mafiucivil/Tornamesa/cad/out/informe_paquete.md

# Informe del paquete de planos TT300-C · Rev. B

Generado el 06-11-2026 desde `TT300-C_design.json` (fuente única) en 106 s.
Interfaz dibujada: **Acero-acero con grasa grafitada (sin interfaz alternativa)**
Cubierta de madera: no. Collar del pivote: sí. Estado: EMITIDO PARA REVISIÓN.

**ESTOS PLANOS NO SON VÁLIDOS PARA FABRICACIÓN HASTA SU REVISIÓN Y APROBACIÓN POR UN INGENIERO CALCULISTA HABILITADO.**

## Láminas (21)

| N° | Plano | Título | Escala |
|---|---|---|---|
| 1 | TT300C-GEN-001-B | NOTAS GENERALES, NORMAS Y ÍNDICE DE LÁMINAS | S/E |
| 2 | TT300C-GEN-002-B | CONJUNTO GENERAL: PLANTA, CORTES Y VISTAS | 1:10 / 1:5 |
| 3 | TT300C-GEN-003-B | ISOMÉTRICA EXPLOSIONADA CON GLOBOS | 1:20 |
| 4 | TT300C-GEN-004-B | SECUENCIA DE ENSAMBLAJE | S/E |
| 5 | TT300C-GEN-005-B | DESPIECE (LISTA DE MATERIALES), MASA Y CENTRO DE GRAVEDAD | S/E |
| 6 | TT300C-GEN-006-B | LISTA DE CORTE | S/E |
| 7 | TT300C-GEN-007-B | PROGRAMA DE SOLDADURAS (ISO 2553 / ISO 5817 / AWS D1.1) | S/E |
| 8 | TT300C-GEN-008-B | TOLERANCIAS, AJUSTES, MATERIALES E INSPECCIÓN | S/E |
| 9 | TT300C-GEN-009-B | SUPUESTOS DEL DIBUJANTE Y BRECHAS CON EL CÁLCULO | S/E |
| 10 | TT300C-BAS-001-B | BASE SOLDADA: PLANCHA, COLLAR, MARCO, MÉNSULAS Y BANCADAS | 1:10 / 1:5 / 1:2 |
| 11 | TT300C-BAS-005-B | MÉNSULA DE CILINDRO (CONJUNTO SOLDADO) | 1:1,25 |
| 12 | TT300C-IZA-001-B | OREJA DE IZAJE (4 UNIDADES) | 1:1 / 1:10 |
| 13 | TT300C-ACC-001-B | BANCADA DE GUÍA CON RANURA T | 1:5 / 1:1 |
| 14 | TT300C-ACC-002-B | PATÍN GUIADO CON LENGÜETA T Y MARCO DE BOCA | 1:4 / 1:2,5 |
| 15 | TT300C-ACC-003-B | UÑA DE EMPUJE (CARA PLANA TEMPLADA, CHAFLÁN DE RETORNO) | 1:2,5 |
| 16 | TT300C-ACC-004-B | PASADORES DE ARTICULACIÓN, CILINDRO HIDRÁULICO Y ESPECIFICACIÓN | 1:2 / 1:5 |
| 17 | TT300C-MES-001-B | MESA GIRATORIA: CONJUNTO SOLDADO (PLANTA Y CORTE RADIAL) | 1:10 / 1:4 / 1:2 |
| 18 | TT300C-MES-002-B | PLANCHAS Y ANILLOS DE LA MESA (SUPERIOR E INFERIOR) | 1:10 / 1:2 |
| 19 | TT300C-MES-003-B | CUBO, ALMAS ANULARES Y NERVIOS RADIALES | 1:2 / 1:5 |
| 20 | TT300C-MES-004-B | PASADOR DE EMPUJE Y PERNO DE RETENCIÓN | 1:1 |
| 21 | TT300C-PIV-001-B | PIVOTE, BUJE, TAPA RETENEDORA Y TAPA DE INSPECCIÓN | 1:1,4 |

## Ítems (31)

| Pos | Código | Ítem | Cant | Masa unit. kg | Masa total kg | En núcleo |
|---|---|---|---|---|---|---|
| 1 | TT300C-BAS-001-B | Plancha base | 1 | 924.43 | 924.4 | sí |
| 2 | TT300C-BAS-002-B | Collar de asiento del pivote | 1 | 17.79 | 17.8 | sí |
| 3 | TT300C-BAS-003-B | Marco perimetral largo | 2 | 9.04 | 18.1 | sí |
| 4 | TT300C-BAS-004-B | Marco perimetral corto | 2 | 8.97 | 17.9 | sí |
| 5 | TT300C-BAS-005-B | Mejilla de ménsula | 8 | 10.01 | 80.1 | sí |
| 6 | TT300C-BAS-006-B | Oreja superior de ménsula | 4 | 4.40 | 17.6 | sí |
| 7 | TT300C-BAS-007-B | Oreja inferior (bloque) de ménsula | 4 | 13.72 | 54.9 | sí |
| 8 | TT300C-IZA-001-B | Oreja de izaje | 4 | 3.99 | 16.0 | sí |
| 9 | TT300C-ACC-001-B | Bancada de guía con ranura T | 2 | 40.48 | 81.0 | sí |
| 10 | TT300C-MES-001-B | Plancha superior de la mesa | 1 | 358.99 | 359.0 | sí |
| 11 | TT300C-MES-002-B | Anillo superior de pasadores | 1 | 139.71 | 139.7 | sí |
| 12 | TT300C-MES-003-B | Plancha inferior de la mesa | 1 | 285.37 | 285.4 | sí |
| 13 | TT300C-MES-004-B | Anillo inferior de pasadores | 1 | 139.71 | 139.7 | sí |
| 14 | TT300C-MES-005-B | Alma anular R300 | 1 | 15.45 | 15.4 | sí |
| 15 | TT300C-MES-006-B | Alma anular R590 | 1 | 30.38 | 30.4 | sí |
| 16 | TT300C-MES-007-B | Alma anular R840 | 1 | 43.25 | 43.3 | sí |
| 17 | TT300C-MES-008-B | Nervio radial, tramo 1 | 14 | 1.16 | 16.3 | sí |
| 18 | TT300C-MES-009-B | Nervio radial, tramo 2 | 14 | 2.33 | 32.6 | sí |
| 19 | TT300C-MES-010-B | Nervio radial, tramo 3 | 14 | 2.00 | 28.0 | sí |
| 20 | TT300C-MES-011-B | Cubo de la mesa | 1 | 66.75 | 66.8 | sí |
| 21 | TT300C-MES-012-B | Pasador de empuje | 28 | 9.35 | 261.9 | sí |
| 22 | TT300C-MES-013-B | Perno ISO 4762 M20×45 con arandela | 28 | 0.93 | 25.9 | no |
| 23 | TT300C-PIV-001-B | Pivote | 1 | 18.73 | 18.7 | sí |
| 24 | TT300C-PIV-002-B | Buje autolubricado | 1 | 3.87 | 3.9 | no |
| 25 | TT300C-PIV-003-B | Tapa retenedora | 1 | 1.60 | 1.6 | no |
| 26 | TT300C-PIV-004-B | Tapa de inspección | 1 | 2.79 | 2.8 | no |
| 27 | TT300C-ACC-002-B | Cilindro hidráulico doble efecto | 2 | 55.00 | 110.0 | sí |
| 28 | TT300C-ACC-003-B | Patín guiado | 2 | 126.85 | 253.7 | sí |
| 29 | TT300C-ACC-004-B | Uña de empuje | 2 | 13.61 | 27.2 | sí |
| 30 | TT300C-ACC-005-B | Pasador del vástago (patín) | 2 | 4.11 | 8.2 | no |
| 31 | TT300C-ACC-006-B | Pasador del ojal trasero (ménsula) | 2 | 5.20 | 10.4 | no |

## Masas: modelo 3D frente al núcleo

| Grupo | 3D kg | Núcleo kg | Δ kg | Δ % |
|---|---|---|---|---|
| Plancha base + collar + orejas de izaje | 958.2 | 958.2 | +0.0 | +0.00 |
| Marco perimetral | 36.0 | 36.0 | +0.0 | +0.00 |
| Ménsulas de cilindro | 152.6 | 152.6 | +0.0 | +0.00 |
| Bancadas de guía | 81.0 | 81.0 | +0.0 | +0.00 |
| Mesa (planchas, almas, nervios, cubo, pasadores) | 1418.4 | 1419.6 | -1.2 | -0.09 |
| Pivote | 18.7 | 18.7 | +0.0 | +0.00 |
| Cilindros (masa de catálogo) | 110.0 | 110.0 | +0.0 | +0.00 |
| Patines | 253.7 | 254.5 | -0.8 | -0.31 |
| Uñas | 27.2 | 27.2 | +0.0 | +0.00 |

**Total comparable:** 3D 3055.8 kg frente a 3057.8 kg del núcleo: Δ -2.0 kg (-0.07 %), tolerancia ±0.5 % → DENTRO.
Piezas no incluidas en el núcleo (pernos, buje, tapas, tornillos, graseras, anillo de la madera, pasadores de articulación; las barras de los topes SÍ están en m.total/m.stopBars): 52.8 kg. **Masa total del ensamble: 3108.6 kg.**
**Centro de gravedad (x, y, z):** (0.0; -0.0; 86.5) mm (origen en el eje de la mesa y la cara inferior de la base).

## Interferencias

0 pares con volumen común > 1 mm³ de 319 pares evaluados con cajas envolventes solapadas (total de pares 465).

## Chequeo automático de cotas (dibujo frente a modelo 3D)

104 cotas registradas; 104 verificadas (extremos sobre la superficie del sólido o ejes de superficies cilíndricas reales, tolerancia 0,05 mm); **0 fallas**. Detalle en `chequeo_cotas.csv`.

## Control de marco

Todas las láminas dentro del formato A1.

## Supuestos del dibujante (PROVISORIO) y decisiones adoptadas por el mandante (ADOPTADO)

| Id | Tema | Valor | Motivo |
|---|---|---|---|
| S13 | Izaje de la mesa | No se dibujan puntos de izaje de la mesa (A DEFINIR) | El cálculo solo define las 4 orejas de la base (P.t_ear…); la mesa debe izarse con medios definidos por el montajista. |
| S14 | Retención axial del pivote | Ajuste H7/p6 sin soldadura ni tope inferior (A DEFINIR) | El cálculo verifica asiento y flexión pero no la extracción axial del pivote. |

## Brechas con el cálculo y decisiones requeridas

| Id | Tema | Descripción | Decisión requerida |
|---|---|---|---|
| B-01 | Izaje de la mesa | El cálculo solo define las 4 orejas de la base; no hay puntos de izaje de la mesa (los cáncamos M30 de la Rev. B anterior sobre plancha de 20 mm no engranan la profundidad exigible). | A DEFINIR: orejas o cáncamos verificados para la mesa. |
| B-02 | Retención axial del pivote | El núcleo verifica asiento y flexión, no la extracción axial del pivote (ajuste p6/H7 sin soldadura, 42CrMo4 no soldable). | A DEFINIR: tope inferior, anillo o interferencia verificada. |
| B-03 | Torque de pernos y tornillos | El núcleo no entrega torques (pernos M20×45 de pasadores, M10 de tapas, tornillos de posición). | A DEFINIR: torques de apriete (ISO 898-1 / VDI 2230). |
| B-04 | Tamaño de soldaduras sin parámetro | Marco, esquinas y orejas de ménsula no tienen tamaño en P; se adopta el mínimo AWS D1.1 T5.8 por la parte más gruesa. Sí son parámetro (y el núcleo verifica mínimo y máximo): w_collar, w_ear, w_tope, w_br, w_web, w_bed_f. | A DEFINIR: confirmar o parametrizar tamaños y END de las soldaduras sin parámetro. |
| B-05 | Verificación del núcleo del filete de las mejillas | La fila «Filete mínimo mejillas–base» acota con mín(w_br, t_base, t_ch) = 18: no detecta que w_br = 20 supera t_base = 18 (el máximo AISC J2.2b sobre el borde de la mejilla de 25 sería 23). | Revisar el criterio de la fila (mínimo y máximo por separado). |
| B-06 | Diferencias de fórmula del patín | La masa del patín del núcleo difiere del modelo (alojamiento abierto por la cara superior y cuello de la lengüeta): −0,3 % en la pieza. | Informativo (dentro de tolerancia). |
| B-07 | Cilindro comercial | Largo ojal–ojal L0 = 520 mm y masa 55 kg son supuestos del núcleo; el modelo 3D usa la geometría de extremos del núcleo. | Confirmar con el proveedor del cilindro. |

## Reproducción

```
python3 cad/generar_paquete.py [design.json] [--out DIR] [--entrega DIR]
```
Dependencias: cadquery, ezdxf, pymupdf, shapely, openpyxl (opcional; sin él se escribe un .xlsx mínimo), Node.js para `tools/export_design.js`.
