mafiucivil/Tornamesa/entregables/RevC/variantes/C2/informe_paquete.md

# Informe del paquete de planos TT300-C · Rev. C

Generado el 07-11-2026 desde `TT300-C_design.json` (fuente única) en 841 s.
Interfaz dibujada: **Opción C-2: dos placas de bronce de aleaciones distintas**
Cubierta de madera: no. Collar del pivote: sí. Estado: EMITIDO PARA REVISIÓN.

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

## Láminas (53)

| N° | Plano | Título | Escala |
|---|---|---|---|
| 1 | TT300C-GEN-001-C | NOTAS GENERALES, NORMAS APLICABLES E ÍNDICE DE PLANOS | S/E |
| 2 | TT300C-CON-001-C | CONJUNTO GENERAL DEL EQUIPO: PLANTA, ELEVACIÓN Y CORTES A-A Y B-B | 1:5 / 1:10 / 1:20 |
| 3 | TT300C-CON-002-C | DESPIECE COMPLETO DEL EQUIPO (HOJA 1) | S/E |
| 4 | TT300C-CON-003-C | CONJUNTO GENERAL: ELEVACIONES LATERAL Y POSTERIOR, VISTA INFERIOR Y DIMENSIONES GENERALES | 1:1 / 1:5 / 1:20 |
| 5 | TT300C-CON-004-C | ISOMÉTRICA EXPLOSIONADA DEL EQUIPO CON GLOBOS DE POSICIÓN | S/E |
| 6 | TT300C-CON-005-C | SECUENCIA DE MONTAJE Y FABRICACIÓN | S/E |
| 7 | TT300C-CON-006-C | BASE SOLDADA: CONJUNTO (PLANTA, ELEVACIONES, CORTES Y DETALLES DE JUNTA) | 1:2 / 1:2,5 / 1:10 / 1:20 |
| 8 | TT300C-CON-007-C | MÉNSULA DE CILINDRO: SUBCONJUNTO SOLDADO (PLANTA, ELEVACIÓN Y CORTES) | 2:1 / 1:5 / 1:10 |
| 9 | TT300C-CON-008-C | MESA SOLDADA: PLANTA A MEDIA ALTURA, PLANTA INFERIOR, ELEVACIÓN Y CORTE POR UN PASADOR | 1:10 |
| 10 | TT300C-CON-009-C | MESA SOLDADA: CORTE POR ALMAS, DETALLES DE JUNTA, REBAJE DEL COLLAR Y TABLA DE PASADORES | 2:1 / 1:1 / 1:10 |
| 11 | TT300C-CON-010-C | ACCIONAMIENTO: CILINDRO, MÉNSULA, PATÍN, BANCADA, UÑA Y PASADORES (VISTA Y CORTES) | 1:2 / 1:5 |
| 12 | TT300C-CON-011-C | PIVOTE: CUBO, COLLAR, BUJE Y TAPAS — HOLGURAS Y AJUSTES (ISO 286) | 1:1 / 1:2 |
| 13 | TT300C-CON-012-C | CONJUNTO DE LA INTERFAZ: OPCIÓN C-2: DOS PLACAS DE BRONCE DE ALEACIONES DISTINTAS | 1:2 / 1:10 |
| 14 | TT300C-CON-013-C | DESPIECE COMPLETO DEL EQUIPO (HOJA 2) | S/E |
| 15 | TT300C-BAS-001-C | PLANCHA BASE: CONTORNO, AGUJERO CENTRAL Y POSICIONES | 2:1 / 1:2 / 1:20 |
| 16 | TT300C-BAS-002-C | COLLAR DE ASIENTO DEL PIVOTE | 2:1 / 1:1 / 1:2,5 |
| 17 | TT300C-BAS-003-C | MARCO PERIMETRAL: PLETINAS LARGA Y CORTA | 2:1 / 1:2,5 / 1:5 |
| 18 | TT300C-BAS-005-C | MÉNSULA DE CILINDRO: MEJILLA Y OREJAS (PIEZAS) | 1:2 / 1:2,5 / 1:5 |
| 19 | TT300C-IZA-001-C | OREJA DE IZAJE (4 UNIDADES) | 2:1 / 1:1 |
| 20 | TT300C-ACC-001-C | BANCADA DE GUÍA CON RANURA T (2 UNIDADES) | 2:1 / 1:2 / 1:10 |
| 21 | TT300C-MES-001-C | MESA: PLANCHA SUPERIOR | 2:1 / 1:1 / 1:5 / 1:10 |
| 22 | TT300C-MES-002-C | MESA: ANILLOS SUPERIOR E INFERIOR DE PASADORES (28 AGUJEROS) | 1:1 / 1:2 / 1:10 |
| 23 | TT300C-MES-003-C | MESA: PLANCHA INFERIOR (CARA DE APOYO DE LA INTERFAZ) | 2:1 / 1:2 / 1:10 |
| 24 | TT300C-MES-005-C | MESA: ALMAS ANULARES (3 ANILLOS) | 2:1 / 1:2 / 1:10 |
| 25 | TT300C-MES-008-C | MESA: NERVIOS RADIALES (TRAMOS ENTRE ALMAS) | 2:1 / 1:1 / 1:2 |
| 26 | TT300C-MES-011-C | MESA: CUBO | 2:1 / 1:2 |
| 27 | TT300C-MES-012-C | MESA: PASADOR DE EMPUJE Ø85 (28 UNIDADES) | 5:1 / 2:1 / 1:1 |
| 28 | TT300C-MES-013-C | MESA: PERNO ISO 4762 M20×45 CON ARANDELA (28 UNIDADES) | 2:1 |
| 29 | TT300C-PIV-001-C | PIVOTE Ø120 p6 | 5:1 / 2:1 / 1:1 |
| 30 | TT300C-PIV-002-C | PIVOTE: BUJE AUTOLUBRICADO | 5:1 / 2:1 / 1:1 |
| 31 | TT300C-PIV-003-C | PIVOTE: TAPAS RETENEDORA (PIV-003) E INSPECCIÓN (PIV-004) | 2:1 / 1:1 / 1:2 |
| 32 | TT300C-ACC-002-C | CILINDRO HIDRÁULICO DE DOBLE EFECTO (ELEMENTO COMERCIAL — DIMENSIONES DE INTERFAZ) | 1:1 / 1:2 / 1:2,5 |
| 33 | TT300C-ACC-003-C | PATÍN GUIADO CON LENGÜETA T Y MARCO DE BOCA (2 UNIDADES) | 1:1 / 1:2 / 1:2,5 |
| 34 | TT300C-ACC-004-C | UÑA DE EMPUJE (CARA PLANA TEMPLADA, CHAFLÁN DE RETORNO) (2 UNIDADES) | 2:1 / 1:1 / 1:2 |
| 35 | TT300C-ACC-005-C | PASADORES DE ARTICULACIÓN Ø70 f8 (VÁSTAGO Y OJAL TRASERO) | 5:1 / 2:1 / 1:1 |
| 36 | TT300C-INT-003-C | INTERFAZ: DISCO DURO / 2.ª PLACA (SECTOR) | 5:1 / 1:1 / 1:2 / 1:5 |
| 37 | TT300C-INT-001-C | INTERFAZ: PLACA DE BRONCE CON TAPONES DE GRAFITO (SECTOR / PASTILLA) | 2:1 / 1:1 / 1:5 |
| 38 | TT300C-INT-004-C | INTERFAZ: BARRA DE TOPE DE LA BASE Y DETALLE DE JUNTA | 2:1 / 1:1 |
| 39 | TT300C-INT-005-C | INTERFAZ: BARRA DE TOPE DE LA MESA Y DETALLE DE JUNTA | 2:1 / 1:1 / 1:2 |
| 40 | TT300C-INT-006-C | INTERFAZ: TORNILLOS DE POSICIÓN ISO 10642 M6 (ROSCA ISO 262, PAR PROPUESTO) | 5:1 |
| 41 | TT300C-INT-008-C | INTERFAZ: GRASERAS DIN 71412 M10×1, TALADRO Ø6 Y TRAZADO DE ENGRASE | 5:1 / 2:1 / 1:10 |
| 42 | TT300C-INT-101-C | INTERFAZ: RANURAS DE ENGRASE EN LA CARA DESLIZANTE (TRAZADO: 12 RADIALES Y CIRCUNFERENCIALES, GRASERAS) | 1:1 / 1:2 / 1:10 |
| 43 | TT300C-INT-102-C | INTERFAZ: PATRÓN DE TAPONES DE GRAFITO (PLANTA DEL BRONCE, TABLA DE COORDENADAS Y ALOJAMIENTO) | 5:1 / 1:5 / 1:50 |
| 44 | TT300C-GEN-003-C | PLAN DE INSPECCIÓN Y ENSAYOS | S/E |
| 45 | TT300C-GEN-004-C | TOLERANCIAS Y AJUSTES (ISO 286) Y TOLERANCIAS GEOMÉTRICAS | S/E |
| 46 | TT300C-GEN-005-C | MATERIALES Y CERTIFICADOS | S/E |
| 47 | TT300C-GEN-006-C | TRATAMIENTOS TÉRMICOS Y SUPERFICIALES, PINTURA | S/E |
| 48 | TT300C-GEN-007-C | PROGRAMA DE SOLDADURAS: TABLA GLOBAL DE JUNTAS | S/E |
| 49 | TT300C-GEN-008-C | TORQUES DE APRIETE (PROPUESTA) Y LISTA DE COMPRAS DE ELEMENTOS COMERCIALES | S/E |
| 50 | TT300C-GEN-009-C | SUPUESTOS DEL DIBUJANTE Y BRECHAS CON EL CÁLCULO (GEN-009) | S/E |
| 51 | TT300C-GEN-010-C | LISTA DE CORTES DE PLANCHA (NESTING SIMPLE) Y APROVECHAMIENTO | S/E |
| 52 | TT300C-GEN-011-C | LISTA DE VERIFICACIÓN DEL REVISOR | S/E |
| 53 | TT300C-GEN-012-C | WPS PRE-CALIFICADOS PROPUESTOS POR TIPO DE JUNTA (AWS D1.1 CL. 3) Y PRECALENTAMIENTO | S/E |

## Ítems (39)

| Pos | Código | Ítem | Cant | Masa unit. kg | Masa total kg | En núcleo |
|---|---|---|---|---|---|---|
| 1 | TT300C-BAS-001-C | Plancha base | 1 | 924.29 | 924.3 | sí |
| 2 | TT300C-BAS-002-C | Collar de asiento del pivote | 1 | 17.79 | 17.8 | sí |
| 3 | TT300C-BAS-003-C | Marco perimetral largo | 2 | 9.04 | 18.1 | sí |
| 4 | TT300C-BAS-004-C | Marco perimetral corto | 2 | 8.97 | 17.9 | sí |
| 5 | TT300C-BAS-005-C | Mejilla de ménsula | 8 | 11.93 | 95.4 | sí |
| 6 | TT300C-BAS-006-C | Oreja superior de ménsula | 4 | 4.40 | 17.6 | sí |
| 7 | TT300C-BAS-007-C | Oreja inferior (bloque) de ménsula | 4 | 18.99 | 76.0 | sí |
| 8 | TT300C-IZA-001-C | Oreja de izaje | 4 | 3.99 | 16.0 | sí |
| 9 | TT300C-ACC-001-C | Bancada de guía con ranura T | 2 | 40.48 | 81.0 | sí |
| 10 | TT300C-MES-001-C | Plancha superior de la mesa | 1 | 358.97 | 359.0 | sí |
| 11 | TT300C-MES-002-C | Anillo superior de pasadores | 1 | 139.71 | 139.7 | sí |
| 12 | TT300C-MES-003-C | Plancha inferior de la mesa | 1 | 285.30 | 285.3 | sí |
| 13 | TT300C-MES-004-C | Anillo inferior de pasadores | 1 | 139.60 | 139.6 | sí |
| 14 | TT300C-MES-005-C | Alma anular R300 | 1 | 15.45 | 15.4 | sí |
| 15 | TT300C-MES-006-C | Alma anular R590 | 1 | 30.38 | 30.4 | sí |
| 16 | TT300C-MES-007-C | Alma anular R840 | 1 | 43.25 | 43.3 | sí |
| 17 | TT300C-MES-008-C | Nervio radial, tramo 1 | 14 | 1.16 | 16.3 | sí |
| 18 | TT300C-MES-009-C | Nervio radial, tramo 2 | 14 | 2.33 | 32.6 | sí |
| 19 | TT300C-MES-010-C | Nervio radial, tramo 3 | 14 | 2.00 | 28.0 | sí |
| 20 | TT300C-MES-011-C | Cubo de la mesa | 1 | 74.71 | 74.7 | sí |
| 21 | TT300C-MES-012-C | Pasador de empuje | 28 | 9.35 | 261.7 | sí |
| 22 | TT300C-MES-013-C | Perno ISO 4762 M20×45 con arandela | 28 | 0.93 | 25.9 | no |
| 23 | TT300C-PIV-001-C | Pivote | 1 | 21.33 | 21.3 | sí |
| 24 | TT300C-PIV-002-C | Buje autolubricado | 1 | 3.87 | 3.9 | no |
| 25 | TT300C-PIV-003-C | Tapa retenedora | 1 | 1.57 | 1.6 | no |
| 26 | TT300C-PIV-004-C | Tapa de inspección | 1 | 2.76 | 2.8 | no |
| 27 | TT300C-ACC-002-C | Cilindro hidráulico doble efecto | 2 | 55.00 | 110.0 | sí |
| 28 | TT300C-ACC-003-C | Patín guiado | 2 | 159.88 | 319.8 | sí |
| 29 | TT300C-ACC-004-C | Uña de empuje | 2 | 13.61 | 27.2 | sí |
| 30 | TT300C-ACC-005-C | Pasador del vástago (patín) | 2 | 4.10 | 8.2 | no |
| 31 | TT300C-ACC-006-C | Pasador del ojal trasero (ménsula) | 2 | 6.10 | 12.2 | no |
| 32 | TT300C-INT-001-C | Sector de placa de bronce con tapones de grafito | 24 | 12.67 | 304.1 | sí |
| 33 | TT300C-INT-002-C | Tapón de grafito | 2640 | 0.00 | 5.6 | sí |
| 34 | TT300C-INT-003-C | 2.ª placa de bronce (sector) | 24 | 13.27 | 318.4 | sí |
| 35 | TT300C-INT-004-C | Barra de tope (placa de bronce) | 24 | 0.42 | 10.0 | sí |
| 36 | TT300C-INT-005-C | Barra de tope (disco duro / 2.ª placa) | 24 | 0.72 | 17.4 | sí |
| 37 | TT300C-INT-006-C | Tornillo avellanado de posición M6×25 | 48 | 0.01 | 0.3 | no |
| 38 | TT300C-INT-007-C | Tornillo avellanado de posición M6×25 | 48 | 0.01 | 0.3 | no |
| 39 | TT300C-INT-008-C | Grasera recta M10×1 | 4 | 0.01 | 0.0 | no |

## Masas: modelo 3D frente al núcleo

| Grupo | 3D kg | Núcleo kg | Δ kg | Δ % |
|---|---|---|---|---|
| Plancha base + collar + orejas de izaje | 958.1 | 958.2 | -0.1 | -0.01 |
| Marco perimetral | 36.0 | 36.0 | +0.0 | +0.00 |
| Ménsulas de cilindro | 189.0 | 189.0 | -0.0 | -0.00 |
| Bancadas de guía | 81.0 | 81.0 | +0.0 | +0.00 |
| Mesa (planchas, almas, nervios, cubo, pasadores) | 1425.9 | 1427.6 | -1.7 | -0.12 |
| Pivote | 21.3 | 21.4 | -0.1 | -0.29 |
| Cilindros (masa de catálogo) | 110.0 | 110.0 | +0.0 | +0.00 |
| Patines | 319.8 | 320.5 | -0.8 | -0.25 |
| Uñas | 27.2 | 27.2 | +0.0 | +0.00 |
| Bronce con grafito (o 2.ª placa) | 628.1 | 630.6 | -2.5 | -0.40 |
| Barras de los topes (m.stopBars) | 27.4 | 27.4 | -0.0 | -0.00 |

**Total comparable:** 3D 3823.8 kg frente a 3828.9 kg del núcleo: Δ -5.2 kg (-0.13 %), tolerancia ±0.5 % → DENTRO.
Piezas no incluidas en el núcleo (pernos, buje, tapas, tornillos, graseras, pasadores de articulación; las barras de los topes SÍ están en m.total/m.stopBars): 55.2 kg. **Masa total del ensamble: 3879.0 kg.**
**Centro de gravedad (x, y, z):** (0.0; -0.0; 92.3) mm (origen en el eje de la mesa y la cara inferior de la base).

### Control de masa de la interfaz por pieza (cortes del núcleo, `interfazGeom.cortes`)

| Pieza | Piezas (n × capas) | t mm | Junta mm | Juntas kg | Muescas kg | Chaflanes kg | Bruta kg | Neta del núcleo kg | 3D kg | Residual kg | Residual % |
|---|---|---|---|---|---|---|---|---|---|---|---|
| Placa de bronce (24 sectores) | 24 | 15 | 1 | 2.2 | 11.5 | 1.7 | 327.3 | 311.9 | 309.7 | -2.25 | -0.72 |
| 2.ª placa de bronce (24 sectores) | 24 | 15 | 1 | 2.3 | 20.9 | 3.1 | 345.0 | 318.7 | 318.4 | -0.26 | -0.08 |

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

### Diferencias explicadas por pieza
- Mesa (planchas, almas, nervios, cubo, pasadores): 3D 1425,9 kg frente a 1427,6 kg del núcleo (-0,12 %; residual -1,66 kg). Residual no descontado en el núcleo: rebaje del cubo, agujeros de pasadores y empalmes (fórmula del núcleo).
- Pivote: 3D 21,3 kg frente a 21,4 kg del núcleo (-0,29 %; residual -0,06 kg). Residual no descontado en el núcleo: fórmula del núcleo frente a geometría.
- Patines: 3D 319,8 kg frente a 320,5 kg del núcleo (-0,25 %; residual -0,79 kg). Residual no descontado en el núcleo: alojamiento abierto por la cara superior y cuello de la lengüeta del patín (fórmula del núcleo frente a la geometría).
- Bronce con grafito (o 2.ª placa): 3D 628,1 kg frente a 630,6 kg del núcleo (-0,4 %; residual -2,51 kg). Residual no descontado en el núcleo: tapones de grafito, ranuras de engrase, tornillos de posición y taladros de las graseras. Núcleo v1.2 (interfazGeom.tapones): N_real = 2.640 tapones (malla 3.864, N_ideal 3.961), f_g real = 0,097 (ideal 0,145, usado 0,097); el 3D coloca 2.640 (+0 respecto del núcleo). Cumple lubricación (f_g ≥ 0,2): NO (decisión del calculista)..

## Interferencias

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

## Chequeo automático de cotas (dibujo frente a modelo 3D)

595 cotas registradas; 595 verificadas (extremos sobre la superficie del sólido o ejes de superficies cilíndricas reales, tolerancia 0,05 mm); **0 fallas**. Detalle en `chequeo_cotas.csv`.

## Control de marco

Todas las láminas dentro del formato A1.

## Supuestos del dibujante (PROVISORIO) y decisiones adoptadas por el mandante (ADOPTADO)

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

## Brechas con el cálculo y decisiones requeridas

| Id | Tema | Descripción | Decisión requerida |
|---|---|---|---|
| B-01 | Posición, torque y largo de tornillos de posición | Adoptado por el mandante: 2 por sector. El núcleo fija solo d_tor = M6 y verifica la cabeza; la posición radial (S01), el largo (S11) y el torque no están definidos. | Confirmar posición y largo; definir torque (ISO 898-1 / VDI 2230). |
| B-02 | Izaje de la mesa | El cálculo solo define las 4 orejas de la base; no hay puntos de izaje de la mesa (los cáncamos M30 de la Rev. B anterior sobre plancha de 20 mm no engranan la profundidad exigible). | A DEFINIR: orejas o cáncamos verificados para la mesa. |
| B-03 | Retención axial del pivote | El núcleo verifica asiento y flexión, no la extracción axial del pivote (ajuste p6/H7 sin soldadura). | A DEFINIR: tope inferior, anillo o interferencia verificada. |
| B-04 | Torque de pernos y tornillos | El núcleo no entrega torques (pernos M20×45 de pasadores, M10 de tapas, tornillos de posición). | Torques PROPUESTOS en GEN-008 (ISO 898-1, VDI 2230 simplificado): A CONFIRMAR POR EL CALCULISTA. |
| B-05 | Tamaño de soldaduras sin parámetro | Marco, esquinas y orejas de ménsula no tienen tamaño en P; se adopta el mínimo AWS D1.1 T5.8 por la parte más gruesa. Sí son parámetro (y el núcleo verifica mínimo y máximo): w_collar, w_ear, w_tope, w_br, w_web, w_bed_f. | CONFIRMAR o parametrizar tamaños y END de las soldaduras sin parámetro. |
| B-06 | Filetes máximos AISC J2.2b de almas y nervios | Almas y nervios de la mesa: w_web = 6 sobre t = 6 superan el máximo de borde t − 2 = 4 mm que aplica el núcleo (AISC J2.2b) salvo que el cateto se justifique como built-up (el cordón no queda en el borde del alma). Nota para el calculista: la cláusula J2.2b literal permite w = t para bordes de t < 6,35 mm (aquí 6 mm); el criterio t − 2 es el conservador del núcleo. El núcleo exige el mínimo (fila «Filete mínimo almas/nervios–planchas», 6 mm) pero no tiene fila de máximo para esta unión. | PENDIENTE DEL CALCULISTA: concluir si el cateto z6 se acepta como built-up o se reduce a z4 (con verificación de la soldadura alma/nervio–plancha del núcleo) / se espesa el alma. |
| B-07 | Advertencia del núcleo (banda «warn») | «Bronce con grafito: cobertura mínima de lubricante sólido (f_g del grafito sobre el área de contacto)»: FU 2,068 (demanda 0,2 / capacidad 0,1 –). | A DECIDIR POR EL MANDANTE: aceptar la advertencia o reforzar la pieza. |
| B-08 | Advertencia del núcleo aceptada: flexión de la uña en la boca del patín | «Flexión en la boca del patín (voladizo) con fricción radial»: FU 0,907 (demanda 242 / capacidad 266,7 MPa) con Fy_dog = 800 MPa (34CrNiMo6+QT, EN 10083-3, 40 < t ≤ 100 mm) y Nd = 3,0 (ASME BTH-1 §3-2.3). | ACEPTADA POR EL MANDANTE el 07-11-2026 como advertencia (FU ≤ 1,0; se relaja solo para esta fila el criterio interno FU ≤ 0,90). Dejar registro en la aprobación. |
| B-09 | Pendiente declarado por el núcleo | Soldar los topes antes del alivio de tensiones y del rectificado; sectores atornillados con tornillos de posición, sacables con la mesa izada | Atender en fabricación/aprobación según el texto del núcleo. |
| B-10 | Pendiente declarado por el núcleo | Arranque con adherencia–deslizamiento (stick-slip) a 2,5 mm/s: diferencia entre μ estático y cinético | Atender en fabricación/aprobación según el texto del núcleo. |
| B-11 | Pendiente declarado por el núcleo | Par galvánico bronce–acero en contacto con grasa: sellado perimetral y protección del respaldo | Atender en fabricación/aprobación según el texto del núcleo. |
| B-12 | Pendiente declarado por el núcleo | Bronce contra bronce (aleaciones distintas): riesgo de gripado; el grafito va solo en una placa | Atender en fabricación/aprobación según el texto del núcleo. |
| B-13 | Tapones de grafito: patrón realizable frente a f_g del núcleo | Núcleo v1.2 (interfazGeom.tapones): N_real = 2.640 tapones (malla 3.864, N_ideal 3.961), f_g real = 0,097 (ideal 0,145, usado 0,097); el 3D coloca 2.640 (+0 respecto del núcleo). Cumple lubricación (f_g ≥ 0,2): NO (decisión del calculista). | A DECIDIR POR EL MANDANTE: densificar el patrón (paso o zonas de exclusión) o que el núcleo use la cantidad real de tapones; el efecto sobre la presión del bronce es conservador, sobre la lubricación no. |
| B-14 | Diferencias de fórmula del patín | La masa del patín del núcleo difiere del modelo (alojamiento abierto por la cara superior y cuello de la lengüeta): −0,3 % en la pieza. | Informativo (dentro de tolerancia). |
| B-15 | Cilindro comercial | Largo ojal–ojal L0 = 520 mm y masa 55 kg son supuestos del núcleo; el modelo 3D usa la geometría de extremos del núcleo. | Confirmar con el proveedor del cilindro. |

## Reproducción

```
python3 cad/generar_paquete.py [design.json] [--out DIR] [--entrega DIR]
```
Dependencias: cadquery, ezdxf, pymupdf, shapely, openpyxl (opcional; sin él se escribe un .xlsx mínimo), Node.js para `tools/export_design.js`.

## Cobertura y métricas del juego de planos

- Láminas: 53; cotas verificadas: 595 (0 fallas).
- Ítems del despiece sin globo en un plano de conjunto/subconjunto: ninguno.
- Juntas sin símbolo ISO 2553 en un plano de pieza/subconjunto: ninguna. Piezas fabricables sin plano: ninguna.
- Errores de generación: ninguno.
- Ocupación de las 40 láminas con vistas: media 17.7 % del área útil del marco; 26.7 % de la zona de vistas (área de dibujo: marco menos cajetín, banda de notas y franja de tablas) contando solo las vistas; 53.2 % contando también cotas, títulos y símbolos (huella); 18.9 % de tinta (celdas de 8 mm con trazo).
- Cotas totales: 595 (0 fallas). A DEFINIR en el cuerpo de las láminas (sin contar las firmas del cajetín): 22.

## Checklist de fabricación por pieza (criterios verificados sobre cada lámina; «NO» = pendiente)

| Lámina | Piezas | Cotas | 1 Contorno | 2 Agujeros | 3 Chaflanes/radios | 4 Rugosidad | 5 GD&T | 6 Material/partida/masa | 7 Soldadura | 8 Notas | 9 Vistas |
|---|---|---|---|---|---|---|---|---|---|---|---|
| BAS-001-C | BAS-001 | 20 | sí | sí | sí (nota general + cotas) | sí | sí | sí | sí | sí | sí |
| BAS-002-C | BAS-002 | 7 | sí | sí | sí (nota general + cotas) | sí | sí | sí | sí | sí | sí |
| BAS-003-C | BAS-003, BAS-004 | 12 | sí | n.a. | sí (nota general + cotas) | sí | sí | sí | sí | sí | sí |
| BAS-005-C | BAS-005, BAS-006, BAS-007 | 32 | sí | sí | sí (nota general + cotas) | sí | sí | sí | sí | sí | sí |
| IZA-001-C | IZA-001 | 9 | sí | sí | sí (nota general + cotas) | sí | sí | sí | sí | sí | sí |
| ACC-001-C | ACC-001 | 23 | sí | n.a. | sí (nota general + cotas) | sí | sí | sí | sí | sí | sí |
| MES-001-C | MES-001 | 11 | sí | sí | sí (nota general + cotas) | sí | sí | sí | sí | sí | sí |
| MES-002-C | MES-002, MES-004 | 13 | sí | sí | sí (nota general + cotas) | sí | sí | sí | sí | sí | sí |
| MES-003-C | MES-003 | 20 | sí | sí | sí (nota general + cotas) | sí | sí | sí | sí | sí | sí |
| MES-005-C | MES-005, MES-006, MES-007 | 9 | sí | n.a. | sí (nota general + cotas) | sí | sí | sí | sí | sí | sí |
| MES-008-C | MES-008, MES-009, MES-010 | 8 | sí | n.a. | sí (nota general + cotas) | sí | sí | sí | sí | sí | sí |
| MES-011-C | MES-011 | 12 | sí | sí | sí (nota general + cotas) | sí | sí | sí | sí | sí | sí |
| MES-012-C | MES-012 | 12 | sí | sí | sí (nota general + cotas) | sí | sí | sí | n.a. | sí | sí |
| MES-013-C | MES-013 | 12 | sí | sí | sí (nota general + cotas) | sí | sí | sí | n.a. | sí | sí |
| PIV-001-C | PIV-001 | 22 | sí | sí | sí (nota general + cotas) | sí | sí | sí | n.a. | sí | sí |
| PIV-002-C | PIV-002 | 9 | sí | sí | sí (nota general + cotas) | sí | sí | sí | n.a. | sí | sí |
| PIV-003-C | PIV-003, PIV-004 | 24 | sí | sí | sí (nota general + cotas) | sí | sí | sí | n.a. | sí | sí |
| ACC-002-C | ACC-002 | 26 | sí | sí | sí (nota general + cotas) | sí | sí | sí | n.a. | sí | sí |
| ACC-003-C | ACC-003 | 38 | sí | sí | sí (nota general + cotas) | sí | sí | sí | n.a. | sí | sí |
| ACC-004-C | ACC-004 | 18 | sí | n.a. | sí (nota general + cotas) | sí | sí | sí | n.a. | sí | sí |
| ACC-005-C | ACC-005, ACC-006 | 13 | sí | sí | sí (nota general + cotas) | sí | sí | sí | n.a. | sí | sí |
| INT-003-C | INT-003 | 20 | sí | sí | sí (nota general + cotas) | sí | sí | sí | n.a. | sí | sí |
| INT-001-C | INT-001, INT-002 | 32 | sí | sí | sí (nota general + cotas) | sí | sí | sí | n.a. | sí | sí |
| INT-004-C | INT-004 | 14 | sí | n.a. | sí (nota general + cotas) | sí | sí | sí | n.a. | sí | sí |
| INT-005-C | INT-005 | 14 | sí | n.a. | sí (nota general + cotas) | sí | sí | sí | n.a. | sí | sí |
| INT-006-C | INT-006, INT-007 | 15 | sí | sí | sí (nota general + cotas) | sí | sí | sí | n.a. | sí | sí |
| INT-008-C | INT-008 | 10 | sí | sí | sí (nota general + cotas) | sí | sí | sí | n.a. | sí | sí |
| INT-101-C | INT-001 | 11 | sí | sí | sí (nota general + cotas) | sí | sí | sí | n.a. | sí | sí |
| INT-102-C | INT-001, INT-002 | 6 | sí | sí | sí (nota general + cotas) | sí | sí | sí | n.a. | sí | sí |

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

| N° | Lámina | Fmt | Escala | Cotas | % vistas/marco | % vistas/zona de vistas | % tinta/zona | % huella/zona | A DEFINIR | Choques | Fuera de marco | Invasiones |
|---|---|---|---|---|---|---|---|---|---|---|---|---|
| 1 | TT300C-GEN-001-C | A1 | S/E | 0 | 0.0 | 0.0 | 55.9 | 0.0 | 1 | 0 | 0 | 0 |
| 2 | TT300C-CON-001-C | A1 | 1:5 / 1:10 / 1:20 | 8 | 20.0 | 29.5 | 29.3 | 59.6 | 0 | 0 | 0 | 0 |
| 3 | TT300C-CON-002-C | A1 | S/E | 0 | 0.0 | 0.0 | 80.8 | 0.0 | 0 | 0 | 0 | 0 |
| 4 | TT300C-CON-003-C | A1 | 1:1 / 1:5 / 1:20 | 17 | 26.4 | 34.2 | 25.7 | 61.1 | 0 | 0 | 0 | 0 |
| 5 | TT300C-CON-004-C | A1 | S/E | 0 | 40.4 | 52.3 | 31.0 | 78.1 | 0 | 0 | 0 | 0 |
| 6 | TT300C-CON-005-C | A1 | S/E | 0 | 34.5 | 52.7 | 18.1 | 66.7 | 0 | 0 | 0 | 0 |
| 7 | TT300C-CON-006-C | A1 | 1:2 / 1:2,5 / 1:10 / 1:20 | 25 | 8.6 | 15.4 | 21.5 | 62.9 | 0 | 0 | 0 | 0 |
| 8 | TT300C-CON-007-C | A1 | 2:1 / 1:5 / 1:10 | 19 | 18.6 | 27.6 | 12.7 | 48.3 | 0 | 0 | 0 | 0 |
| 9 | TT300C-CON-008-C | A1 | 1:10 | 13 | 21.4 | 39.8 | 30.6 | 67.2 | 0 | 0 | 0 | 0 |
| 10 | TT300C-CON-009-C | A1 | 2:1 / 1:1 / 1:10 | 4 | 9.9 | 18.4 | 19.2 | 68.5 | 0 | 0 | 0 | 0 |
| 11 | TT300C-CON-010-C | A1 | 1:2 / 1:5 | 26 | 12.9 | 21.0 | 20.1 | 44.5 | 0 | 0 | 0 | 0 |
| 12 | TT300C-CON-011-C | A1 | 1:1 / 1:2 | 8 | 23.2 | 36.3 | 16.8 | 62.7 | 1 | 0 | 0 | 0 |
| 13 | TT300C-CON-012-C | A1 | 1:2 / 1:10 | 3 | 12.7 | 22.7 | 23.3 | 33.2 | 0 | 0 | 0 | 0 |
| 14 | TT300C-CON-013-C | A1 | S/E | 0 | 0.0 | 0.0 | 20.1 | 0.0 | 0 | 0 | 0 | 0 |
| 15 | TT300C-BAS-001-C | A1 | 2:1 / 1:2 / 1:20 | 20 | 14.7 | 24.4 | 17.1 | 50.6 | 0 | 0 | 0 | 0 |
| 16 | TT300C-BAS-002-C | A1 | 2:1 / 1:1 / 1:2,5 | 7 | 17.6 | 26.0 | 12.9 | 55.5 | 0 | 0 | 0 | 0 |
| 17 | TT300C-BAS-003-C | A1 | 2:1 / 1:2,5 / 1:5 | 12 | 14.9 | 23.2 | 17.9 | 59.6 | 0 | 0 | 0 | 0 |
| 18 | TT300C-BAS-005-C | A1 | 1:2 / 1:2,5 / 1:5 | 32 | 12.5 | 20.6 | 24.2 | 70.5 | 0 | 0 | 0 | 0 |
| 19 | TT300C-IZA-001-C | A1 | 2:1 / 1:1 | 9 | 16.6 | 24.3 | 13.1 | 45.5 | 0 | 0 | 0 | 0 |
| 20 | TT300C-ACC-001-C | A1 | 2:1 / 1:2 / 1:10 | 23 | 18.2 | 26.6 | 19.1 | 62.6 | 0 | 0 | 0 | 0 |
| 21 | TT300C-MES-001-C | A1 | 2:1 / 1:1 / 1:5 / 1:10 | 11 | 13.9 | 21.3 | 15.4 | 61.0 | 0 | 0 | 0 | 0 |
| 22 | TT300C-MES-002-C | A1 | 1:1 / 1:2 / 1:10 | 13 | 10.6 | 18.8 | 15.4 | 43.8 | 0 | 0 | 0 | 0 |
| 23 | TT300C-MES-003-C | A1 | 2:1 / 1:2 / 1:10 | 20 | 12.0 | 18.2 | 16.2 | 41.9 | 0 | 0 | 0 | 0 |
| 24 | TT300C-MES-005-C | A1 | 2:1 / 1:2 / 1:10 | 9 | 11.7 | 20.1 | 17.3 | 58.0 | 0 | 0 | 0 | 0 |
| 25 | TT300C-MES-008-C | A1 | 2:1 / 1:1 / 1:2 | 8 | 15.2 | 25.0 | 15.2 | 56.2 | 0 | 0 | 0 | 0 |
| 26 | TT300C-MES-011-C | A1 | 2:1 / 1:2 | 12 | 16.7 | 24.6 | 16.5 | 50.6 | 0 | 0 | 0 | 0 |
| 27 | TT300C-MES-012-C | A1 | 5:1 / 2:1 / 1:1 | 12 | 23.7 | 32.7 | 15.8 | 59.7 | 0 | 0 | 0 | 0 |
| 28 | TT300C-MES-013-C | A1 | 2:1 | 12 | 21.3 | 29.2 | 12.6 | 40.3 | 0 | 0 | 0 | 0 |
| 29 | TT300C-PIV-001-C | A1 | 5:1 / 2:1 / 1:1 | 22 | 20.0 | 27.6 | 17.2 | 46.6 | 1 | 0 | 0 | 0 |
| 30 | TT300C-PIV-002-C | A1 | 5:1 / 2:1 / 1:1 | 9 | 29.6 | 40.8 | 13.9 | 59.0 | 1 | 0 | 0 | 0 |
| 31 | TT300C-PIV-003-C | A1 | 2:1 / 1:1 / 1:2 | 24 | 14.9 | 22.2 | 17.6 | 45.4 | 0 | 0 | 0 | 0 |
| 32 | TT300C-ACC-002-C | A1 | 1:1 / 1:2 / 1:2,5 | 26 | 18.4 | 26.8 | 19.6 | 47.5 | 1 | 0 | 0 | 0 |
| 33 | TT300C-ACC-003-C | A1 | 1:1 / 1:2 / 1:2,5 | 38 | 24.6 | 33.9 | 23.2 | 55.4 | 0 | 0 | 0 | 0 |
| 34 | TT300C-ACC-004-C | A1 | 2:1 / 1:1 / 1:2 | 18 | 25.0 | 34.7 | 17.9 | 55.4 | 0 | 0 | 0 | 0 |
| 35 | TT300C-ACC-005-C | A1 | 5:1 / 2:1 / 1:1 | 13 | 30.8 | 44.3 | 18.7 | 71.6 | 0 | 0 | 0 | 0 |
| 36 | TT300C-INT-003-C | A1 | 5:1 / 1:1 / 1:2 / 1:5 | 20 | 8.2 | 15.1 | 22.6 | 46.6 | 0 | 0 | 0 | 0 |
| 37 | TT300C-INT-001-C | A1 | 2:1 / 1:1 / 1:5 | 32 | 10.3 | 21.0 | 31.2 | 57.2 | 0 | 0 | 0 | 0 |
| 38 | TT300C-INT-004-C | A1 | 2:1 / 1:1 | 14 | 11.1 | 17.8 | 14.6 | 43.5 | 0 | 0 | 0 | 0 |
| 39 | TT300C-INT-005-C | A1 | 2:1 / 1:1 / 1:2 | 14 | 11.3 | 18.0 | 15.5 | 38.1 | 0 | 0 | 0 | 0 |
| 40 | TT300C-INT-006-C | A1 | 5:1 | 15 | 5.4 | 8.0 | 8.9 | 17.6 | 0 | 0 | 0 | 0 |
| 41 | TT300C-INT-008-C | A1 | 5:1 / 2:1 / 1:10 | 10 | 18.2 | 25.1 | 10.6 | 29.9 | 0 | 0 | 0 | 0 |
| 42 | TT300C-INT-101-C | A1 | 1:1 / 1:2 / 1:10 | 11 | 25.4 | 35.0 | 30.1 | 59.2 | 0 | 0 | 0 | 0 |
| 43 | TT300C-INT-102-C | A1 | 5:1 / 1:5 / 1:50 | 6 | 4.9 | 14.1 | 17.3 | 46.5 | 0 | 0 | 0 | 0 |
| 44 | TT300C-GEN-003-C | A1 | S/E | 0 | 0.0 | 0.0 | 26.6 | 0.0 | 0 | 0 | 0 | 0 |
| 45 | TT300C-GEN-004-C | A2 | S/E | 0 | 0.0 | 0.0 | 49.1 | 0.0 | 0 | 0 | 0 | 0 |
| 46 | TT300C-GEN-005-C | A1 | S/E | 0 | 0.0 | 0.0 | 67.0 | 0.0 | 0 | 0 | 0 | 0 |
| 47 | TT300C-GEN-006-C | A1 | S/E | 0 | 0.0 | 0.0 | 28.3 | 0.0 | 0 | 0 | 0 | 0 |
| 48 | TT300C-GEN-007-C | A1 | S/E | 0 | 0.0 | 0.0 | 45.6 | 0.0 | 0 | 0 | 0 | 0 |
| 49 | TT300C-GEN-008-C | A2 | S/E | 0 | 0.0 | 0.0 | 54.9 | 0.0 | 11 | 0 | 0 | 0 |
| 50 | TT300C-GEN-009-C | A1 | S/E | 0 | 0.0 | 0.0 | 48.1 | 0.0 | 6 | 0 | 0 | 0 |
| 51 | TT300C-GEN-010-C | A1 | S/E | 0 | 0.0 | 0.0 | 32.1 | 0.0 | 0 | 0 | 0 | 0 |
| 52 | TT300C-GEN-011-C | A2 | S/E | 0 | 0.0 | 0.0 | 27.5 | 0.0 | 0 | 0 | 0 | 0 |
| 53 | TT300C-GEN-012-C | A2 | S/E | 0 | 0.0 | 0.0 | 55.8 | 0.0 | 0 | 0 | 0 | 0 |

## Control de cadenas de cotas

- Cadenas automáticas: 81; con suma ≠ total (±0,05) o extremo fuera de una arista real del contorno 2D: 0. Detalle en `control_cadenas.csv`.

## Nombres internos de parámetros en las láminas

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

## Control de calidad gráfico (DXF)

- Choques de texto (intersección > 20 % del menor): 0. Entidades fuera del marco: 0. Invasiones del cajetín o de la banda de notas: 0. Textos reubicados por el ordenador de textos: 43.
