mafiucivil/Tornamesa/entregables/RevC/revision_visual.md

# Revisión visual de las láminas del caso por defecto (Rev. C, segunda pasada)

Método: cada PDF se rasterizó a 120 dpi (A1 = 2.800 × 1.980 px) y se abrió; por restricción de visor las imágenes se vieron reducidas a 1.300–1.500 px de ancho (individuales) o 1.100 px por lámina (montajes 2×2). **Solo un recorte a 120 dpi pleno** (bloque de rugosidad de ACC-004) se vio a resolución completa; los demás recortes de cotas, símbolos de soldadura y tablas **no se abrieron a ≥ 120 dpi plenos**: lo que se afirma abajo es lo legible a esa reducción (formas, solapes, textos cortados, huecos), no la ortografía de cada cota.

Clave de estado: **F** = abierta individualmente en la corrida final; **M** = abierta en montaje 2×2 de la corrida final; **P** = abierta solo en una corrida previa (el código posterior a esa vista cambió únicamente rotulado, GD&T o detalles añadidos); **N** = no abierta.

No se abrieron las láminas de INT/CON-012/MAD de las variantes en la corrida final: se vieron INT-001/003/005/007/101 y CON-012 de A, INT-102 e INT-101 de C1 y MAD-001 de W en corridas intermedias; B, C2, C3 y AF2 **no se abrieron**.

| N° | Lámina | Fmt | Cotas | % vistas/zona | % huella/zona | Estado | Qué se vio / qué se corrigió |
|---|---|---|---|---|---|---|---|
| 1 | GEN-001 | A1 | 0 | 0.0 | 0.0 | F | Índice y notas completos, sin solape. GEN-001 es A1 con mitad inferior izquierda vacía (solo texto). |
| 2 | CON-001 | A1 | 8 | 26.1 | 54.8 | P | Planta, elevación, cortes A-A/B-B con globos. Se corrigió el título (decía «isométrica» sin tenerla). |
| 3 | CON-002 | A1 | 0 | 0.0 | 0.0 | F | Despiece completo en una hoja; ancho completo. |
| 4 | CON-003 | A1 | 27 | 46.4 | 72.6 | F | Elevaciones, vista inferior y detalle A; se quitó la cota de 2 niveles ilegible y el detalle sin cotas; se dejó nota de cotas 228/210. |
| 5 | CON-004 | A1 | 0 | 51.2 | 77.4 | M | Explosionada con 31 globos; globos con guías largas cruzadas (aceptable, débil). |
| 6 | CON-005 | A1 | 0 | 53.0 | 66.8 | M | Cuatro etapas isométricas y tabla de secuencia a ancho completo. |
| 7 | CON-006 | A1 | 28 | 15.6 | 59.3 | M | Planta, cortes, 4 detalles con símbolo. El planificador ahora da planta 1:20; sigue chica (base de 2.560 mm). |
| 8 | CON-007 | A1 | 19 | 38.9 | 65.1 | M | Planta, cortes A-A/B-B, detalle J04 con símbolo. |
| 9 | CON-008 | A1 | 18 | 37.9 | 64.3 | F | Planta a media altura, planta inferior, elevación y corte; globos y tabla de soldaduras. |
| 10 | CON-009 | A1 | 4 | 17.3 | 59.3 | F | Corte por almas, holguras del collar, 3 preparaciones de junta y tabla de 28 pasadores. |
| 11 | CON-010 | A1 | 24 | 30.9 | 55.6 | F | Accionamiento: planta, corte A-A, elevación lateral, despiece. |
| 12 | CON-011 | A1 | 6 | 32.5 | 57.0 | M | Corte A-A con 6 globos, detalle de ajustes, tabla ISO 286. |
| 13 | BAS-001 | A1 | 20 | 38.4 | 74.0 | F | Planta con posiciones desde datums, corte A-A del collar, detalle J09, tabla de posiciones, rugosidad, GD&T. Se eliminó el detalle del marco duplicado para dar escala a la planta. |
| 14 | BAS-002 | A1 | 10 | 26.0 | 55.5 | M | Planta, corte, elevación y detalle J09; símbolo completo. |
| 15 | BAS-003 | A1 | 12 | 23.2 | 55.6 | M | Pletinas con rotura ISO 128-30 y detalles A/B/J01/J02. Corregido: el segundo juego de GD&T faltaba. |
| 16 | BAS-005 | A1 | 36 | 24.2 | 74.5 | M | Mejilla, orejas, detalles J04–J07; 36 cotas. |
| 17 | IZA-001 | A1 | 12 | 21.9 | 51.1 | P | Perfil con Ø45 H12, planta, detalle J10. |
| 18 | ACC-001 | A1 | 20 | 26.6 | 61.2 | F | Planta, corte A-A, detalle de ranura T, vista de extremo, detalle J08. |
| 19 | MES-001 | A1 | 16 | 21.2 | 58.9 | P | Corte con rotura, detalle B, 2 preparaciones (J12 V 60°, J18 ranura); en la corrida final se añadió 6×M10 del rebaje (no reabierta tras ese cambio). |
| 20 | MES-002 | A1 | 26 | 24.5 | 61.3 | M | Planta con PCD/paso/ángulos; cotas apiladas a la derecha de la planta se amontonan (débil); corte radial con rotura. |
| 21 | MES-003 | A1 | 10 | 18.8 | 38.1 | M | Vista inferior, corte con rotura, detalles B y J13. |
| 22 | MES-005 | A1 | 12 | 20.6 | 56.0 | P | Planta de las 3 almas, corte, 2 preparaciones (J16, J14), tabla de desarrollo. |
| 23 | MES-008 | A1 | 8 | 25.0 | 52.9 | M | 3 tramos de nervio, tabla angular de 14 nervios; solo 8 cotas (débil: se acota por tramo). |
| 24 | MES-011 | A1 | 17 | 32.6 | 63.8 | M | Planta, corte A-A, preparación J17 bisel 45°, detalle del rebaje. |
| 25 | MES-012 | A1 | 12 | 32.1 | 53.7 | M | Elevación, corte de rosca M20, chaflán 5:1, vista lateral. |
| 26 | MES-013 | A1 | 14 | 28.9 | 40.6 | M | Perno y arandela: corte, planta, elevación, tabla de especificación. |
| 27 | PIV-001 | A1 | 25 | 21.8 | 43.4 | M | Elevación, vista de extremo con 4×M10, corte B-B, detalle A. DEFECTO ABIERTO: el título de la vista de extremo toca las cotas del corte B-B. |
| 28 | PIV-002 | A1 | 10 | 40.7 | 56.9 | M | Planta, corte, elevación, detalle. La nota «Ø120 F7» cruza el borde izquierdo de la celda (débil). |
| 29 | PIV-003 | A1 | 28 | 21.9 | 56.1 | P | Dos tapas con tabla de coordenadas de los 10 agujeros; nota de agujeros de la tapa retenedora llega al margen izquierdo (débil). |
| 30 | ACC-002 | A1 | 25 | 29.7 | 46.9 | M | Cilindro comercial con rotura, detalles A/B, tabla de compra. |
| 31 | ACC-003 | A1 | 45 | 31.6 | 50.9 | M | Patín: planta, corte F-F, lateral, detalle de lengüeta T; 45 cotas. |
| 32 | ACC-004 | A1 | 22 | 33.9 | 55.1 | M | Uña: planta, elevación, cortes B-B/C-C, detalle del chaflán; dos detalles con poca cota. |
| 33 | ACC-005 | A1 | 13 | 40.8 | 58.8 | M | Pasadores f8 con tabla de variantes de largo, corte y detalle de chaflán. |
| 34 | GEN-003 | A1 | 0 | 0.0 | 0.0 | P | Tabla completa de 17 puntos. |
| 35 | GEN-004 | A2 | 0 | 0.0 | 0.0 | F | Se detectó solape entre la tabla de GD&T y la de ISO 2768 (error desde la pasada anterior); corregido (tablas una bajo otra) y reabierta en A1 a 50 dpi. |
| 36 | GEN-005 | A1 | 0 | 0.0 | 0.0 | M | Materiales + grados propuestos por Fy; hallazgo: 34CrNiMo6 no llega a Re 900 con Ø88 (queda «A DEFINIR POR EL CALCULISTA»). |
| 37 | GEN-006 | A1 | 0 | 0.0 | 0.0 | M | Tratamientos y sistema de pintura (240 µm). |
| 38 | GEN-007 | A1 | 0 | 0.0 | 0.0 | M | Programa de 18 juntas. |
| 39 | GEN-008 | A2 | 0 | 0.0 | 0.0 | F | Torques y 11 componentes de catálogo. |
| 40 | GEN-009 | A1 | 0 | 0.0 | 0.0 | M | Supuestos S13–S15 y brechas B-01…B-07. |
| 41 | GEN-010 | A1 | 0 | 0.0 | 0.0 | M | Nesting: esquemas de planchas muy esquemáticos (débil). |
| 42 | GEN-011 | A2 | 0 | 0.0 | 0.0 | M | Lista de verificación. |
| 43 | GEN-012 | A2 | 0 | 0.0 | 0.0 | M | Tabla de WPS-P01…P07 y precalentamiento Tabla 3.2. |

## Defectos conocidos que quedan
- PIV-001: título de la vista de extremo sobre las cotas del corte B-B.
- MES-002: cotas de la planta apiladas y amontonadas junto a la columna derecha.
- PIV-002, PIV-003: notas de agujeros que llegan al borde izquierdo de la celda.
- GEN-010: esquemas de nesting rudimentarios.
- Ocupación: las láminas de pieza grandes (BAS, MES) siguen con 15–25 % de vistas sobre la zona de vistas; la huella (vista + cotas + títulos + símbolos) es 51–75 %.

## Tercera pasada (cero textos montados, uña Re ≥ 800, defectos abiertos)

Control automático nuevo en el generador (`cad/colisiones.py`, llamado por `generar_paquete.py`): choques de texto (intersección > 20 % del texto menor), entidades fuera del marco interior, entidades del cuerpo dentro del cajetín y entidades de las vistas sobre los bloques de notas/tablas. El generador termina con error si alguno es > 0. Antes de guardar, un ordenador de textos desliza cada valor de cota o llamada a lo largo de su propia línea (prolongándola) hasta dejar ≥ 0,9 mm de holgura con cualquier otro texto, y el compositor recompone la lámina si una vista usó más líneas de cota que las reservadas.

Láminas abiertas en esta pasada (PDF a 120 dpi recortado al área de dibujo y visto a ~2.000 px de ancho, o lámina completa a 45–60 dpi):

| Lámina | Qué se vio | Corrección |
|---|---|---|
| ACC-003 | «Ø70 H9» montado sobre 57,5/65 en la planta | El ordenador saca la llamada; se verificó a 120 dpi |
| BAS-001 | Cadena 140/540 montada; llamadas del collar y de la zona de apoyo cruzando la planta; datum A sobre una cota | Llamadas quitadas (los datos están en la tabla y el corte), Ø120 H7 acotado en el corte, datum al costado, símbolo J09 fuera de la pila de cotas, detalle J09 repuesto |
| BAS-003 | 45 sobre J01 | Resuelto por el ordenador (0 choques en el control) |
| BAS-005 | z20 sobre «78 (= 53 + 25)», título sobre símbolo | Símbolos J04/J07 llevados fuera de la vista (reserva lateral de 115 mm) |
| CON-006 | 18/45 y título D4 contra el rabo del símbolo | Reserva lateral de 115 mm para símbolos; abierta en A pegado |
| CON-007 | Ø70 H9 sobre la letra C | Llamada girada a 60° |
| IZA-001 | Símbolo J10 sobre t = 18, z = 8 sobre a = 5,7 | Símbolo fuera de la vista; abierta a 120 dpi |
| MES-002 | Cadena amontonada en la columna derecha de la planta | Planta solo con extremos y llamada «28 × Ø85 H7, PCD, paso»; texto «Primer agujero…» eliminado (está en notas) |
| MES-011 | r = 2 sobre 45° | Resuelto por el ordenador; abierta a 120 dpi |
| PIV-001 | Título de la vista de extremo sobre Ø120 | Recomposición con la reserva corregida; abierta |
| PIV-002 | Nota Ø120 F7 al borde de la celda | Llamada espejada hacia el lado con espacio; abierta a 120 dpi |
| PIV-003 | «4 × Ø11…» sobre la letra E y fuera del marco | Llamada abreviada (el detalle está en la tabla de coordenadas); abierta. Queda: su línea de referencia cruza la cota 56,22 (línea sobre texto, no texto sobre texto) |
| MES-005 | Radios de las almas invadiendo la banda de advertencia | Radios rotulados hacia abajo |
| MAD-001 / MAD-002 (madera) | Cotas de ventana sin sentido en los cortes | Cortes acotados solo sobre el anillo; abiertas a 50–60 dpi |
| INT-007 (B) | Lámina UHMW | Abierta, sin defectos visibles |

No se abrieron en esta pasada las demás láminas (el control automático da 0 choques, 0 fuera de marco y 0 invasiones en los 8 casos, pero eso no detecta línea sobre texto ni símbolo sobre geometría).
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
