mafiucivil/Tornamesa/cad/out/TT300-C_Memoria_RevC.docx

MEMORIA DE CÁLCULO

TORNAMESA HIDRÁULICA TT300-C · 300 tf

Mesa giratoria Ø2.000 para cargas sobredimensionadas (transformadores y equipos pesados). Accionamiento por cilindros con patín guiado y uña.

Campo | Valor
Documento | TT300-C-MC-01
Revisión | C
Fecha | 2026-11-07
Estado | Emitido para revisión – no apto para fabricación hasta aprobación
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
