mafiucivil/Tornamesa/cad/out/default/png/TT300C-ACC-001-B.png

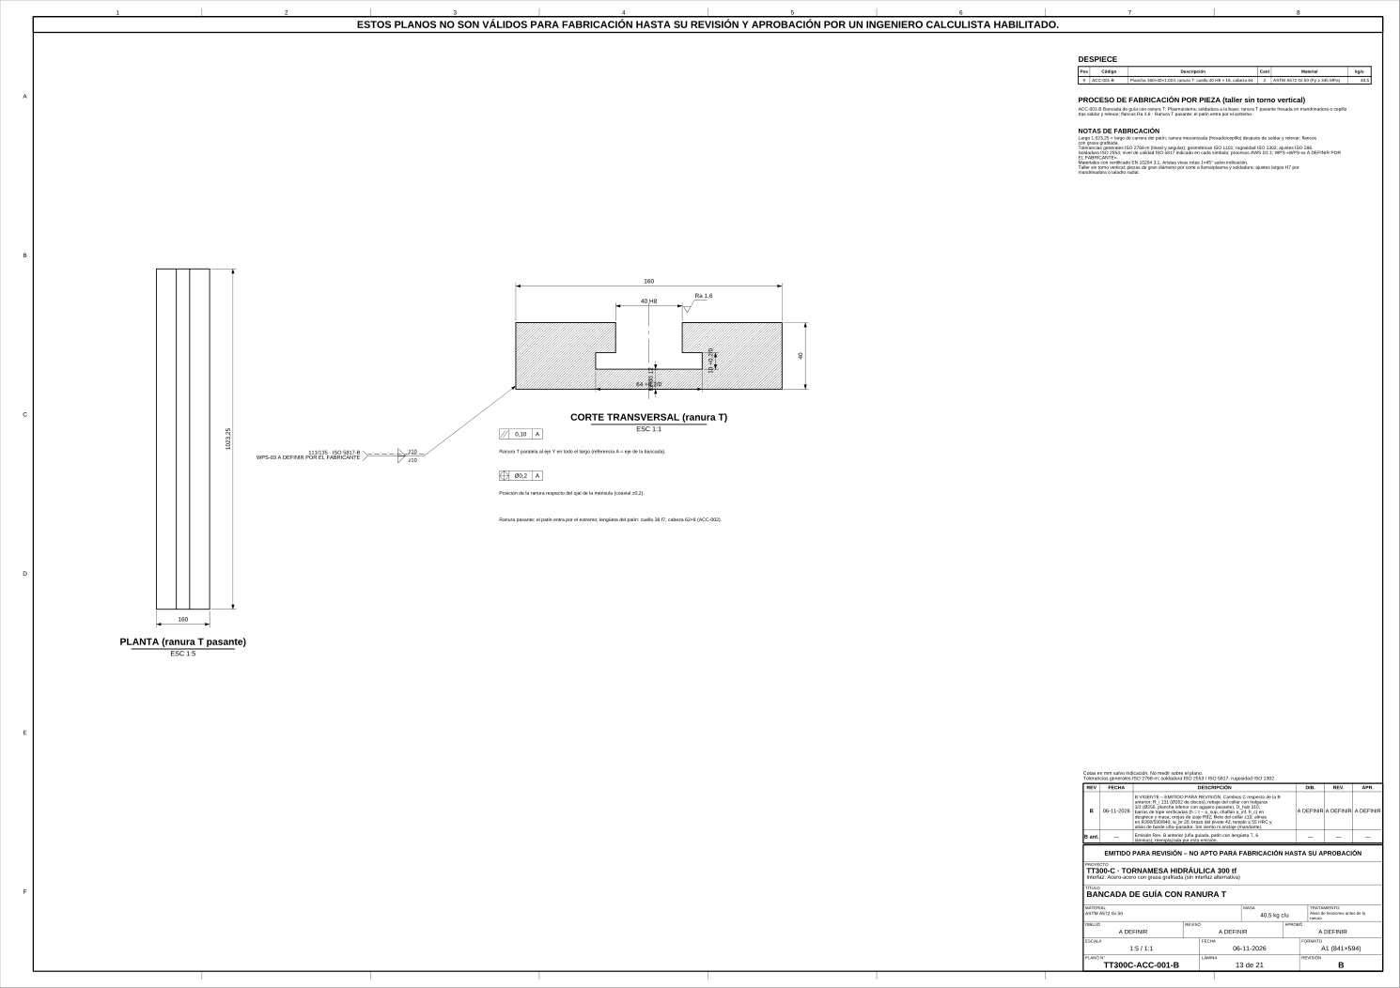
cad/out/default/png/TT300C-ACC-001-B.png
