mafiucivil/Tornamesa/cad/out/default/png/TT300C-ACC-002-B.png

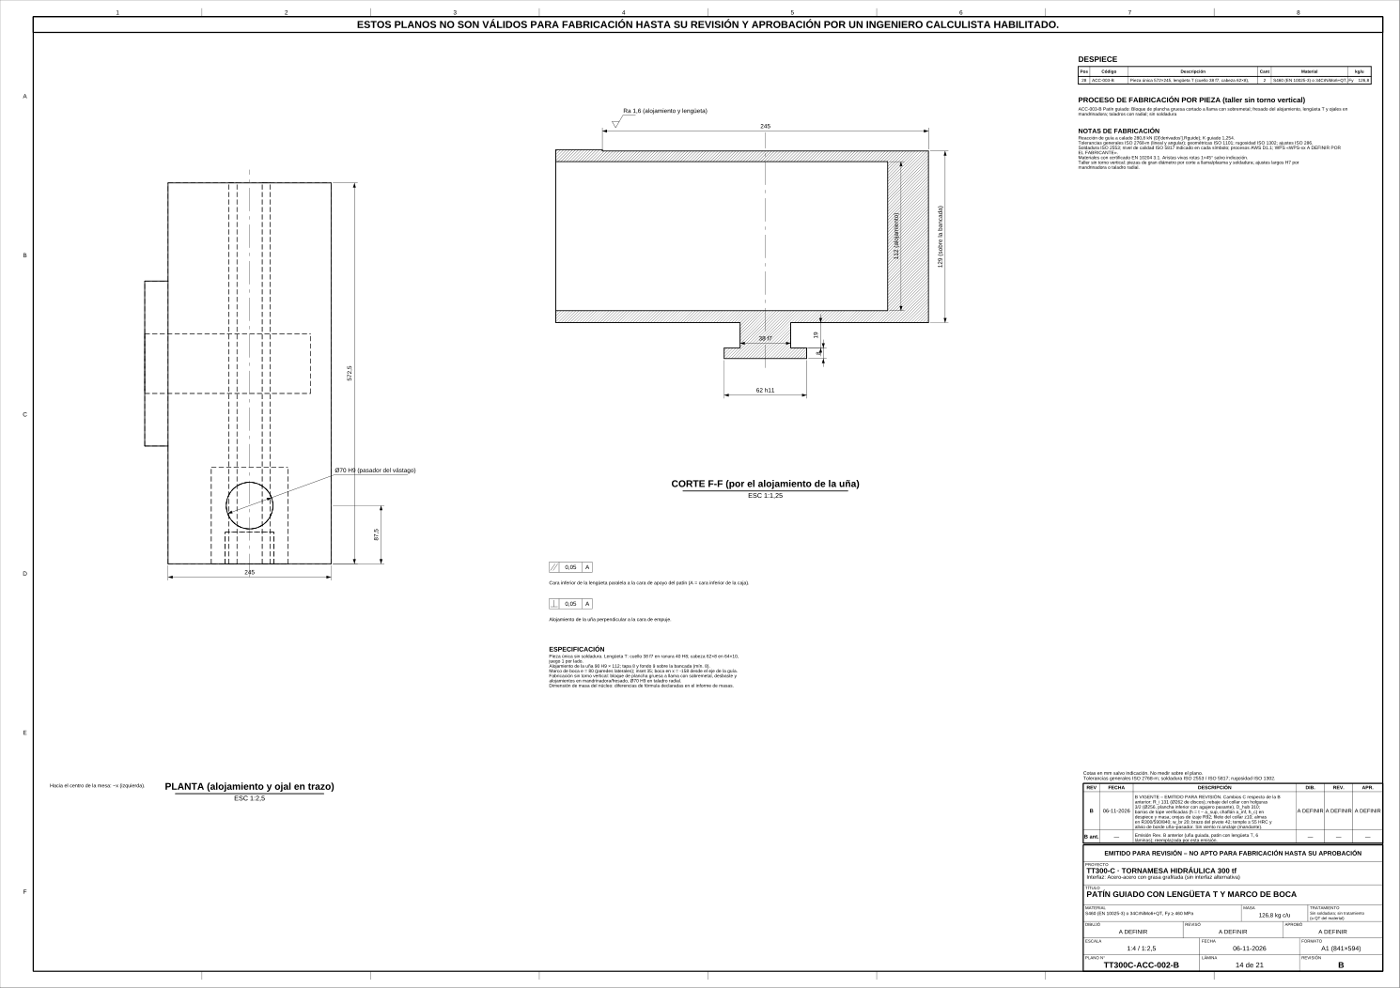
cad/out/default/png/TT300C-ACC-002-B.png
