mafiucivil/Tornamesa/cad/out/default/png/TT300C-ACC-003-B.png

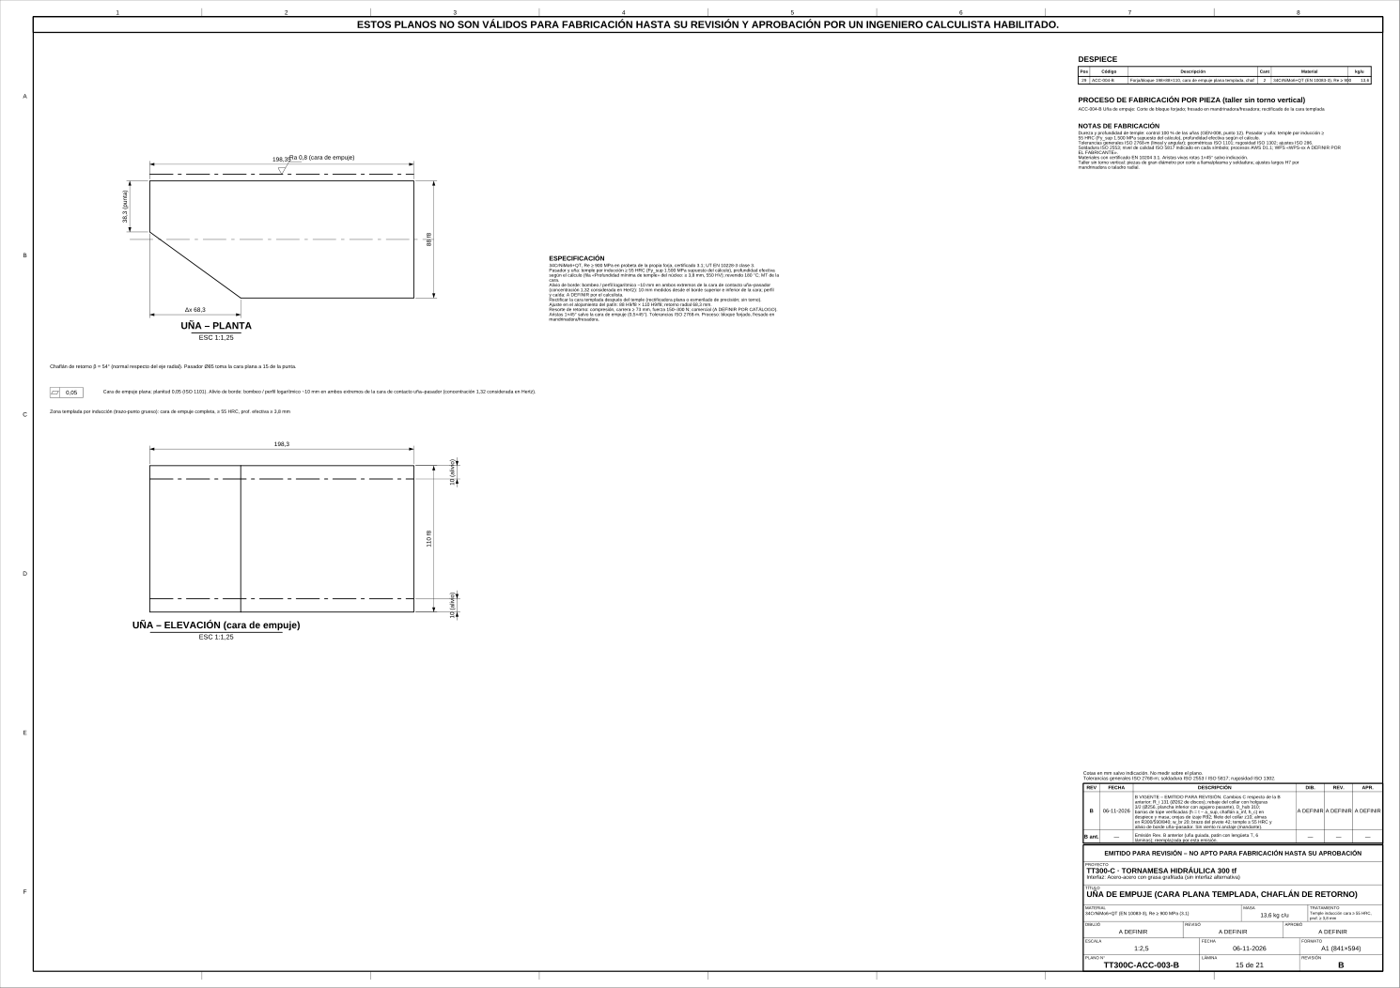
cad/out/default/png/TT300C-ACC-003-B.png
