mafiucivil/Tornamesa/cad/out/default/png/TT300C-ACC-004-B.png

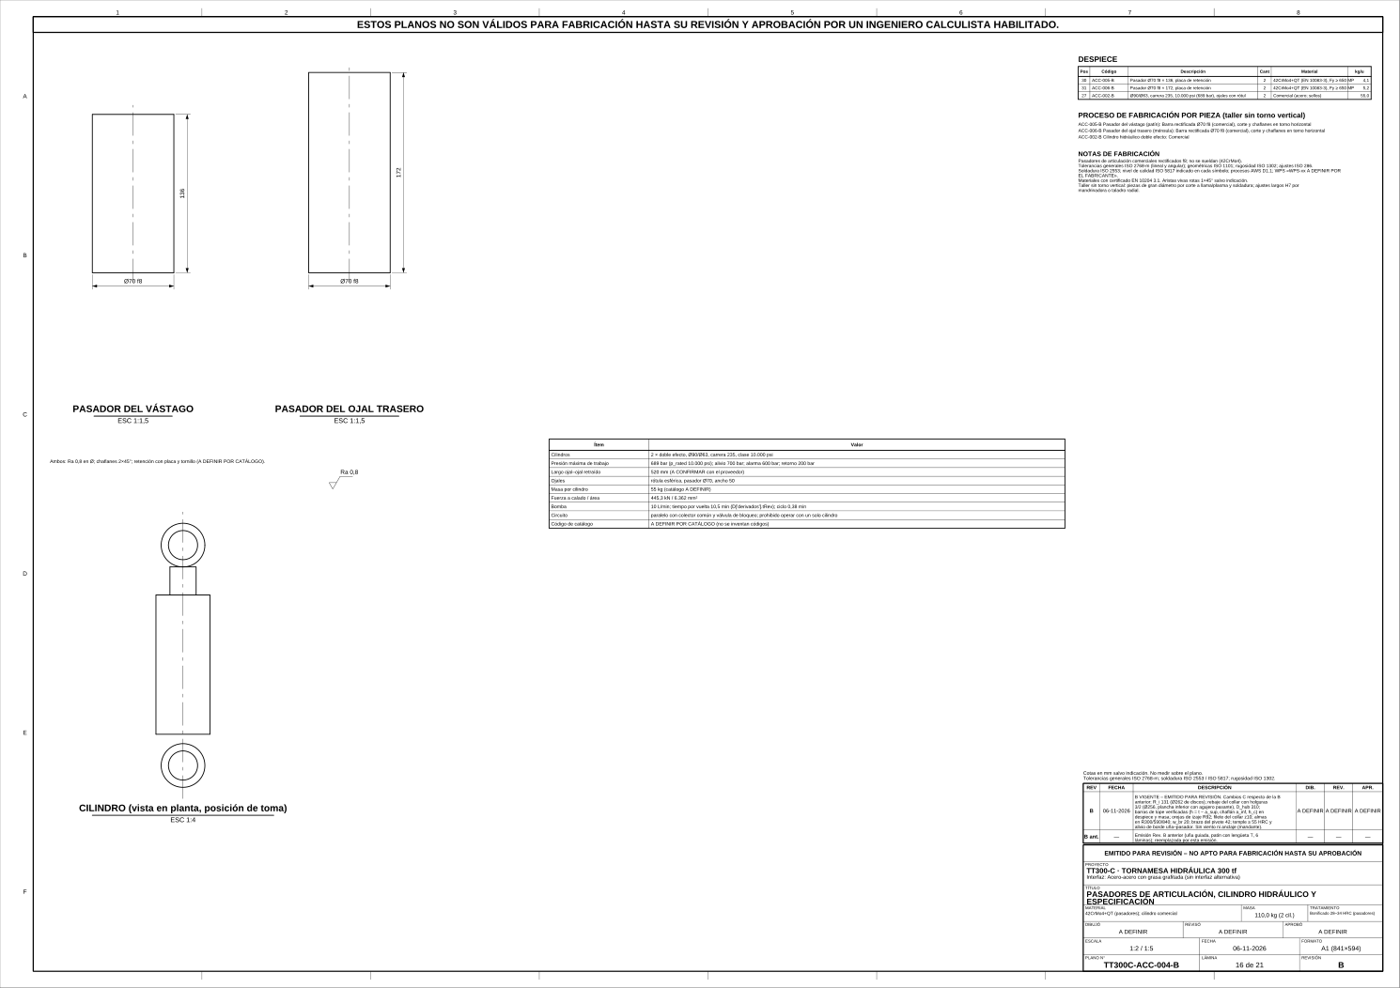
cad/out/default/png/TT300C-ACC-004-B.png
