mafiucivil/Tornamesa/cad/out/default/png/TT300C-BAS-001-B.png

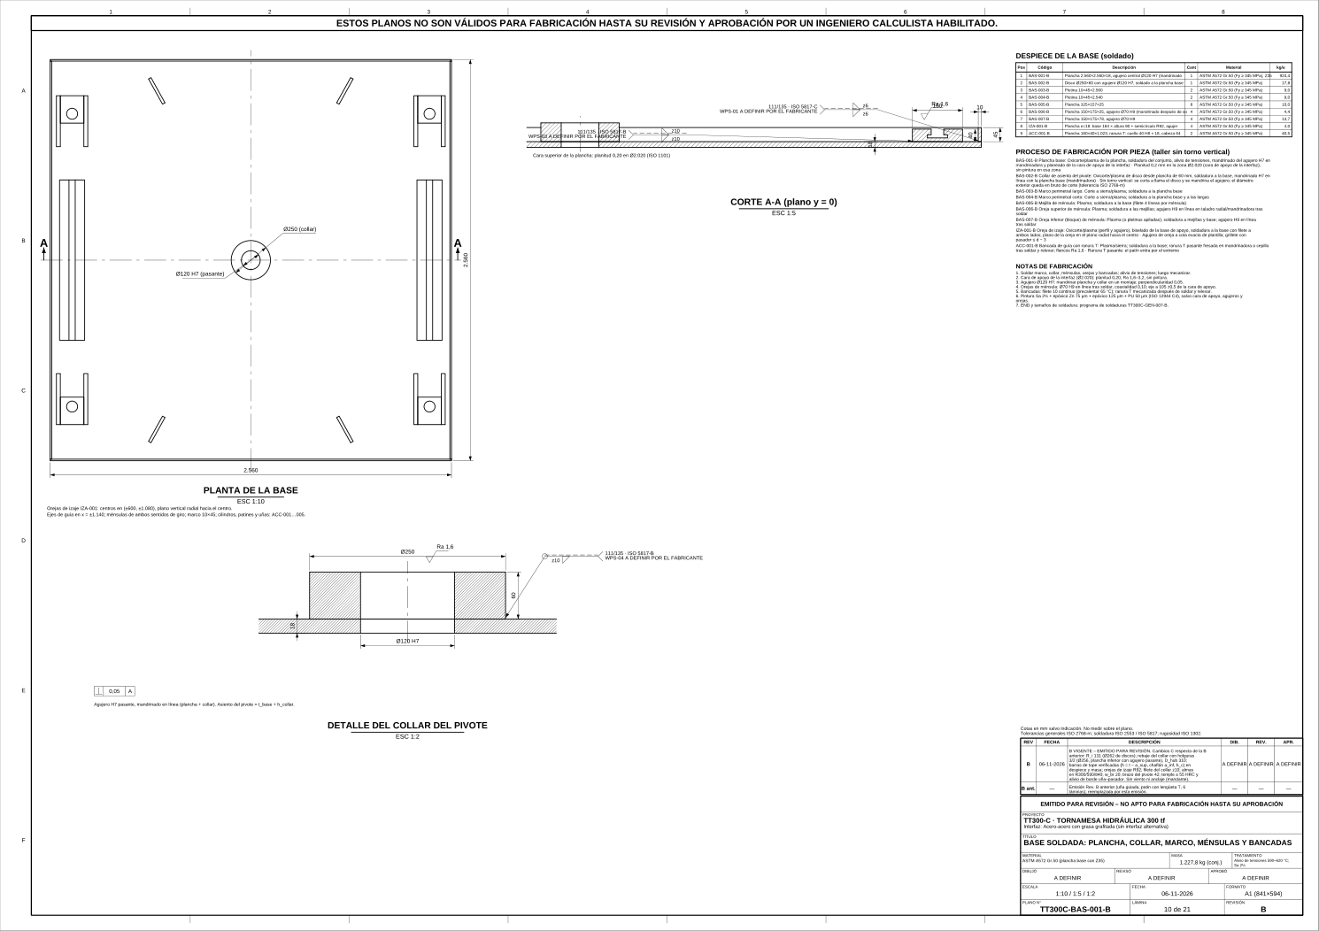
cad/out/default/png/TT300C-BAS-001-B.png
