mafiucivil/Tornamesa/cad/out/default/png/TT300C-BAS-005-B.png

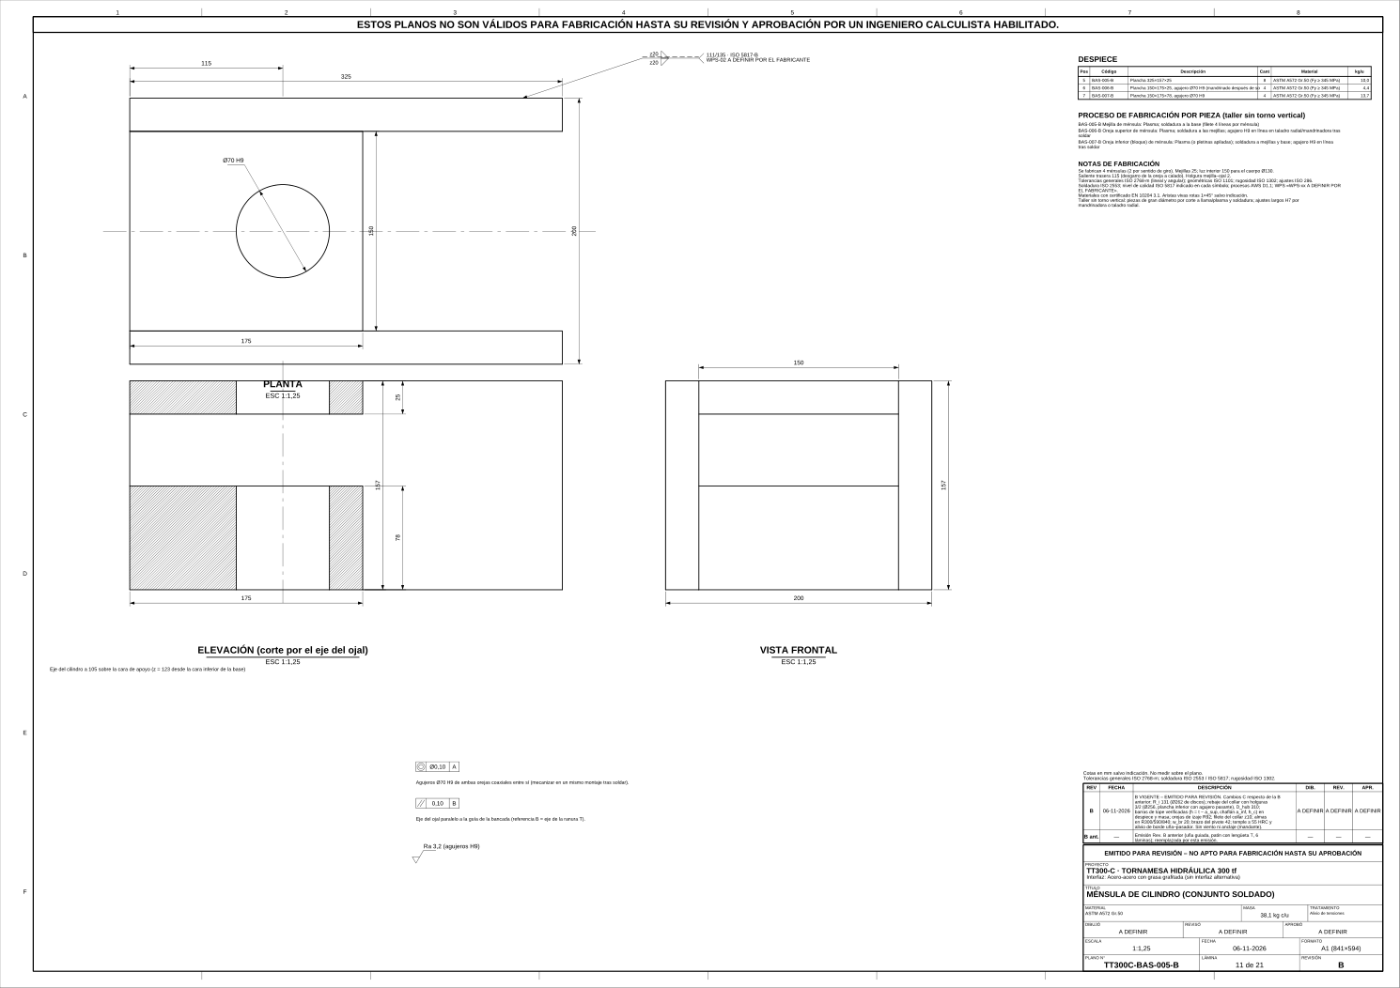
cad/out/default/png/TT300C-BAS-005-B.png
