mafiucivil/Tornamesa/cad/out/default/png/TT300C-GEN-001-B.png

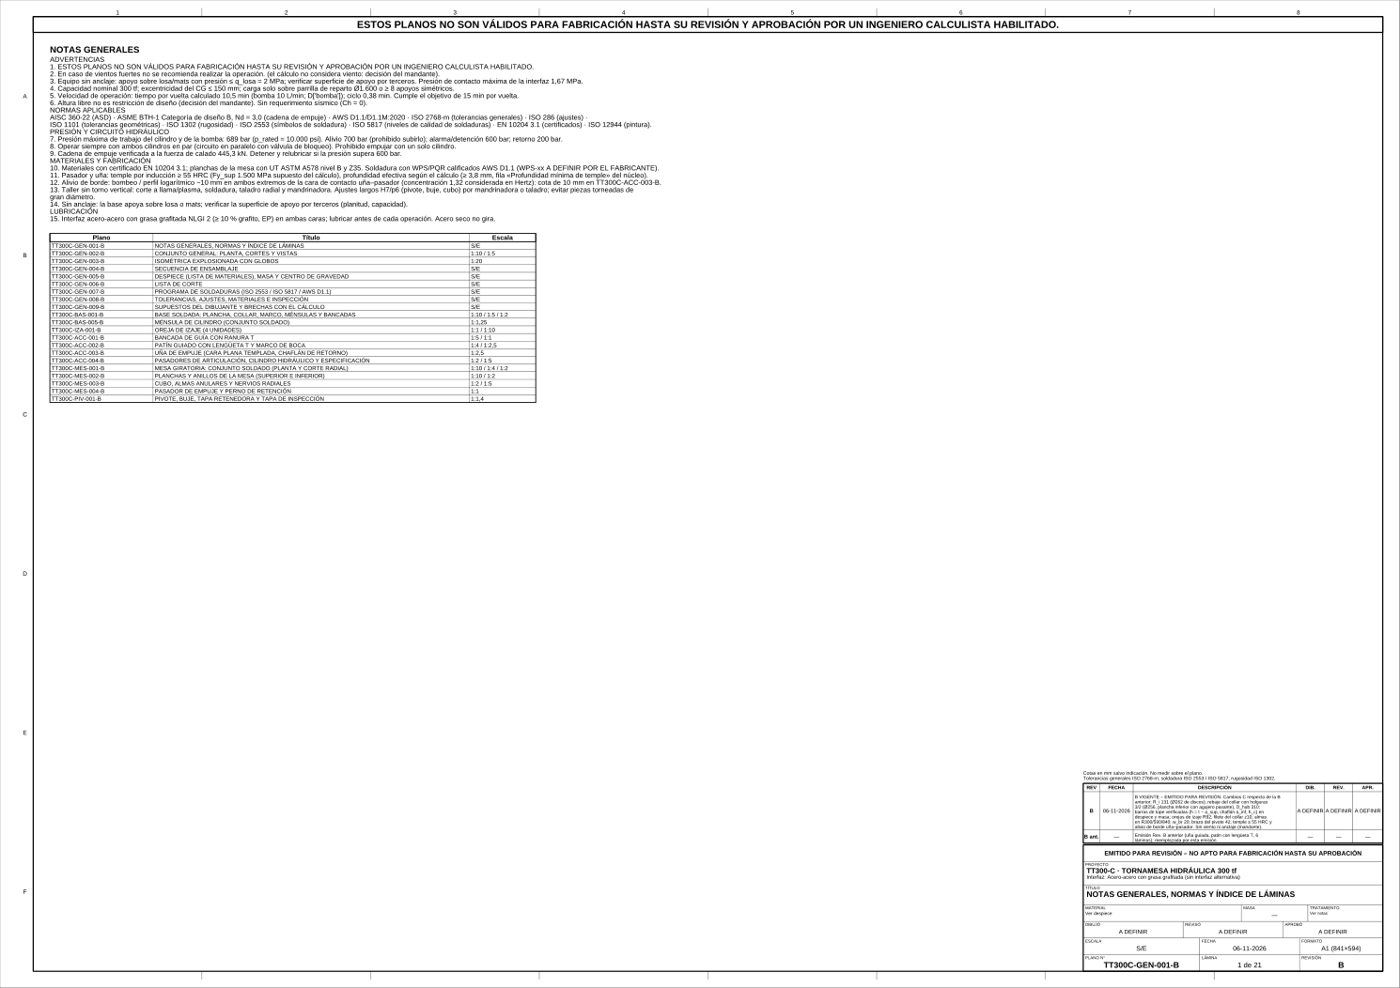
cad/out/default/png/TT300C-GEN-001-B.png
