mafiucivil/Tornamesa/cad/out/default/png/TT300C-GEN-002-B.png

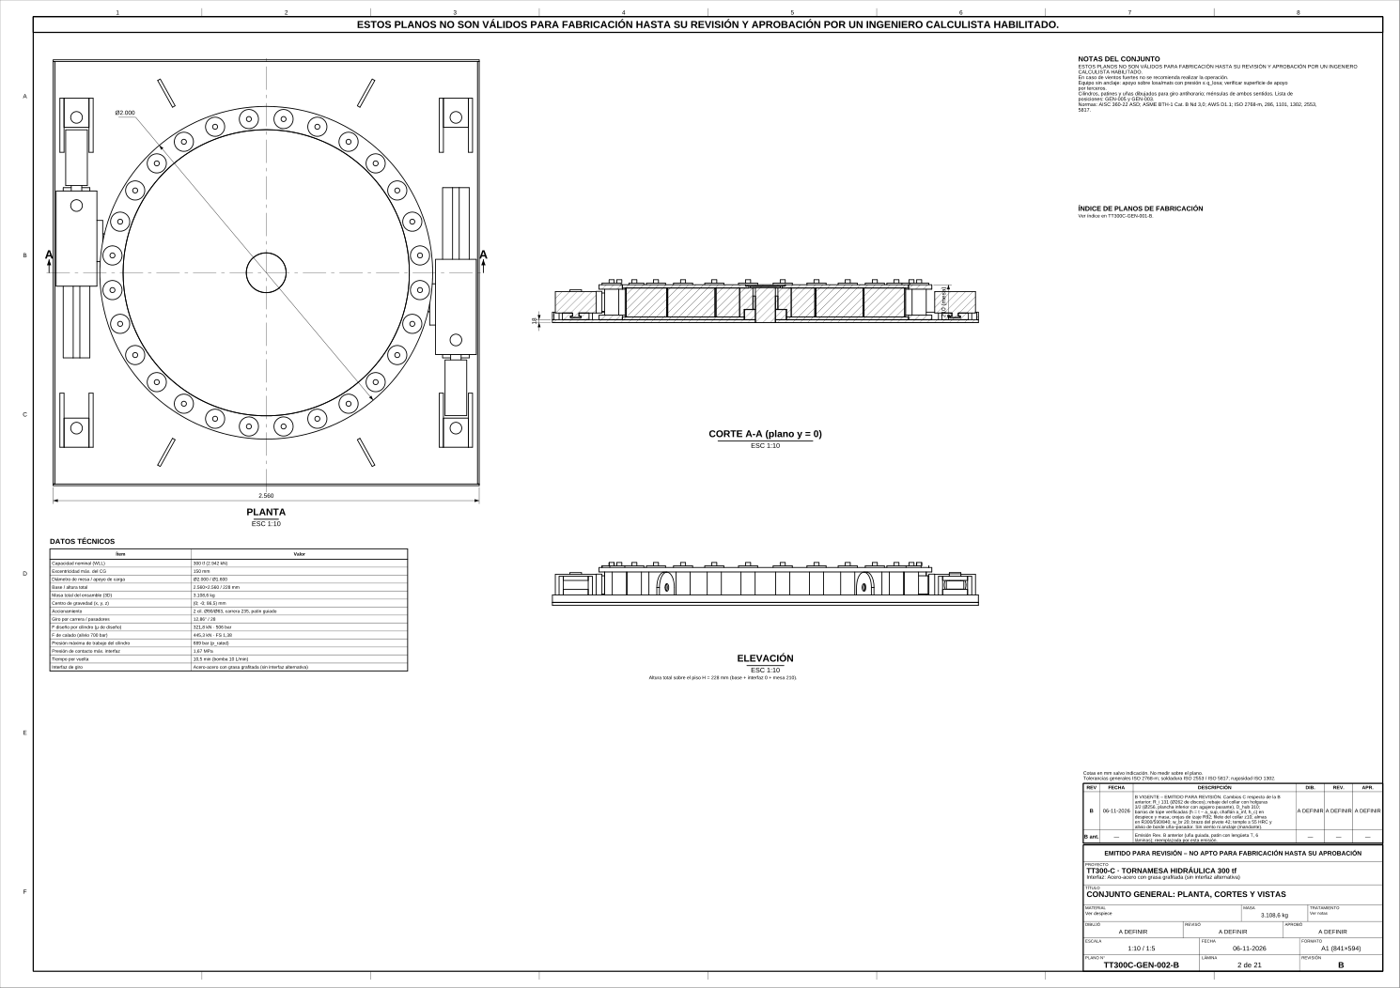
cad/out/default/png/TT300C-GEN-002-B.png
