mafiucivil/Tornamesa/cad/out/default/png/TT300C-GEN-003-B.png

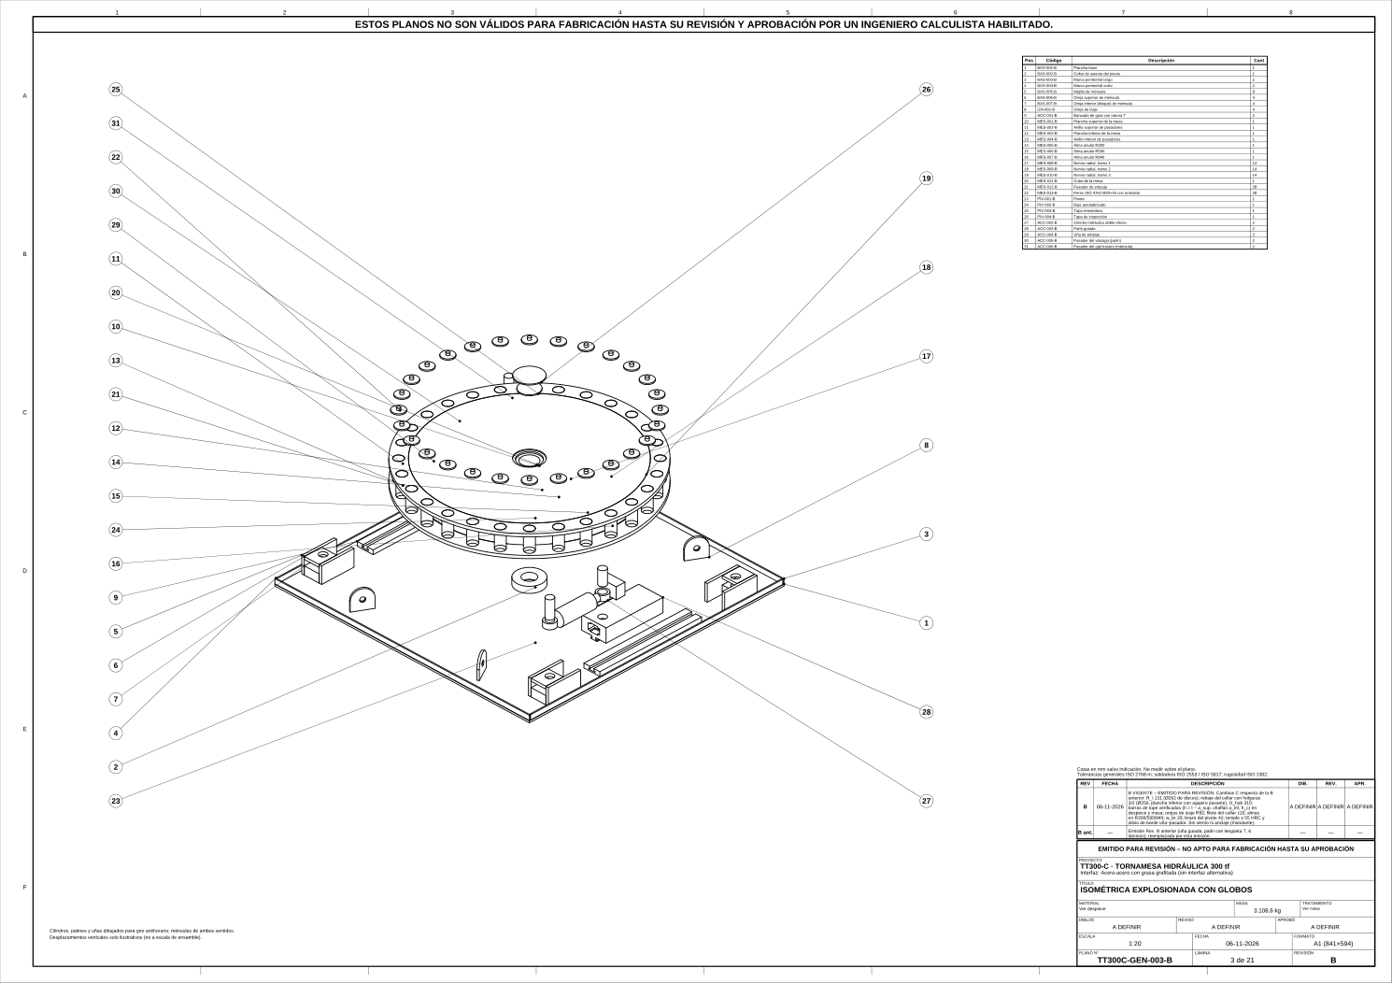
cad/out/default/png/TT300C-GEN-003-B.png
