mafiucivil/Tornamesa/cad/out/default/png/TT300C-GEN-004-B.png

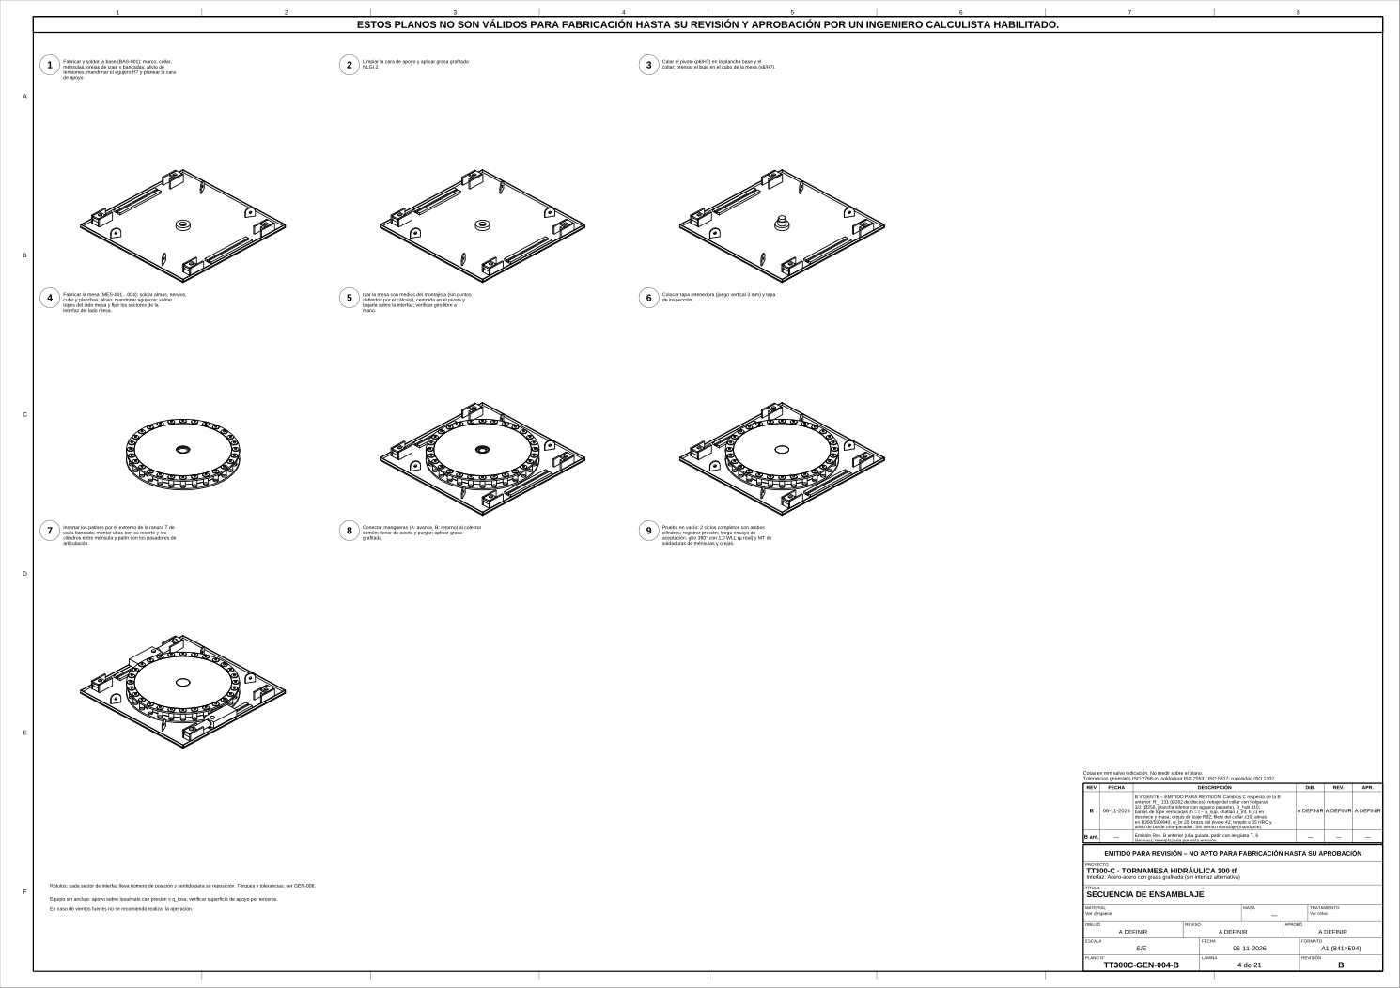
cad/out/default/png/TT300C-GEN-004-B.png
