mafiucivil/Tornamesa/cad/out/default/png/TT300C-GEN-005-B.png

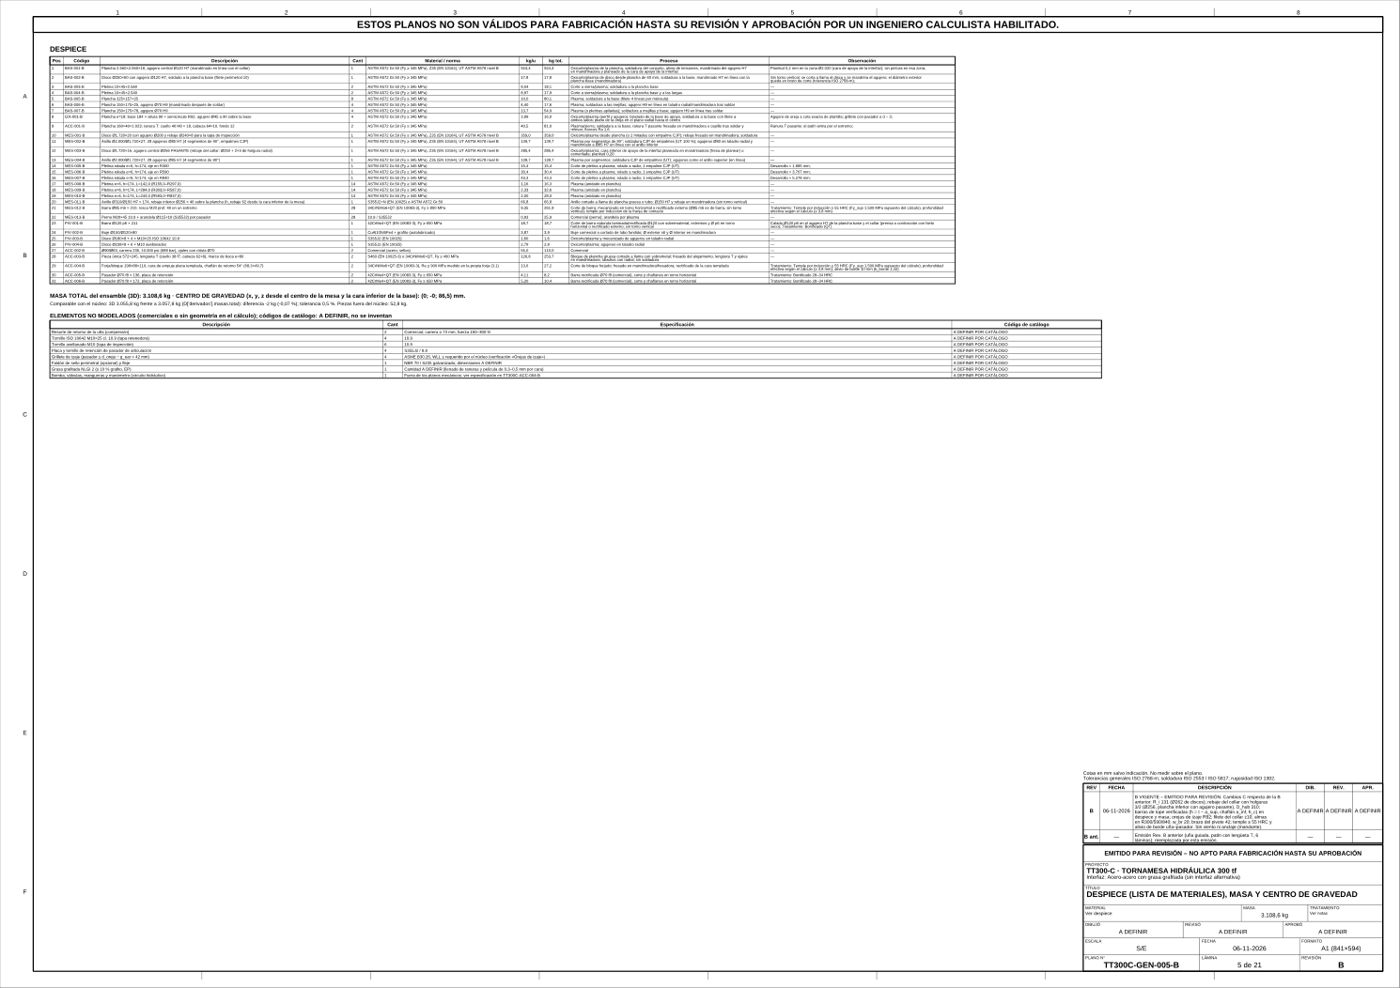
cad/out/default/png/TT300C-GEN-005-B.png
