mafiucivil/Tornamesa/cad/out/default/png/TT300C-GEN-006-B.png

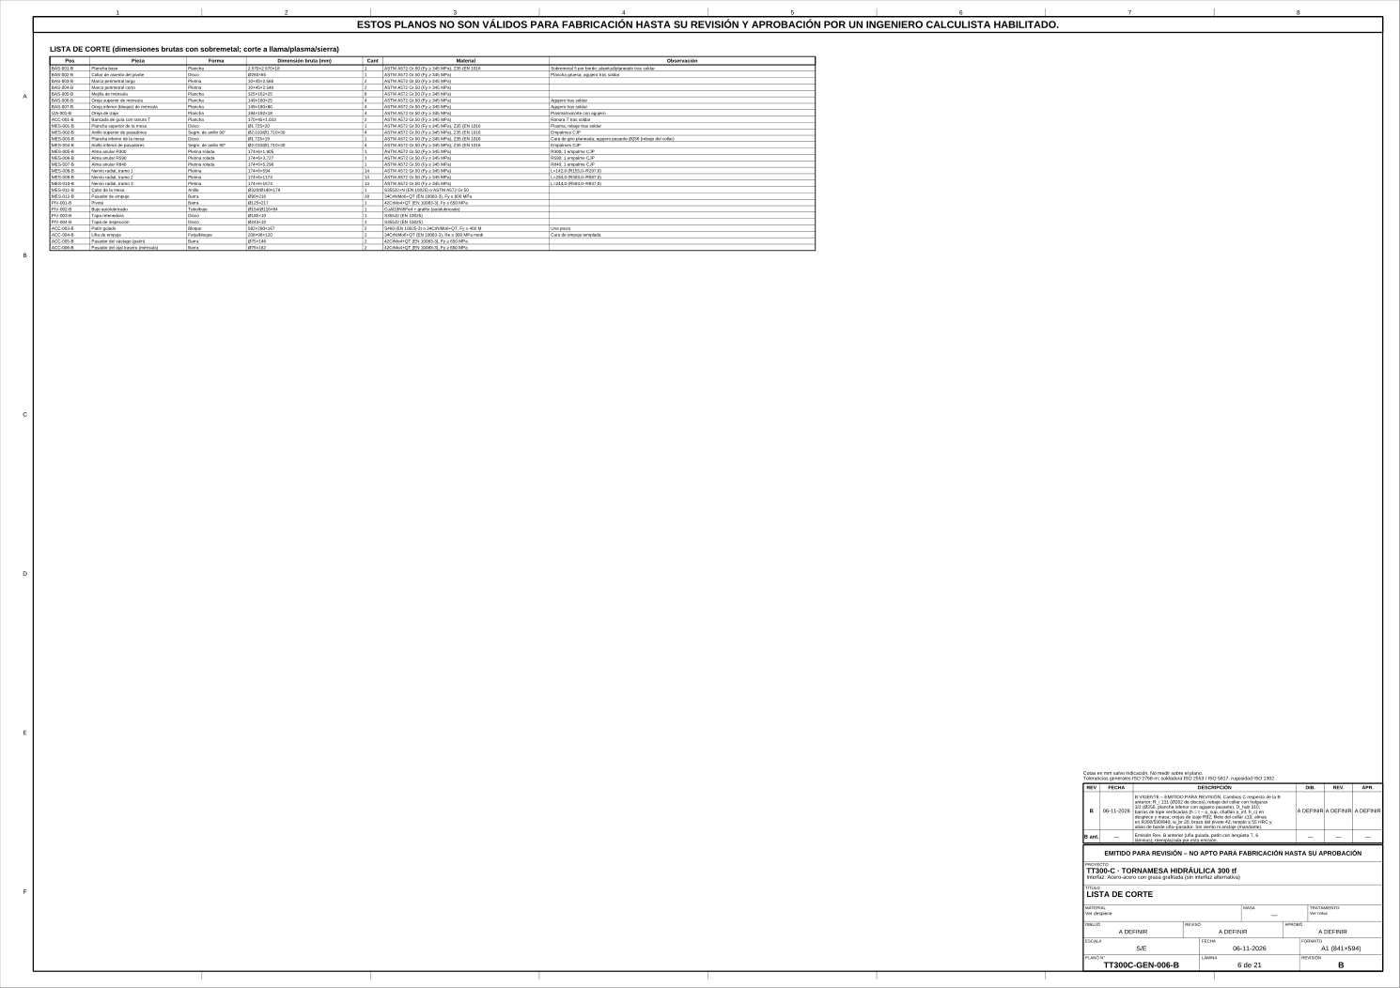
cad/out/default/png/TT300C-GEN-006-B.png
