mafiucivil/Tornamesa/cad/out/default/png/TT300C-GEN-007-B.png

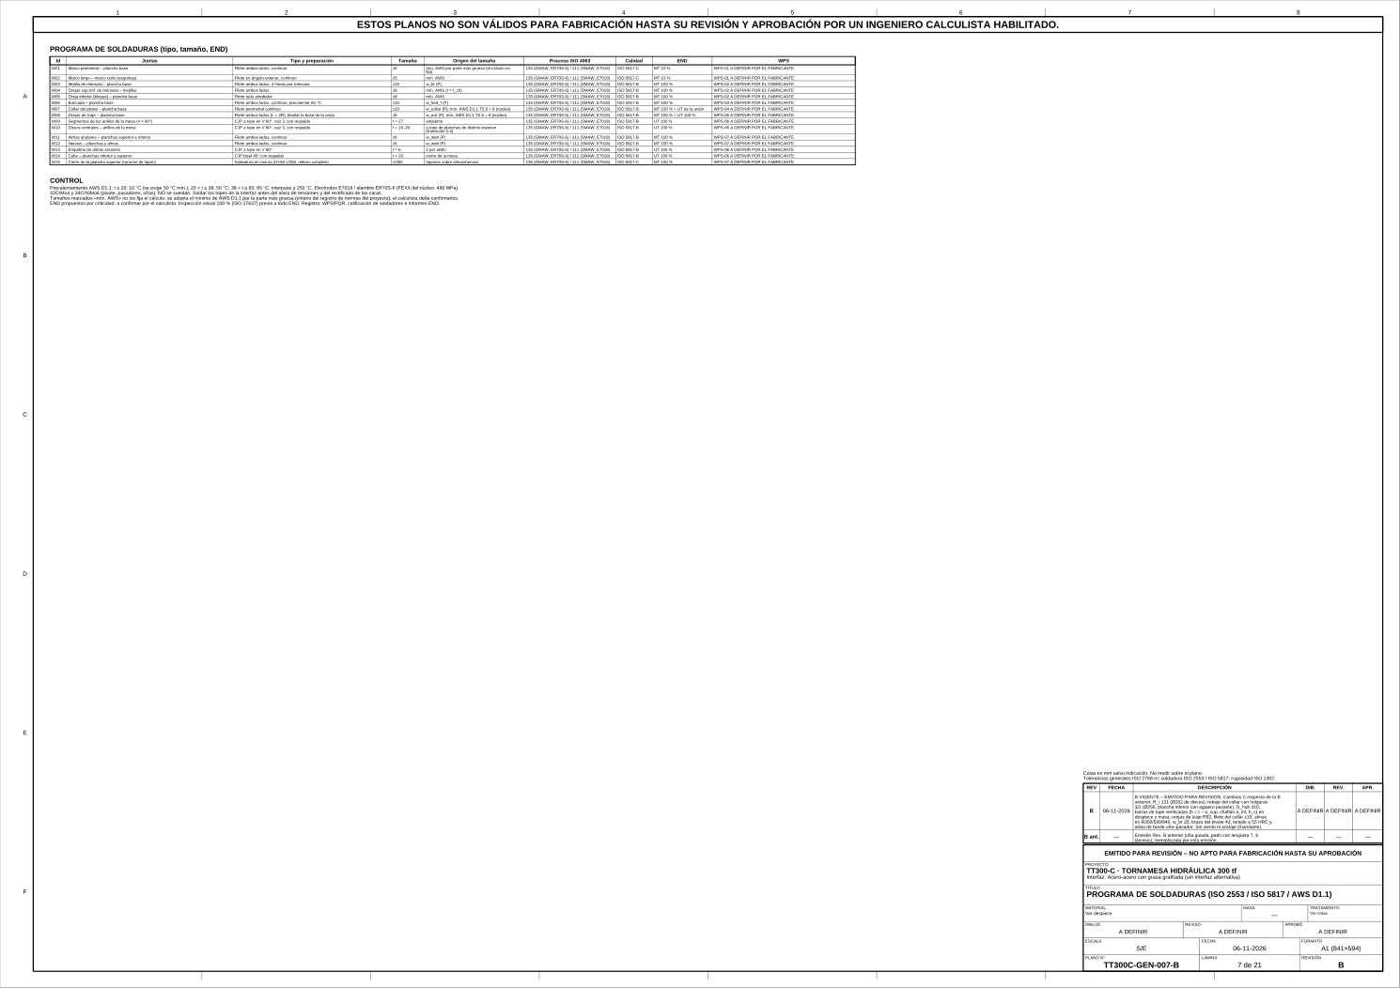
cad/out/default/png/TT300C-GEN-007-B.png
