mafiucivil/Tornamesa/cad/out/default/png/TT300C-GEN-008-B.png

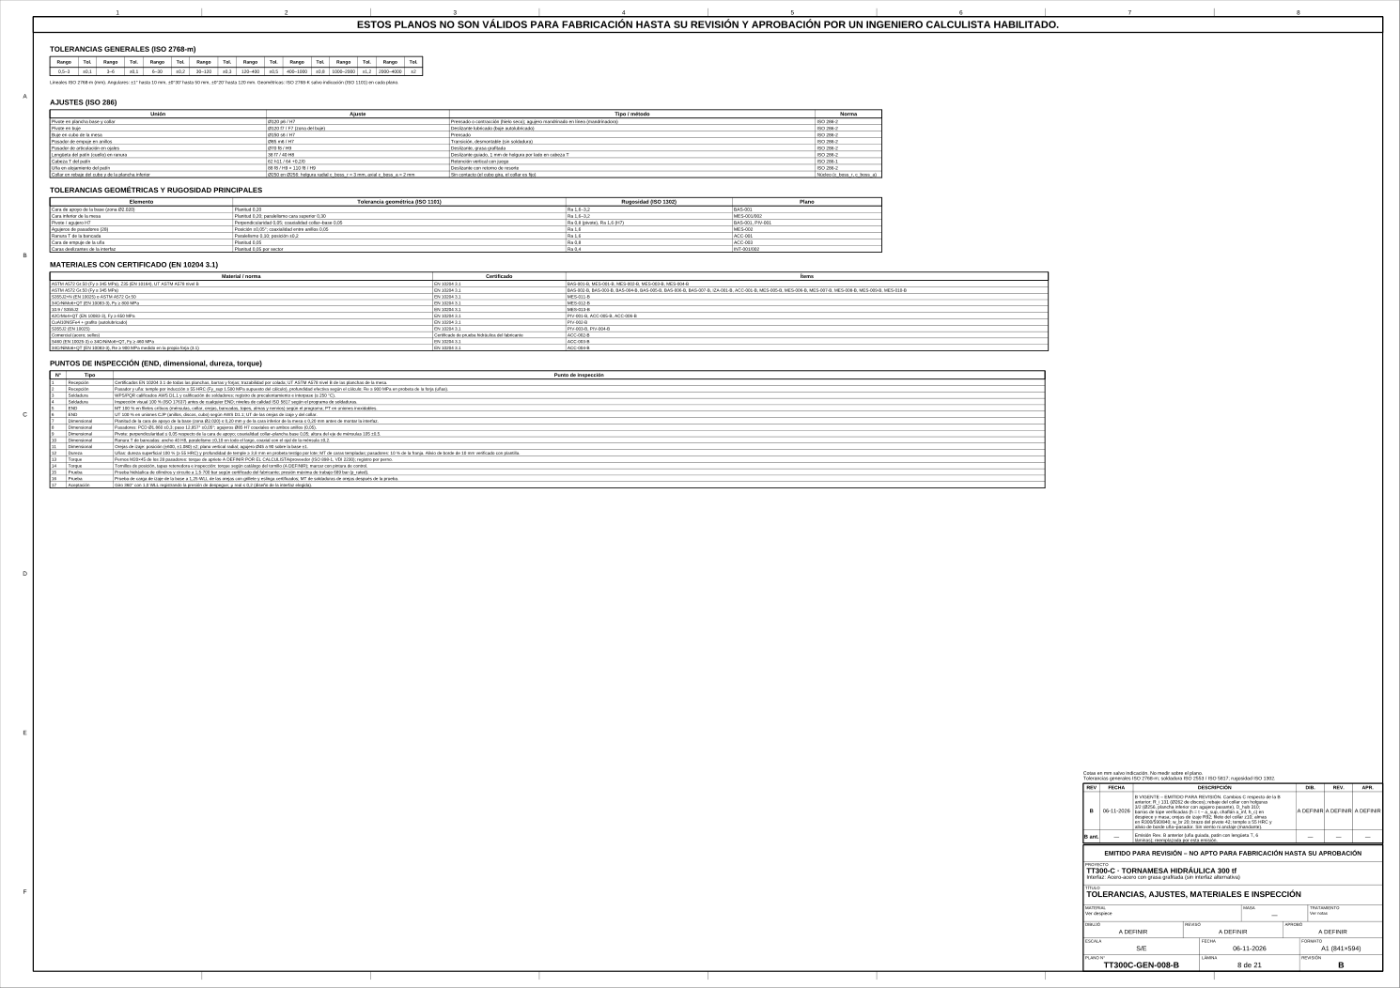
cad/out/default/png/TT300C-GEN-008-B.png
