mafiucivil/Tornamesa/cad/out/default/png/TT300C-GEN-009-B.png

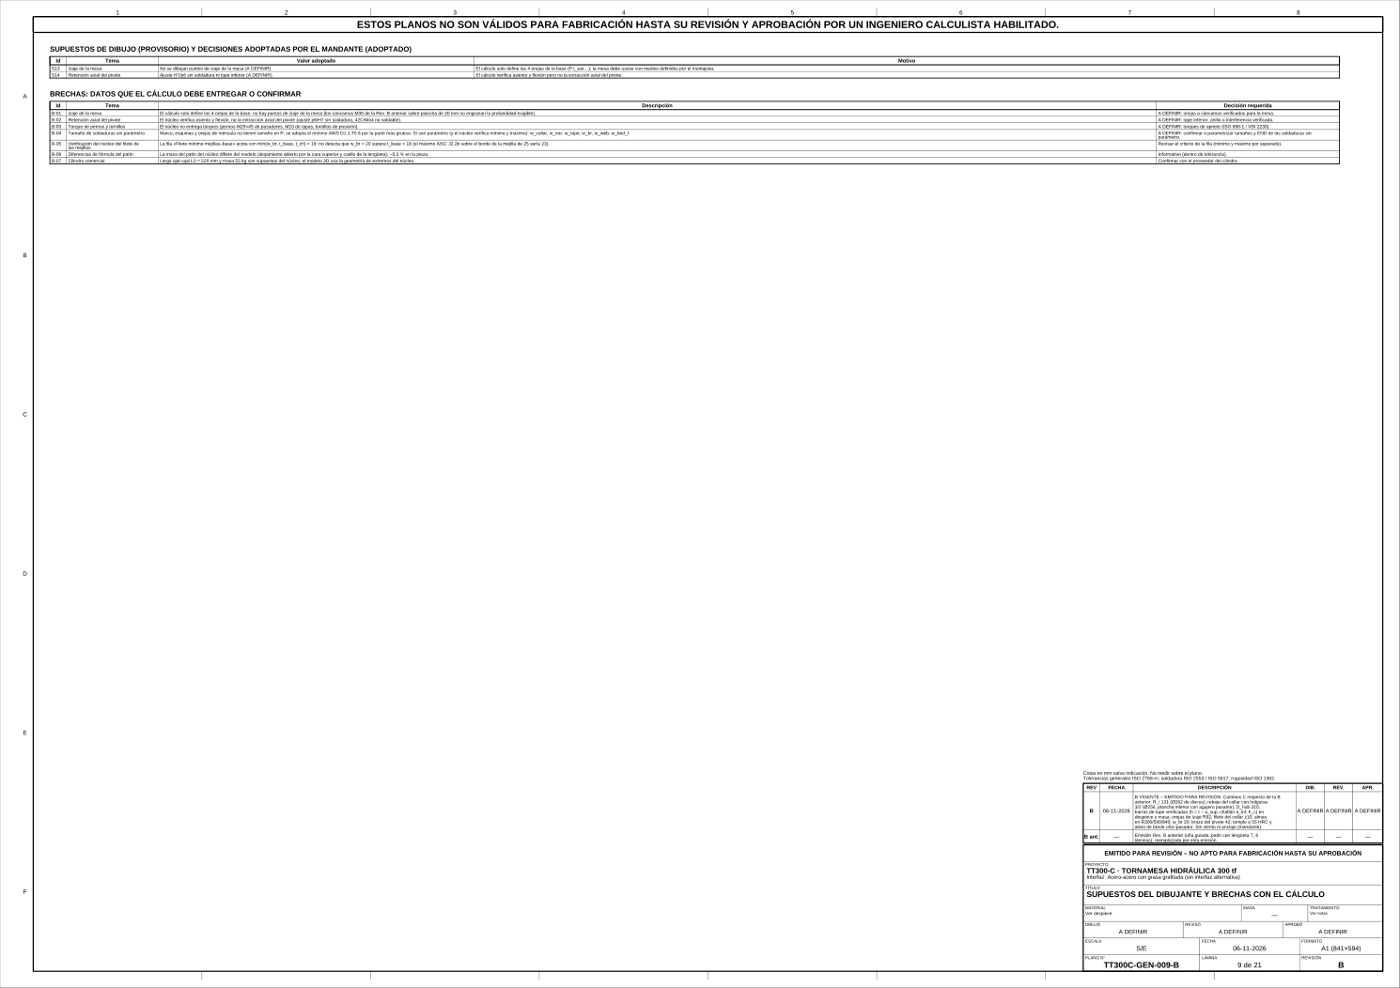
cad/out/default/png/TT300C-GEN-009-B.png
