mafiucivil/Tornamesa/cad/out/default/png/TT300C-IZA-001-B.png

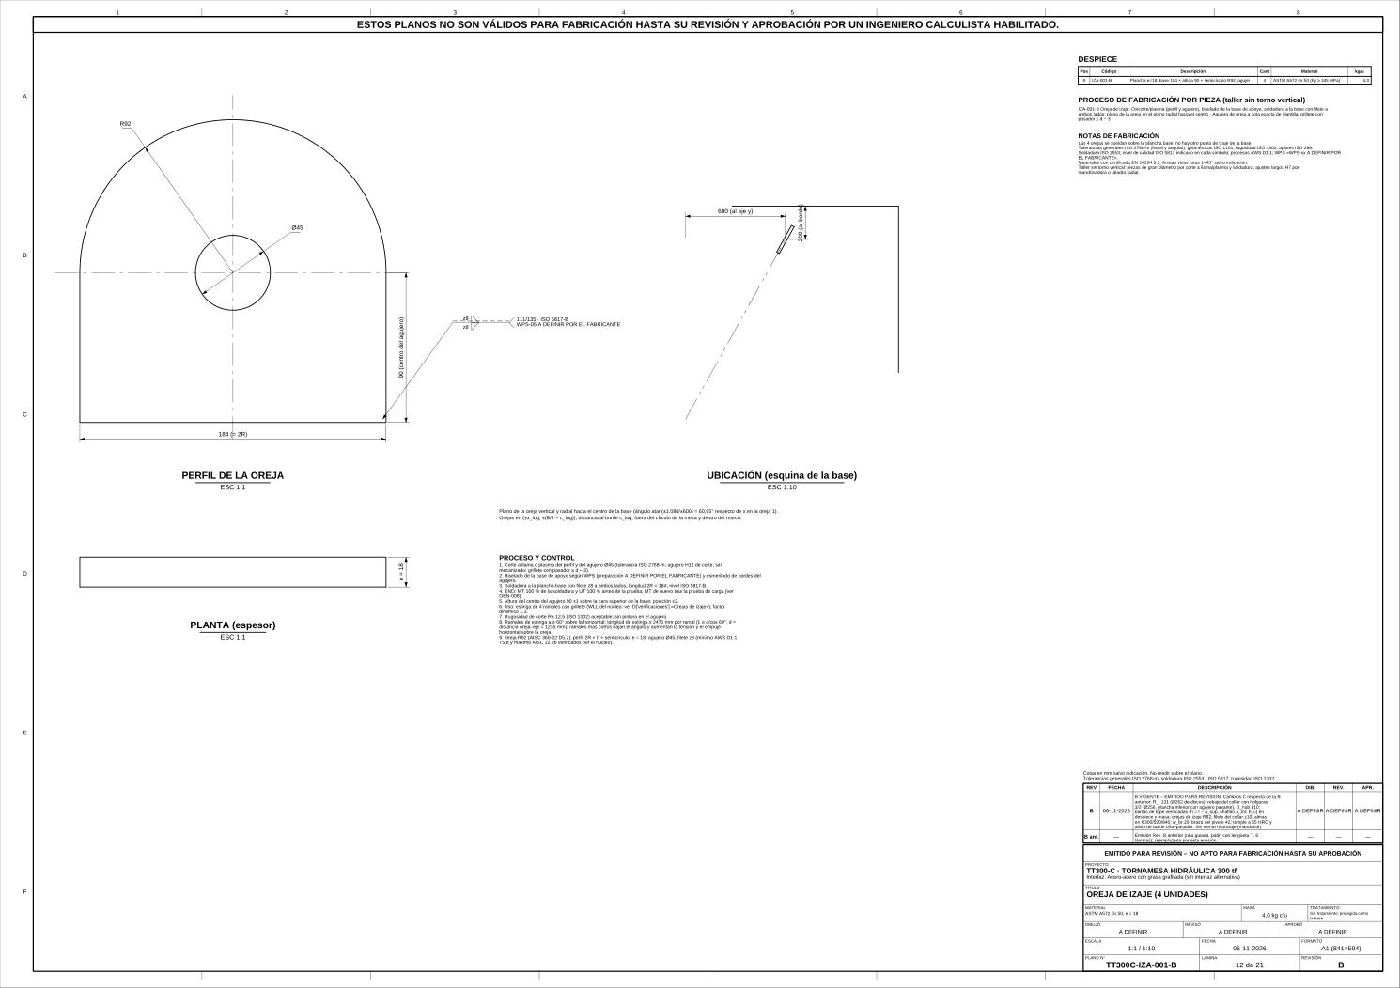
cad/out/default/png/TT300C-IZA-001-B.png
