mafiucivil/Tornamesa/cad/out/default/png/TT300C-MES-001-B.png

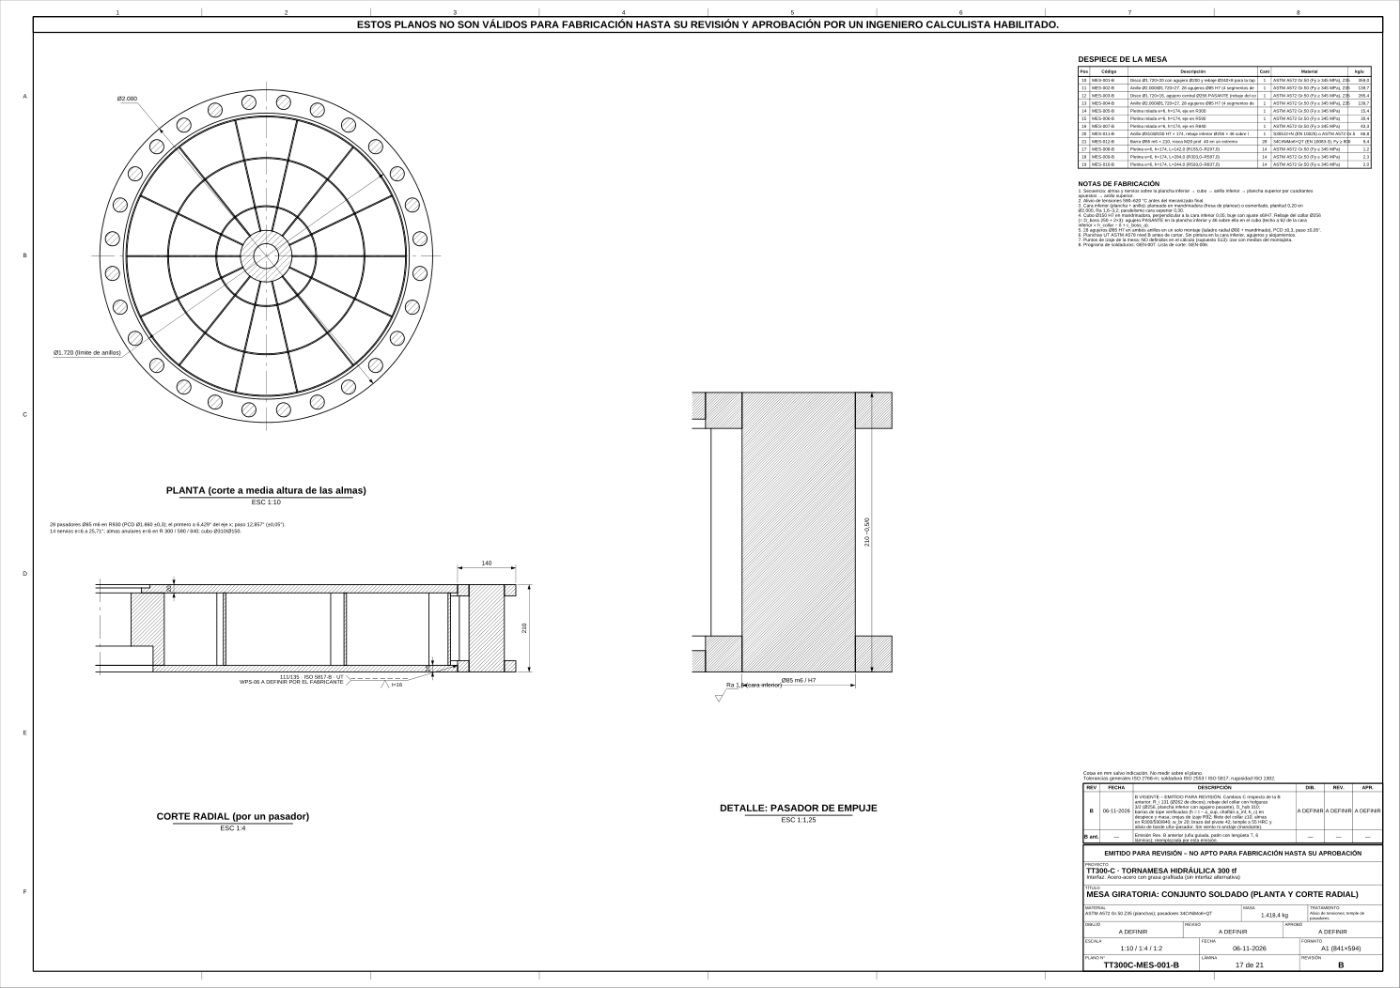
cad/out/default/png/TT300C-MES-001-B.png
