mafiucivil/Tornamesa/cad/out/default/png/TT300C-MES-002-B.png

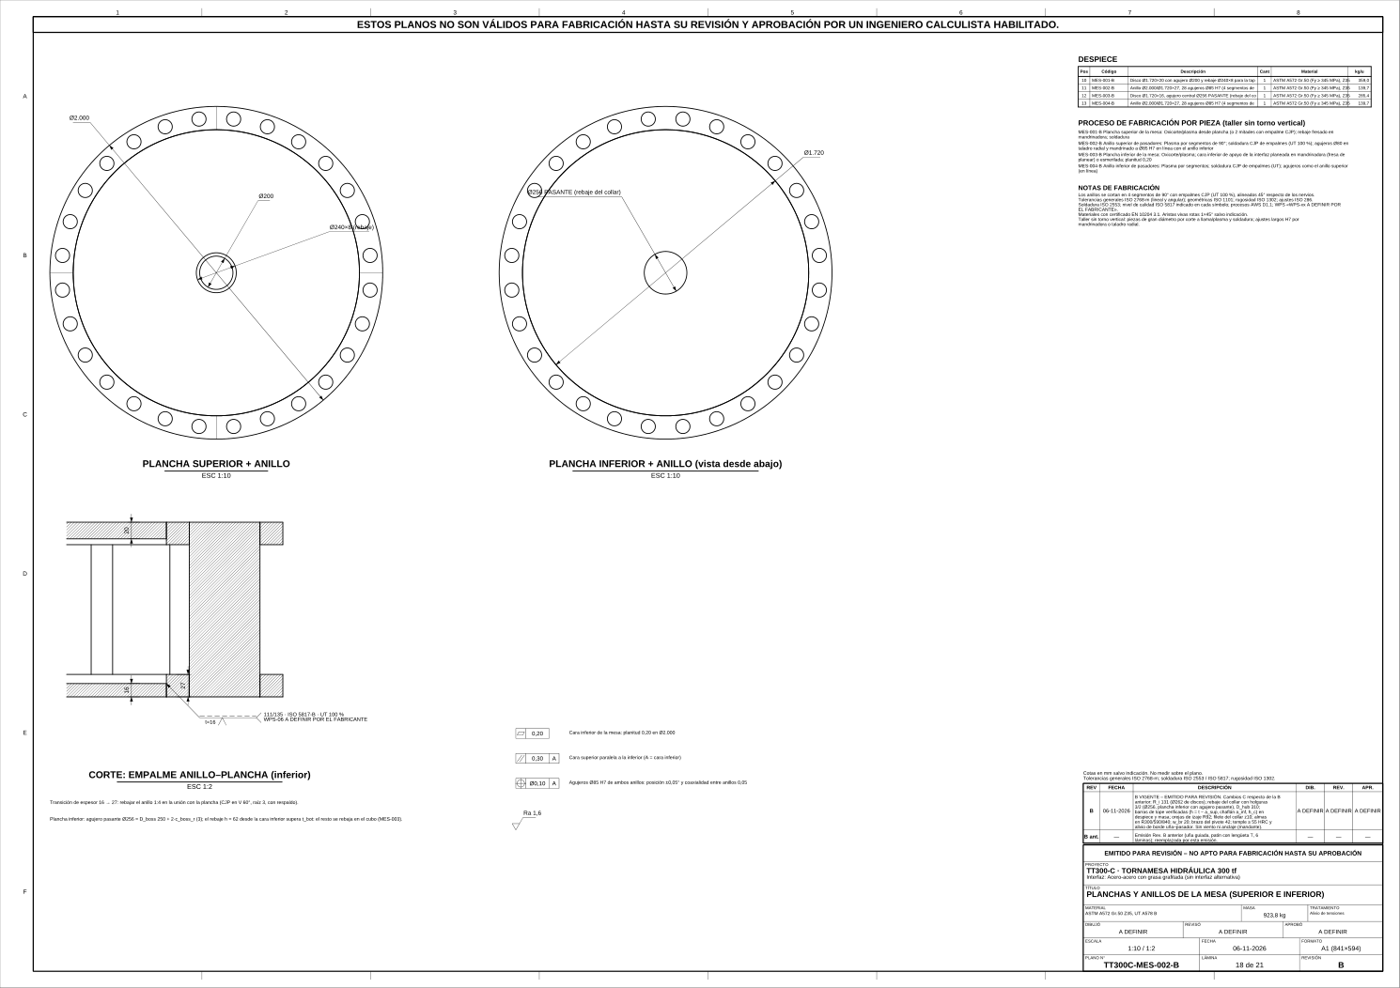
cad/out/default/png/TT300C-MES-002-B.png
