mafiucivil/Tornamesa/cad/out/default/png/TT300C-MES-003-B.png

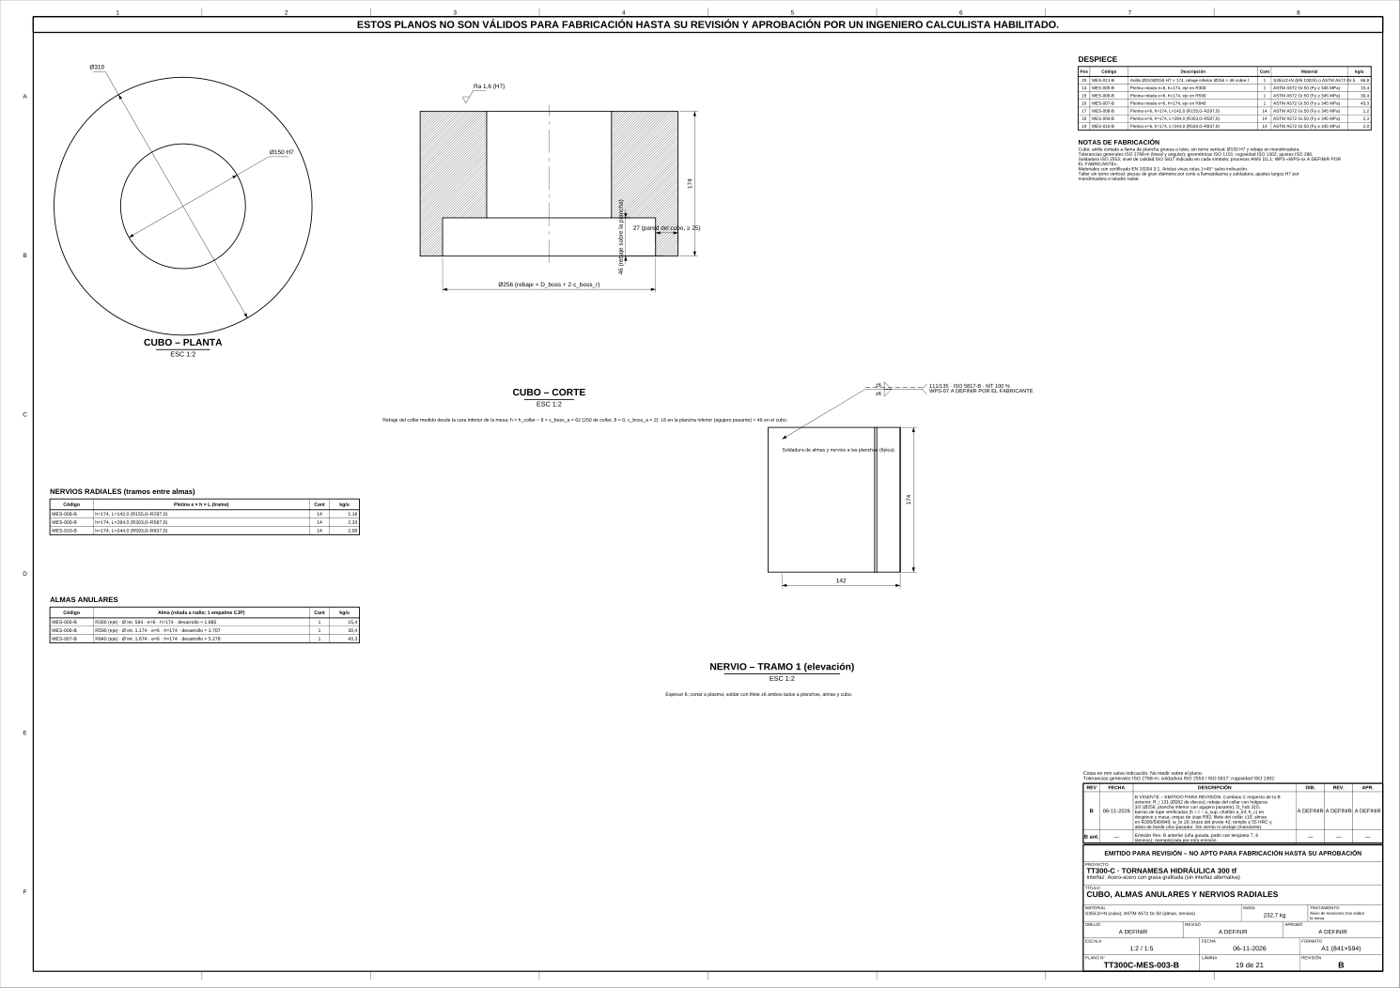
cad/out/default/png/TT300C-MES-003-B.png
