mafiucivil/Tornamesa/cad/out/default/png/TT300C-MES-004-B.png

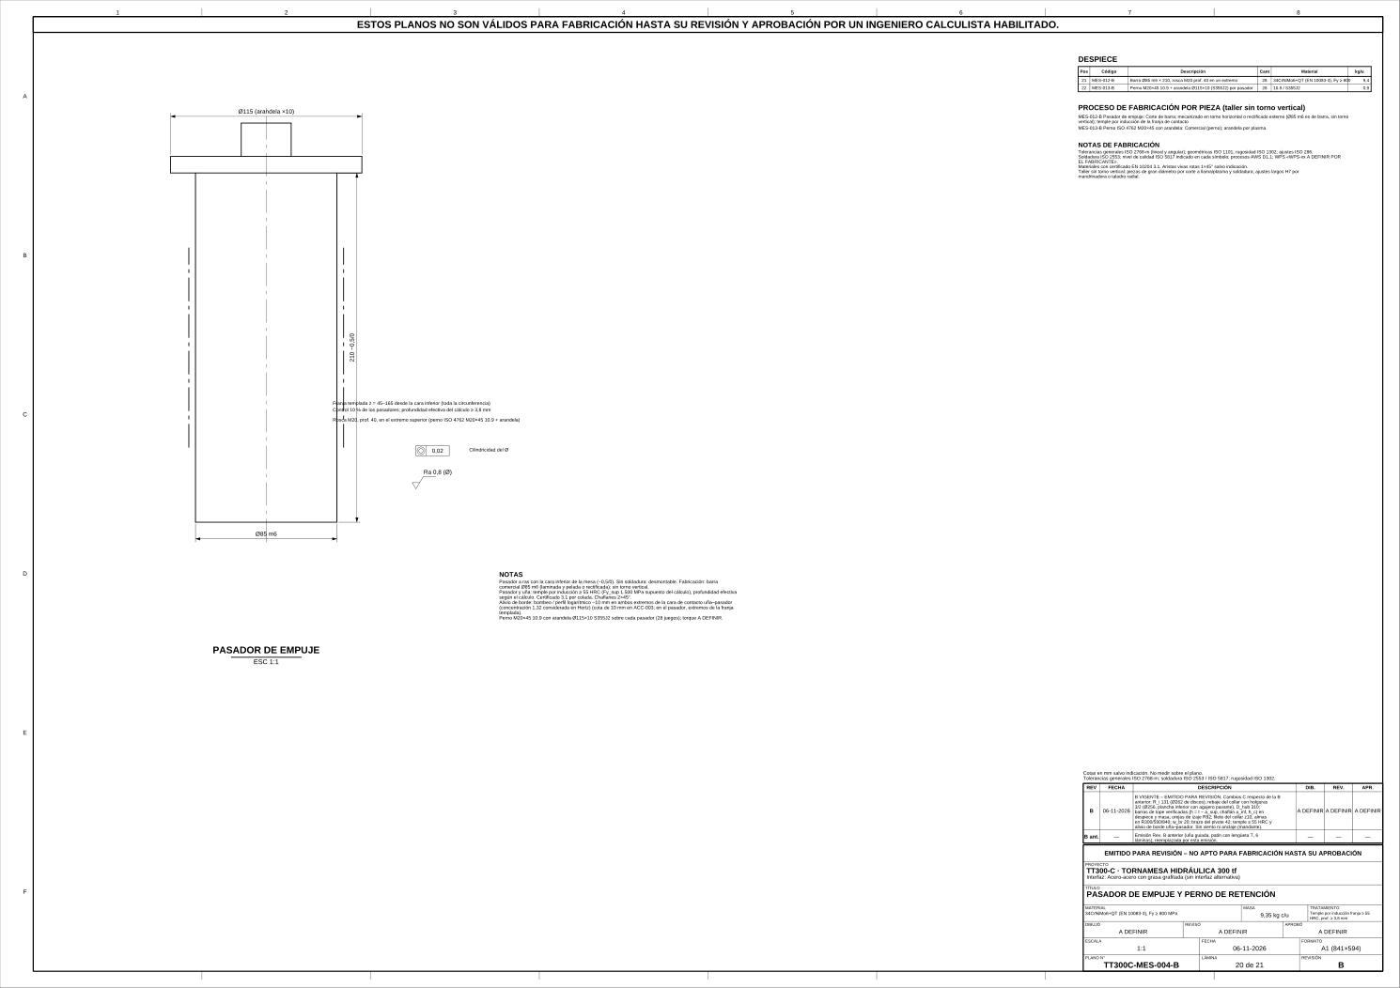
cad/out/default/png/TT300C-MES-004-B.png
