mafiucivil/Tornamesa/cad/out/default/png/TT300C-PIV-001-B.png

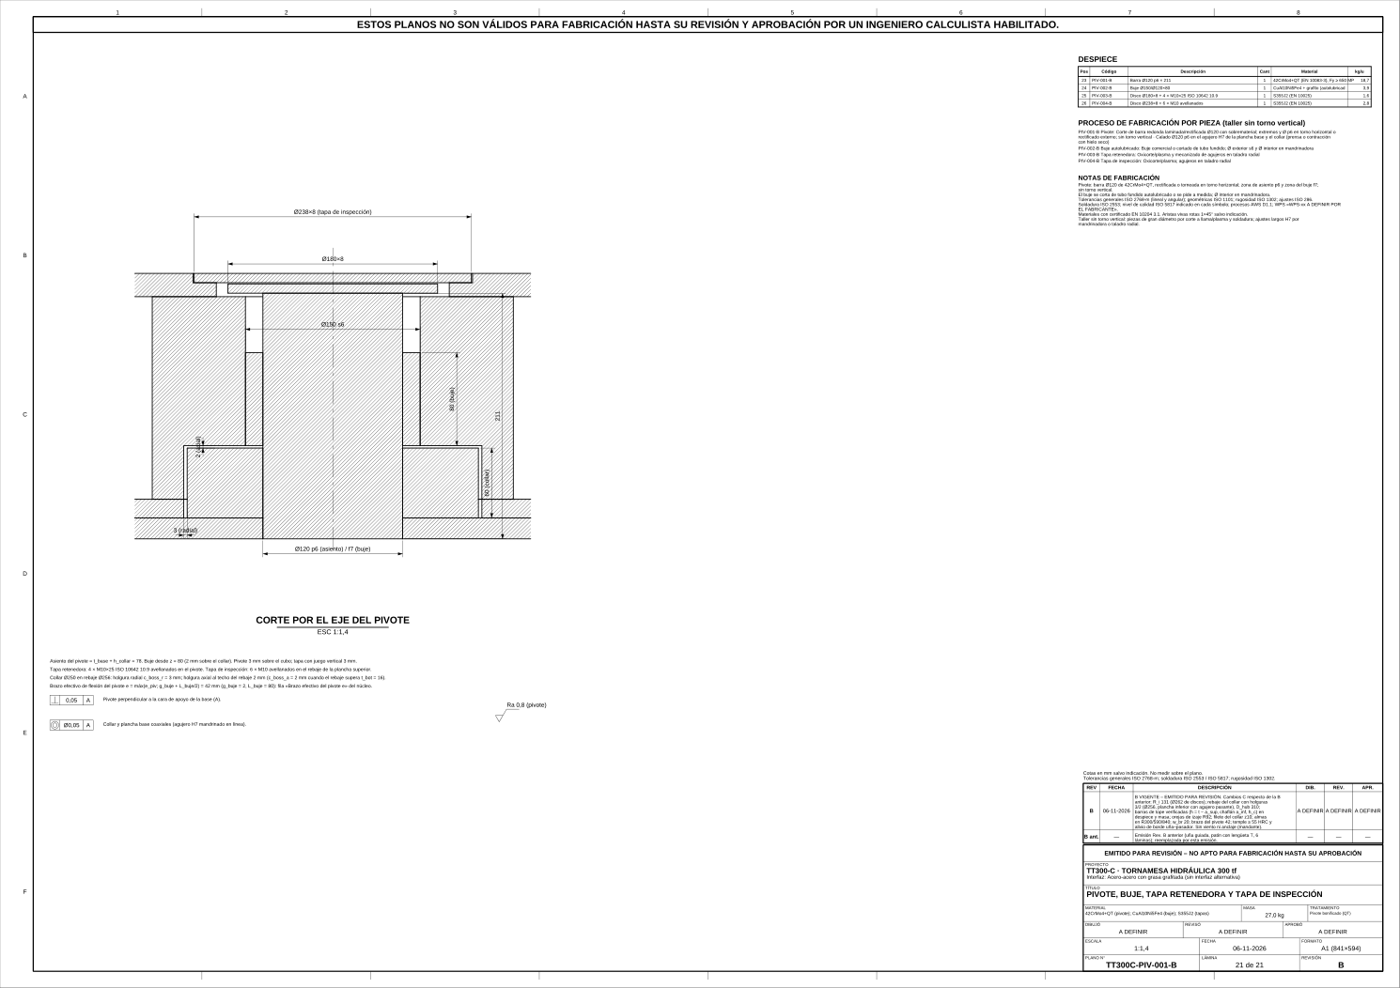
cad/out/default/png/TT300C-PIV-001-B.png
