mafiucivil/Tornamesa/cad/out/TT300-C_despiece.csv

Pos | Código | Descripción | Cantidad | Material / norma | Masa unitaria (kg) | Masa total (kg) | Proceso | Observación | Código de catálogo
1 | TT300C-BAS-001-B | Plancha base: Plancha 2.560×2.560×18, agujero central Ø120 H7 (mandrinado en línea con el collar) | 1 | ASTM A572 Gr.50 (Fy ≥ 345 MPa), Z35 (EN 10164), UT ASTM A578 nivel B | 924.426 | 924.43 | Oxicorte/plasma de la plancha, soldadura del conjunto, alivio de tensiones, mandrinado del agujero H7 en mandrinadora y planeado de la cara de apoyo de la interfaz | Planitud 0,2 mm en la zona Ø2.020 (cara de apoyo de la interfaz); sin pintura en esa zona;
2 | TT300C-BAS-002-B | Collar de asiento del pivote: Disco Ø250×60 con agujero Ø120 H7, soldado a la plancha base (filete perimetral 10) | 1 | ASTM A572 Gr.50 (Fy ≥ 345 MPa) | 17.793 | 17.79 | Oxicorte/plasma de disco desde plancha de 60 mm, soldadura a la base, mandrinado H7 en línea con la plancha base (mandrinadora) | Sin torno vertical: se corta a llama el disco y se mandrina el agujero; el diámetro exterior queda en bruto de corte (tolerancia ISO 2768-m);
3 | TT300C-BAS-003-B | Marco perimetral largo: Pletina 10×45×2.560 | 2 | ASTM A572 Gr.50 (Fy ≥ 345 MPa) | 9.043 | 18.09 | Corte a sierra/plasma; soldadura a la plancha base
4 | TT300C-BAS-004-B | Marco perimetral corto: Pletina 10×45×2.540 | 2 | ASTM A572 Gr.50 (Fy ≥ 345 MPa) | 8.973 | 17.95 | Corte a sierra/plasma; soldadura a la plancha base y a las largas
5 | TT300C-BAS-005-B | Mejilla de ménsula: Plancha 325×157×25 | 8 | ASTM A572 Gr.50 (Fy ≥ 345 MPa) | 10.014 | 80.11 | Plasma; soldadura a la base (filete 4 líneas por ménsula)
6 | TT300C-BAS-006-B | Oreja superior de ménsula: Plancha 150×175×25, agujero Ø70 H9 (mandrinado después de soldar) | 4 | ASTM A572 Gr.50 (Fy ≥ 345 MPa) | 4.396 | 17.59 | Plasma; soldadura a las mejillas; agujero H9 en línea en taladro radial/mandrinadora tras soldar
7 | TT300C-BAS-007-B | Oreja inferior (bloque) de ménsula: Plancha 150×175×78, agujero Ø70 H9 | 4 | ASTM A572 Gr.50 (Fy ≥ 345 MPa) | 13.716 | 54.87 | Plasma (o pletinas apiladas); soldadura a mejillas y base; agujero H9 en línea tras soldar
8 | TT300C-IZA-001-B | Oreja de izaje: Plancha e=18: base 184 × altura 90 + semicírculo R92, agujero Ø45 a 90 sobre la base | 4 | ASTM A572 Gr.50 (Fy ≥ 345 MPa) | 3.994 | 15.98 | Oxicorte/plasma (perfil y agujero), biselado de la base de apoyo, soldadura a la base con filete a ambos lados; plano de la oreja en el plano radial hacia el centro | Agujero de oreja a cota exacta de plantilla; grillete con pasador ≤ d − 3;
9 | TT300C-ACC-001-B | Bancada de guía con ranura T: Plancha 160×40×1.023; ranura T: cuello 40 H8 × 18, cabeza 64×10, fondo 12 | 2 | ASTM A572 Gr.50 (Fy ≥ 345 MPa) | 40.484 | 80.97 | Plasma/sierra; soldadura a la base; ranura T pasante fresada en mandrinadora o cepillo tras soldar y relevar; flancos Ra 1,6 | Ranura T pasante: el patín entra por el extremo;
10 | TT300C-MES-001-B | Plancha superior de la mesa: Disco Ø1.720×20 con agujero Ø200 y rebaje Ø240×8 para la tapa de inspección | 1 | ASTM A572 Gr.50 (Fy ≥ 345 MPa), Z35 (EN 10164), UT ASTM A578 nivel B | 358.993 | 358.99 | Oxicorte/plasma desde plancha (o 2 mitades con empalme CJP); rebaje fresado en mandrinadora; soldadura
11 | TT300C-MES-002-B | Anillo superior de pasadores: Anillo Ø2.000/Ø1.720×27, 28 agujeros Ø85 H7 (4 segmentos de 90°, empalmes CJP) | 1 | ASTM A572 Gr.50 (Fy ≥ 345 MPa), Z35 (EN 10164), UT ASTM A578 nivel B | 139.714 | 139.71 | Plasma por segmentos de 90°; soldadura CJP de empalmes (UT 100 %); agujeros Ø80 en taladro radial y mandrinado a Ø85 H7 en línea con el anillo inferior
12 | TT300C-MES-003-B | Plancha inferior de la mesa: Disco Ø1.720×16, agujero central Ø256 PASANTE (rebaje del collar: Ø250 + 2×3 de holgura radial) | 1 | ASTM A572 Gr.50 (Fy ≥ 345 MPa), Z35 (EN 10164), UT ASTM A578 nivel B | 285.369 | 285.37 | Oxicorte/plasma; cara inferior de apoyo de la interfaz planeada en mandrinadora (fresa de planear) o esmerilada; planitud 0,20
13 | TT300C-MES-004-B | Anillo inferior de pasadores: Anillo Ø2.000/Ø1.720×27, 28 agujeros Ø85 H7 (4 segmentos de 90°) | 1 | ASTM A572 Gr.50 (Fy ≥ 345 MPa), Z35 (EN 10164), UT ASTM A578 nivel B | 139.714 | 139.71 | Plasma por segmentos; soldadura CJP de empalmes (UT); agujeros como el anillo superior (en línea)
14 | TT300C-MES-005-B | Alma anular R300: Pletina rolada e=6, h=174, eje en R300 | 1 | ASTM A572 Gr.50 (Fy ≥ 345 MPa) | 15.448 | 15.45 | Corte de pletina a plasma; rolado a radio; 1 empalme CJP (UT) | Desarrollo ≈ 1.885 mm;
15 | TT300C-MES-006-B | Alma anular R590: Pletina rolada e=6, h=174, eje en R590 | 1 | ASTM A572 Gr.50 (Fy ≥ 345 MPa) | 30.381 | 30.38 | Corte de pletina a plasma; rolado a radio; 1 empalme CJP (UT) | Desarrollo ≈ 3.707 mm;
16 | TT300C-MES-007-B | Alma anular R840: Pletina rolada e=6, h=174, eje en R840 | 1 | ASTM A572 Gr.50 (Fy ≥ 345 MPa) | 43.254 | 43.25 | Corte de pletina a plasma; rolado a radio; 1 empalme CJP (UT) | Desarrollo ≈ 5.278 mm;
17 | TT300C-MES-008-B | Nervio radial, tramo 1: Pletina e=6, h=174, L=142,0 (R155,0–R297,0) | 14 | ASTM A572 Gr.50 (Fy ≥ 345 MPa) | 1.164 | 16.29 | Plasma (anidado en plancha)
18 | TT300C-MES-009-B | Nervio radial, tramo 2: Pletina e=6, h=174, L=284,0 (R303,0–R587,0) | 14 | ASTM A572 Gr.50 (Fy ≥ 345 MPa) | 2.327 | 32.58 | Plasma (anidado en plancha)
19 | TT300C-MES-010-B | Nervio radial, tramo 3: Pletina e=6, h=174, L=244,0 (R593,0–R837,0) | 14 | ASTM A572 Gr.50 (Fy ≥ 345 MPa) | 2.000 | 28.00 | Plasma (anidado en plancha)
20 | TT300C-MES-011-B | Cubo de la mesa: Anillo Ø310/Ø150 H7 × 174, rebaje inferior Ø256 × 46 sobre la plancha (h_rebaje 62 desde la cara inferior de la mesa) | 1 | S355J2+N (EN 10025) o ASTM A572 Gr.50 | 66.751 | 66.75 | Anillo cortado a llama de plancha gruesa o tubo; Ø150 H7 y rebaje en mandrinadora (sin torno vertical)
21 | TT300C-MES-012-B | Pasador de empuje: Barra Ø85 m6 × 210, rosca M20 prof. 40 en un extremo | 28 | 34CrNiMo6+QT (EN 10083-3), Fy ≥ 800 MPa | 9.354 | 261.92 | Corte de barra; mecanizado en torno horizontal o rectificado externo (Ø85 m6 es de barra, sin torno vertical); temple por inducción de la franja de contacto | Tratamiento: Temple por inducción ≥ 55 HRC (Fy_sup 1.500 MPa supuesto del cálculo), profundidad efectiva según el cálculo (≥ 3,8 mm)
22 | TT300C-MES-013-B | Perno ISO 4762 M20×45 con arandela: Perno M20×45 10.9 + arandela Ø115×10 (S355J2) por pasador | 28 | 10.9 / S355J2 | 0.926 | 25.94 | Comercial (perno); arandela por plasma |  | ISO 4762 M20×45 cl. 10.9 (código de catálogo: A DEFINIR POR CATÁLOGO)
23 | TT300C-PIV-001-B | Pivote: Barra Ø120 p6 × 211 | 1 | 42CrMo4+QT (EN 10083-3), Fy ≥ 650 MPa | 18.733 | 18.73 | Corte de barra redonda laminada/rectificada Ø120 con sobrematerial; extremos y Ø p6 en torno horizontal o rectificado externo; sin torno vertical | Calado Ø120 p6 en el agujero H7 de la plancha base y el collar (prensa o contracción con hielo seco); Tratamiento: Bonificado (QT)
24 | TT300C-PIV-002-B | Buje autolubricado: Buje Ø150/Ø120×80 | 1 | CuAl10Ni5Fe4 + grafito (autolubricado) | 3.868 | 3.87 | Buje comercial o cortado de tubo fundido; Ø exterior s6 y Ø interior en mandrinadora |  | A DEFINIR POR CATÁLOGO (buje autolubricado a medida)
25 | TT300C-PIV-003-B | Tapa retenedora: Disco Ø180×8 + 4 × M10×25 ISO 10642 10.9 | 1 | S355J2 (EN 10025) | 1.598 | 1.60 | Oxicorte/plasma y mecanizado de agujeros en taladro radial
26 | TT300C-PIV-004-B | Tapa de inspección: Disco Ø238×8 + 6 × M10 avellanados | 1 | S355J2 (EN 10025) | 2.794 | 2.79 | Oxicorte/plasma; agujeros en taladro radial
27 | TT300C-ACC-002-B | Cilindro hidráulico doble efecto: Ø90/Ø63, carrera 235, 10.000 psi (689 bar), ojales con rótula Ø70 | 2 | Comercial (acero; sellos) | 55.000 | 110.00 | Comercial |  | A DEFINIR POR CATÁLOGO (confirmar largo ojal-ojal L0 y geometría de extremos con el proveedor)
28 | TT300C-ACC-003-B | Patín guiado: Pieza única 572×245, lengüeta T (cuello 38 f7, cabeza 62×8), marco de boca e=80 | 2 | S460 (EN 10025-3) o 34CrNiMo6+QT, Fy ≥ 460 MPa | 126.847 | 253.69 | Bloque de plancha gruesa cortado a llama con sobremetal; fresado del alojamiento, lengüeta T y ojales en mandrinadora; taladros con radial; sin soldadura
29 | TT300C-ACC-004-B | Uña de empuje: Forja/bloque 198×88×110, cara de empuje plana templada, chaflán de retorno 54° (68,3×49,7) | 2 | 34CrNiMo6+QT (EN 10083-3), Re ≥ 900 MPa medido en la propia forja (3.1) | 13.607 | 27.21 | Corte de bloque forjado; fresado en mandrinadora/fresadora; rectificado de la cara templada | Tratamiento: Temple por inducción ≥ 55 HRC (Fy_sup 1.500 MPa supuesto del cálculo), profundidad efectiva según el cálculo (≥ 3,8 mm); alivio de borde 10 mm (k_borde 1,32)
30 | TT300C-ACC-005-B | Pasador del vástago (patín): Pasador Ø70 f8 × 136, placa de retención | 2 | 42CrMo4+QT (EN 10083-3), Fy ≥ 650 MPa | 4.109 | 8.22 | Barra rectificada Ø70 f8 (comercial), corte y chaflanes en torno horizontal | Tratamiento: Bonificado 28–34 HRC
31 | TT300C-ACC-006-B | Pasador del ojal trasero (ménsula): Pasador Ø70 f8 × 172, placa de retención | 2 | 42CrMo4+QT (EN 10083-3), Fy ≥ 650 MPa | 5.196 | 10.39 | Barra rectificada Ø70 f8 (comercial), corte y chaflanes en torno horizontal | Tratamiento: Bonificado 28–34 HRC
— | — | Resorte de retorno de la uña (compresión) | 2 | Comercial; carrera ≥ 73 mm, fuerza 150–300 N |  |  |  | No modelado | A DEFINIR POR CATÁLOGO
— | — | Tornillo ISO 10642 M10×25 cl. 10.9 (tapa retenedora) | 4 | 10.9 |  |  |  | No modelado | A DEFINIR POR CATÁLOGO
— | — | Tornillo avellanado M10 (tapa de inspección) | 6 | 10.9 |  |  |  | No modelado | A DEFINIR POR CATÁLOGO
— | — | Placa y tornillo de retención de pasador de articulación | 4 | S355J2 / 8.8 |  |  |  | No modelado | A DEFINIR POR CATÁLOGO
— | — | Grillete de izaje (pasador ≤ d_oreja − g_ear = 42 mm) | 4 | ASME B30.26, WLL ≥ requerido por el núcleo (verificación «Orejas de izaje») |  |  |  | No modelado | A DEFINIR POR CATÁLOGO
— | — | Faldón de sello perimetral (opcional) y fleje | 1 | NBR 70 / S235 galvanizado; dimensiones A DEFINIR |  |  |  | No modelado | A DEFINIR POR CATÁLOGO
— | — | Grasa grafitada NLGI 2 (≥ 10 % grafito, EP) | 1 | Cantidad A DEFINIR (llenado de ranuras y película de 0,3–0,5 mm por cara) |  |  |  | No modelado | A DEFINIR POR CATÁLOGO
— | — | Bomba, válvulas, mangueras y manómetro (circuito hidráulico) | 1 | Fuera de los planos mecánicos: ver especificación en TT300C-ACC-004-B |  |  |  | No modelado | A DEFINIR POR CATÁLOGO
MASA TOTAL (kg) |  |  |  |  |  | 3108.6
CENTRO DE GRAVEDAD x; y; z (mm) |  |  |  |  |  |  |  | 0.0; -0.0; 86.5
Comparable con el núcleo (kg) | 3D 3055.8 | núcleo 3057.8 | dif -2.0 kg | -0.07 % | tolerancia 0.5 %
