mafiucivil/Tornamesa/entregables/RevC/TT300-C_despiece.xlsx

Sheet: Despiece
Pos | Código | Descripción | Cantidad | Material / norma | Masa unitaria (kg) | Masa total (kg) | Proceso | Observación | Código de catálogo
1 | TT300C-BAS-001-C | Plancha base: Plancha 2.560×2.560×18, agujero central Ø120 H7 (mandrinado en línea con el collar) | 1 | ASTM A572 Gr.50 (Fy ≥ 345 MPa), Z35 (EN 10164), UT ASTM A578 nivel B | 924.426 | 924.43 | Oxicorte/plasma de la plancha, soldadura del conjunto, alivio de tensiones, mandrinado del agujero H7 en mandrinadora y planeado de la cara de apoyo de la interfaz | Planitud 0,2 mm en la zona Ø2.020 (cara de apoyo de la interfaz); sin pintura en esa zona;
2 | TT300C-BAS-002-C | Collar de asiento del pivote: Disco Ø250×60 con agujero Ø120 H7, soldado a la plancha base (filete perimetral 10) | 1 | ASTM A572 Gr.50 (Fy ≥ 345 MPa) | 17.793 | 17.79 | Oxicorte/plasma de disco desde plancha de 60 mm, soldadura a la base, mandrinado H7 en línea con la plancha base (mandrinadora) | Sin torno vertical: se corta a llama el disco y se mandrina el agujero; el diámetro exterior queda en bruto de corte (tolerancia ISO 2768-m);
3 | TT300C-BAS-003-C | Marco perimetral largo: Pletina 10×45×2.560 | 2 | ASTM A572 Gr.50 (Fy ≥ 345 MPa) | 9.043 | 18.09 | Corte a sierra/plasma; soldadura a la plancha base
4 | TT300C-BAS-004-C | Marco perimetral corto: Pletina 10×45×2.540 | 2 | ASTM A572 Gr.50 (Fy ≥ 345 MPa) | 8.973 | 17.95 | Corte a sierra/plasma; soldadura a la plancha base y a las largas
5 | TT300C-BAS-005-C | Mejilla de ménsula: Plancha 325×157×25 | 8 | ASTM A572 Gr.50 (Fy ≥ 345 MPa) | 10.014 | 80.11 | Plasma; soldadura a la base (filete 4 líneas por ménsula)
6 | TT300C-BAS-006-C | Oreja superior de ménsula: Plancha 150×175×25, agujero Ø70 H9 (mandrinado después de soldar) | 4 | ASTM A572 Gr.50 (Fy ≥ 345 MPa) | 4.396 | 17.59 | Plasma; soldadura a las mejillas; agujero H9 en línea en taladro radial/mandrinadora tras soldar
7 | TT300C-BAS-007-C | Oreja inferior (bloque) de ménsula: Plancha 150×175×78, agujero Ø70 H9 | 4 | ASTM A572 Gr.50 (Fy ≥ 345 MPa) | 13.716 | 54.87 | Plasma (o pletinas apiladas); soldadura a mejillas y base; agujero H9 en línea tras soldar
8 | TT300C-IZA-001-C | Oreja de izaje: Plancha e=18: base 184 × altura 90 + semicírculo R92, agujero Ø45 a 90 sobre la base | 4 | ASTM A572 Gr.50 (Fy ≥ 345 MPa) | 3.994 | 15.98 | Oxicorte/plasma (perfil y agujero), biselado de la base de apoyo, soldadura a la base con filete a ambos lados; plano de la oreja en el plano radial hacia el centro | Agujero de oreja a cota exacta de plantilla; grillete con pasador ≤ d − 3;
9 | TT300C-ACC-001-C | Bancada de guía con ranura T: Plancha 160×40×1.023; ranura T: cuello 40 H8 × 18, cabeza 64×10, fondo 12 | 2 | ASTM A572 Gr.50 (Fy ≥ 345 MPa) | 40.484 | 80.97 | Plasma/sierra; soldadura a la base; ranura T pasante fresada en mandrinadora o cepillo tras soldar y relevar; flancos Ra 1,6 | Ranura T pasante: el patín entra por el extremo;
10 | TT300C-MES-001-C | Plancha superior de la mesa: Disco Ø1.720×20 con agujero Ø200 y rebaje Ø240×8 para la tapa de inspección | 1 | ASTM A572 Gr.50 (Fy ≥ 345 MPa), Z35 (EN 10164), UT ASTM A578 nivel B | 358.966 | 358.97 | Oxicorte/plasma desde plancha (o 2 mitades con empalme CJP); rebaje fresado en mandrinadora; soldadura
11 | TT300C-MES-002-C | Anillo superior de pasadores: Anillo Ø2.000/Ø1.720×27, 28 agujeros Ø85 H7 (4 segmentos de 90°, empalmes CJP) | 1 | ASTM A572 Gr.50 (Fy ≥ 345 MPa), Z35 (EN 10164), UT ASTM A578 nivel B | 139.714 | 139.71 | Plasma por segmentos de 90°; soldadura CJP de empalmes (UT 100 %); agujeros Ø80 en taladro radial y mandrinado a Ø85 H7 en línea con el anillo inferior
12 | TT300C-MES-003-C | Plancha inferior de la mesa: Disco Ø1.720×16, agujero central Ø256 PASANTE (rebaje del collar: Ø250 + 2×3 de holgura radial) | 1 | ASTM A572 Gr.50 (Fy ≥ 345 MPa), Z35 (EN 10164), UT ASTM A578 nivel B | 285.369 | 285.37 | Oxicorte/plasma; cara inferior de apoyo de la interfaz planeada en mandrinadora (fresa de planear) o esmerilada; planitud 0,20
13 | TT300C-MES-004-C | Anillo inferior de pasadores: Anillo Ø2.000/Ø1.720×27, 28 agujeros Ø85 H7 (4 segmentos de 90°) | 1 | ASTM A572 Gr.50 (Fy ≥ 345 MPa), Z35 (EN 10164), UT ASTM A578 nivel B | 139.714 | 139.71 | Plasma por segmentos; soldadura CJP de empalmes (UT); agujeros como el anillo superior (en línea)
14 | TT300C-MES-005-C | Alma anular R300: Pletina rolada e=6, h=174, eje en R300 | 1 | ASTM A572 Gr.50 (Fy ≥ 345 MPa) | 15.448 | 15.45 | Corte de pletina a plasma; rolado a radio; 1 empalme CJP (UT) | Desarrollo ≈ 1.885 mm;
15 | TT300C-MES-006-C | Alma anular R590: Pletina rolada e=6, h=174, eje en R590 | 1 | ASTM A572 Gr.50 (Fy ≥ 345 MPa) | 30.381 | 30.38 | Corte de pletina a plasma; rolado a radio; 1 empalme CJP (UT) | Desarrollo ≈ 3.707 mm;
16 | TT300C-MES-007-C | Alma anular R840: Pletina rolada e=6, h=174, eje en R840 | 1 | ASTM A572 Gr.50 (Fy ≥ 345 MPa) | 43.254 | 43.25 | Corte de pletina a plasma; rolado a radio; 1 empalme CJP (UT) | Desarrollo ≈ 5.278 mm;
17 | TT300C-MES-008-C | Nervio radial, tramo 1: Pletina e=6, h=174, L=142,0 (R155,0–R297,0) | 14 | ASTM A572 Gr.50 (Fy ≥ 345 MPa) | 1.164 | 16.29 | Plasma (anidado en plancha)
18 | TT300C-MES-009-C | Nervio radial, tramo 2: Pletina e=6, h=174, L=284,0 (R303,0–R587,0) | 14 | ASTM A572 Gr.50 (Fy ≥ 345 MPa) | 2.327 | 32.58 | Plasma (anidado en plancha)
19 | TT300C-MES-010-C | Nervio radial, tramo 3: Pletina e=6, h=174, L=244,0 (R593,0–R837,0) | 14 | ASTM A572 Gr.50 (Fy ≥ 345 MPa) | 2 | 28 | Plasma (anidado en plancha)
20 | TT300C-MES-011-C | Cubo de la mesa: Anillo Ø310/Ø150 H7 × 174, rebaje inferior Ø256 × 46 sobre la plancha (fondo del rebaje a 62 mm de la cara inferior de la mesa) | 1 | ASTM A572 Gr.50 (Fy ≥ 345 MPa) | 66.751 | 66.75 | Anillo cortado a llama de plancha gruesa o tubo; Ø150 H7 y rebaje en mandrinadora (sin torno vertical)
21 | TT300C-MES-012-C | Pasador de empuje: Barra Ø85 m6 × 210, rosca M20 prof. 40 en un extremo | 28 | 34CrNiMo6+QT (EN 10083-3), Fy ≥ 800 MPa | 9.346 | 261.69 | Corte de barra; mecanizado en torno horizontal o rectificado externo (Ø85 m6 es de barra, sin torno vertical); temple por inducción de la franja de contacto | Tratamiento: Temple por inducción ≥ 55 HRC (límite elástico superficial supuesto en el cálculo: 1.500 MPa), profundidad efectiva según el cálculo (≥ 3,8 mm)
22 | TT300C-MES-013-C | Perno ISO 4762 M20×45 con arandela: Perno M20×45 10.9 + arandela Ø115×10 (S355J2) por pasador | 28 | Perno ISO 898-1 cl. 10.9 / arandela ASTM A572 Gr.50 (Fy ≥ 345 MPa) | 0.926 | 25.94 | Comercial (perno); arandela por plasma |  | ISO 4762 M20×45 cl. 10.9 (código de catálogo: A DEFINIR POR CATÁLOGO)
23 | TT300C-PIV-001-C | Pivote: Barra Ø120 p6 × 211, chaflanes 3×45° | 1 | 34CrNiMo6+QT (EN 10083-3), Re ≥ 700 MPa (Ø/e 120 mm) — PROPUESTO por Fy ≥ 650 MPa del cálculo; confirmar | 18.671 | 18.67 | Corte de barra redonda laminada/rectificada Ø120 con sobrematerial; extremos y Ø p6 en torno horizontal o rectificado externo; sin torno vertical | Calado Ø120 p6 en el agujero H7 de la plancha base y el collar (prensa o contracción con hielo seco); Tratamiento: Bonificado (QT)
24 | TT300C-PIV-002-C | Buje autolubricado: Buje Ø150/Ø120×80 | 1 | Buje autolubricado: bronce con lubricante sólido (presión ≤ 30 MPa, μ ≤ 0,2 según el cálculo); marca/modelo por catálogo (GEN-008) | 3.868 | 3.87 | Buje comercial o cortado de tubo fundido; Ø exterior s6 y Ø interior en mandrinadora |  | A DEFINIR POR CATÁLOGO (buje autolubricado a medida)
25 | TT300C-PIV-003-C | Tapa retenedora: Disco Ø180×8 + 4 × M10×25 ISO 10642 10.9 | 1 | ASTM A572 Gr.50 (Fy ≥ 345 MPa) | 1.574 | 1.57 | Oxicorte/plasma y mecanizado de agujeros en taladro radial
26 | TT300C-PIV-004-C | Tapa de inspección: Disco Ø238×8 + 6 × M10 avellanados | 1 | ASTM A572 Gr.50 (Fy ≥ 345 MPa) | 2.758 | 2.76 | Oxicorte/plasma; agujeros en taladro radial
27 | TT300C-ACC-002-C | Cilindro hidráulico doble efecto: Ø90/Ø63, carrera 235, 10.000 psi (689 bar), ojales con rótula Ø70 | 2 | Comercial (acero; sellos) | 55 | 110 | Comercial |  | A DEFINIR POR CATÁLOGO (confirmar el largo ojal–ojal retraído y la geometría de extremos con el proveedor)
28 | TT300C-ACC-003-C | Patín guiado: Pieza única 572×245, lengüeta T (cuello 38 f7, cabeza 62×8), marco de boca e=80 | 2 | 42CrMo4+QT (EN 10083-3), Re ≥ 550 MPa (Ø/e 129 mm) — PROPUESTO por Fy ≥ 460 MPa del cálculo; confirmar | 126.847 | 253.69 | Bloque de plancha gruesa cortado a llama con sobremetal; fresado del alojamiento, lengüeta T y ojales en mandrinadora; taladros con radial; sin soldadura
29 | TT300C-ACC-004-C | Uña de empuje: Forja/bloque 198×88×110, cara de empuje plana templada, chaflán de retorno 54° (68,3×49,7) | 2 | 34CrNiMo6+QT (EN 10083-3), Re ≥ 800 MPa medido en la propia forja (3.1) | 13.607 | 27.21 | Corte de bloque forjado; fresado en mandrinadora/fresadora; rectificado de la cara templada | Tratamiento: Temple por inducción ≥ 55 HRC (límite elástico superficial supuesto en el cálculo: 1.500 MPa), profundidad efectiva según el cálculo (≥ 3,8 mm); alivio de borde 10 mm (factor de concentración de borde 1,32 considerado en el cálculo)
30 | TT300C-ACC-005-C | Pasador del vástago (patín): Pasador Ø70 f8 × 136, placa de retención | 2 | 42CrMo4+QT (EN 10083-3), Re ≥ 650 MPa (Ø/e 70 mm) — PROPUESTO por Fy ≥ 650 MPa del cálculo; confirmar | 4.102 | 8.2 | Barra rectificada Ø70 f8 (comercial), corte y chaflanes en torno horizontal | Tratamiento: Bonificado 28–34 HRC
31 | TT300C-ACC-006-C | Pasador del ojal trasero (ménsula): Pasador Ø70 f8 × 172, placa de retención | 2 | 42CrMo4+QT (EN 10083-3), Re ≥ 650 MPa (Ø/e 70 mm) — PROPUESTO por Fy ≥ 650 MPa del cálculo; confirmar | 5.189 | 10.38 | Barra rectificada Ø70 f8 (comercial), corte y chaflanes en torno horizontal | Tratamiento: Bonificado 28–34 HRC
— | — | Resorte de retorno de la uña (compresión) | 2 | Comercial; carrera ≥ 73 mm, fuerza 150–300 N |  |  |  | No modelado | A DEFINIR POR CATÁLOGO
— | — | Tornillo ISO 10642 M10×25 cl. 10.9 (tapa retenedora) | 4 | 10.9 |  |  |  | No modelado | A DEFINIR POR CATÁLOGO
— | — | Tornillo avellanado M10 (tapa de inspección) | 6 | 10.9 |  |  |  | No modelado | A DEFINIR POR CATÁLOGO
— | — | Placa y tornillo de retención de pasador de articulación | 4 | S355J2 / 8.8 |  |  |  | No modelado | A DEFINIR POR CATÁLOGO
— | — | Grillete de izaje (pasador de Ø ≤ 42 mm) | 4 | ASME B30.26, WLL ≥ requerido por el núcleo (verificación «Orejas de izaje») |  |  |  | No modelado | A DEFINIR POR CATÁLOGO
— | — | Faldón de sello perimetral (opcional) y fleje | 1 | NBR 70 / S235 galvanizado; dimensiones por el proveedor (opcional) |  |  |  | No modelado | A DEFINIR POR CATÁLOGO
— | — | Grasa grafitada NLGI 2 (≥ 10 % grafito, EP) | 1 | Cantidad: llenado de ranuras + película de 0,3–0,5 mm por cara |  |  |  | No modelado | A DEFINIR POR CATÁLOGO
— | — | Bomba, válvulas, mangueras y manómetro (circuito hidráulico) | 1 | Fuera de los planos mecánicos: ver especificación en TT300C-ACC-002-C |  |  |  | No modelado | A DEFINIR POR CATÁLOGO
MASA TOTAL (kg) |  |  |  |  |  | 3108.2
CENTRO DE GRAVEDAD x; y; z (mm) |  |  |  |  |  |  |  | 0.0; -0.0; 86.5

Sheet: Masas
Grupo | Masa 3D (kg) | Núcleo (kg) | Diferencia (kg) | Diferencia (%)
Plancha base + collar + orejas de izaje | 958.19 | 958.19 | 0 | 0
Marco perimetral | 36.03 | 36.03 | 0 | 0
Ménsulas de cilindro | 152.56 | 152.56 | 0 | 0
Bancadas de guía | 80.97 | 80.97 | 0 | 0
Mesa (planchas, almas, nervios, cubo, pasadores) | 1418.16 | 1419.63 | -1.47 | -0.1
Pivote | 18.67 | 18.73 | -0.06 | -0.33
Cilindros (masa de catálogo) | 110 | 110 | 0 | 0
Patines | 253.69 | 254.48 | -0.79 | -0.31
Uñas | 27.21 | 27.21 | 0 | 0
TOTAL comparable | 3055.49 | 3057.81 | -2.32 | -0.08
Piezas fuera del núcleo | 52.72
MASA TOTAL del ensamble | 3108.21
CG x (mm) | 0
CG y (mm) | 0
CG z (mm) | 86.5

Sheet: Corte
Pos | Pieza | Forma | Dimensión bruta (mm) | Cant | Material | Observación
BAS-001-C | Plancha base | Plancha | 2.570×2.570×18 | 1 | ASTM A572 Gr.50 (Fy ≥ 345 MPa), Z35 (EN 1016 | Sobremetal 5 por borde; planitud/planeado tras soldar
BAS-002-C | Collar de asiento del pivote | Disco | Ø260×65 | 1 | ASTM A572 Gr.50 (Fy ≥ 345 MPa) | Plancha gruesa; agujero tras soldar
BAS-003-C | Marco perimetral largo | Pletina | 10×45×2.560 | 2 | ASTM A572 Gr.50 (Fy ≥ 345 MPa)
BAS-004-C | Marco perimetral corto | Pletina | 10×45×2.540 | 2 | ASTM A572 Gr.50 (Fy ≥ 345 MPa)
BAS-005-C | Mejilla de ménsula | Plancha | 325×162×25 | 8 | ASTM A572 Gr.50 (Fy ≥ 345 MPa)
BAS-006-C | Oreja superior de ménsula | Plancha | 149×180×25 | 4 | ASTM A572 Gr.50 (Fy ≥ 345 MPa) | Agujero tras soldar
BAS-007-C | Oreja inferior (bloque) de ménsula | Plancha | 149×180×80 | 4 | ASTM A572 Gr.50 (Fy ≥ 345 MPa) | Agujero tras soldar
IZA-001-C | Oreja de izaje | Plancha | 194×192×18 | 4 | ASTM A572 Gr.50 (Fy ≥ 345 MPa) | Plasma/oxicorte con agujero
ACC-001-C | Bancada de guía con ranura T | Plancha | 170×45×1.033 | 2 | ASTM A572 Gr.50 (Fy ≥ 345 MPa) | Ranura T tras soldar
MES-001-C | Plancha superior de la mesa | Disco | Ø1.725×20 | 1 | ASTM A572 Gr.50 (Fy ≥ 345 MPa), Z35 (EN 1016 | Plasma; rebaje tras soldar
MES-002-C | Anillo superior de pasadores | Segm. de anillo 90° | Ø2.010/Ø1.710×30 | 4 | ASTM A572 Gr.50 (Fy ≥ 345 MPa), Z35 (EN 1016 | Empalmes CJP
MES-003-C | Plancha inferior de la mesa | Disco | Ø1.725×19 | 1 | ASTM A572 Gr.50 (Fy ≥ 345 MPa), Z35 (EN 1016 | Cara de giro planeada; agujero pasante Ø256 (rebaje del collar)
MES-004-C | Anillo inferior de pasadores | Segm. de anillo 90° | Ø2.010/Ø1.710×30 | 4 | ASTM A572 Gr.50 (Fy ≥ 345 MPa), Z35 (EN 1016 | Empalmes CJP
MES-005-C | Alma anular R300 | Pletina rolada | 174×6×1.905 | 1 | ASTM A572 Gr.50 (Fy ≥ 345 MPa) | R300; 1 empalme CJP
MES-006-C | Alma anular R590 | Pletina rolada | 174×6×3.727 | 1 | ASTM A572 Gr.50 (Fy ≥ 345 MPa) | R590; 1 empalme CJP
MES-007-C | Alma anular R840 | Pletina rolada | 174×6×5.298 | 1 | ASTM A572 Gr.50 (Fy ≥ 345 MPa) | R840; 1 empalme CJP
MES-008-C | Nervio radial, tramo 1 | Pletina | 174×6×594 | 14 | ASTM A572 Gr.50 (Fy ≥ 345 MPa) | L=142,0 (R155,0–R297,0)
MES-009-C | Nervio radial, tramo 2 | Pletina | 174×6×1174 | 14 | ASTM A572 Gr.50 (Fy ≥ 345 MPa) | L=284,0 (R303,0–R587,0)
MES-010-C | Nervio radial, tramo 3 | Pletina | 174×6×1674 | 14 | ASTM A572 Gr.50 (Fy ≥ 345 MPa) | L=244,0 (R593,0–R837,0)
MES-011-C | Cubo de la mesa | Anillo | Ø320/Ø140×179 | 1 | ASTM A572 Gr.50 (Fy ≥ 345 MPa)
MES-012-C | Pasador de empuje | Barra | Ø90×216 | 28 | 34CrNiMo6+QT (EN 10083-3), Fy ≥ 800 MPa
PIV-001-C | Pivote | Barra | Ø125×217 | 1 | 34CrNiMo6+QT (EN 10083-3), Re ≥ 700 MPa (Ø/e
PIV-002-C | Buje autolubricado | Tubo/buje | Ø154/Ø116×84 | 1 | Buje autolubricado: bronce con lubricante só
PIV-003-C | Tapa retenedora | Disco | Ø185×10 | 1 | ASTM A572 Gr.50 (Fy ≥ 345 MPa)
PIV-004-C | Tapa de inspección | Disco | Ø243×10 | 1 | ASTM A572 Gr.50 (Fy ≥ 345 MPa)
ACC-003-C | Patín guiado | Bloque | 582×290×167 | 2 | 42CrMo4+QT (EN 10083-3), Re ≥ 550 MPa (Ø/e 1 | Una pieza
ACC-004-C | Uña de empuje | Forja/bloque | 208×98×120 | 2 | 34CrNiMo6+QT (EN 10083-3), Re ≥ 800 MPa medi | Cara de empuje templada
ACC-005-C | Pasador del vástago (patín) | Barra | Ø75×146 | 2 | 42CrMo4+QT (EN 10083-3), Re ≥ 650 MPa (Ø/e 7
ACC-006-C | Pasador del ojal trasero (ménsula) | Barra | Ø75×182 | 2 | 42CrMo4+QT (EN 10083-3), Re ≥ 650 MPa (Ø/e 7

Sheet: Soldaduras
Id | Juntas | Tipo | Tamaño | Origen | Proceso | Calidad ISO 5817 | END | WPS
J01 | Marco perimetral largo – plancha base | Filete en T, ambos lados, continuo | z6 (a = 4.2) | mínimo AWS D1.1 Tabla 5.8 por la parte más gruesa (t = 18 mm), a confirmar | 135 | ISO 5817-C | VT 100 % · MT 10 % | WPS-P01 — PROPUESTA — A CALIFICAR/CONFIRMAR POR EL FABRICANTE (AWS D1.1 cl. 3/4)
J02 | Marco corto – plancha base | Filete en T, ambos lados, continuo | z6 (a = 4.2) | mínimo AWS D1.1 Tabla 5.8 por la parte más gruesa (t = 18 mm), a confirmar | 135 | ISO 5817-C | VT 100 % · MT 10 % | WPS-P01 — PROPUESTA — A CALIFICAR/CONFIRMAR POR EL FABRICANTE (AWS D1.1 cl. 3/4)
J03 | Marco largo – marco corto (esquinas) | Filete de esquina exterior, continuo (4 esquinas) | z5 (a = 3.5) | mínimo AWS D1.1 Tabla 5.8 por la parte más gruesa (t = 10 mm), a confirmar | 135 | ISO 5817-C | VT 100 % · MT 10 % | WPS-P01 — PROPUESTA — A CALIFICAR/CONFIRMAR POR EL FABRICANTE (AWS D1.1 cl. 3/4)
J04 | Mejillas de ménsula – plancha base | Filete en T, ambos lados de cada mejilla | z20 (a = 14.1) | calculado (memoria, soldadura mejillas–base); mín. AWS D1.1 Tabla 5.8 = 8, máx. AISC 360-22 J2.2b = t − 2 = 23 mm | 135 | ISO 5817-B | VT 100 % · MT 100 % | WPS-P02 — PROPUESTA — A CALIFICAR/CONFIRMAR POR EL FABRICANTE (AWS D1.1 cl. 3/4)
J05 | Oreja superior – mejillas de ménsula | Filete en T, 2 caras de la oreja contra cada mejilla | z8 (a = 5.7) | mínimo AWS D1.1 Tabla 5.8 por la parte más gruesa (t = 25 mm), a confirmar | 135 | ISO 5817-B | VT 100 % · MT 100 % | WPS-P02 — PROPUESTA — A CALIFICAR/CONFIRMAR POR EL FABRICANTE (AWS D1.1 cl. 3/4)
J06 | Oreja inferior (bloque) – mejillas de ménsula | Filete en T, ambos lados, cara superior del bloque | z8 (a = 5.7) | mínimo AWS D1.1 Tabla 5.8 por la parte más gruesa (t = 25 mm), a confirmar | 135 | ISO 5817-B | VT 100 % · MT 100 % | WPS-P02 — PROPUESTA — A CALIFICAR/CONFIRMAR POR EL FABRICANTE (AWS D1.1 cl. 3/4)
J07 | Oreja inferior (bloque) – plancha base | Filete perimetral del bloque | z8 (a = 5.7) | mínimo AWS D1.1 Tabla 5.8 por la parte más gruesa (t = 25 mm), a confirmar | 135 | ISO 5817-B | VT 100 % · MT 100 % | WPS-P02 — PROPUESTA — A CALIFICAR/CONFIRMAR POR EL FABRICANTE (AWS D1.1 cl. 3/4)
J08 | Bancada – plancha base | Filete en T, ambos lados, continuo, precalentar 65 °C | z10 (a = 7.1) | calculado (memoria, soldadura bancada–base) | 135 | ISO 5817-B | VT 100 % · MT 100 % | WPS-P03 — PROPUESTA — A CALIFICAR/CONFIRMAR POR EL FABRICANTE (AWS D1.1 cl. 3/4)
J09 | Collar del pivote – plancha base | Filete perimetral continuo | z10 (a = 7.1) | calculado (memoria, collar del pivote); mín. AWS D1.1 Tabla 5.8 = 8 | 135 | ISO 5817-B | VT 100 % · MT 100 % · UT de la unión | WPS-P04 — PROPUESTA — A CALIFICAR/CONFIRMAR POR EL FABRICANTE (AWS D1.1 cl. 3/4)
J10 | Orejas de izaje – plancha base | Filete en T, ambos lados, L = 2R; base biselada | z8 (a = 5.7) | calculado (memoria, orejas de izaje); mín. AWS D1.1 Tabla 5.8 = 6 | 135 | ISO 5817-B | VT 100 % · MT 100 % · UT 100 % | WPS-P05 — PROPUESTA — A CALIFICAR/CONFIRMAR POR EL FABRICANTE (AWS D1.1 cl. 3/4)
J11 | Empalmes de los anillos de pasadores (4 × 90°, superior e inferior) | A tope en V 60°, raíz 3, con respaldo. V 60°, abertura de raíz 3 mm, cara de raíz 2 mm, respaldo de acero | s27 | CJP (penetración completa); t de la parte más delgada | 135 | ISO 5817-B | VT 100 % · UT 100 % | WPS-P06 — PROPUESTA — A CALIFICAR/CONFIRMAR POR EL FABRICANTE (AWS D1.1 cl. 3/4)
J12 | Plancha superior – anillo superior | A tope circunferencial, transición de espesores 1:4. V 60°, raíz 3 mm, respaldo; chaflán 1:4 en el lado de la plancha más gruesa | s20 | CJP (penetración completa); t de la parte más delgada | 135 | ISO 5817-B | VT 100 % · UT 100 % | WPS-P06 — PROPUESTA — A CALIFICAR/CONFIRMAR POR EL FABRICANTE (AWS D1.1 cl. 3/4)
J13 | Plancha inferior – anillo inferior | A tope circunferencial, transición de espesores 1:4. V 60°, raíz 3 mm, respaldo; chaflán 1:4 en el lado de la plancha más gruesa | s16 | CJP (penetración completa); t de la parte más delgada | 135 | ISO 5817-B | VT 100 % · UT 100 % | WPS-P06 — PROPUESTA — A CALIFICAR/CONFIRMAR POR EL FABRICANTE (AWS D1.1 cl. 3/4)
J14 | Almas anulares – planchas inferior y superior | Filete en T, ambos lados, continuo (4 líneas por alma) | z6 (a = 4.2) | calculado (memoria, soldadura de almas y nervios) (supera el máx. AISC 360-22 J2.2b = t − 2 = 4 mm: pendiente del calculista (GEN-009)) | 135 | ISO 5817-B | VT 100 % · MT 100 % | WPS-P07 — PROPUESTA — A CALIFICAR/CONFIRMAR POR EL FABRICANTE (AWS D1.1 cl. 3/4)
J15 | Nervios radiales – planchas y almas | Filete en T, ambos lados, continuo | z6 (a = 4.2) | calculado (memoria, soldadura de almas y nervios) | 135 | ISO 5817-B | VT 100 % · MT 100 % | WPS-P07 — PROPUESTA — A CALIFICAR/CONFIRMAR POR EL FABRICANTE (AWS D1.1 cl. 3/4)
J16 | Empalme de cada alma anular | A tope en V 60° (1 por alma). V 60°, raíz 2 mm, con respaldo | s6 | CJP (penetración completa); t de la parte más delgada | 135 | ISO 5817-B | VT 100 % · UT 100 % | WPS-P06 — PROPUESTA — A CALIFICAR/CONFIRMAR POR EL FABRICANTE (AWS D1.1 cl. 3/4)
J17 | Cubo – planchas inferior y superior | Bisel 45° con respaldo (penetración completa). Bisel 45°, raíz 2 mm, respaldo | s16 | CJP (penetración completa); t de la parte más delgada | 135 | ISO 5817-B | VT 100 % · UT 100 % | WPS-P06 — PROPUESTA — A CALIFICAR/CONFIRMAR POR EL FABRICANTE (AWS D1.1 cl. 3/4)
J18 | Cierre de la plancha superior (soldadura de ranura sobre almas y nervios) | Ranura 22×80 c/250, relleno completo. Ranura rectangular 22×80 pasante, relleno completo | s20 | CJP (penetración completa); t de la parte más delgada | 135 | ISO 5817-C | VT 100 % · MT 100 % | WPS-P07 — PROPUESTA — A CALIFICAR/CONFIRMAR POR EL FABRICANTE (AWS D1.1 cl. 3/4)

Sheet: Supuestos y brechas
Id | Tema | Valor / descripción | Motivo / decisión
S15 | Atornillado de las tapas del pivote | Tapa retenedora: 4 × M10 (ISO 10642) en PCD Ø80 a 45°+90°·k, roscados prof. 20 en el pivote; tapa de inspección: 6 × M10 en PCD Ø220 a 30°+60°·k, roscados prof. 10 en el fondo del rebaje (PROPUESTA) | El cálculo no define el patrón de tornillos de las tapas; se propone uno geométricamente compatible (confirmar).
S13 | Izaje de la mesa | No se dibujan puntos de izaje de la mesa (A DEFINIR) | El cálculo solo define las 4 orejas de izaje de la base (espesor, radio y agujero: parámetros t_ear, R_ear, d_ear); la mesa debe izarse con medios definidos por el montajista.
S14 | Retención axial del pivote | Ajuste H7/p6 sin soldadura ni tope inferior (A DEFINIR) | El cálculo verifica asiento y flexión pero no la extracción axial del pivote.
B-01 | Izaje de la mesa | El cálculo solo define las 4 orejas de la base; no hay puntos de izaje de la mesa (los cáncamos M30 de la Rev. B anterior sobre plancha de 20 mm no engranan la profundidad exigible). | A DEFINIR: orejas o cáncamos verificados para la mesa.
B-02 | Retención axial del pivote | El núcleo verifica asiento y flexión, no la extracción axial del pivote (ajuste p6/H7 sin soldadura). | A DEFINIR: tope inferior, anillo o interferencia verificada.
B-03 | Torque de pernos y tornillos | El núcleo no entrega torques (pernos M20×45 de pasadores, M10 de tapas, tornillos de posición). | Torques PROPUESTOS en GEN-008 (ISO 898-1, VDI 2230 simplificado): A CONFIRMAR POR EL CALCULISTA.
B-04 | Tamaño de soldaduras sin parámetro | Marco, esquinas y orejas de ménsula no tienen tamaño en P; se adopta el mínimo AWS D1.1 T5.8 por la parte más gruesa. Sí son parámetro (y el núcleo verifica mínimo y máximo): w_collar, w_ear, w_tope, w_br, w_web, w_bed_f. | CONFIRMAR o parametrizar tamaños y END de las soldaduras sin parámetro.
B-05 | Filetes máximos AISC J2.2b de almas y nervios | Almas y nervios de la mesa: w_web = 6 sobre t = 6 superan el máximo de borde t − 2 = 4 mm que aplica el núcleo (AISC J2.2b) salvo que el cateto se justifique como built-up (el cordón no queda en el borde del alma). Nota para el calculista: la cláusula J2.2b literal permite w = t para bordes de t < 6,35 mm (aquí 6 mm); el criterio t − 2 es el conservador del núcleo. El núcleo exige el mínimo (fila «Filete mínimo almas/nervios–planchas», 6 mm) pero no tiene fila de máximo para esta unión. | PENDIENTE DEL CALCULISTA: concluir si el cateto z6 se acepta como built-up o se reduce a z4 (con verificación de la soldadura alma/nervio–plancha del núcleo) / se espesa el alma.
B-06 | Advertencia del núcleo aceptada: flexión de la uña en la boca del patín | «Flexión en la boca del patín (voladizo) con fricción radial»: FU 0,907 (demanda 242 / capacidad 266,7 MPa) con Fy_dog = 800 MPa (34CrNiMo6+QT, EN 10083-3, 40 < t ≤ 100 mm) y Nd = 3,0 (ASME BTH-1 §3-2.3). | ACEPTADA POR EL MANDANTE el 07-11-2026 como advertencia (FU ≤ 1,0; se relaja solo para esta fila el criterio interno FU ≤ 0,90). Dejar registro en la aprobación.
B-07 | Diferencias de fórmula del patín | La masa del patín del núcleo difiere del modelo (alojamiento abierto por la cara superior y cuello de la lengüeta): −0,3 % en la pieza. | Informativo (dentro de tolerancia).
B-08 | Cilindro comercial | Largo ojal–ojal L0 = 520 mm y masa 55 kg son supuestos del núcleo; el modelo 3D usa la geometría de extremos del núcleo. | Confirmar con el proveedor del cilindro.
