mafiucivil/Tornamesa/cad/out/default/TT300-C.step

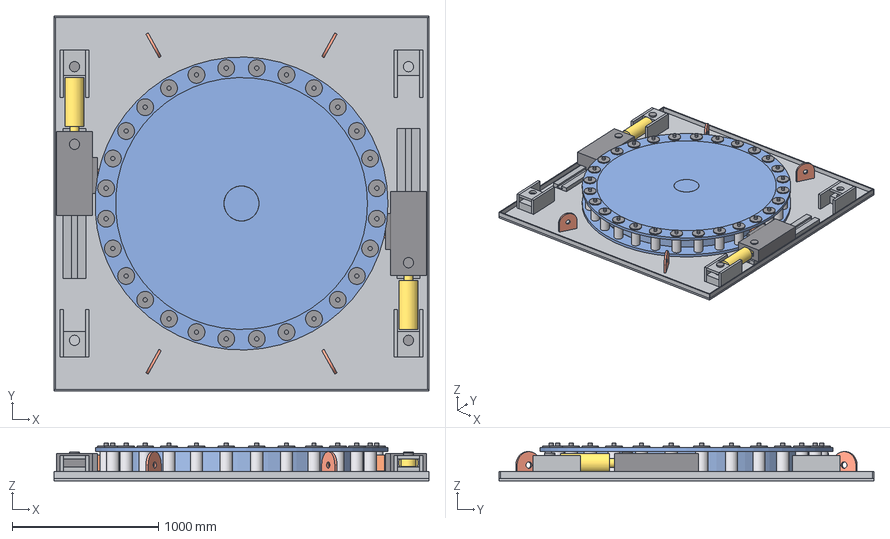
[picture p22: CAD file, 2026-11-07]
cad/out/default/TT300-C.step
2560.0 x 2560.0 x 258.0 mm
TT300C-BAS-001-B Plancha base
TT300C-BAS-002-B Collar de asiento del pivote
TT300C-BAS-003-B Marco perimetral largo
TT300C-BAS-004-B Marco perimetral corto
TT300C-BAS-005-B Mejilla de mÃ©nsula
TT300C-BAS-006-B Oreja superior de mÃ©nsula
TT300C-BAS-007-B Oreja inferior (bloque) de mÃ©nsula
TT300C-IZA-001-B Oreja de izaje
TT300C-ACC-001-B Bancada de guÃa con ranura T
TT300C-MES-001-B Plancha superior de la mesa
TT300C-MES-002-B Anillo superior de pasadores
TT300C-MES-003-B Plancha inferior de la mesa
TT300C-MES-004-B Anillo inferior de pasadores
TT300C-MES-005-B Alma anular R300
TT300C-MES-006-B Alma anular R590
TT300C-MES-007-B Alma anular R840
TT300C-MES-008-B Nervio radial, tramo 1
TT300C-MES-009-B Nervio radial, tramo 2
TT300C-MES-010-B Nervio radial, tramo 3
TT300C-MES-011-B Cubo de la mesa
TT300C-MES-012-B Pasador de empuje
TT300C-MES-013-B Perno ISO 4762 M20Ã45 con arandela
TT300C-PIV-001-B Pivote
TT300C-PIV-002-B Buje autolubricado
TT300C-PIV-003-B Tapa retenedora
TT300C-PIV-004-B Tapa de inspecciÃ³n
TT300C-ACC-002-B Cilindro hidrÃ¡ulico doble efecto
TT300C-ACC-003-B PatÃn guiado
TT300C-ACC-004-B UÃ±a de empuje
TT300C-ACC-005-B Pasador del vÃ¡stago (patÃn)
TT300C-ACC-006-B Pasador del ojal trasero (mÃ©nsula)
