mafiucivil/Tornamesa/entregables/RevC/variantes/C3/TT300-C.step

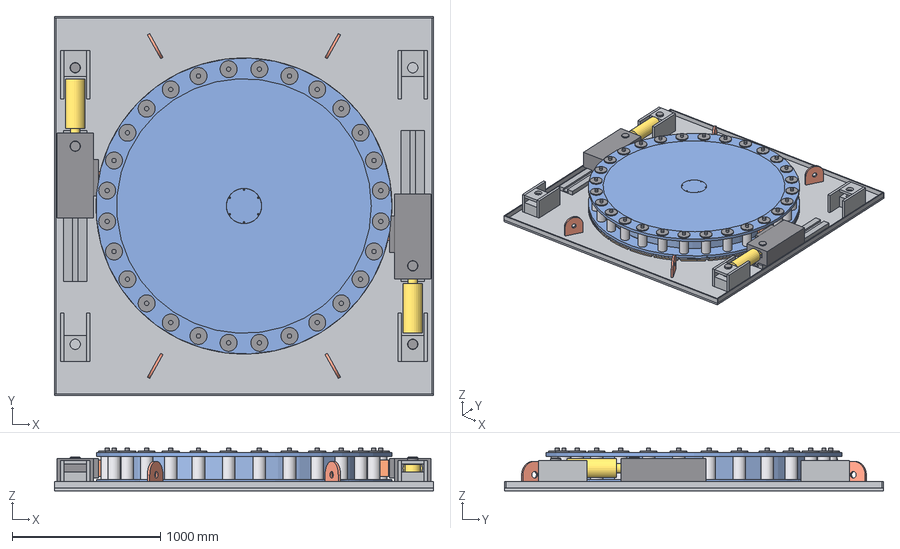
[picture p27: CAD file, 2026-11-07]
entregables/RevC/variantes/C3/TT300-C.step
2560.0 x 2560.0 x 288.0 mm
TT300C-BAS-001-C Plancha base
TT300C-BAS-002-C Collar de asiento del pivote
TT300C-BAS-003-C Marco perimetral largo
TT300C-BAS-004-C Marco perimetral corto
TT300C-BAS-005-C Mejilla de mÃ©nsula
TT300C-BAS-006-C Oreja superior de mÃ©nsula
TT300C-BAS-007-C Oreja inferior (bloque) de mÃ©nsula
TT300C-IZA-001-C Oreja de izaje
TT300C-ACC-001-C Bancada de guÃa con ranura T
TT300C-MES-001-C Plancha superior de la mesa
TT300C-MES-002-C Anillo superior de pasadores
TT300C-MES-003-C Plancha inferior de la mesa
TT300C-MES-004-C Anillo inferior de pasadores
TT300C-MES-005-C Alma anular R300
TT300C-MES-006-C Alma anular R590
TT300C-MES-007-C Alma anular R840
TT300C-MES-008-C Nervio radial, tramo 1
TT300C-MES-009-C Nervio radial, tramo 2
TT300C-MES-010-C Nervio radial, tramo 3
TT300C-MES-011-C Cubo de la mesa
TT300C-MES-012-C Pasador de empuje
TT300C-MES-013-C Perno ISO 4762 M20Ã45 con arandela
TT300C-PIV-001-C Pivote
TT300C-PIV-002-C Buje autolubricado
TT300C-PIV-003-C Tapa retenedora
TT300C-PIV-004-C Tapa de inspecciÃ³n
TT300C-ACC-002-C Cilindro hidrÃ¡ulico doble efecto
TT300C-ACC-003-C PatÃn guiado
TT300C-ACC-004-C UÃ±a de empuje
TT300C-ACC-005-C Pasador del vÃ¡stago (patÃn)
TT300C-ACC-006-C Pasador del ojal trasero (mÃ©nsula)
TT300C-INT-001-C Pastilla de bronce con tapones de grafito
TT300C-INT-002-C TapÃ³n de grafito
TT300C-INT-003-C Disco duro (sector)
TT300C-INT-004-C Barra de tope (placa de bronce)
TT300C-INT-005-C Barra de tope (disco duro / 2.Âª placa)
TT300C-INT-006-C Tornillo avellanado de posiciÃ³n M6Ã25
TT300C-INT-007-C Tornillo avellanado de posiciÃ³n M6Ã25
TT300C-INT-008-C Grasera recta M10Ã1
