mafiucivil/Tornamesa/entregables/RevC/planos/TT300C-GEN-004-C.dxf

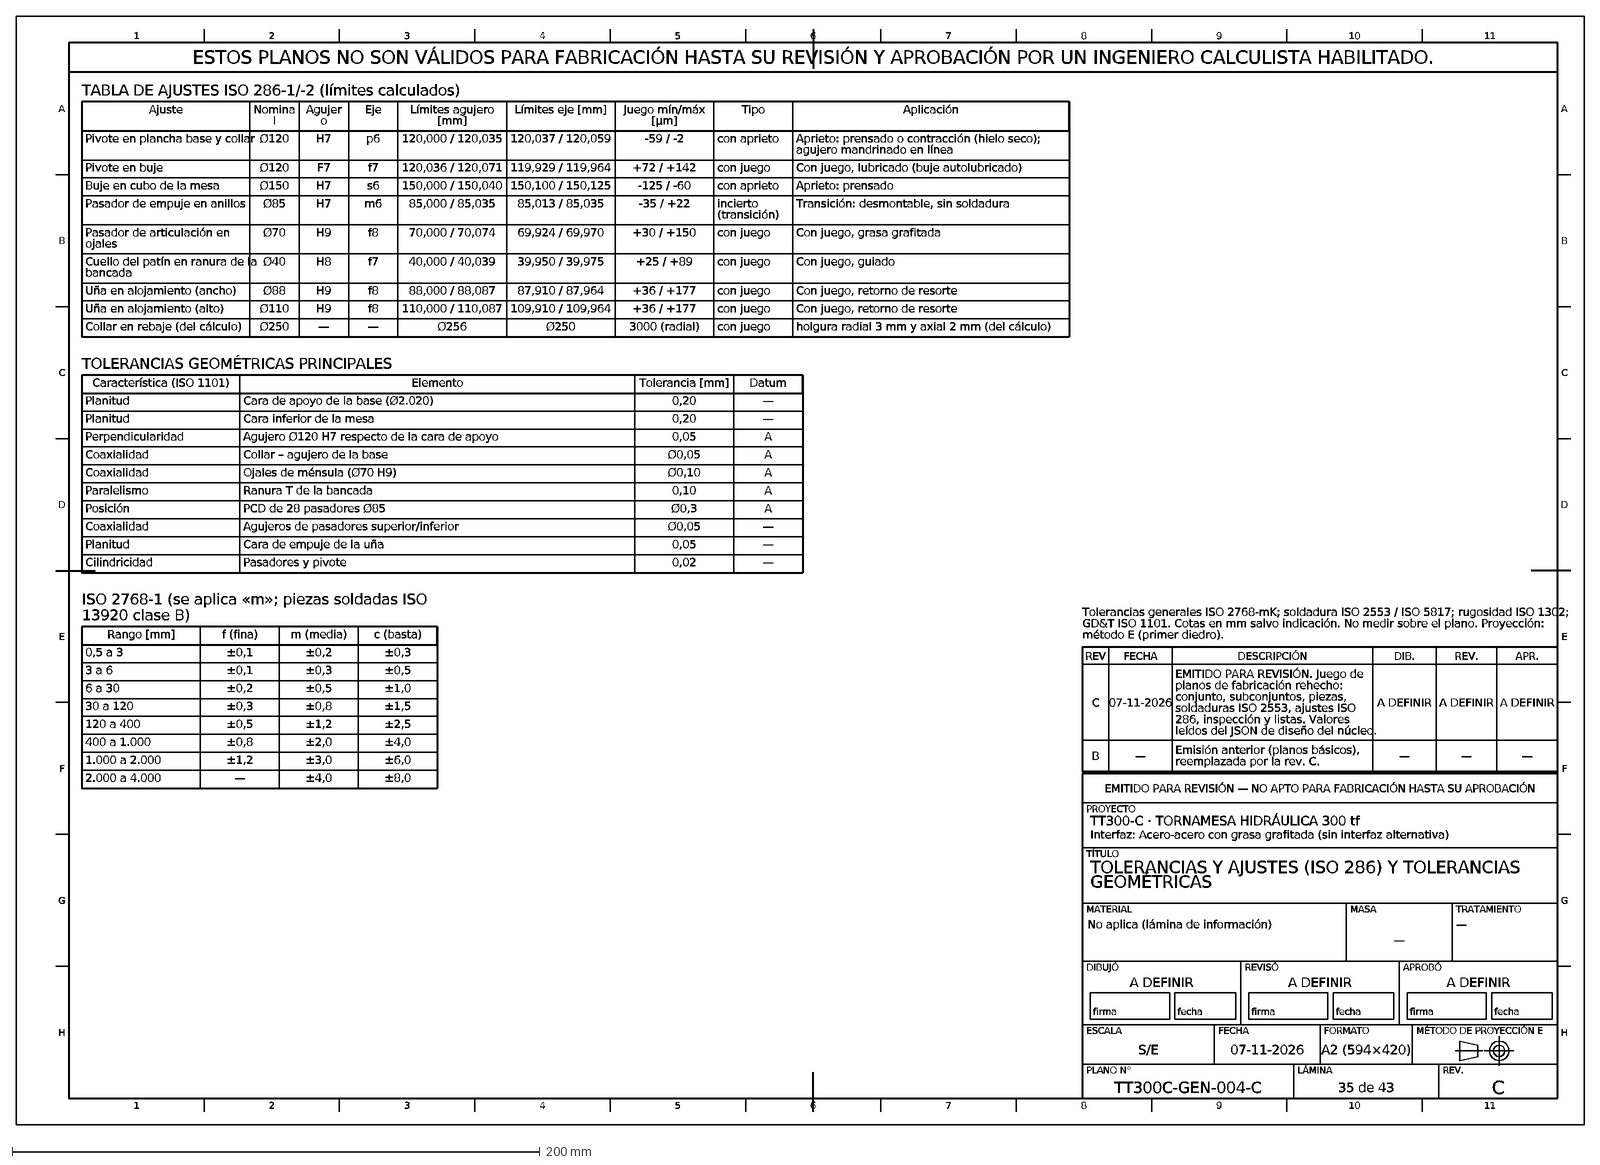
[picture p29: CAD file, 2026-11-07]
entregables/RevC/planos/TT300C-GEN-004-C.dxf
TABLA DE AJUSTES ISO 286-1/-2 (límites calculados)
Ajuste
Nomina
l
Agujer
o
Eje
Límites agujero
[mm]
Límites eje [mm]
Juego mín/máx
[µm]
Tipo
Aplicación
Pivote en plancha base y collar
Ø120
H7
p6
120,000 / 120,035
120,037 / 120,059
-59 / -2
con aprieto
Aprieto: prensado o contracción (hielo seco);
agujero mandrinado en línea
Pivote en buje
F7
f7
120,036 / 120,071
119,929 / 119,964
+72 / +142
con juego
Con juego, lubricado (buje autolubricado)
Buje en cubo de la mesa
Ø150
s6
150,000 / 150,040
150,100 / 150,125
-125 / -60
Aprieto: prensado
Pasador de empuje en anillos
Ø85
m6
85,000 / 85,035
85,013 / 85,035
-35 / +22
incierto
(transición)
Transición: desmontable, sin soldadura
Pasador de articulación en
ojales
Ø70
H9
f8
70,000 / 70,074
69,924 / 69,970
+30 / +150
Con juego, grasa grafitada
Cuello del patín en ranura de la
bancada
Ø40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
