mafiucivil/Tornamesa/entregables/RevC/planos/TT300C-GEN-011-C.dxf

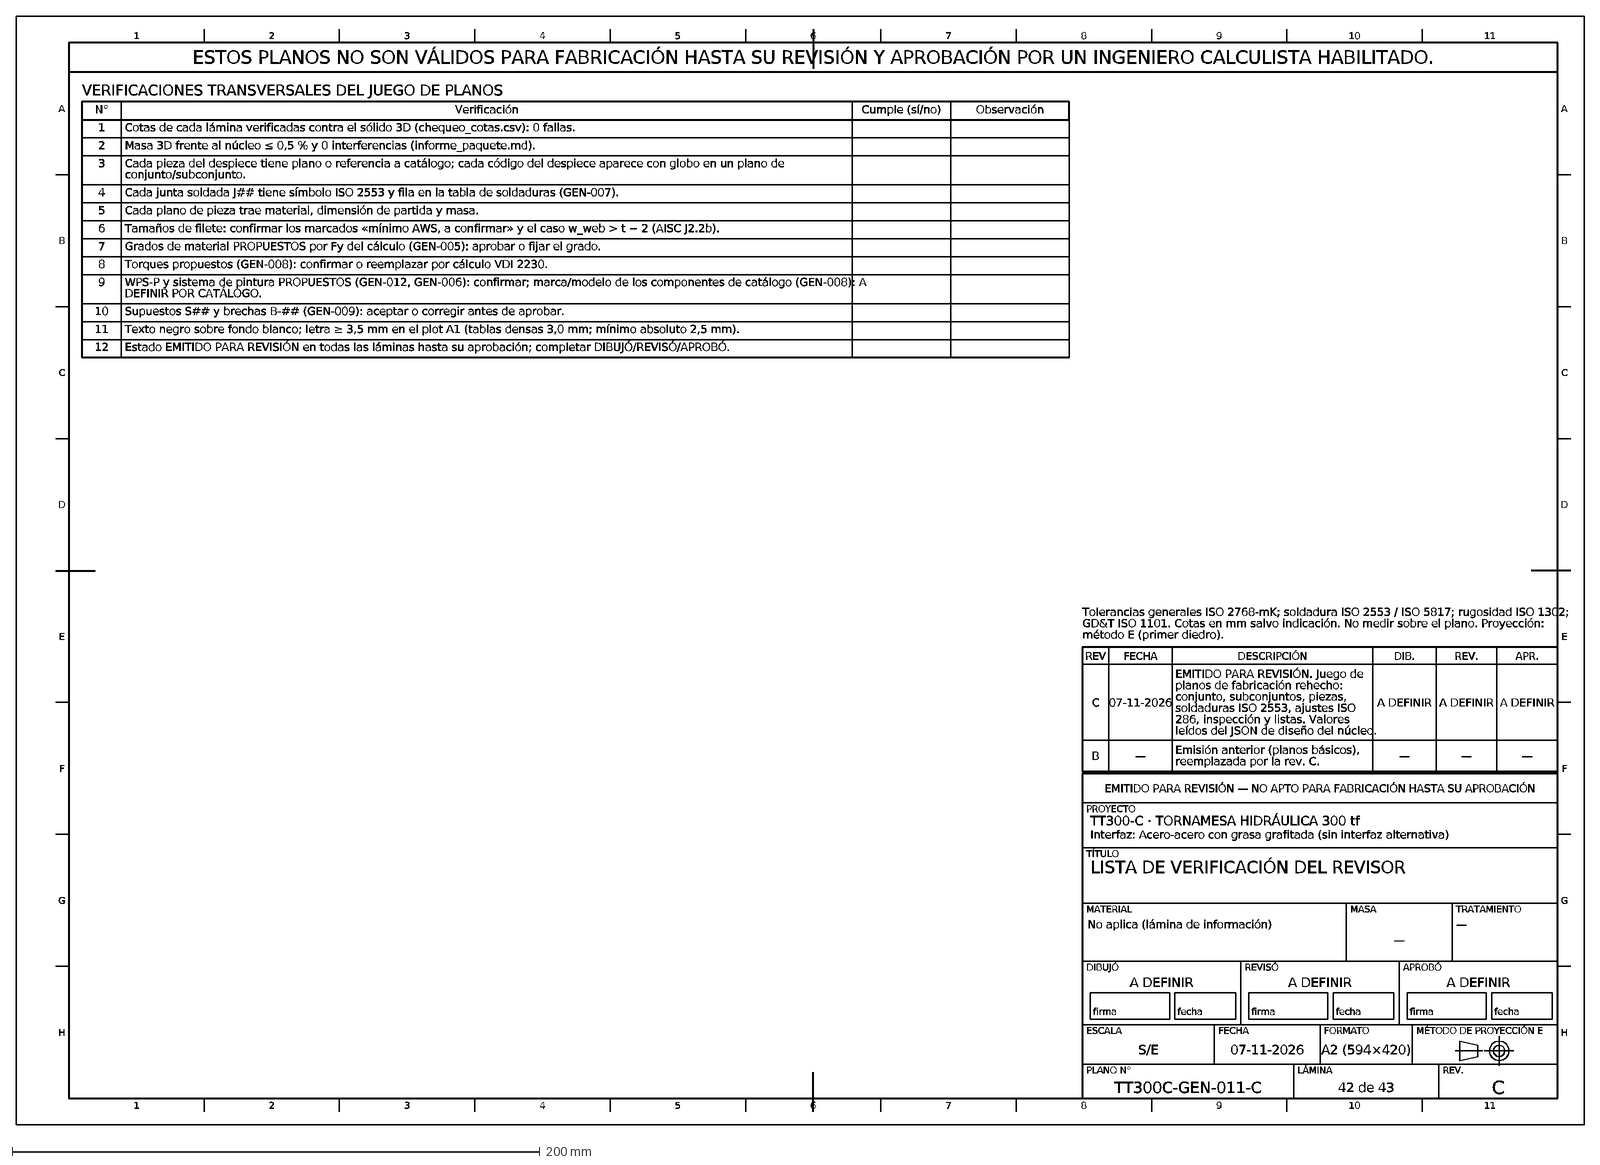
[picture p30: CAD file, 2026-11-07]
entregables/RevC/planos/TT300C-GEN-011-C.dxf
VERIFICACIONES TRANSVERSALES DEL JUEGO DE PLANOS
N°
Verificación
Cumple (sí/no)
Observación
1
Cotas de cada lámina verificadas contra el sólido 3D (chequeo_cotas.csv): 0 fallas.
2
Masa 3D frente al núcleo ≤ 0,5 % y 0 interferencias (informe_paquete.md).
3
Cada pieza del despiece tiene plano o referencia a catálogo; cada código del despiece aparece con globo en un plano de
conjunto/subconjunto.
4
Cada junta soldada J## tiene símbolo ISO 2553 y fila en la tabla de soldaduras (GEN-007).
5
Cada plano de pieza trae material, dimensión de partida y masa.
6
Tamaños de filete: confirmar los marcados «mínimo AWS, a confirmar» y el caso w_web > t − 2 (AISC J2.2b).
7
Grados de material PROPUESTOS por Fy del cálculo (GEN-005): aprobar o fijar el grado.
8
Torques propuestos (GEN-008): confirmar o reemplazar por cálculo VDI 2230.
9
WPS-P y sistema de pintura PROPUESTOS (GEN-012, GEN-006): confirmar; marca/modelo de los componentes de catálogo (GEN-008): A
DEFINIR POR CATÁLOGO.
10
Supuestos S## y brechas B-## (GEN-009): aceptar o corregir antes de aprobar.
11
Texto negro sobre fondo blanco; letra ≥ 3,5 mm en el plot A1 (tablas densas 3,0 mm; mínimo absoluto 2,5 mm).
12
Estado EMITIDO PARA REVISIÓN en todas las láminas hasta su aprobación; completar DIBUJÓ/REVISÓ/APROBÓ.
H
G
F
E
D
C
B
A
ESTOS PLANOS NO SON VÁLIDOS PARA FABRICACIÓN HASTA SU REVISIÓN Y APROBACIÓN POR UN INGENIERO CALCULISTA HABILITADO.
PLANO N°
TT300C-GEN-011-C
LÁMINA
42 de 43
REV.
ESCALA
S/E
FECHA
07-11-2026
FORMATO
A2 (594×420)
MÉTODO DE PROYECCIÓN E
DIBUJÓ
A DEFINIR
firma
fecha
REVISÓ
APROBÓ
MATERIAL
No aplica (lámina de información)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
