mafiucivil/Tornamesa/entregables/RevC/planos/TT300C-GEN-012-C.dxf

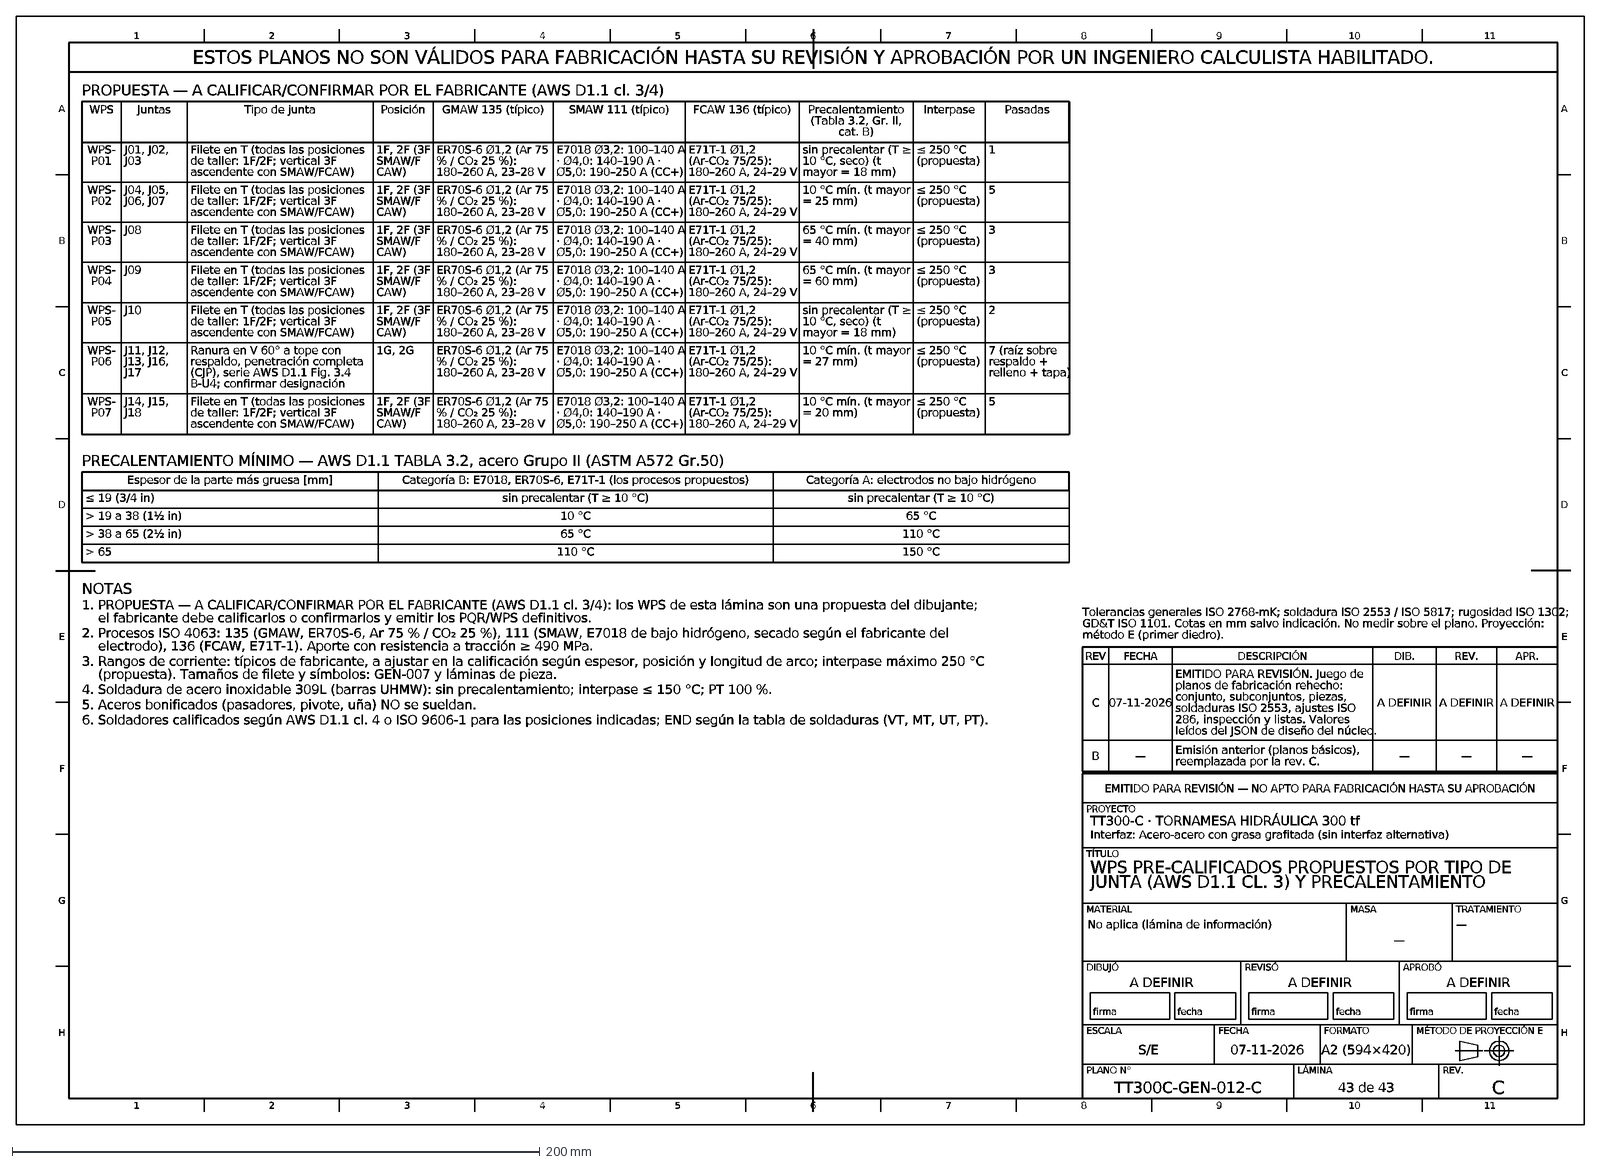
[picture p31: CAD file, 2026-11-07]
entregables/RevC/planos/TT300C-GEN-012-C.dxf
PROPUESTA — A CALIFICAR/CONFIRMAR POR EL FABRICANTE (AWS D1.1 cl. 3/4)
WPS
Juntas
Tipo de junta
Posición
GMAW 135 (típico)
SMAW 111 (típico)
FCAW 136 (típico)
Precalentamiento
(Tabla 3.2, Gr. II,
cat. B)
Interpase
Pasadas
WPS-
P01
J01, J02,
J03
Filete en T (todas las posiciones
de taller: 1F/2F; vertical 3F
ascendente con SMAW/FCAW)
1F, 2F (3F
SMAW/F
CAW)
ER70S-6 Ø1,2 (Ar 75
% / CO₂ 25 %):
180–260 A, 23–28 V
E7018 Ø3,2: 100–140 A
· Ø4,0: 140–190 A ·
Ø5,0: 190–250 A (CC+)
E71T-1 Ø1,2
(Ar-CO₂ 75/25):
180–260 A, 24–29 V
sin precalentar (T ≥
10 °C, seco) (t
mayor = 18 mm)
≤ 250 °C
(propuesta)
1
P02
J04, J05,
J06, J07
10 °C mín. (t mayor
= 25 mm)
5
P03
J08
65 °C mín. (t mayor
= 40 mm)
3
P04
J09
= 60 mm)
P05
J10
2
P06
J11, J12,
J13, J16,
J17
Ranura en V 60° a tope con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
