mafiucivil/Tornamesa/entregables/RevC/planos/TT300C-GEN-008-C.dxf

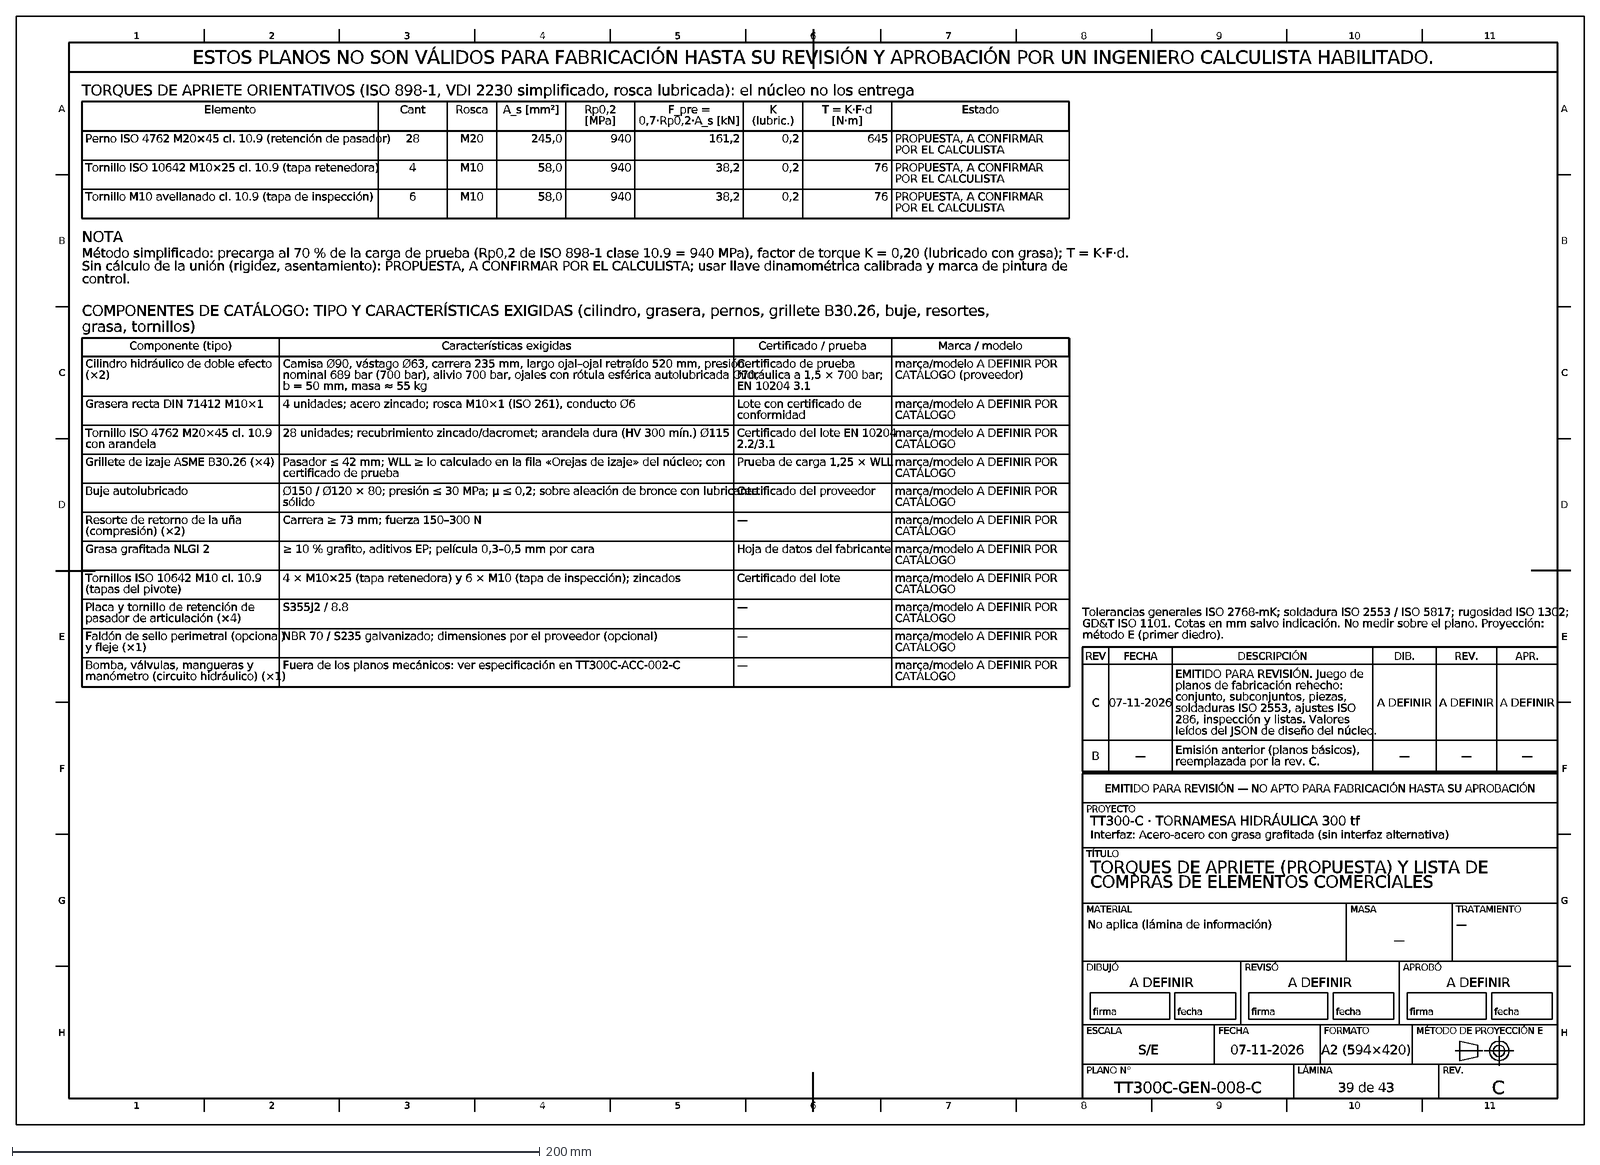
[picture p32: CAD file, 2026-11-07]
entregables/RevC/planos/TT300C-GEN-008-C.dxf
TORQUES DE APRIETE ORIENTATIVOS (ISO 898-1, VDI 2230 simplificado, rosca lubricada): el núcleo no los entrega
Elemento
Cant
Rosca
A_s [mm²]
Rp0,2
[MPa]
F_pre =
0,7·Rp0,2·A_s [kN]
K
(lubric.)
T = K·F·d
[N·m]
Estado
Perno ISO 4762 M20×45 cl. 10.9 (retención de pasador)
28
M20
245,0
940
161,2
0,2
645
PROPUESTA, A CONFIRMAR
POR EL CALCULISTA
Tornillo ISO 10642 M10×25 cl. 10.9 (tapa retenedora)
4
M10
58,0
38,2
76
Tornillo M10 avellanado cl. 10.9 (tapa de inspección)
6
NOTA
Método simplificado: precarga al 70 % de la carga de prueba (Rp0,2 de ISO 898-1 clase 10.9 = 940 MPa), factor de torque K = 0,20 (lubricado con grasa); T = K·F·
Sin cálculo de la unión (rigidez, asentamiento): PROPUESTA, A CONFIRMAR POR EL CALCULISTA; usar llave dinamométrica calibrada y marca de pintura de
control.
COMPONENTES DE CATÁLOGO: TIPO Y CARACTERÍSTICAS EXIGIDAS (cilindro, grasera, pernos, grillete B30.26, buje, resortes,
grasa, tornillos)
Componente (tipo)
Características exigidas
Certificado / prueba
Marca / modelo
Cilindro hidráulico de doble efecto
(×2)
Camisa Ø90, vástago Ø63, carrera 235 mm, largo ojal–ojal retraído 520 mm, presión
nominal 689 bar (700 bar), alivio 700 bar, ojales con rótula esférica autolubricada Ø70,
b = 50 mm, masa ≈ 55 kg
Certificado de prueba
hidráulica a 1,5 × 700 bar;
EN 10204 3.1
marca/modelo A DEFINIR POR
CATÁLOGO (proveedor)
Grasera recta DIN 71412 M10×1
4 unidades; acero zincado; rosca M10×1 (ISO 261), conducto Ø6
Lote con certificado de
conformidad
CATÁLOGO
Tornillo ISO 4762 M20×45 cl. 10.9
con arandela
28 unidades; recubrimiento zincado/dacromet; arandela dura (HV 300 mín.) Ø115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
