mafiucivil/Tornamesa/(list of files, cad)

Other CAD files:
cad/out/default/planos/TT300C-ACC-004-B.dxf
cad/out/planos/TT300C-ACC-001-B.dxf
cad/out/TT300-C.step
entregables/RevC/planos/TT300C-CON-011-C.dxf
entregables/RevC/TT300-C.step
entregables/RevC/variantes/C2/TT300-C.step
cad/out/default/planos/TT300C-IZA-001-B.dxf
cad/out/planos/TT300C-GEN-009-B.dxf
entregables/RevC/planos/TT300C-MES-011-C.dxf
cad/out/default/planos/TT300C-MES-003-B.dxf
cad/out/planos/TT300C-GEN-003-B.dxf
entregables/RevC/planos/TT300C-MES-005-C.dxf
cad/out/default/planos/TT300C-ACC-003-B.dxf
cad/out/planos/TT300C-GEN-002-B.dxf
entregables/RevC/planos/TT300C-PIV-001-C.dxf
cad/out/default/planos/TT300C-BAS-001-B.dxf
cad/out/planos/TT300C-MES-003-B.dxf
entregables/RevC/planos/TT300C-CON-010-C.dxf
cad/out/default/planos/TT300C-GEN-003-B.dxf
cad/out/planos/TT300C-GEN-004-B.dxf
entregables/RevC/planos/TT300C-CON-005-C.dxf
cad/out/default/planos/TT300C-MES-002-B.dxf
cad/out/planos/TT300C-PIV-001-B.dxf
entregables/RevC/planos/TT300C-GEN-010-C.dxf
cad/out/default/planos/TT300C-GEN-001-B.dxf
cad/out/planos/TT300C-GEN-001-B.dxf
entregables/RevC/planos/TT300C-CON-007-C.dxf
cad/out/default/planos/TT300C-BAS-005-B.dxf
cad/out/planos/TT300C-GEN-005-B.dxf
entregables/RevC/planos/TT300C-ACC-004-C.dxf
cad/out/default/planos/TT300C-GEN-002-B.dxf
cad/out/planos/TT300C-BAS-005-B.dxf
entregables/RevC/planos/TT300C-CON-004-C.dxf
cad/out/default/planos/TT300C-GEN-004-B.dxf
cad/out/planos/TT300C-MES-002-B.dxf
entregables/RevC/planos/TT300C-GEN-003-C.dxf
cad/out/default/planos/TT300C-ACC-002-B.dxf
cad/out/planos/TT300C-GEN-006-B.dxf
entregables/RevC/planos/TT300C-CON-001-C.dxf
cad/out/default/planos/TT300C-GEN-009-B.dxf
cad/out/planos/TT300C-GEN-007-B.dxf
entregables/RevC/planos/TT300C-CON-008-C.dxf
cad/out/default/planos/TT300C-GEN-007-B.dxf
cad/out/planos/TT300C-ACC-003-B.dxf
cad/out/default/planos/TT300C-GEN-008-B.dxf
cad/out/planos/TT300C-BAS-001-B.dxf
entregables/RevC/planos/TT300C-CON-002-C.dxf
cad/out/default/planos/TT300C-GEN-005-B.dxf
cad/out/planos/TT300C-MES-001-B.dxf
entregables/RevC/planos/TT300C-GEN-001-C.dxf
cad/out/default/planos/TT300C-PIV-001-B.dxf
cad/out/planos/TT300C-GEN-008-B.dxf
cad/out/default/planos/TT300C-ACC-001-B.dxf
cad/out/planos/TT300C-IZA-001-B.dxf
entregables/RevC/planos/TT300C-MES-001-C.dxf
cad/out/default/planos/TT300C-MES-001-B.dxf
cad/out/planos/TT300C-ACC-002-B.dxf
entregables/RevC/planos/TT300C-PIV-003-C.dxf
cad/out/default/planos/TT300C-GEN-006-B.dxf
cad/out/planos/TT300C-MES-004-B.dxf
entregables/RevC/planos/TT300C-BAS-002-C.dxf
cad/out/default/planos/TT300C-MES-004-B.dxf
cad/out/planos/TT300C-ACC-004-B.dxf
entregables/RevC/planos/TT300C-BAS-003-C.dxf
entregables/RevC/planos/TT300C-MES-008-C.dxf
entregables/RevC/planos/TT300C-CON-009-C.dxf
entregables/RevC/planos/TT300C-ACC-002-C.dxf
entregables/RevC/planos/TT300C-MES-012-C.dxf
entregables/RevC/planos/TT300C-MES-002-C.dxf
entregables/RevC/planos/TT300C-CON-003-C.dxf
entregables/RevC/planos/TT300C-MES-003-C.dxf
entregables/RevC/planos/TT300C-PIV-002-C.dxf
entregables/RevC/planos/TT300C-GEN-006-C.dxf
entregables/RevC/planos/TT300C-GEN-007-C.dxf
entregables/RevC/planos/TT300C-ACC-001-C.dxf
entregables/RevC/planos/TT300C-MES-013-C.dxf
entregables/RevC/planos/TT300C-GEN-009-C.dxf
entregables/RevC/planos/TT300C-BAS-005-C.dxf
entregables/RevC/planos/TT300C-ACC-005-C.dxf
entregables/RevC/planos/TT300C-BAS-001-C.dxf
entregables/RevC/planos/TT300C-IZA-001-C.dxf
entregables/RevC/planos/TT300C-ACC-003-C.dxf
entregables/RevC/planos/TT300C-CON-006-C.dxf
entregables/RevC/planos/TT300C-GEN-005-C.dxf
