mafiucivil/Tornamesa/entregables/RevC/variantes/A/lista_verificacion_revisor.md

# Lista de verificación para el revisor · TT300-C

Fecha de emisión: 07-11-2026 · Interfaz: Opción A: dos discos de acero inoxidable con grasa (base liso, mesa ranurado)

**ESTOS PLANOS NO SON VÁLIDOS PARA FABRICACIÓN HASTA SU REVISIÓN Y APROBACIÓN POR UN INGENIERO CALCULISTA HABILITADO.**

| N° | Plano | Título | Qué verificar | Contra qué cálculo |
|---|---|---|---|---|
| 1 | TT300C-GEN-001-C | NOTAS GENERALES, NORMAS APLICABLES E ÍNDICE DE PLANOS | Verificar contenido y cotas. | Núcleo de cálculo |
| 2 | TT300C-CON-001-C | CONJUNTO GENERAL DEL EQUIPO: PLANTA, ELEVACIÓN Y CORTES A-A Y B-B | Verificar contenido y cotas. | Núcleo de cálculo |
| 3 | TT300C-CON-002-C | DESPIECE COMPLETO DEL EQUIPO (HOJA 1) | Verificar contenido y cotas. | Núcleo de cálculo |
| 4 | TT300C-CON-003-C | CONJUNTO GENERAL: ELEVACIONES LATERAL Y POSTERIOR, VISTA INFERIOR Y DIMENSIONES GENERALES | Verificar contenido y cotas. | Núcleo de cálculo |
| 5 | TT300C-CON-004-C | ISOMÉTRICA EXPLOSIONADA DEL EQUIPO CON GLOBOS DE POSICIÓN | Verificar contenido y cotas. | Núcleo de cálculo |
| 6 | TT300C-CON-005-C | SECUENCIA DE MONTAJE Y FABRICACIÓN | Verificar contenido y cotas. | Núcleo de cálculo |
| 7 | TT300C-CON-006-C | BASE SOLDADA: CONJUNTO (PLANTA, ELEVACIONES, CORTES Y DETALLES DE JUNTA) | Verificar contenido y cotas. | Núcleo de cálculo |
| 8 | TT300C-CON-007-C | MÉNSULA DE CILINDRO: SUBCONJUNTO SOLDADO (PLANTA, ELEVACIÓN Y CORTES) | Verificar contenido y cotas. | Núcleo de cálculo |
| 9 | TT300C-CON-008-C | MESA SOLDADA: PLANTA A MEDIA ALTURA, PLANTA INFERIOR, ELEVACIÓN Y CORTE POR UN PASADOR | Verificar contenido y cotas. | Núcleo de cálculo |
| 10 | TT300C-CON-009-C | MESA SOLDADA: CORTE POR ALMAS, DETALLES DE JUNTA, REBAJE DEL COLLAR Y TABLA DE PASADORES | Verificar contenido y cotas. | Núcleo de cálculo |
| 11 | TT300C-CON-010-C | ACCIONAMIENTO: CILINDRO, MÉNSULA, PATÍN, BANCADA, UÑA Y PASADORES (VISTA Y CORTES) | Verificar contenido y cotas. | Núcleo de cálculo |
| 12 | TT300C-CON-011-C | PIVOTE: CUBO, COLLAR, BUJE Y TAPAS — HOLGURAS Y AJUSTES (ISO 286) | Verificar contenido y cotas. | Núcleo de cálculo |
| 13 | TT300C-CON-012-C | CONJUNTO DE LA INTERFAZ: OPCIÓN A: DOS DISCOS DE ACERO INOXIDABLE CON GRASA (BASE LISO, MESA RANURADO) | Verificar contenido y cotas. | Núcleo de cálculo |
| 14 | TT300C-CON-013-C | DESPIECE COMPLETO DEL EQUIPO (HOJA 2) | Verificar contenido y cotas. | Núcleo de cálculo |
| 15 | TT300C-BAS-001-C | PLANCHA BASE: CONTORNO, AGUJERO CENTRAL Y POSICIONES | Verificar contenido y cotas. | Núcleo de cálculo |
| 16 | TT300C-BAS-002-C | COLLAR DE ASIENTO DEL PIVOTE | Verificar contenido y cotas. | Núcleo de cálculo |
| 17 | TT300C-BAS-003-C | MARCO PERIMETRAL: PLETINAS LARGA Y CORTA | Verificar contenido y cotas. | Núcleo de cálculo |
| 18 | TT300C-BAS-005-C | MÉNSULA DE CILINDRO: MEJILLA Y OREJAS (PIEZAS) | Verificar contenido y cotas. | Núcleo de cálculo |
| 19 | TT300C-IZA-001-C | OREJA DE IZAJE (4 UNIDADES) | Verificar contenido y cotas. | Núcleo de cálculo |
| 20 | TT300C-ACC-001-C | BANCADA DE GUÍA CON RANURA T (2 UNIDADES) | Verificar contenido y cotas. | Núcleo de cálculo |
| 21 | TT300C-MES-001-C | MESA: PLANCHA SUPERIOR | Verificar contenido y cotas. | Núcleo de cálculo |
| 22 | TT300C-MES-002-C | MESA: ANILLOS SUPERIOR E INFERIOR DE PASADORES (28 AGUJEROS) | Verificar contenido y cotas. | Núcleo de cálculo |
| 23 | TT300C-MES-003-C | MESA: PLANCHA INFERIOR (CARA DE APOYO DE LA INTERFAZ) | Verificar contenido y cotas. | Núcleo de cálculo |
| 24 | TT300C-MES-005-C | MESA: ALMAS ANULARES (3 ANILLOS) | Verificar contenido y cotas. | Núcleo de cálculo |
| 25 | TT300C-MES-008-C | MESA: NERVIOS RADIALES (TRAMOS ENTRE ALMAS) | Verificar contenido y cotas. | Núcleo de cálculo |
| 26 | TT300C-MES-011-C | MESA: CUBO | Verificar contenido y cotas. | Núcleo de cálculo |
| 27 | TT300C-MES-012-C | MESA: PASADOR DE EMPUJE Ø85 (28 UNIDADES) | Verificar contenido y cotas. | Núcleo de cálculo |
| 28 | TT300C-MES-013-C | MESA: PERNO ISO 4762 M20×45 CON ARANDELA (28 UNIDADES) | Verificar contenido y cotas. | Núcleo de cálculo |
| 29 | TT300C-PIV-001-C | PIVOTE Ø120 p6 | Verificar contenido y cotas. | Núcleo de cálculo |
| 30 | TT300C-PIV-002-C | PIVOTE: BUJE AUTOLUBRICADO | Verificar contenido y cotas. | Núcleo de cálculo |
| 31 | TT300C-PIV-003-C | PIVOTE: TAPAS RETENEDORA (PIV-003) E INSPECCIÓN (PIV-004) | Verificar contenido y cotas. | Núcleo de cálculo |
| 32 | TT300C-ACC-002-C | CILINDRO HIDRÁULICO DE DOBLE EFECTO (ELEMENTO COMERCIAL — DIMENSIONES DE INTERFAZ) | Verificar contenido y cotas. | Núcleo de cálculo |
| 33 | TT300C-ACC-003-C | PATÍN GUIADO CON LENGÜETA T Y MARCO DE BOCA (2 UNIDADES) | Verificar contenido y cotas. | Núcleo de cálculo |
| 34 | TT300C-ACC-004-C | UÑA DE EMPUJE (CARA PLANA TEMPLADA, CHAFLÁN DE RETORNO) (2 UNIDADES) | Verificar contenido y cotas. | Núcleo de cálculo |
| 35 | TT300C-ACC-005-C | PASADORES DE ARTICULACIÓN Ø70 f8 (VÁSTAGO Y OJAL TRASERO) | Verificar contenido y cotas. | Núcleo de cálculo |
| 36 | TT300C-INT-001-C | INTERFAZ: DISCO DE LA BASE (SECTOR) | Verificar contenido y cotas. | Núcleo de cálculo |
| 37 | TT300C-INT-002-C | INTERFAZ: DISCO DE LA MESA (SECTOR) | Verificar contenido y cotas. | Núcleo de cálculo |
| 38 | TT300C-INT-003-C | INTERFAZ: BARRA DE TOPE DE LA BASE Y DETALLE DE JUNTA | Verificar contenido y cotas. | Núcleo de cálculo |
| 39 | TT300C-INT-004-C | INTERFAZ: BARRA DE TOPE DE LA MESA Y DETALLE DE JUNTA | Verificar contenido y cotas. | Núcleo de cálculo |
| 40 | TT300C-INT-005-C | INTERFAZ: TORNILLOS DE POSICIÓN ISO 10642 M6 (ROSCA ISO 262, PAR PROPUESTO) | Verificar contenido y cotas. | Núcleo de cálculo |
| 41 | TT300C-INT-007-C | INTERFAZ: GRASERAS DIN 71412 M10×1, TALADRO Ø6 Y TRAZADO DE ENGRASE | Verificar contenido y cotas. | Núcleo de cálculo |
| 42 | TT300C-INT-101-C | INTERFAZ: RANURAS DE ENGRASE EN LA CARA DESLIZANTE (TRAZADO: 12 RADIALES Y CIRCUNFERENCIALES, GRASERAS) | Verificar contenido y cotas. | Núcleo de cálculo |
| 43 | TT300C-GEN-003-C | PLAN DE INSPECCIÓN Y ENSAYOS | Verificar contenido y cotas. | Núcleo de cálculo |
| 44 | TT300C-GEN-004-C | TOLERANCIAS Y AJUSTES (ISO 286) Y TOLERANCIAS GEOMÉTRICAS | Verificar contenido y cotas. | Núcleo de cálculo |
| 45 | TT300C-GEN-005-C | MATERIALES Y CERTIFICADOS | Verificar contenido y cotas. | Núcleo de cálculo |
| 46 | TT300C-GEN-006-C | TRATAMIENTOS TÉRMICOS Y SUPERFICIALES, PINTURA | Verificar contenido y cotas. | Núcleo de cálculo |
| 47 | TT300C-GEN-007-C | PROGRAMA DE SOLDADURAS: TABLA GLOBAL DE JUNTAS | Verificar contenido y cotas. | Núcleo de cálculo |
| 48 | TT300C-GEN-008-C | TORQUES DE APRIETE (PROPUESTA) Y LISTA DE COMPRAS DE ELEMENTOS COMERCIALES | Verificar contenido y cotas. | Núcleo de cálculo |
| 49 | TT300C-GEN-009-C | SUPUESTOS DEL DIBUJANTE Y BRECHAS CON EL CÁLCULO (GEN-009) | Verificar contenido y cotas. | Núcleo de cálculo |
| 50 | TT300C-GEN-010-C | LISTA DE CORTES DE PLANCHA (NESTING SIMPLE) Y APROVECHAMIENTO | Verificar contenido y cotas. | Núcleo de cálculo |
| 51 | TT300C-GEN-011-C | LISTA DE VERIFICACIÓN DEL REVISOR | Verificar contenido y cotas. | Núcleo de cálculo |
| 52 | TT300C-GEN-012-C | WPS PRE-CALIFICADOS PROPUESTOS POR TIPO DE JUNTA (AWS D1.1 CL. 3) Y PRECALENTAMIENTO | Verificar contenido y cotas. | Núcleo de cálculo |

## Verificaciones transversales
- Todas las láminas llevan la advertencia obligatoria, cajetín completo, estado «EMITIDO PARA REVISIÓN» y tabla de revisiones.
- Cotas verificadas automáticamente contra el modelo 3D: ver `chequeo_cotas.csv` y el informe del paquete.
- Masas 3D frente al núcleo, centro de gravedad e interferencias: ver `informe_paquete.md`.
- Supuestos S## y brechas B-## de GEN-009: aceptar o corregir antes de aprobar.
