mafiucivil/Tornamesa/cad/out/default/TT300-C_Planos_RevB.pdf

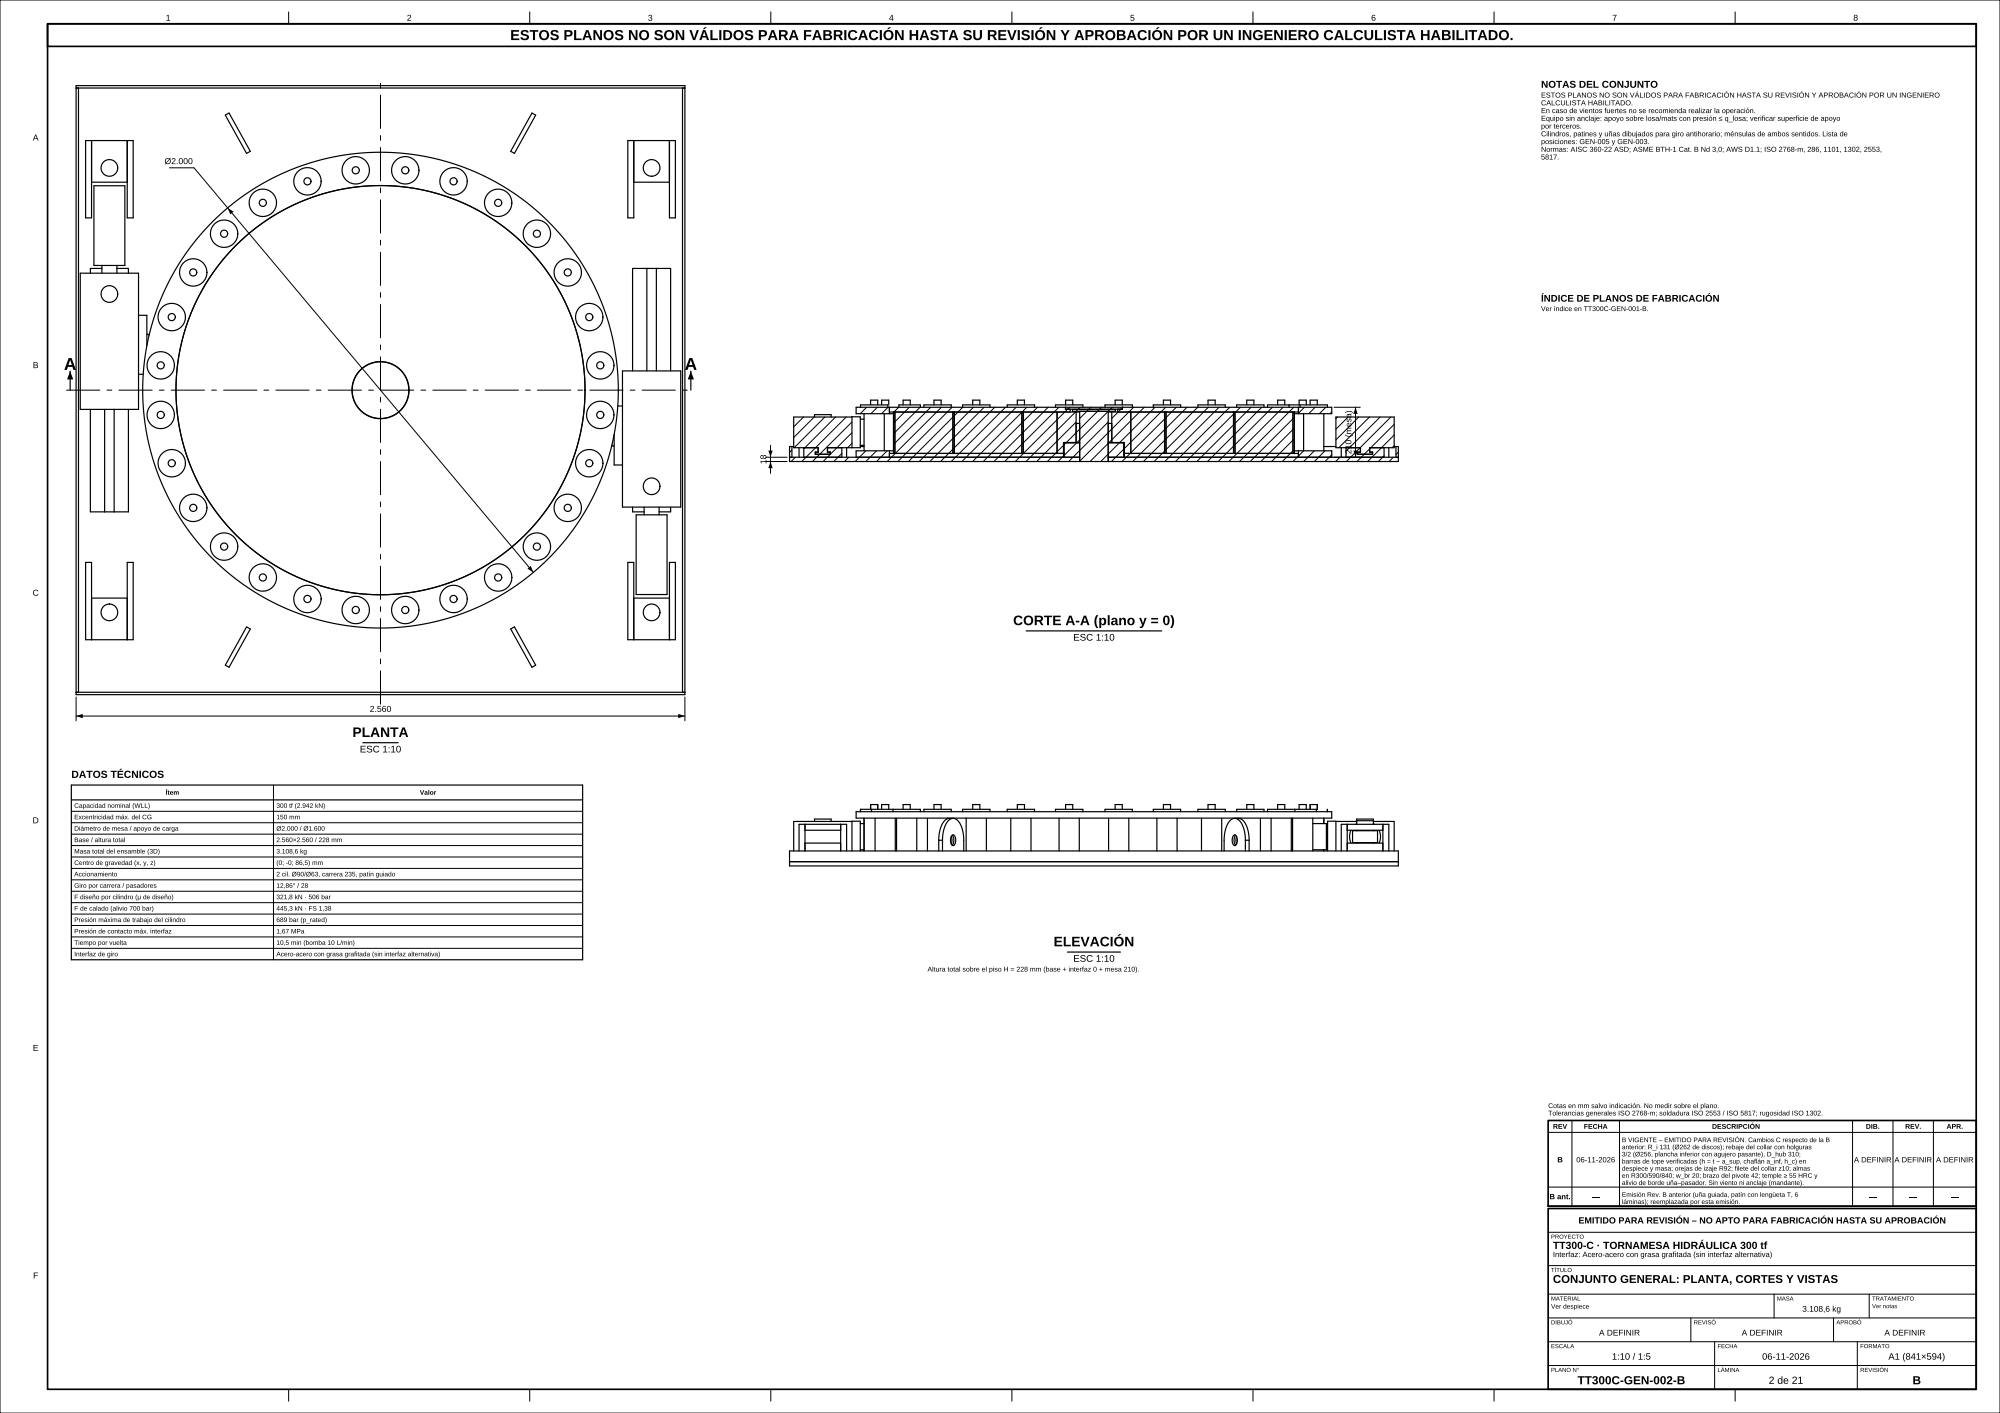
[picture p54: page 2]

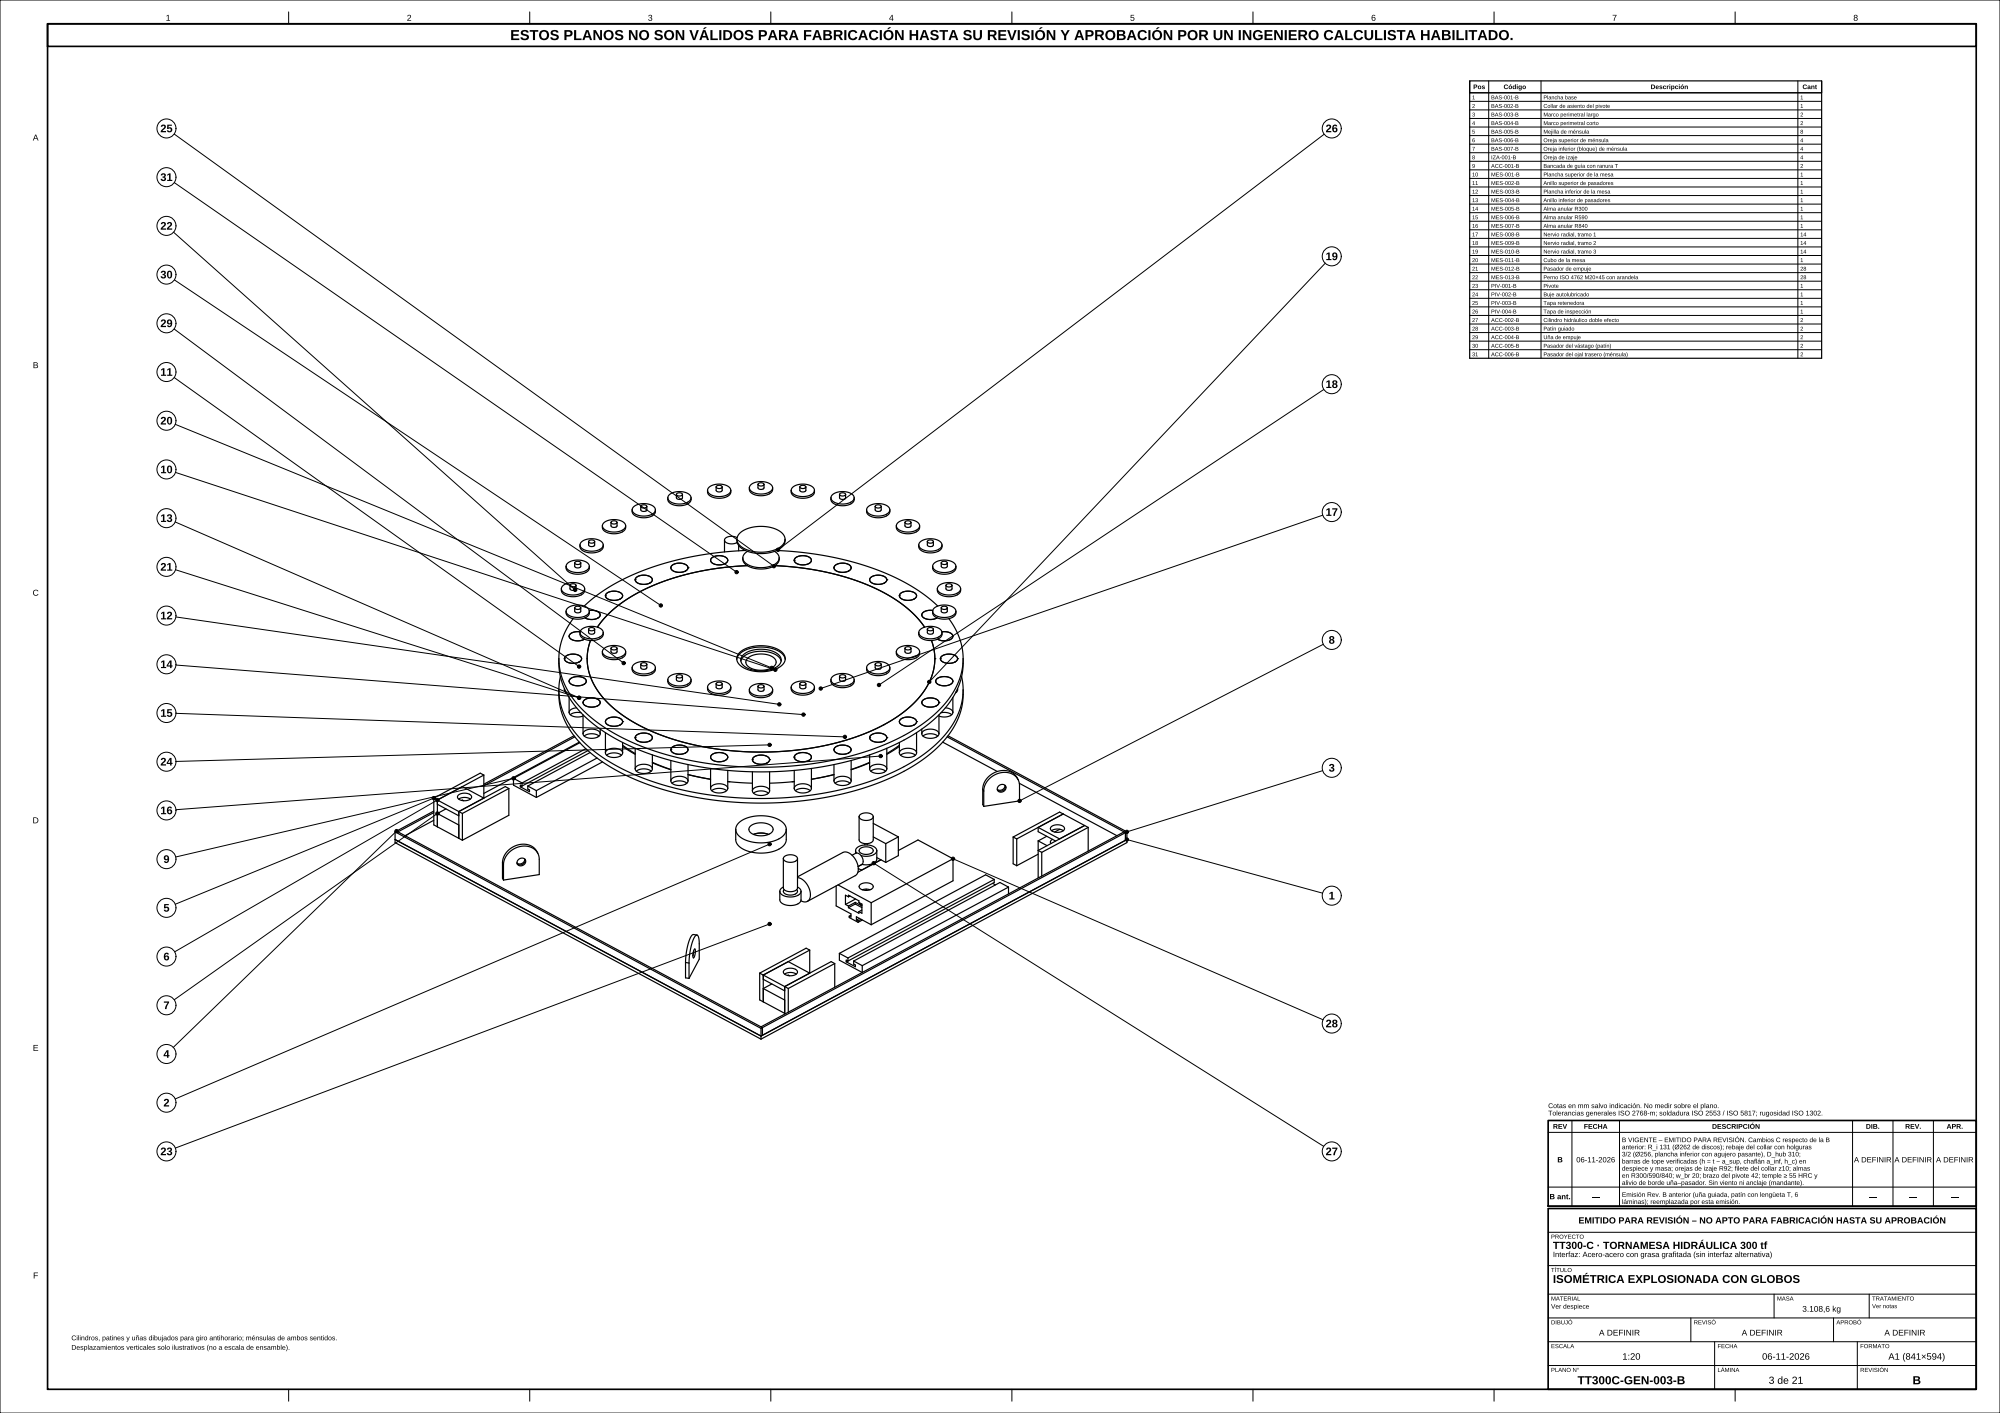
[picture p55: page 3]

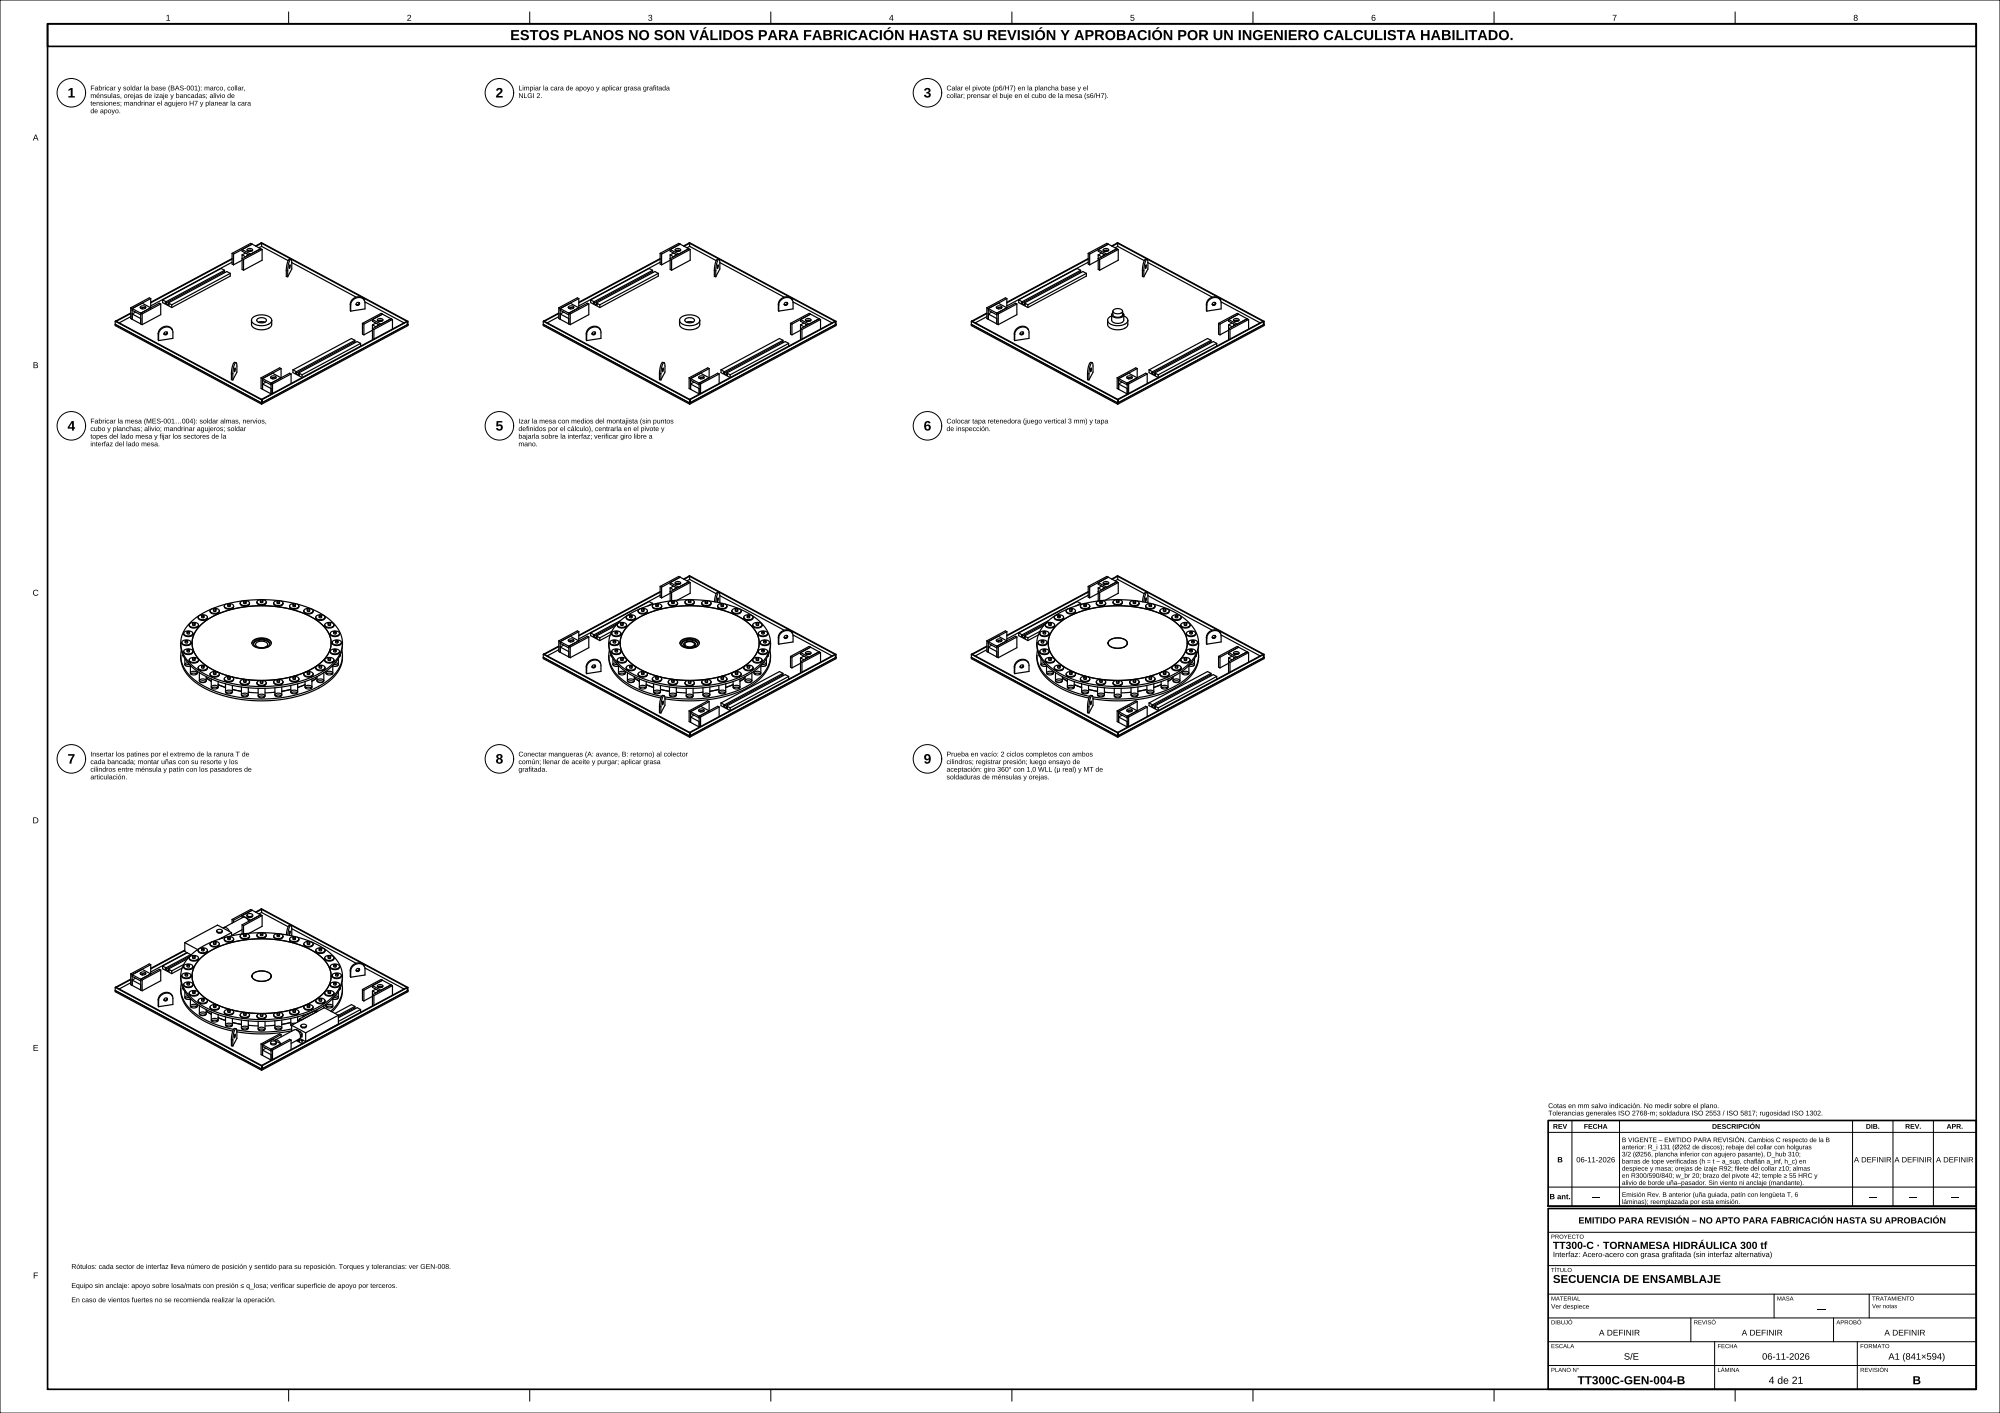
[picture p56: page 4]




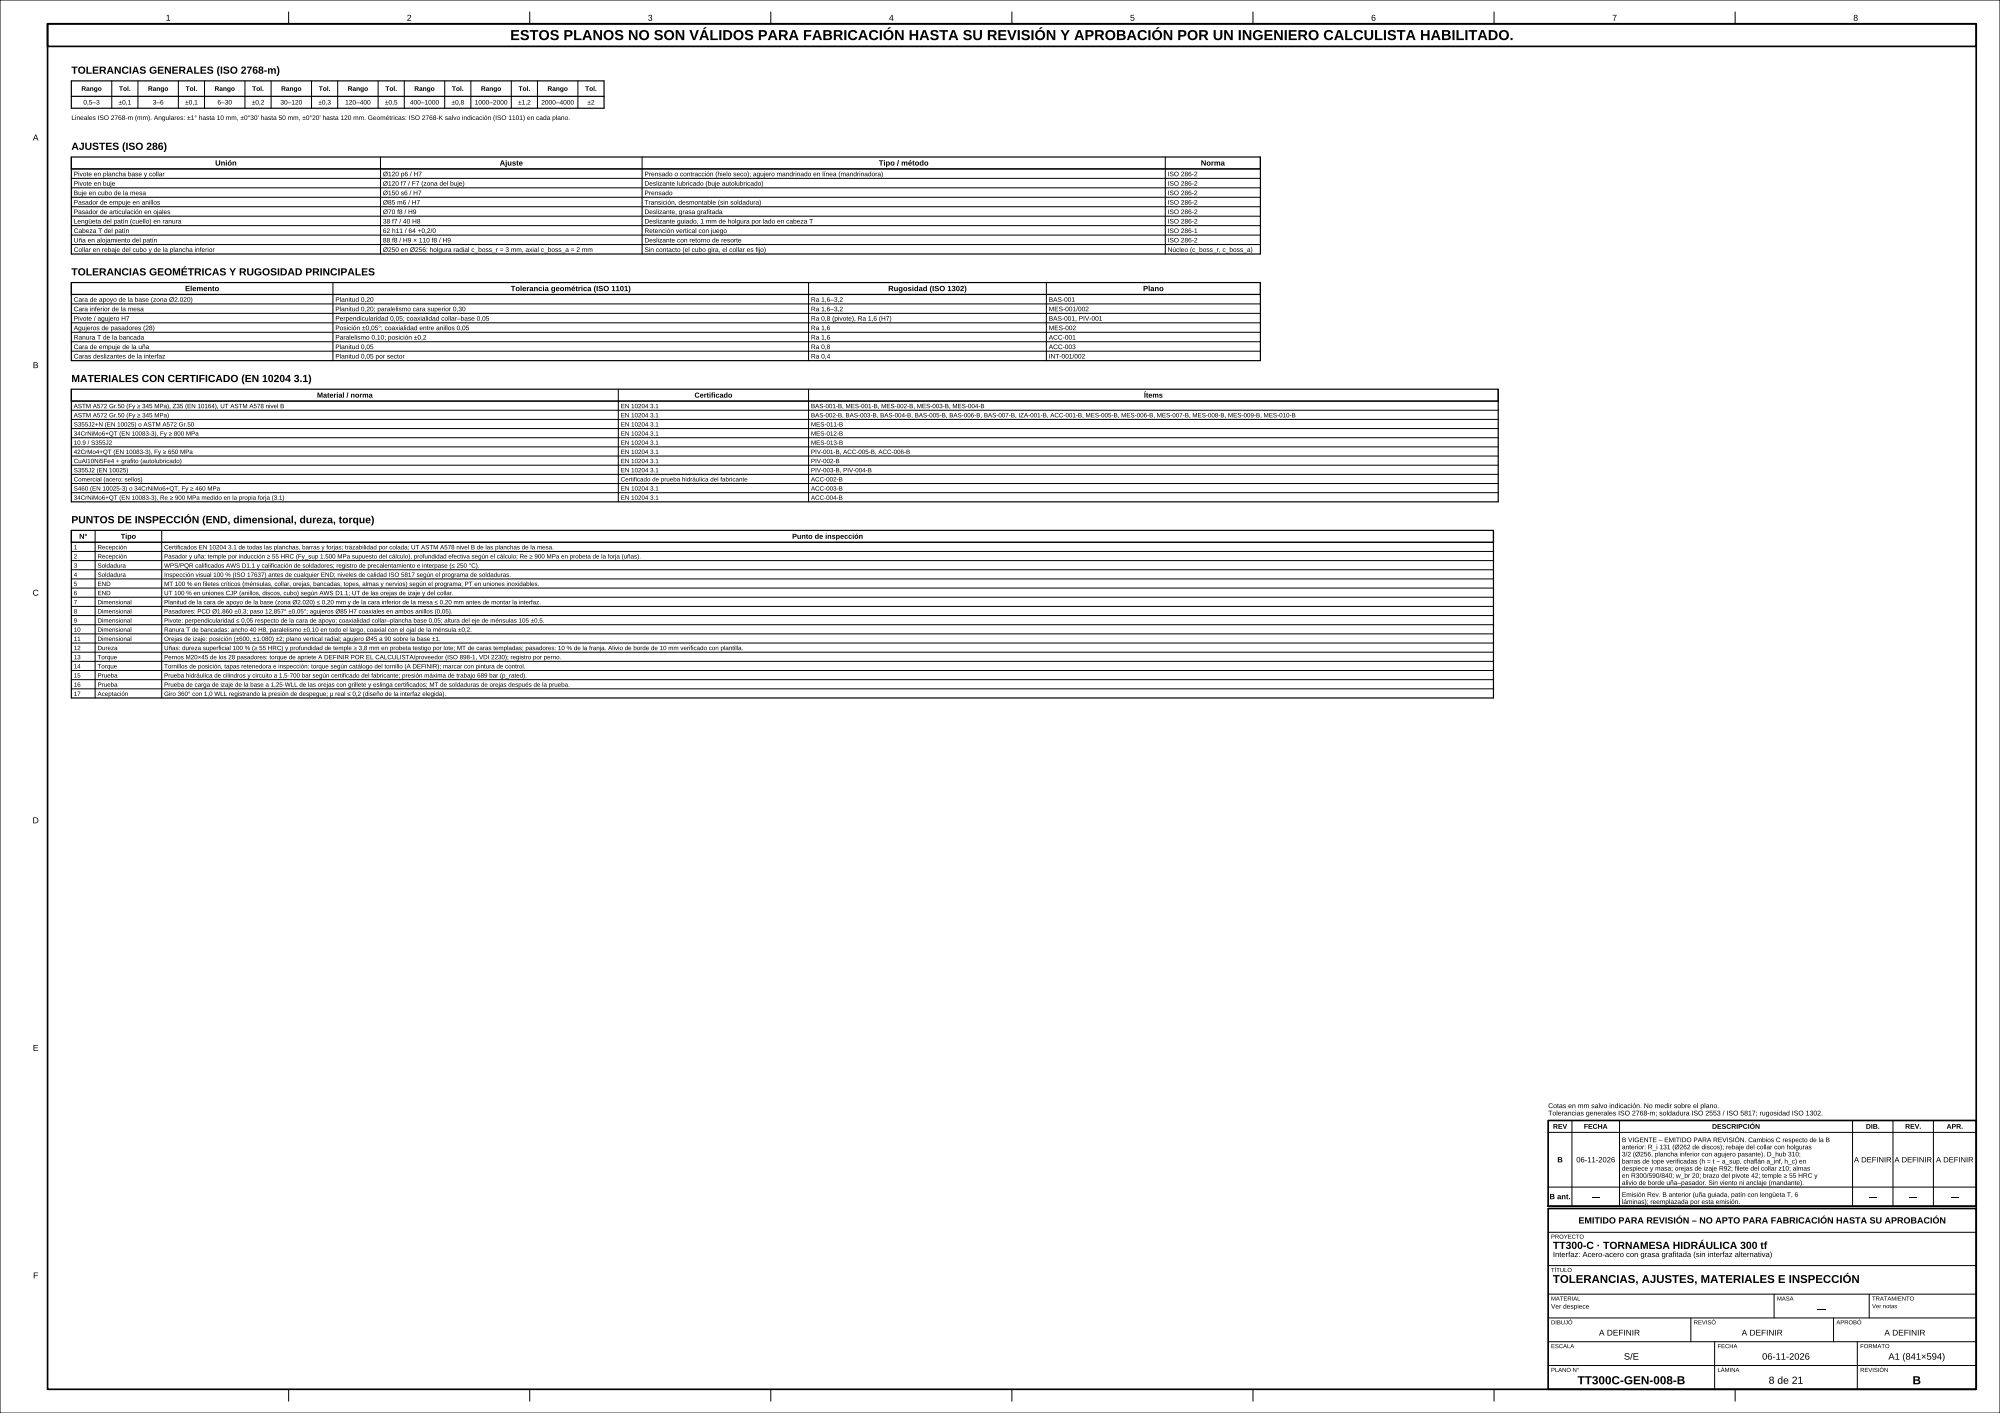
[picture p57: page 8]


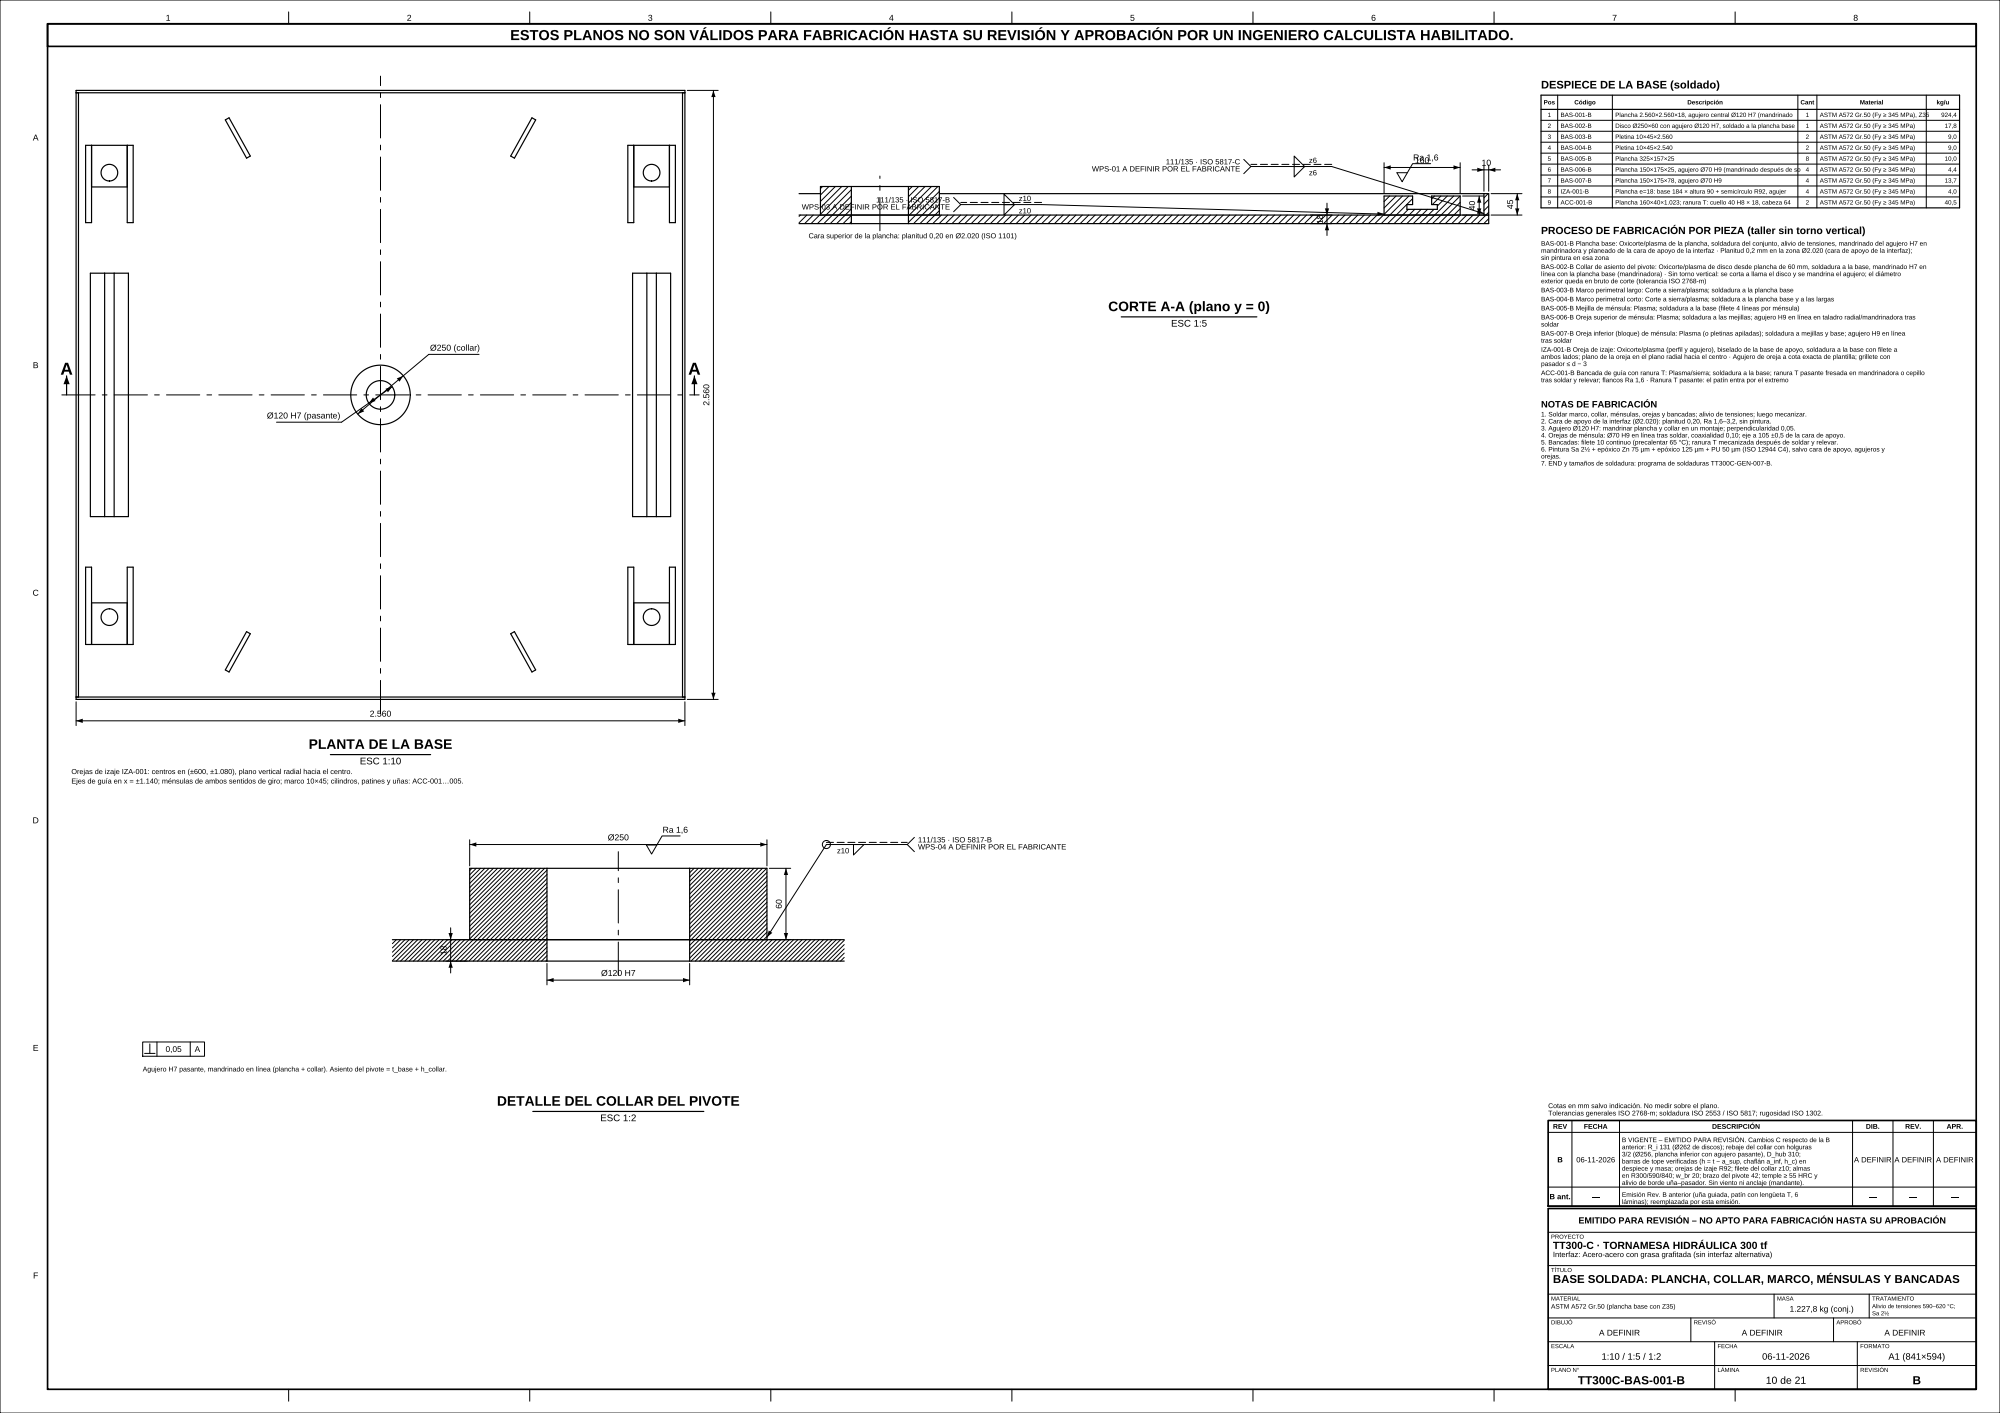
[picture p58: page 10]

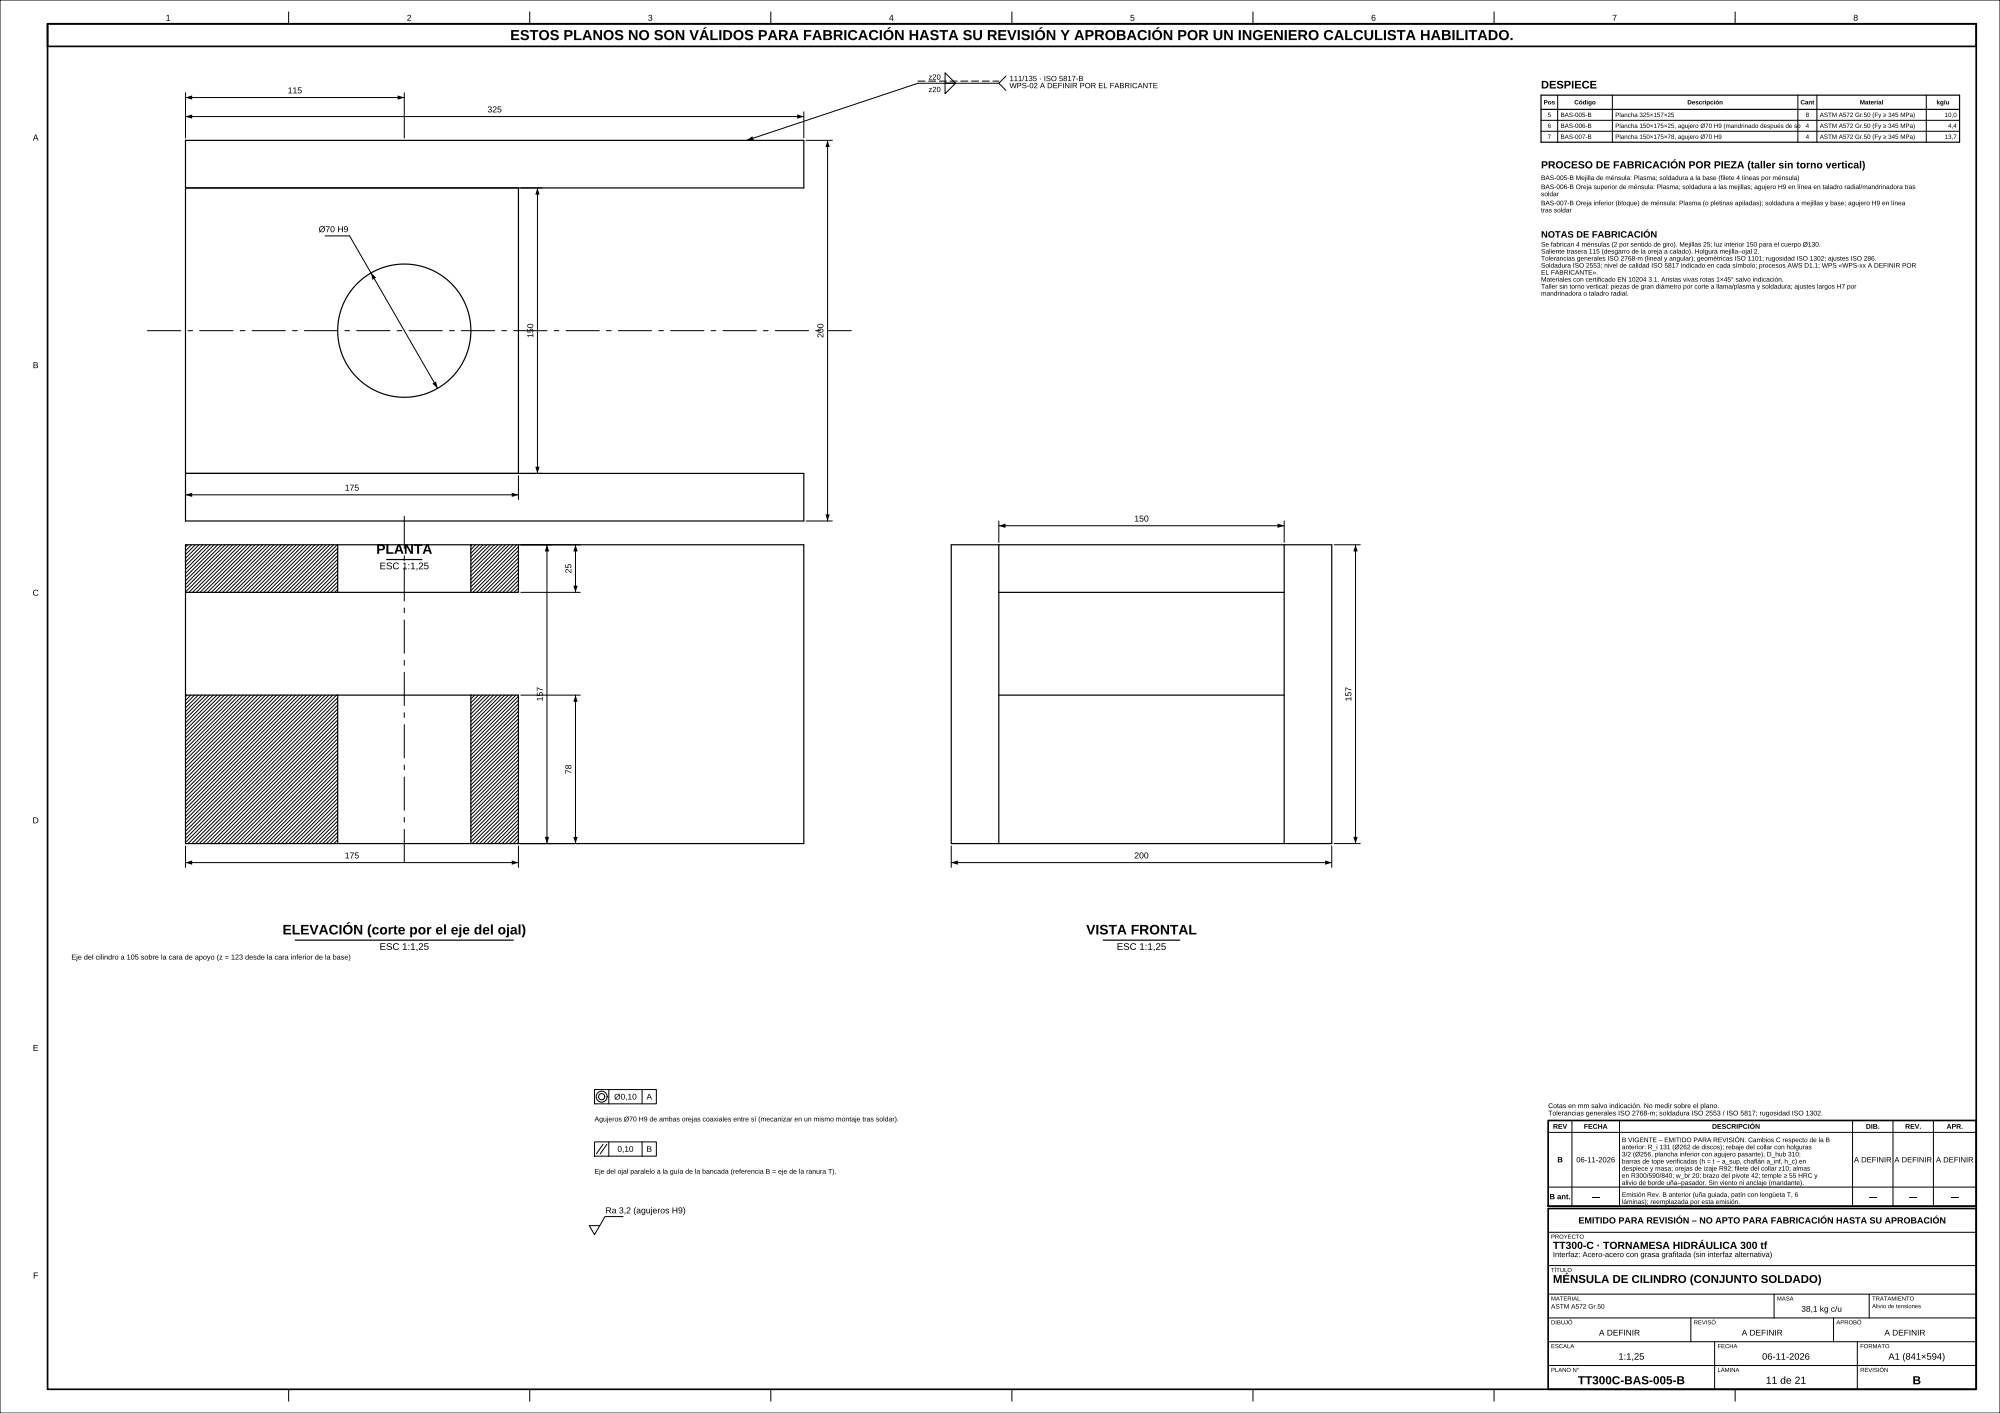
[picture p59: page 11]

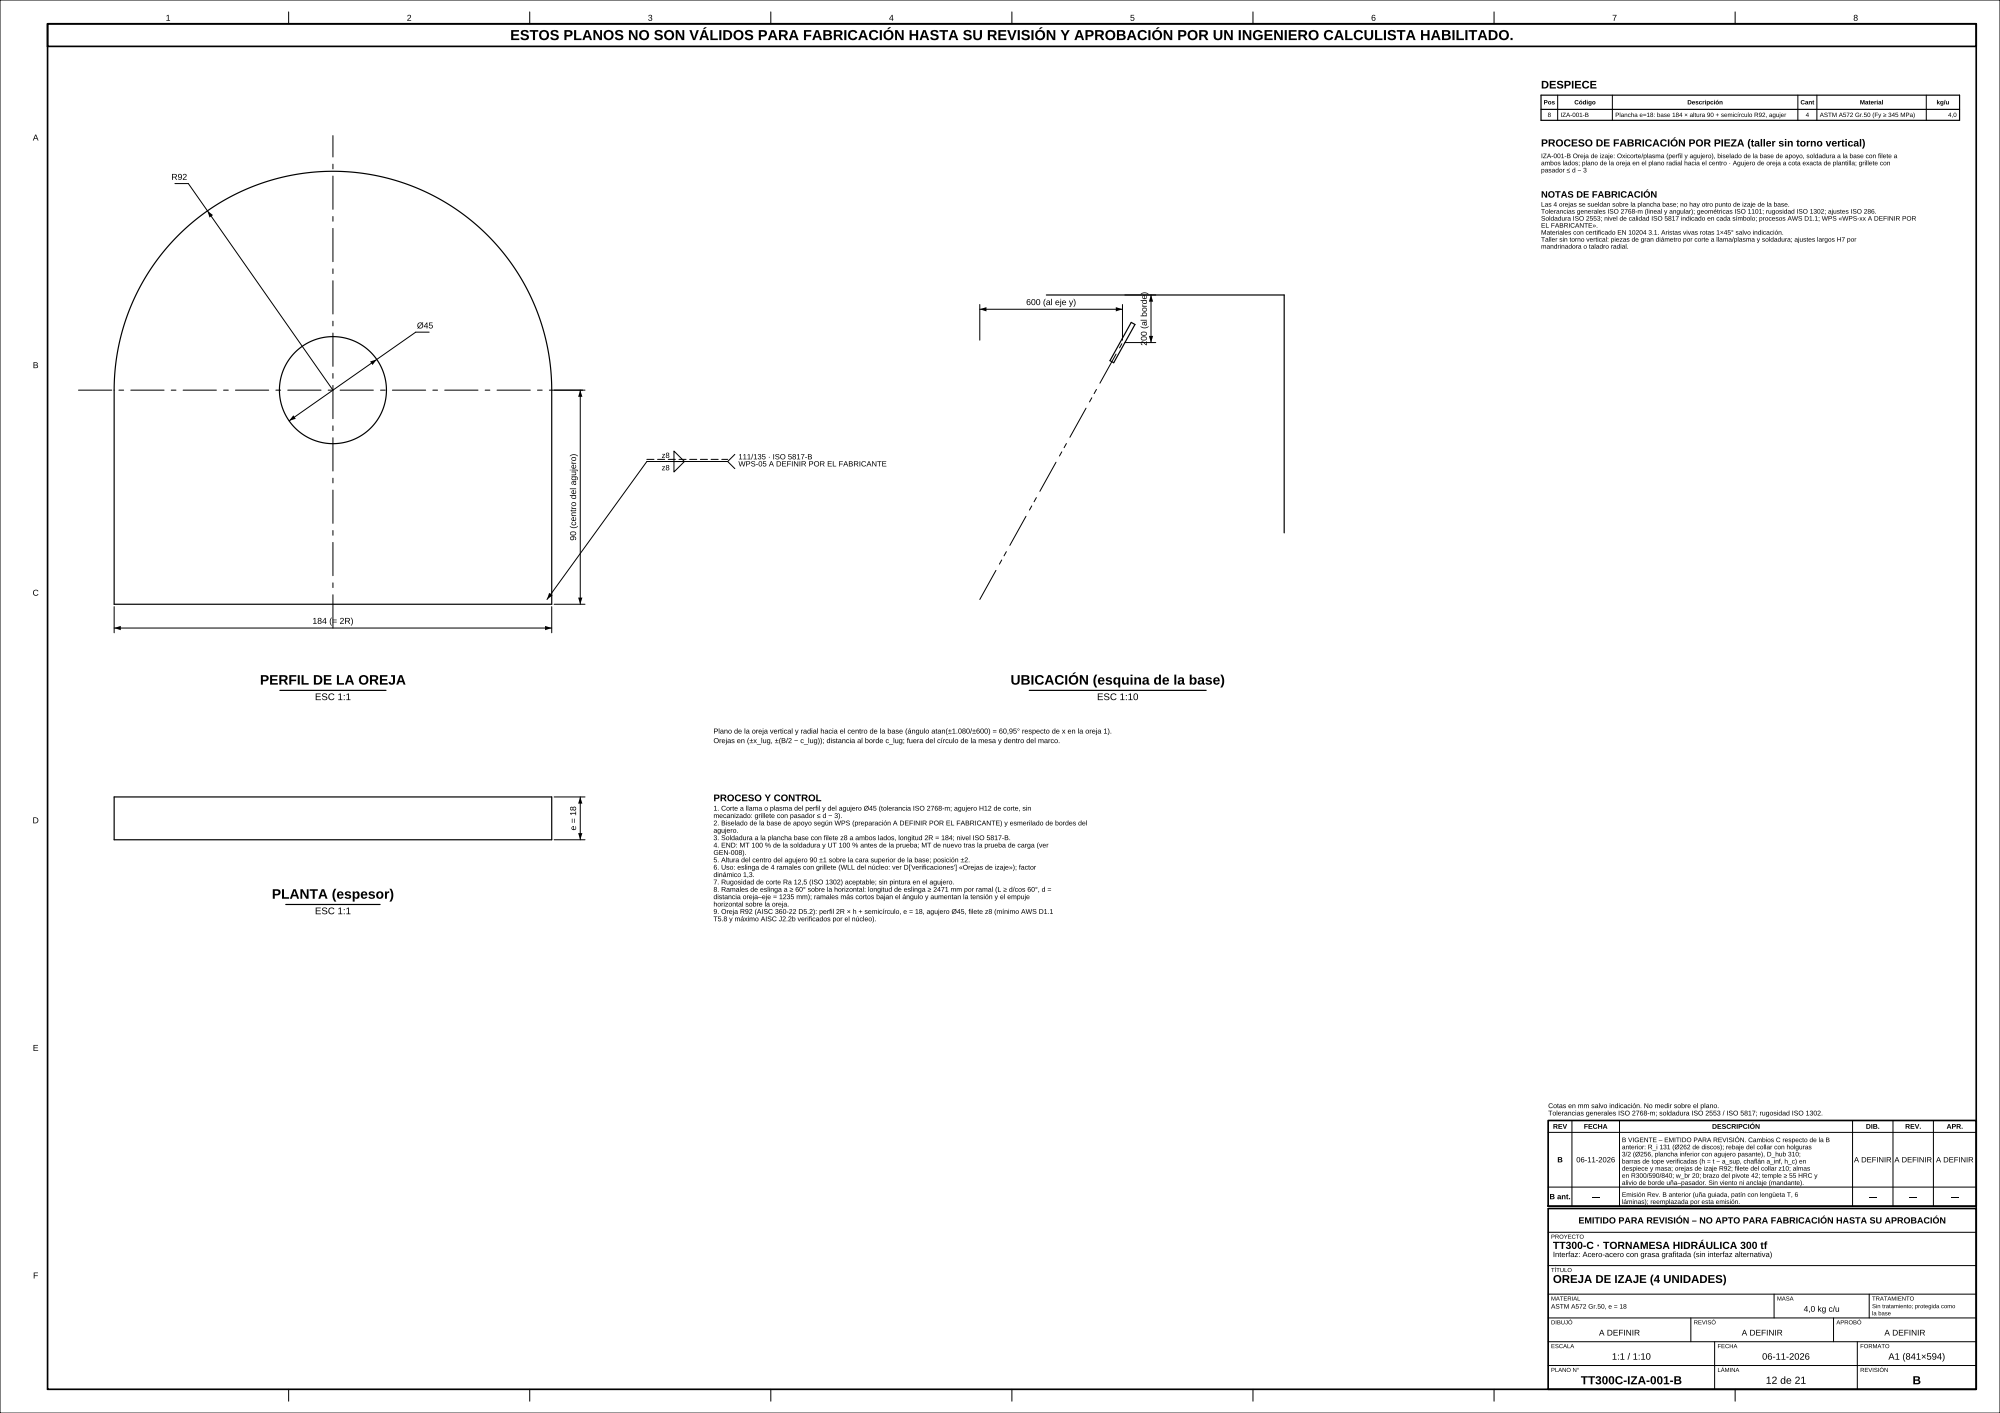
[picture p60: page 12]

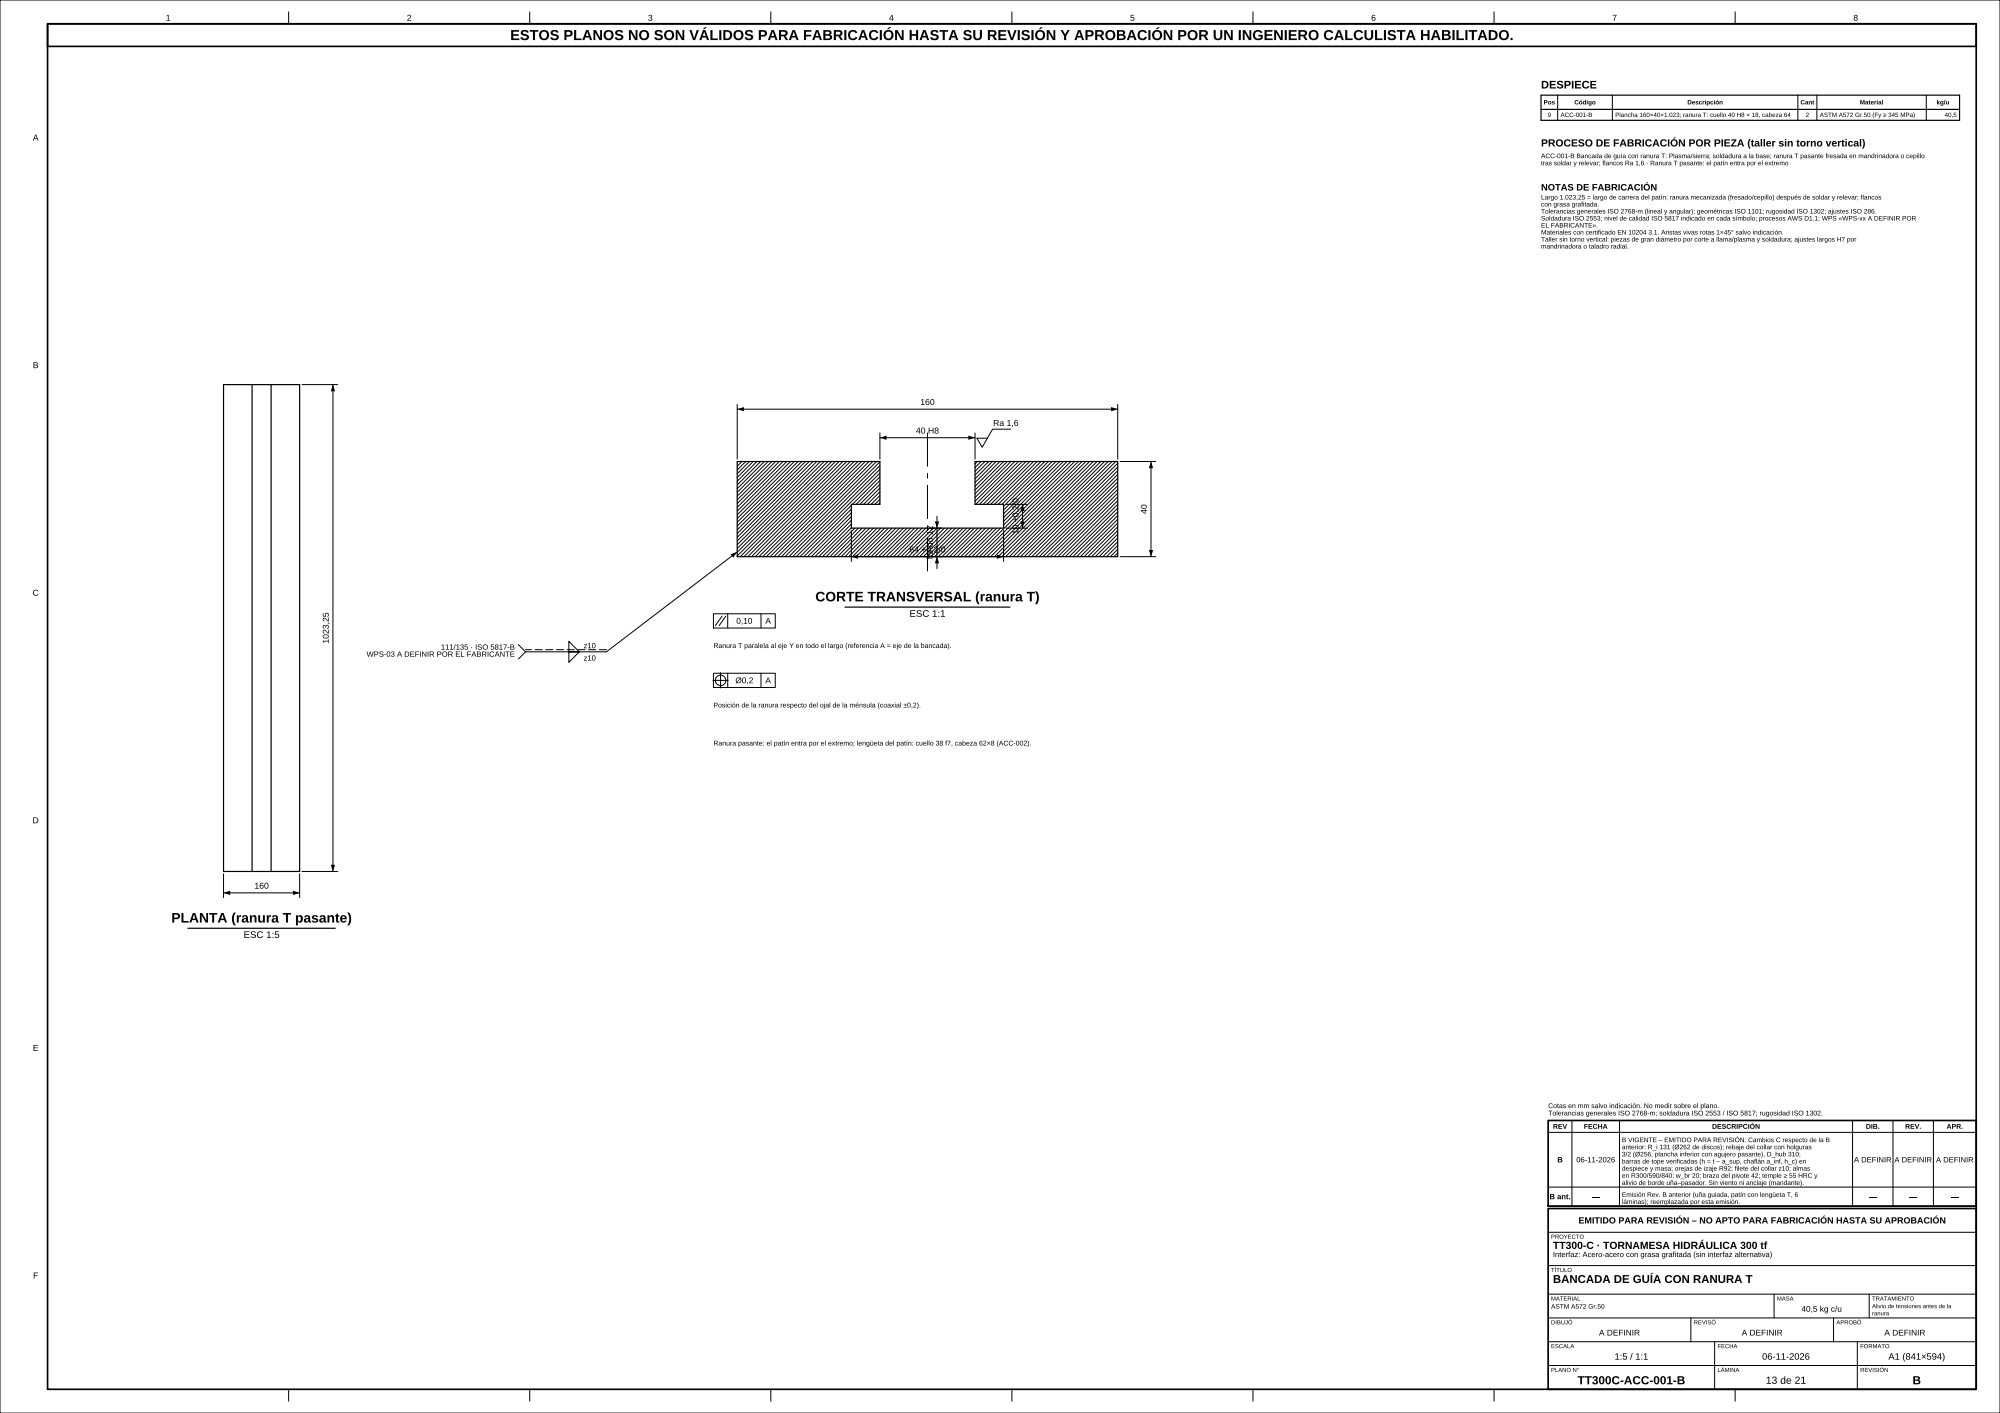
[picture p61: page 13]

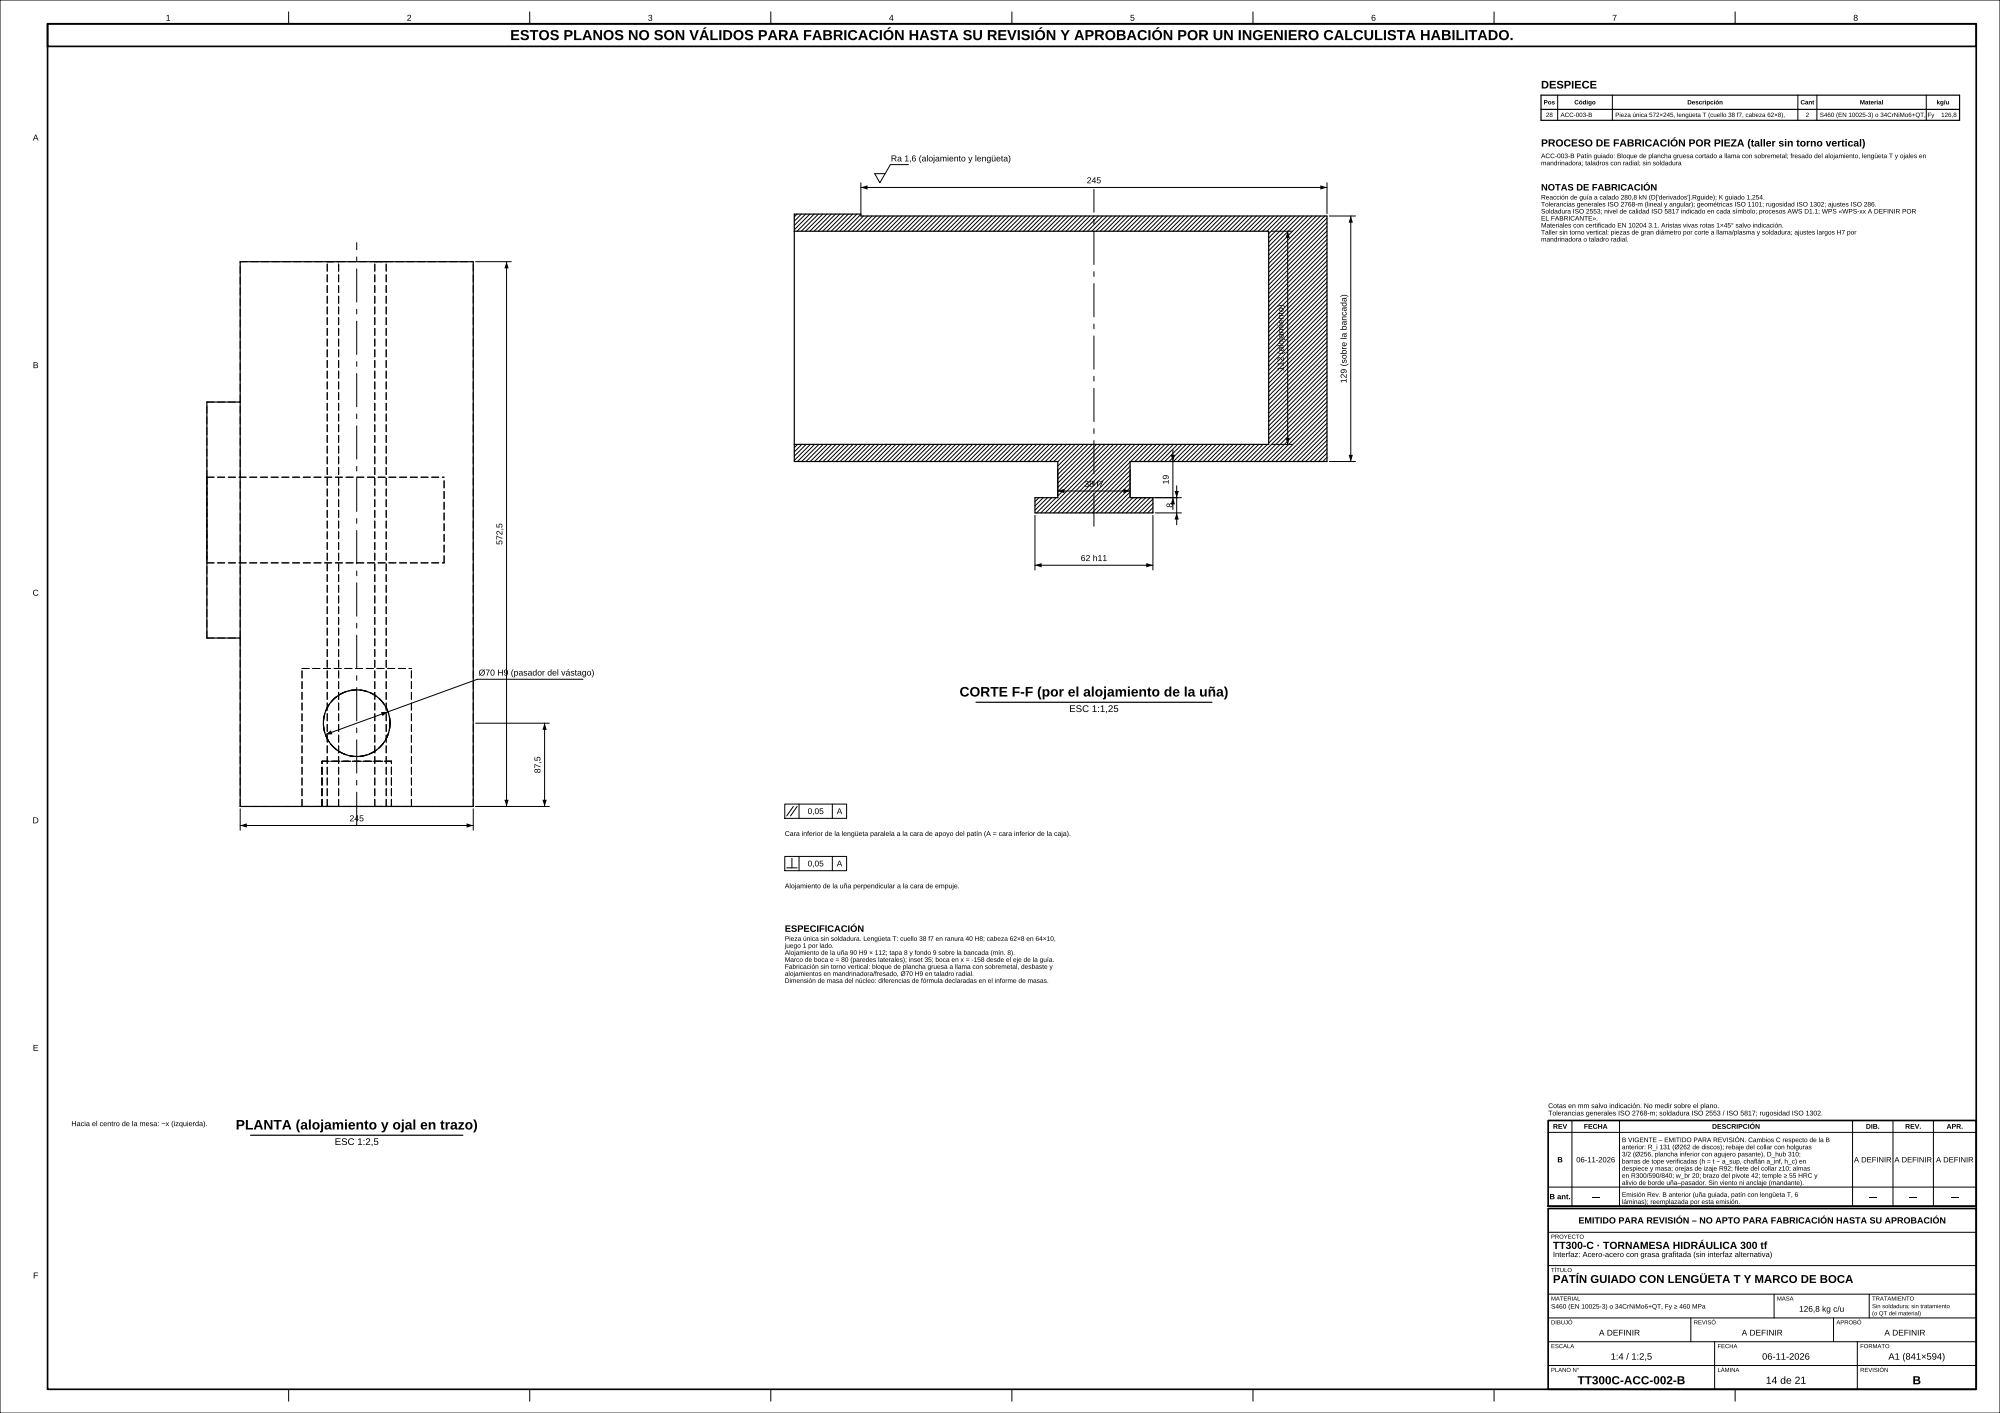
[picture p62: page 14]



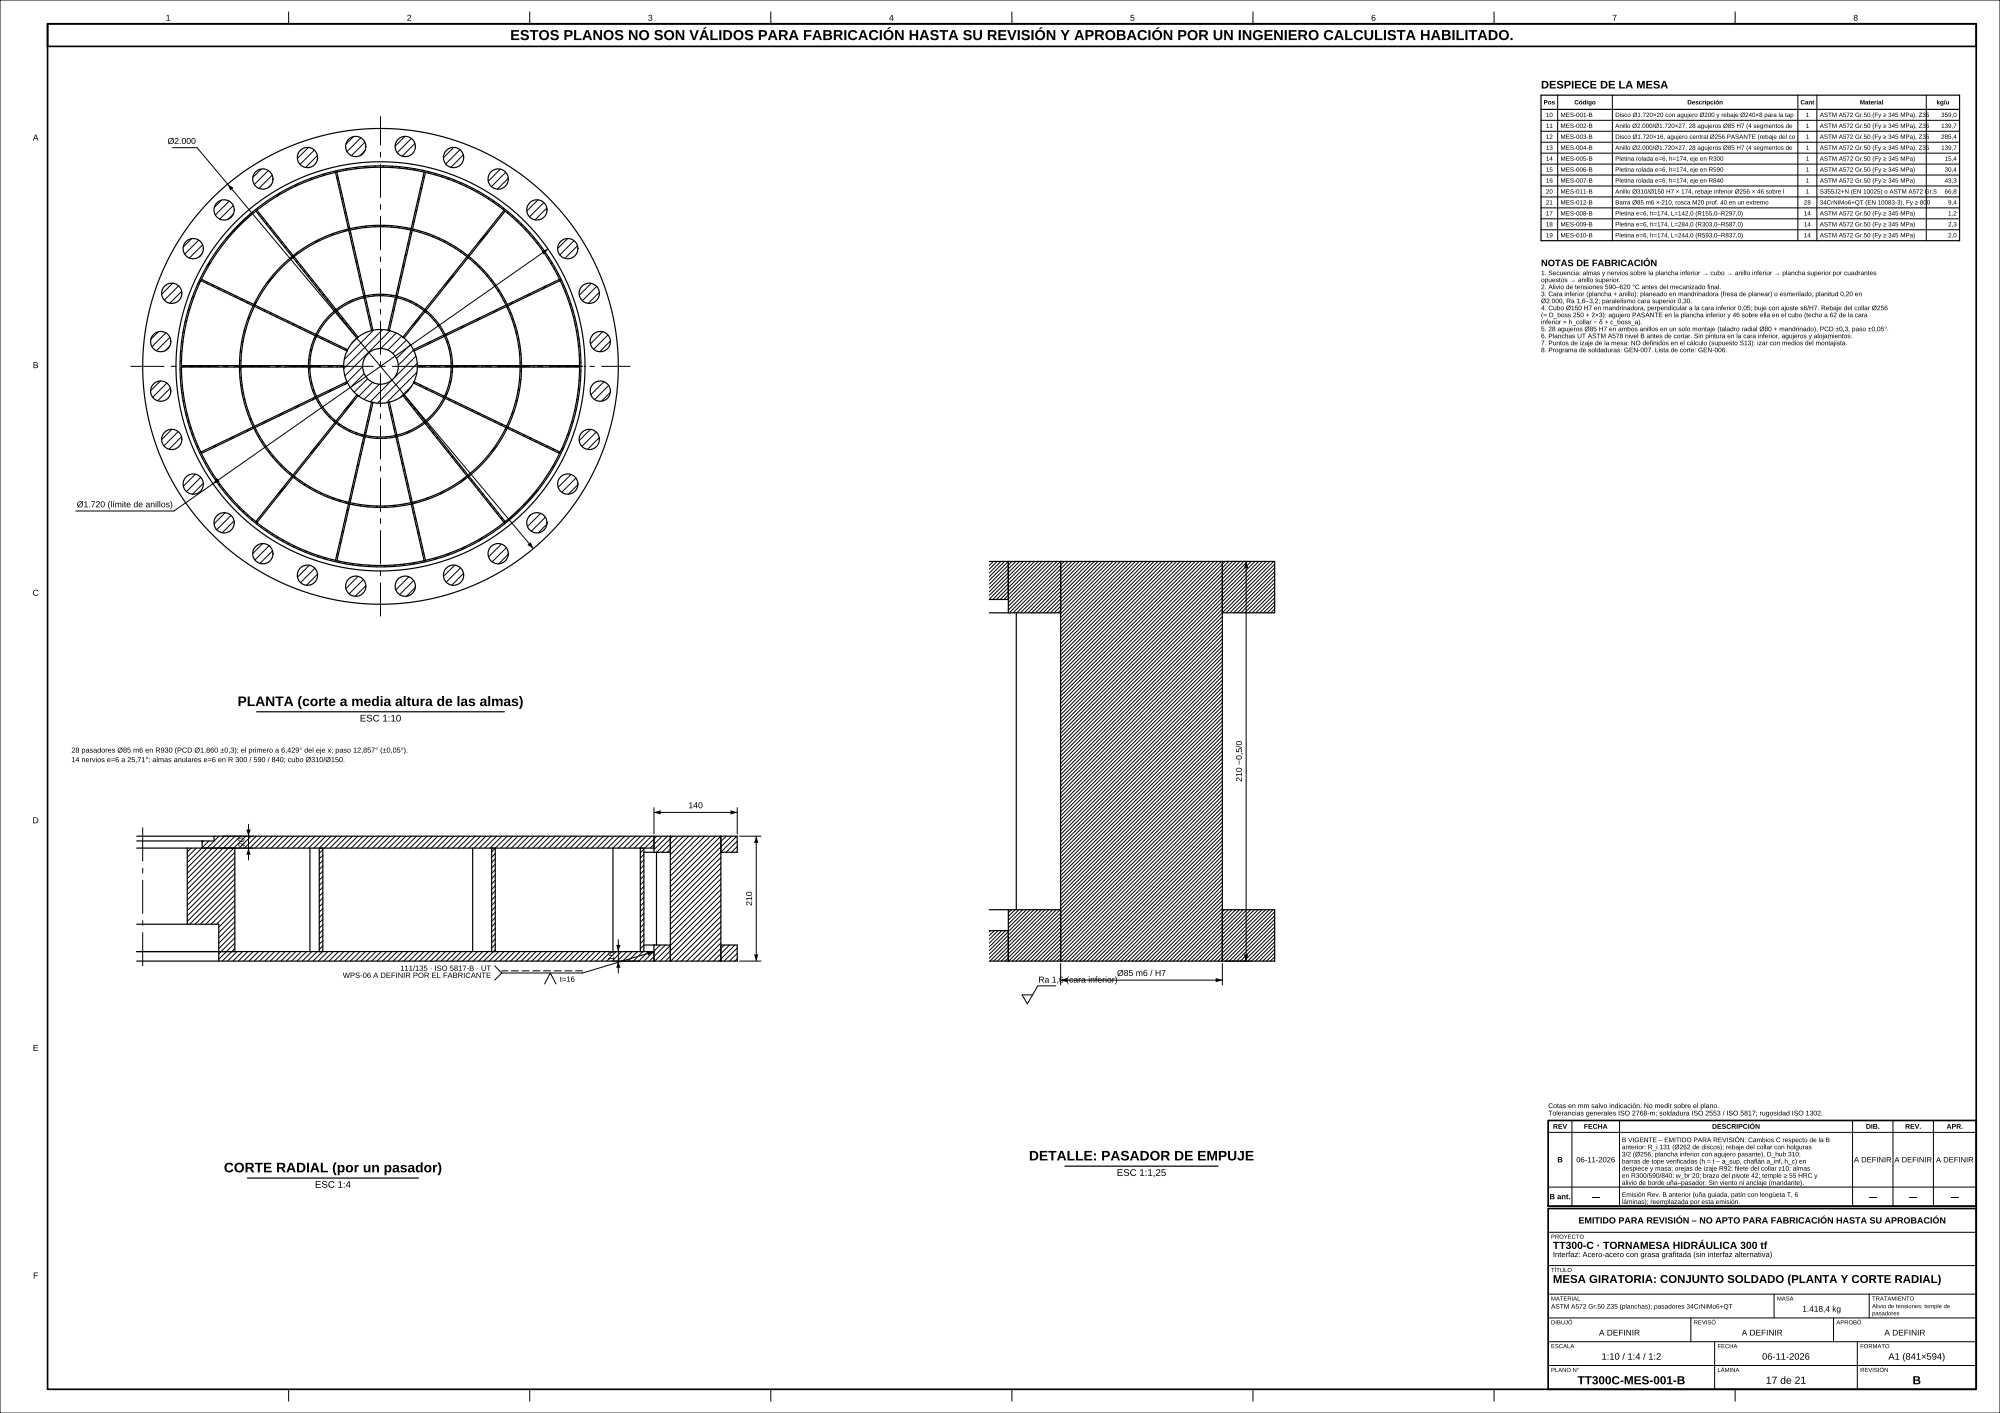
[picture p63: page 17]

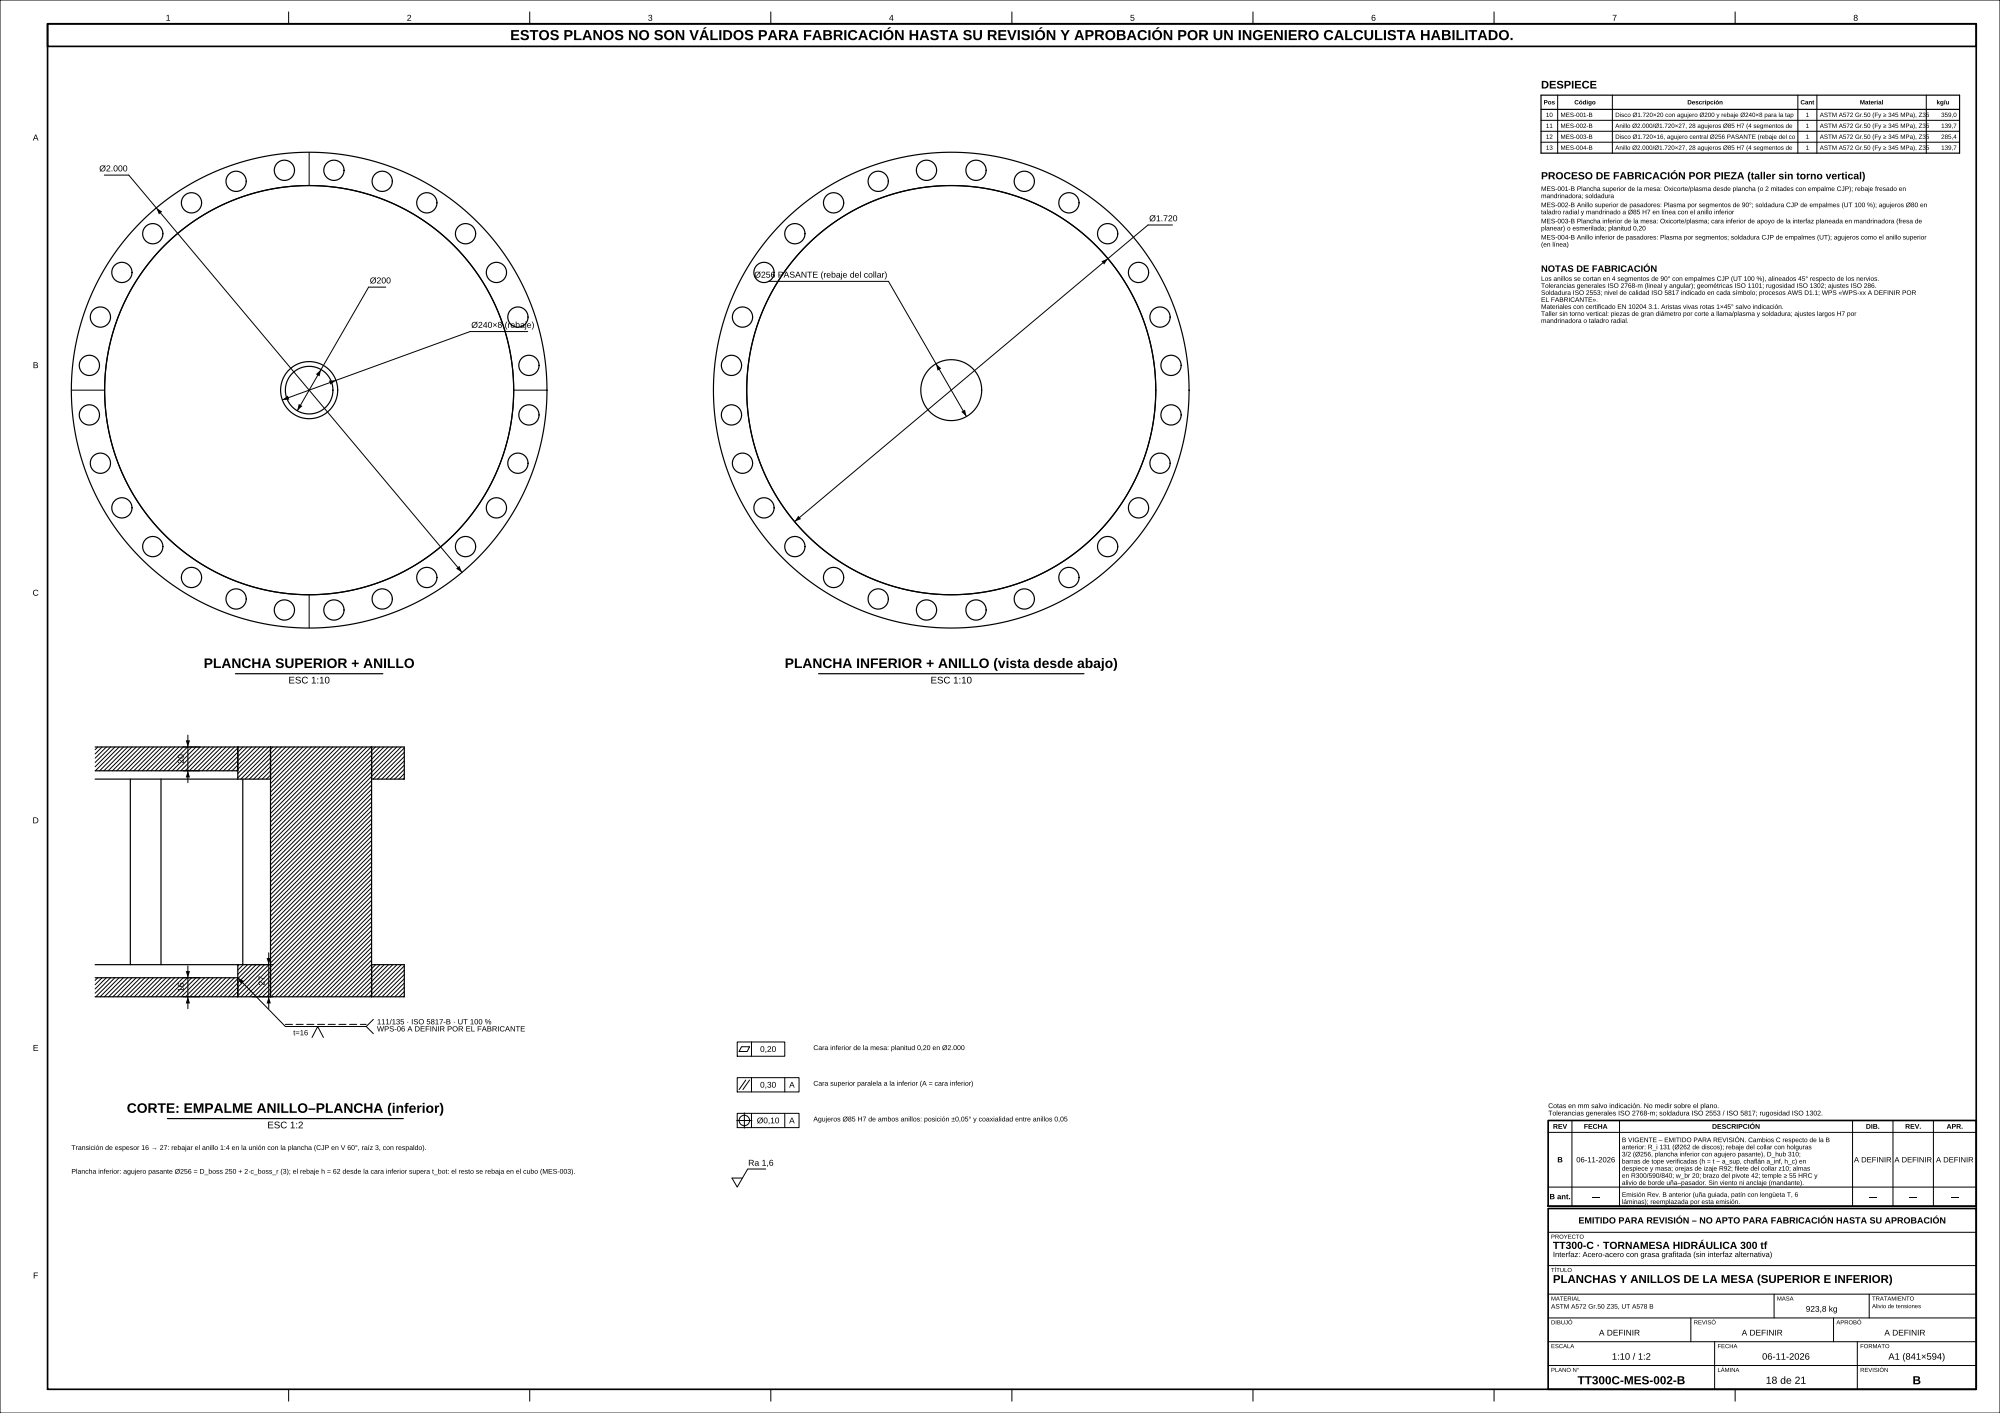
[picture p64: page 18]

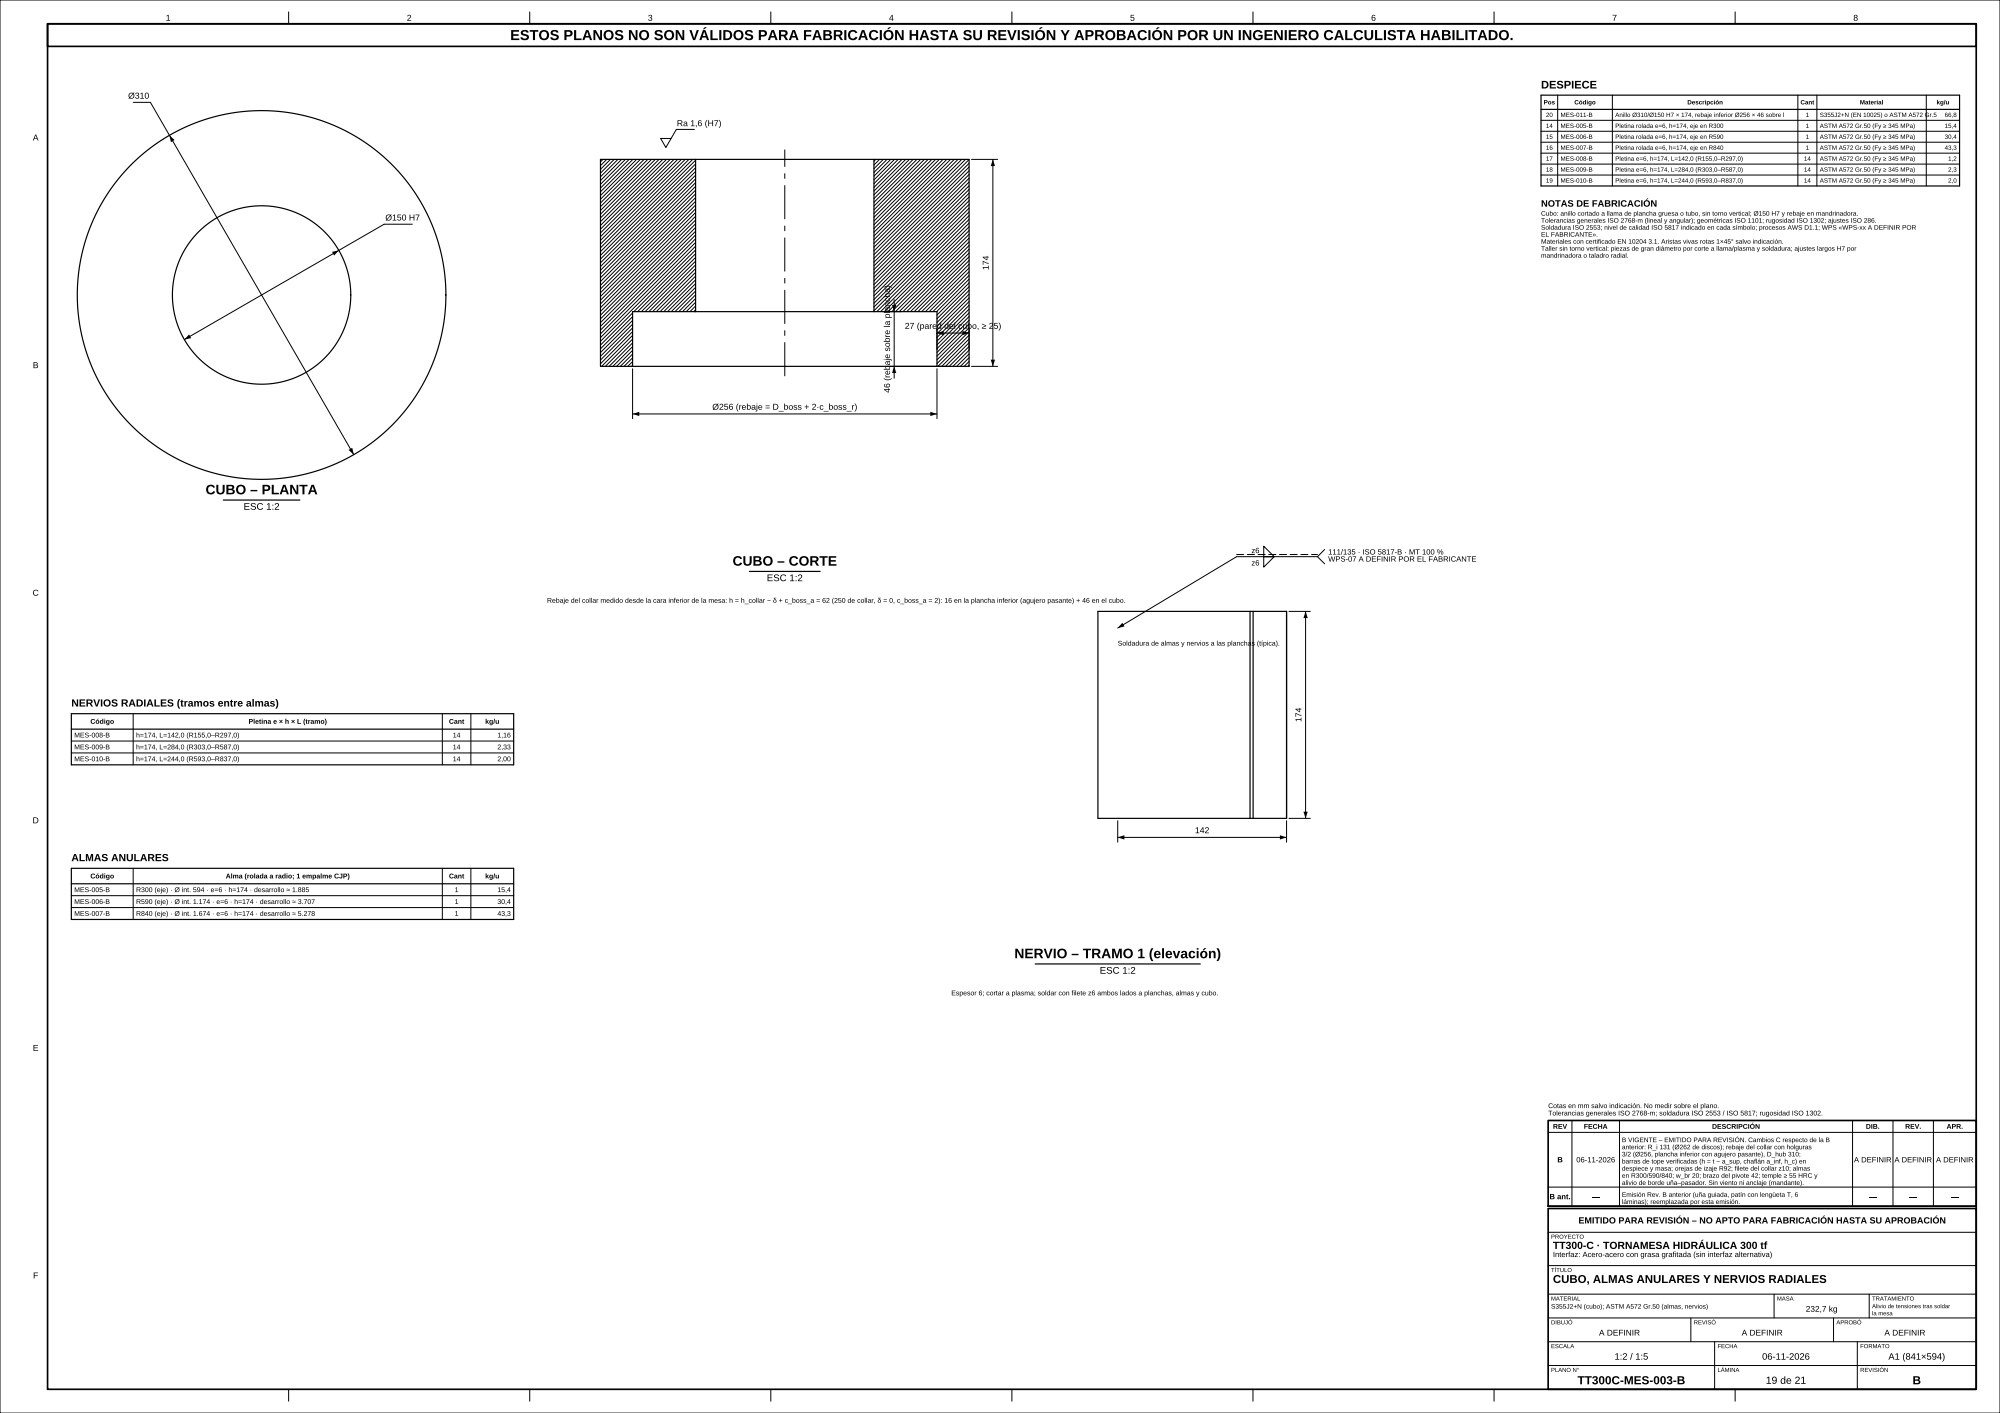
[picture p65: page 19]


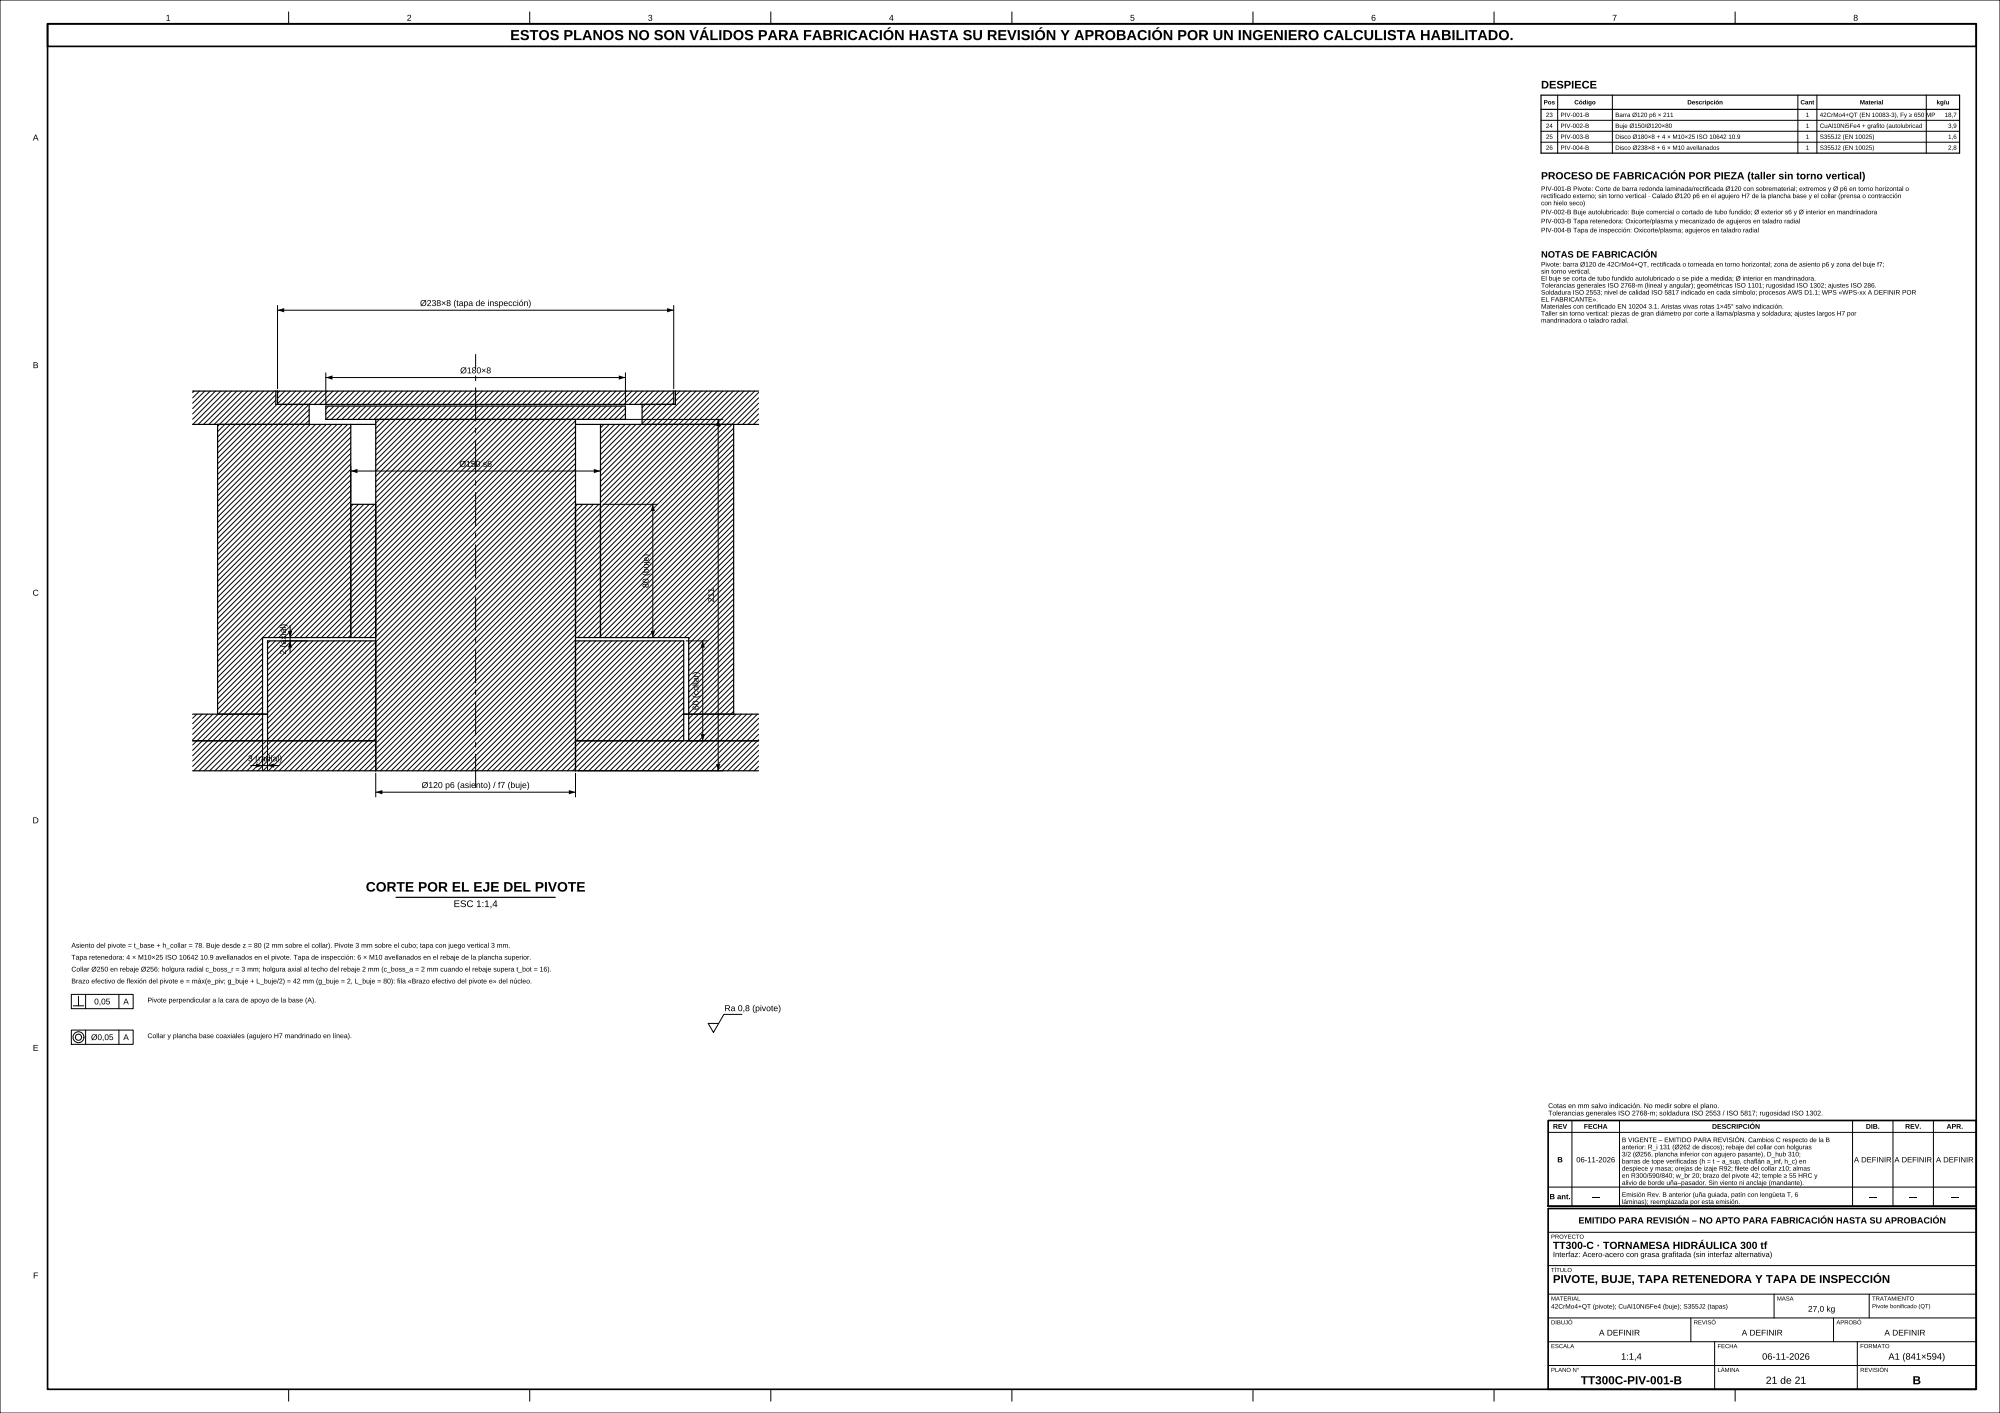
[picture p66: page 21]
