mafiucivil/Tornamesa/entregables/RevC/planos/TT300C-ACC-001-C.pdf

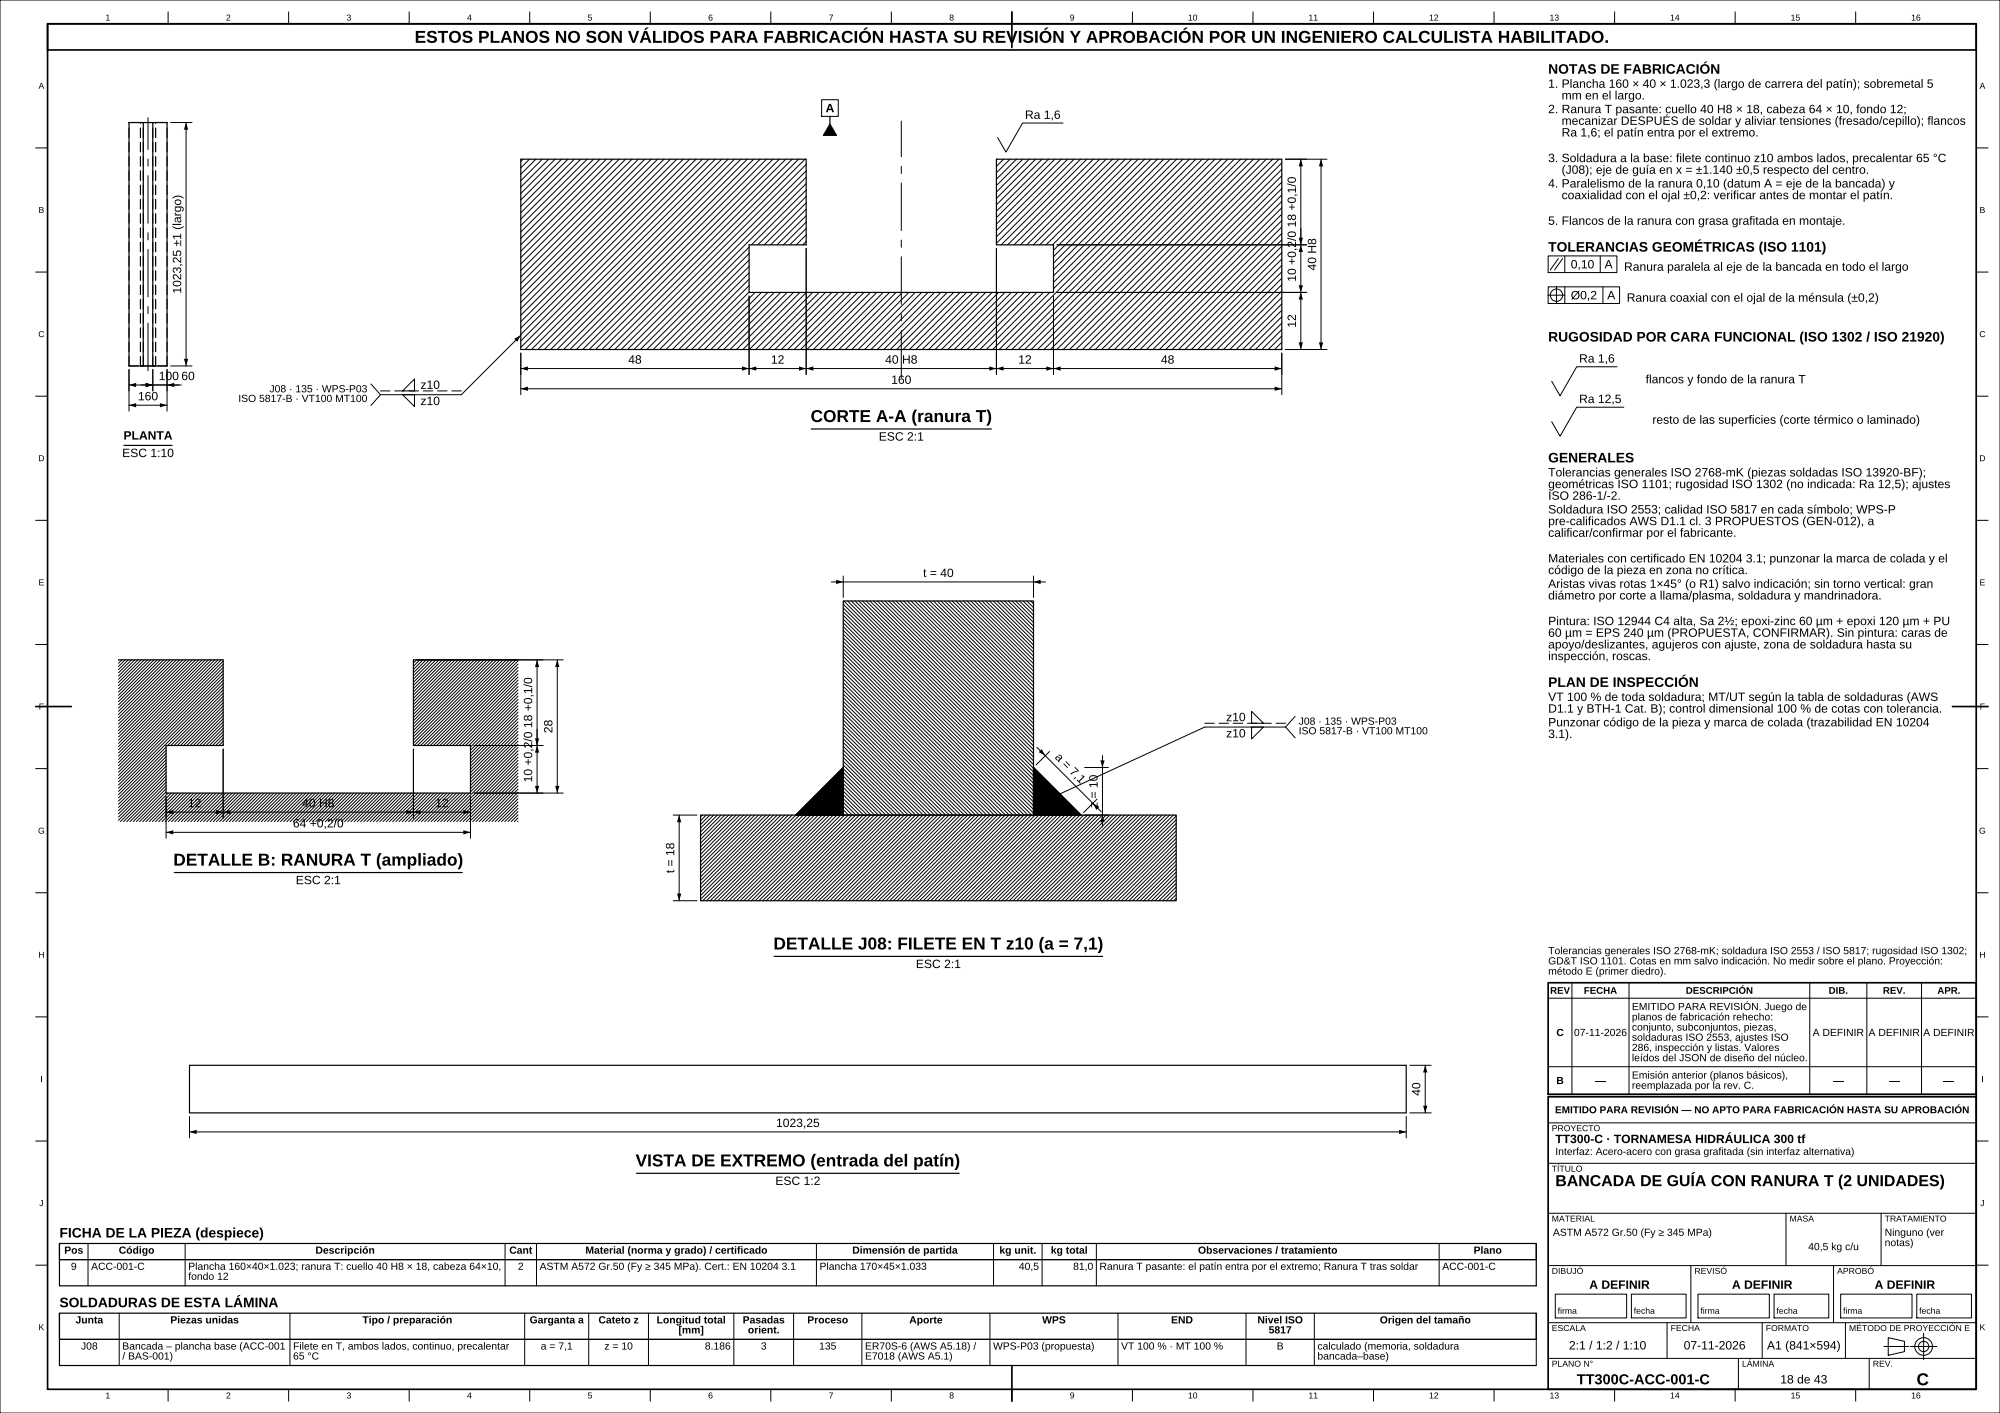
[picture p67: page 1]
