mafiucivil/Tornamesa/entregables/RevC/planos/TT300C-ACC-002-C.pdf

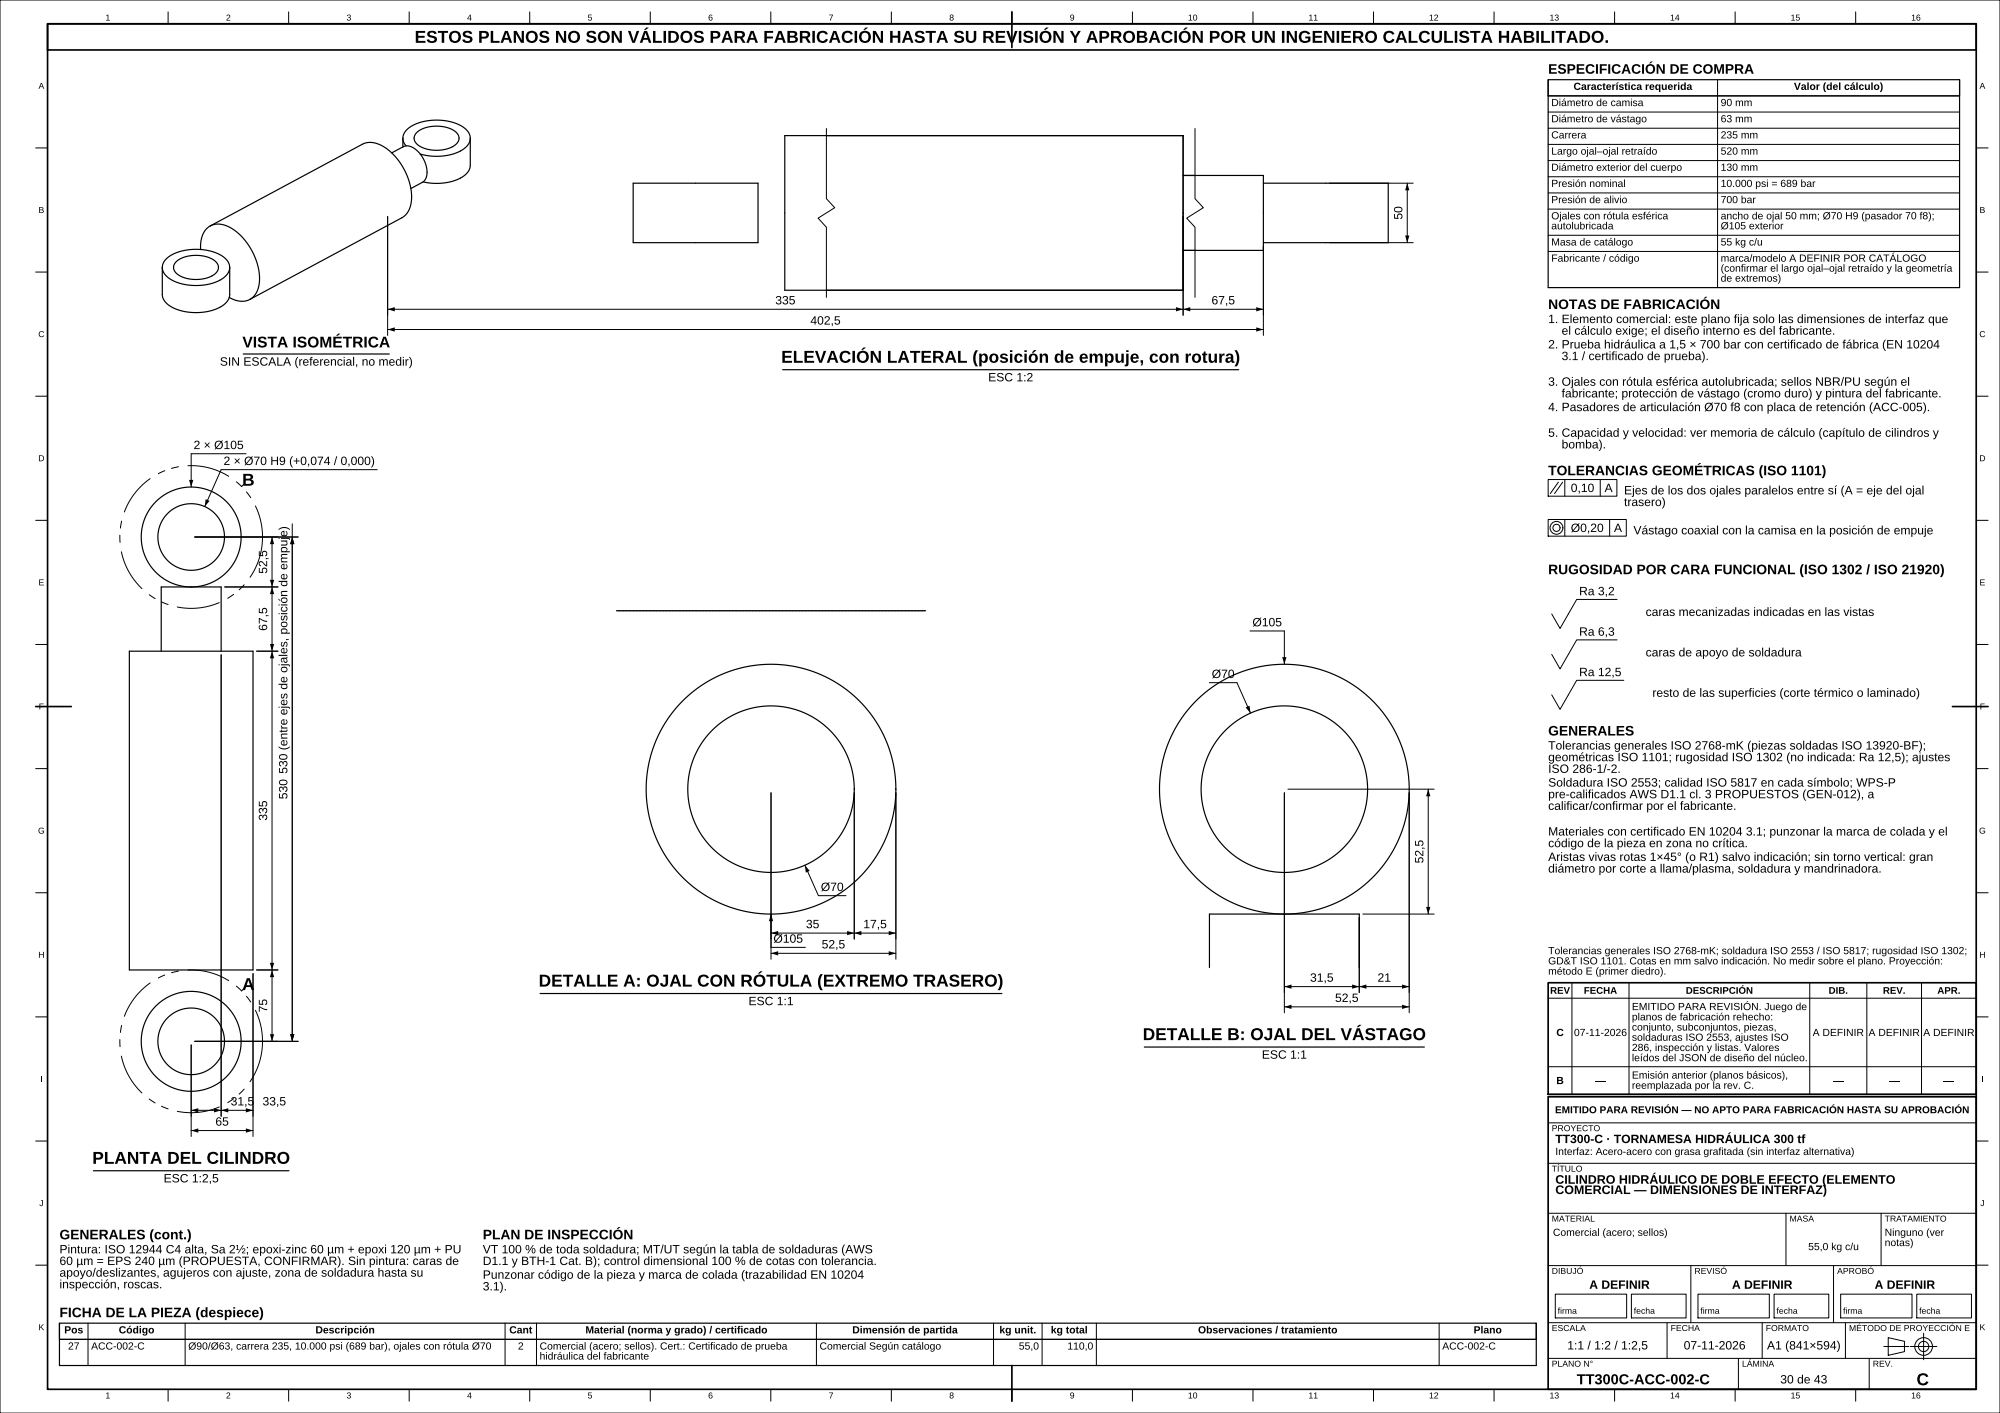
[picture p68: page 1]
