mafiucivil/Tornamesa/entregables/RevC/planos/TT300C-ACC-003-C.pdf

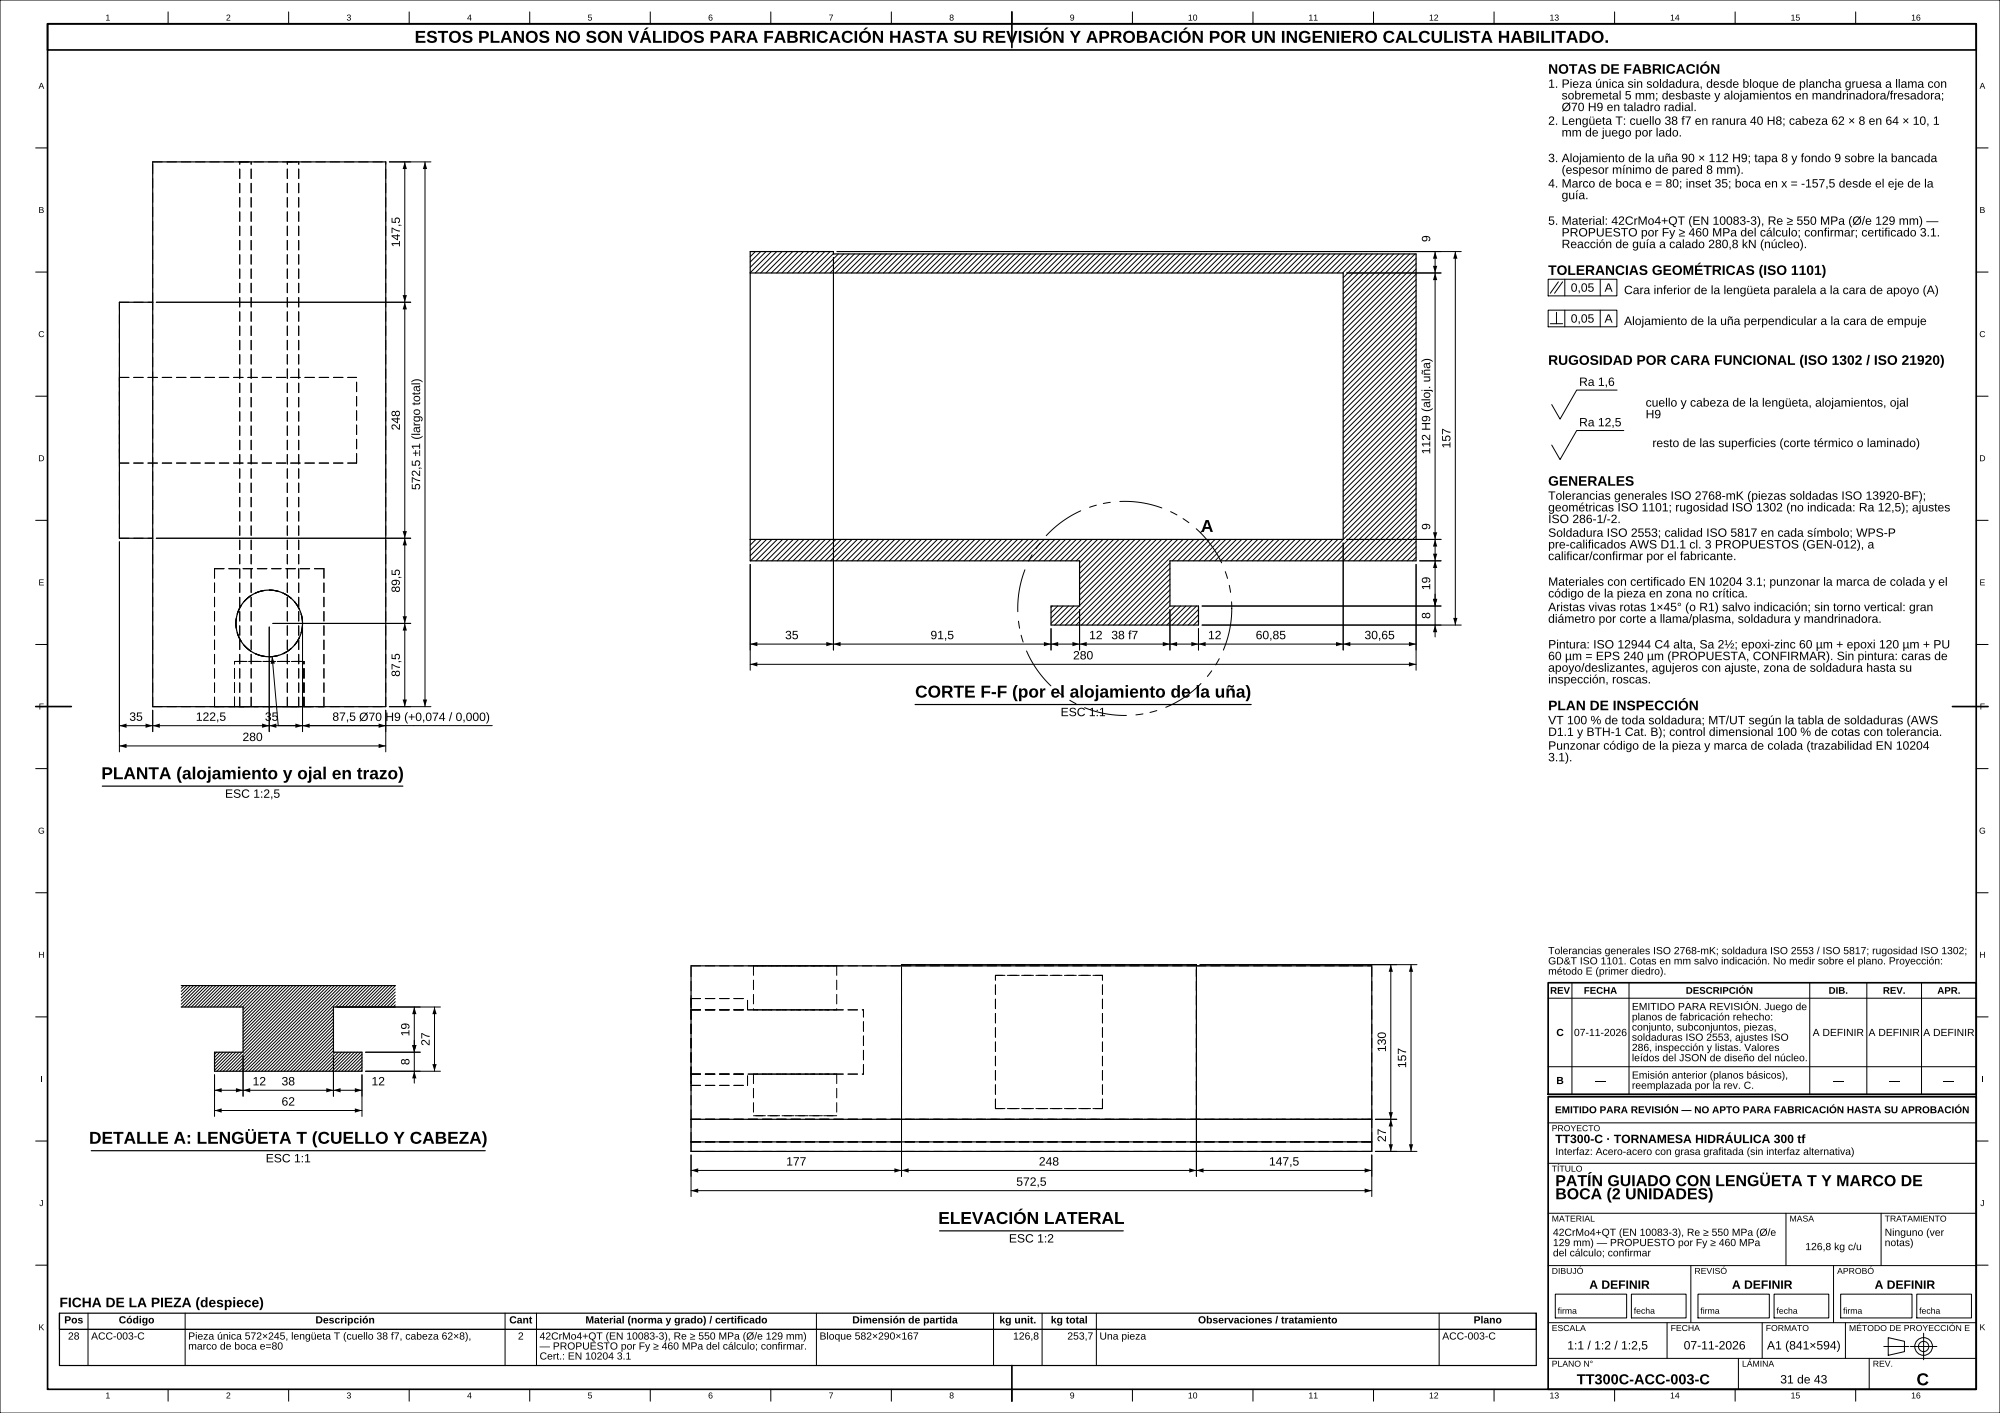
[picture p69: page 1]
