mafiucivil/Tornamesa/entregables/RevC/planos/TT300C-ACC-004-C.pdf

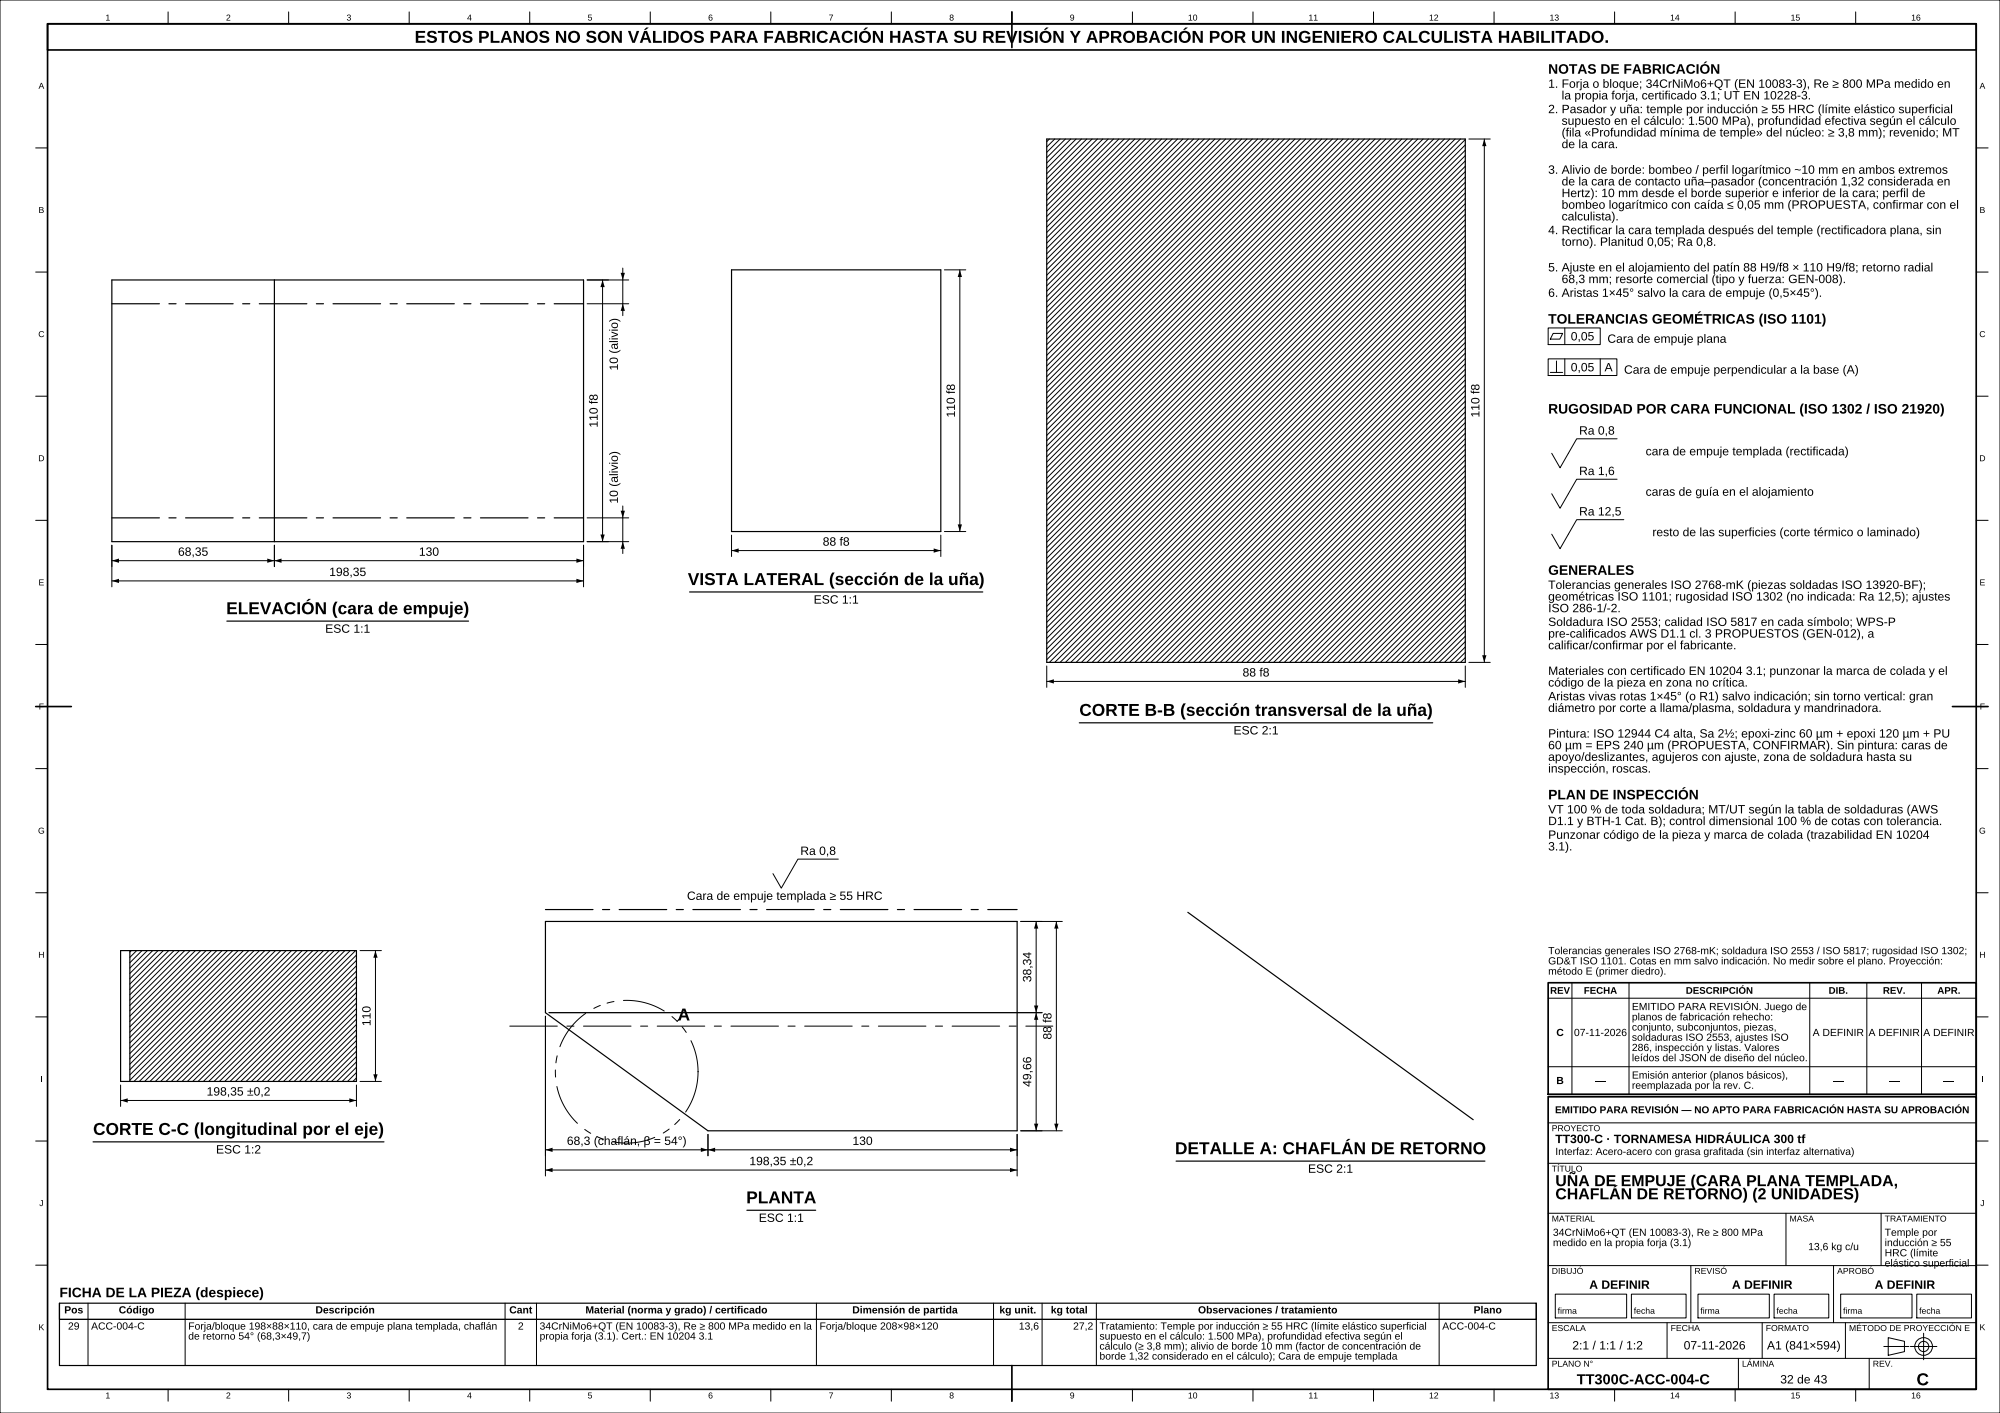
[picture p70: page 1]
