mafiucivil/Tornamesa/entregables/RevC/planos/TT300C-ACC-005-C.pdf

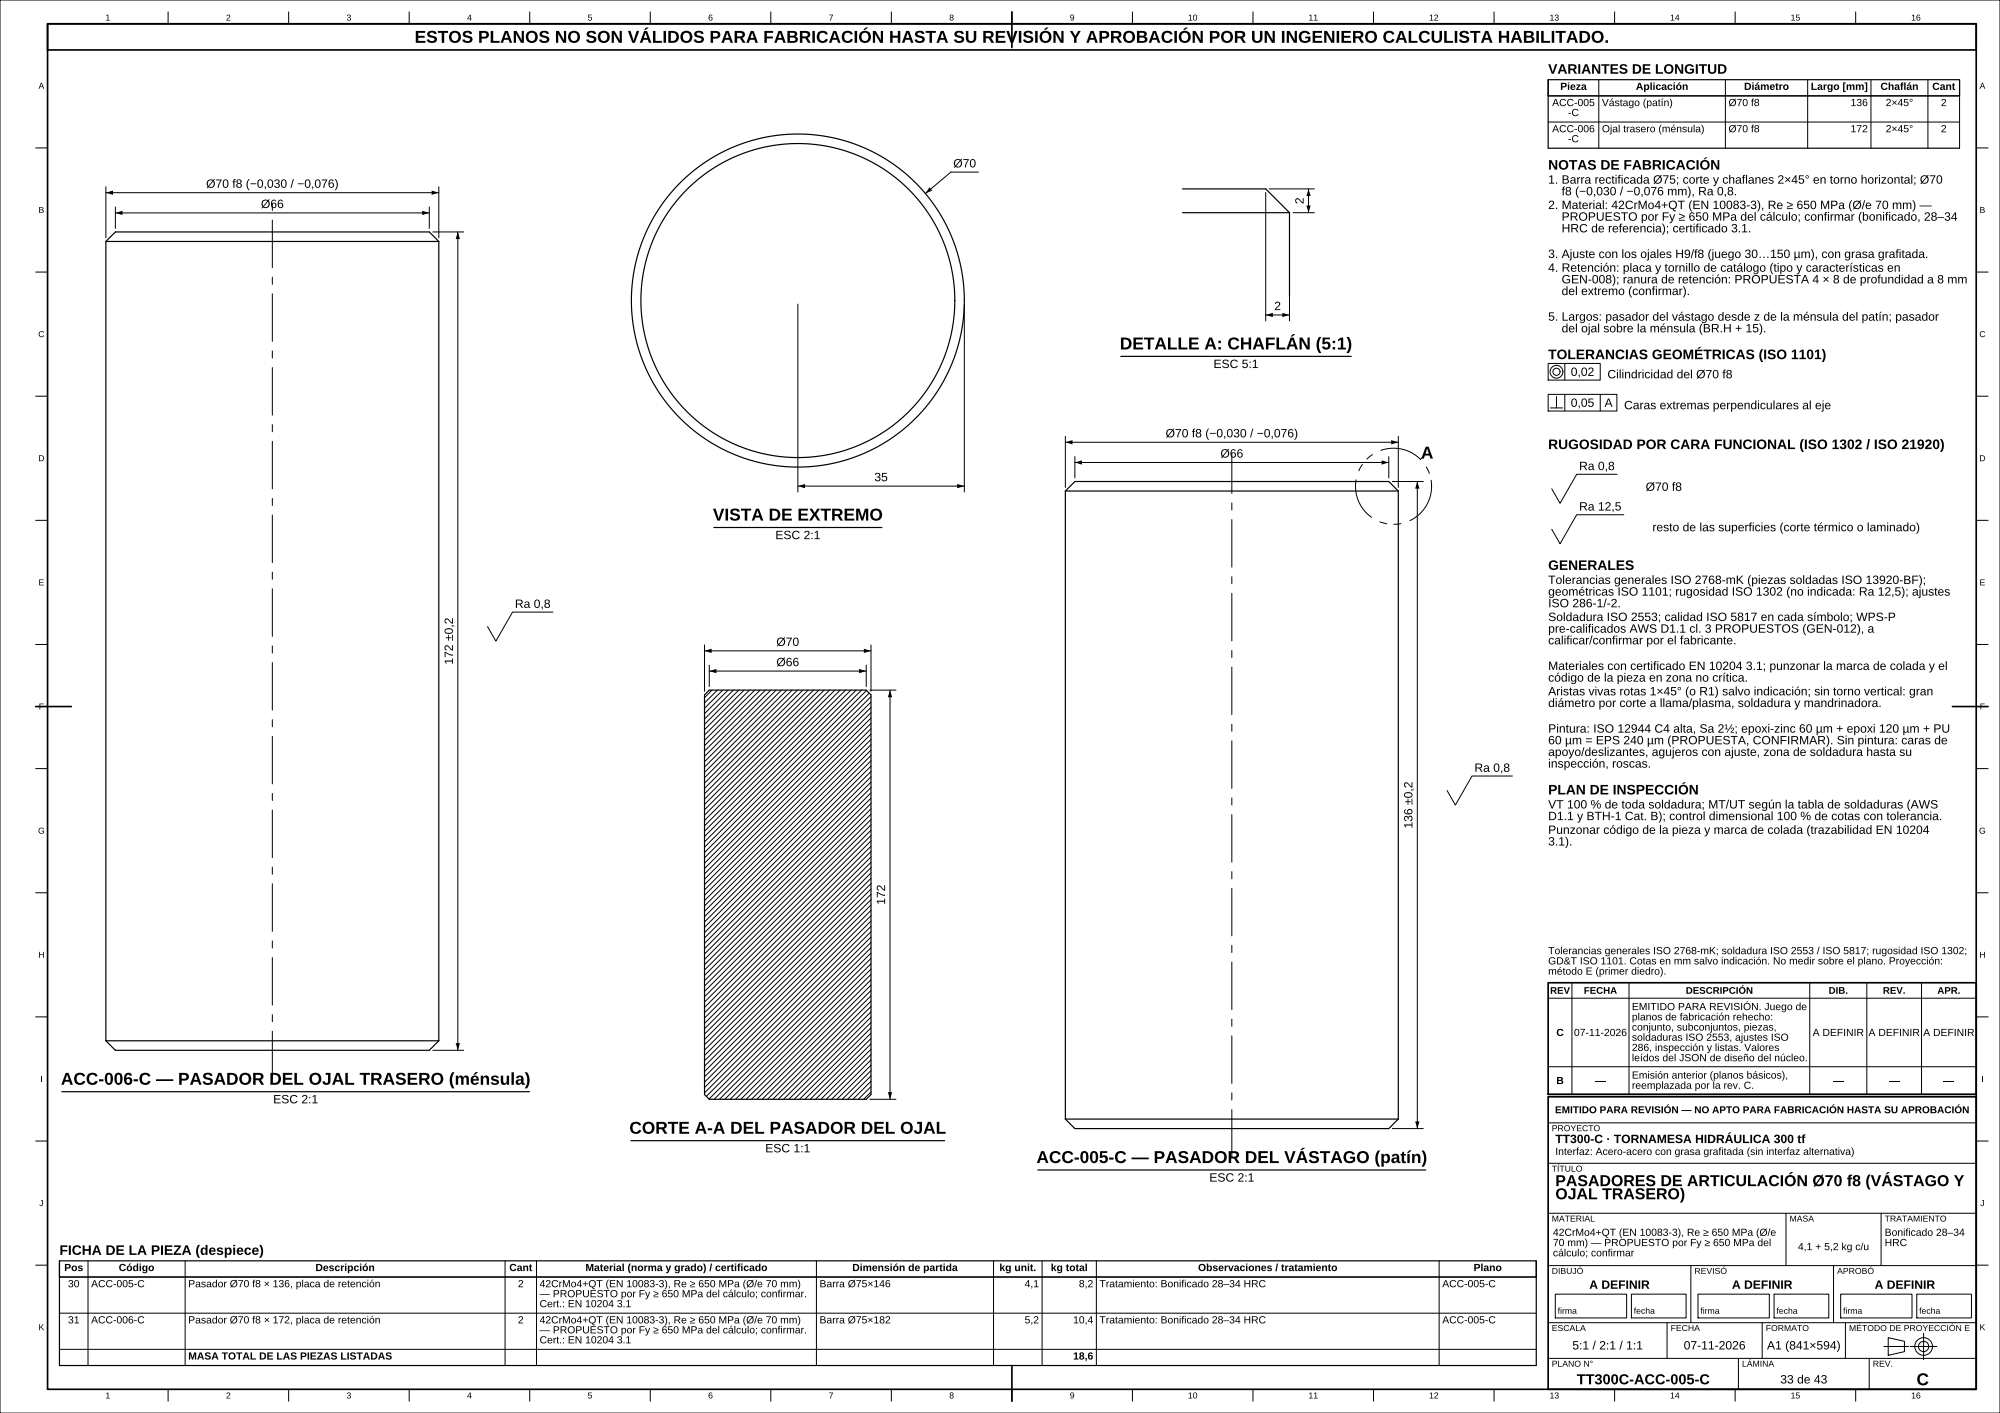
[picture p71: page 1]
