mafiucivil/Tornamesa/entregables/RevC/planos/TT300C-BAS-001-C.pdf

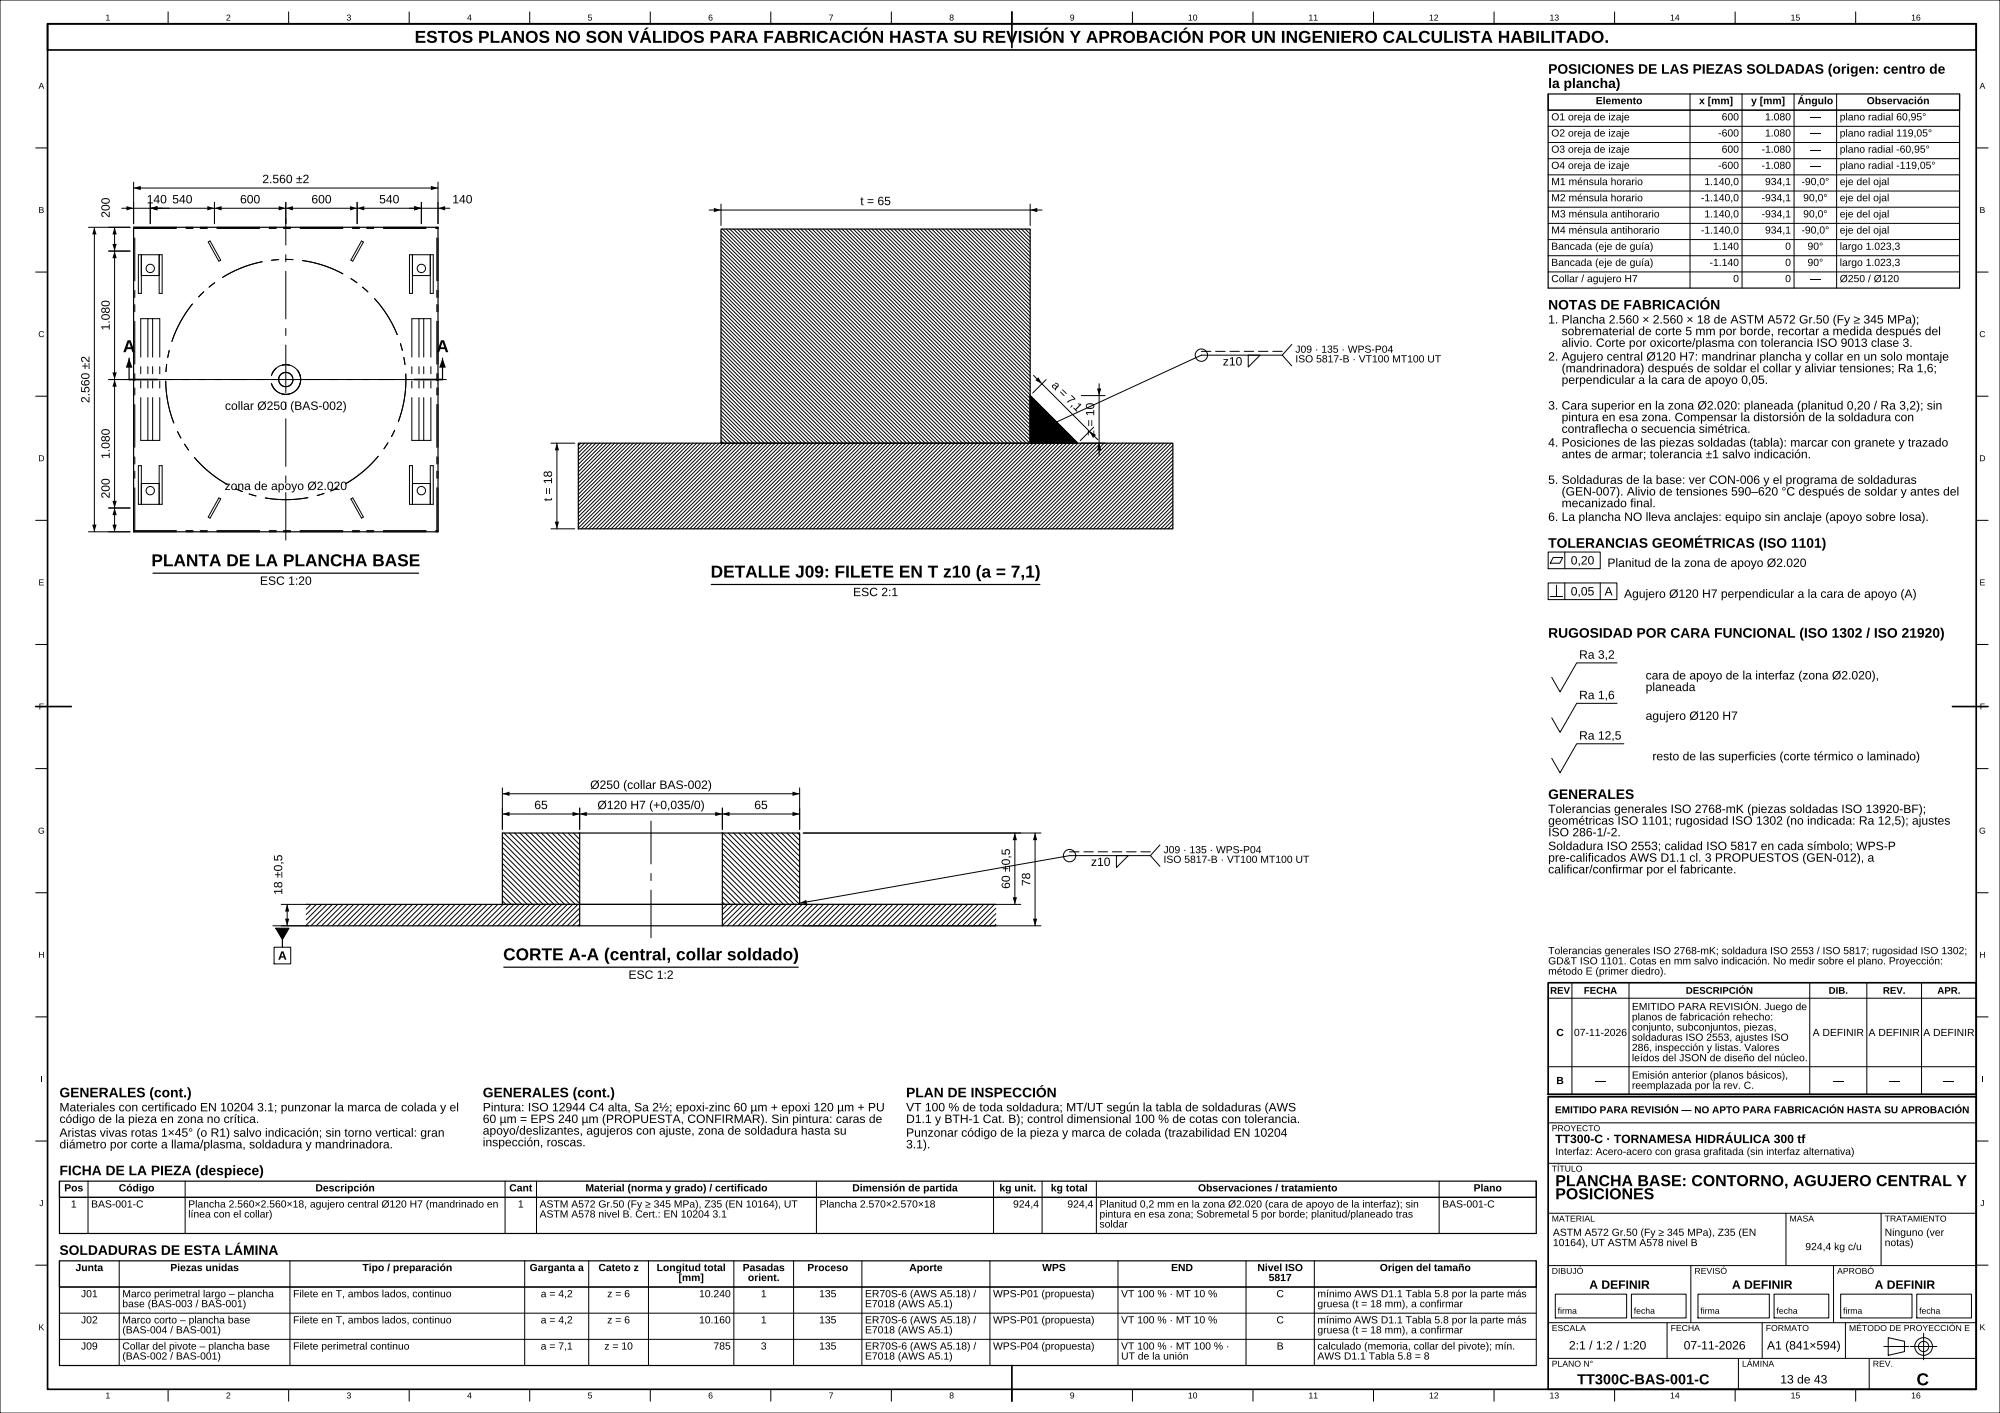
[picture p72: page 1]
