mafiucivil/Tornamesa/entregables/RevC/planos/TT300C-BAS-002-C.pdf

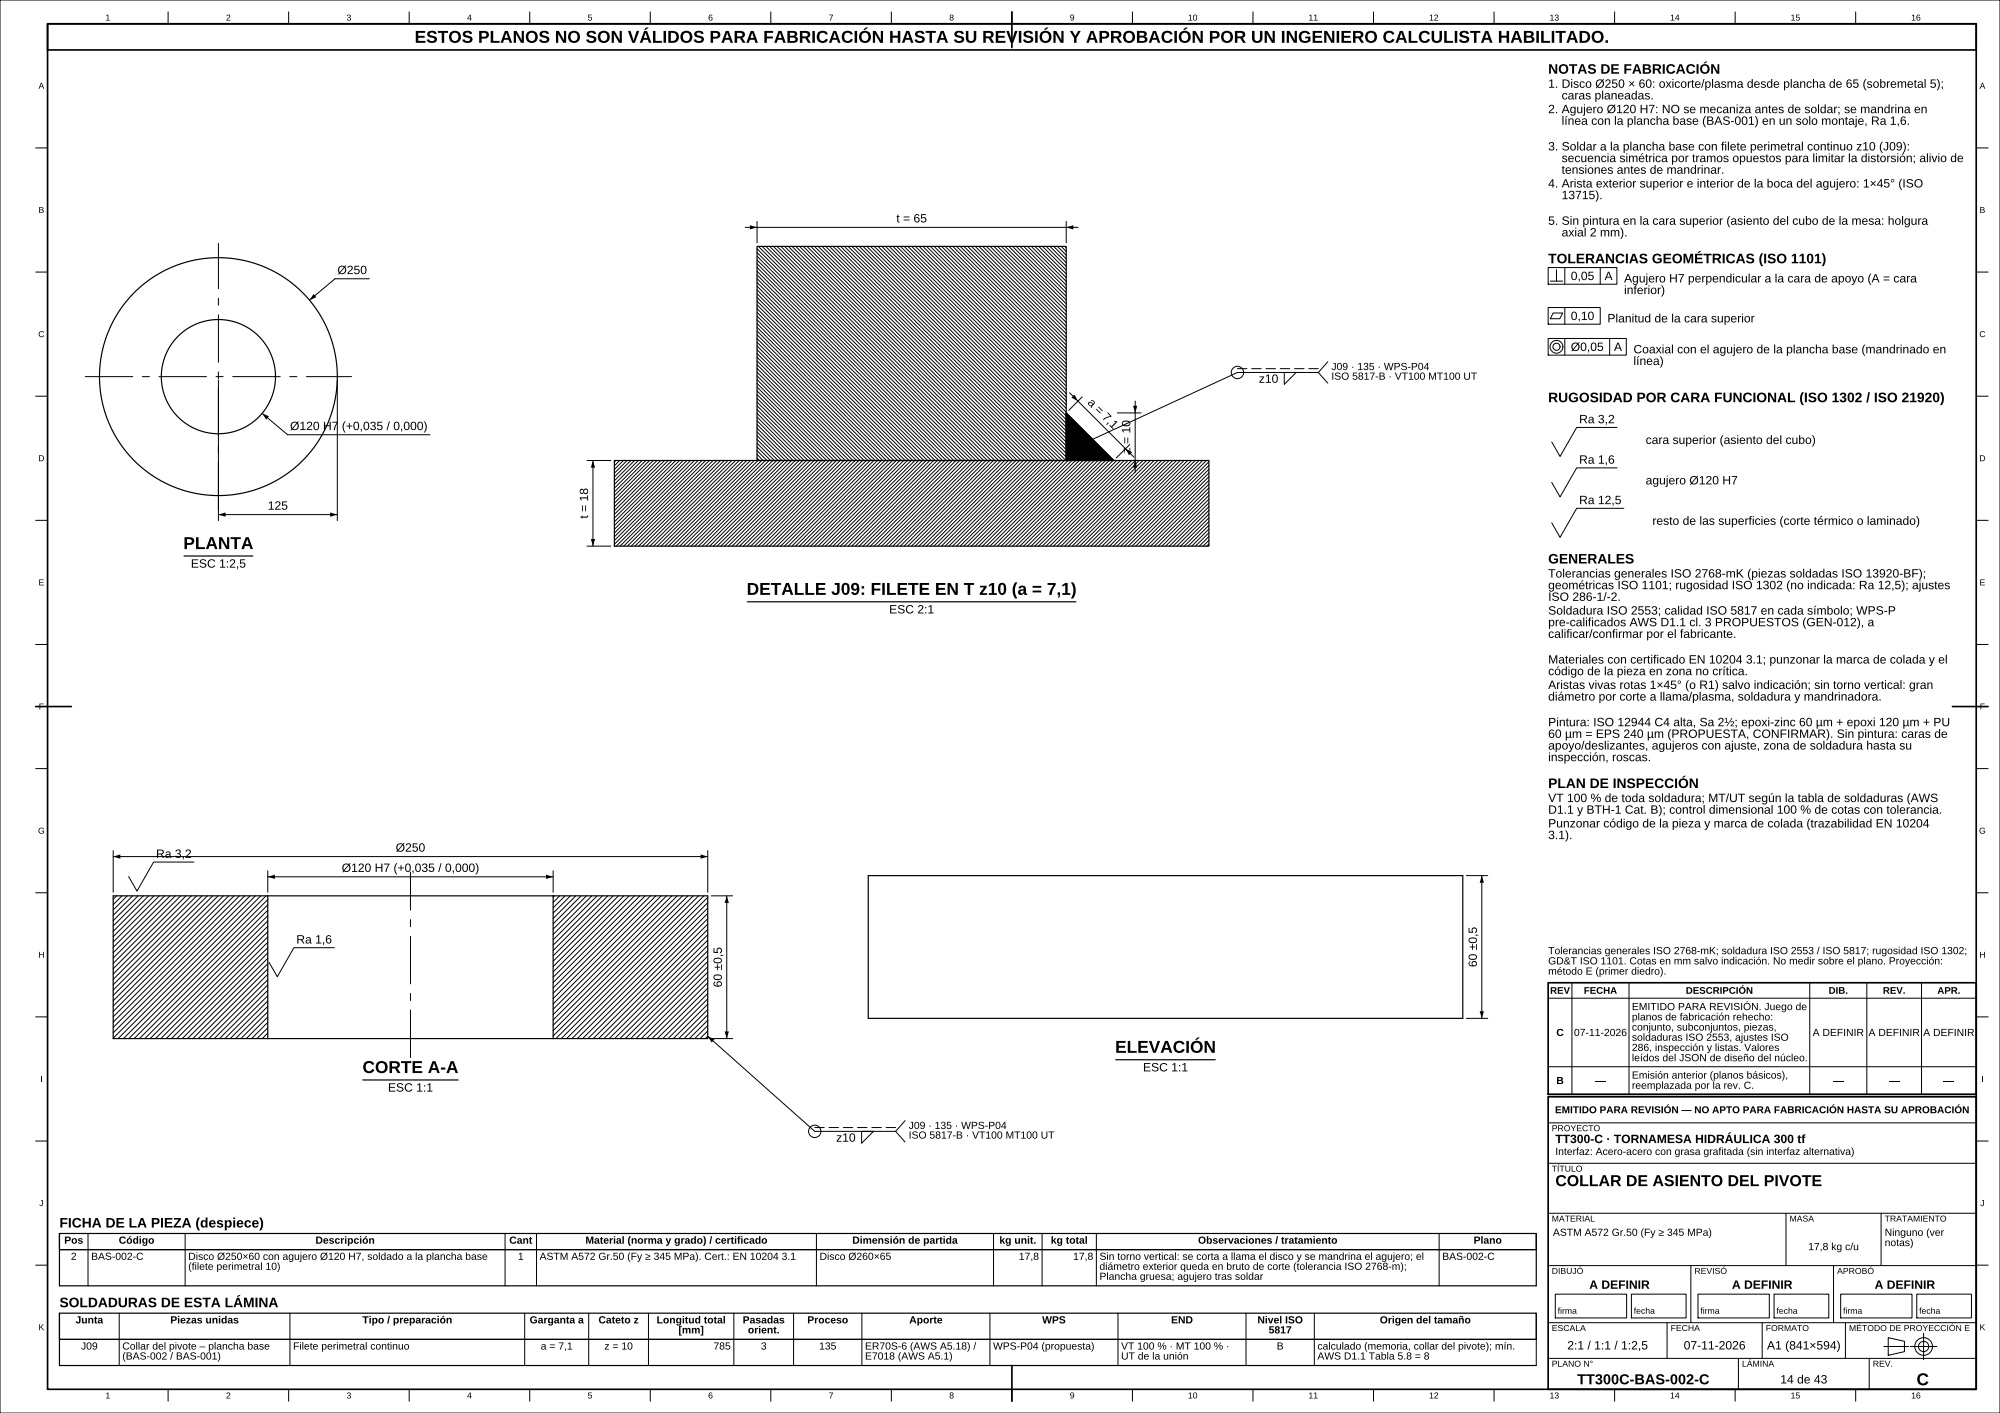
[picture p73: page 1]
