mafiucivil/Tornamesa/entregables/RevC/planos/TT300C-BAS-003-C.pdf

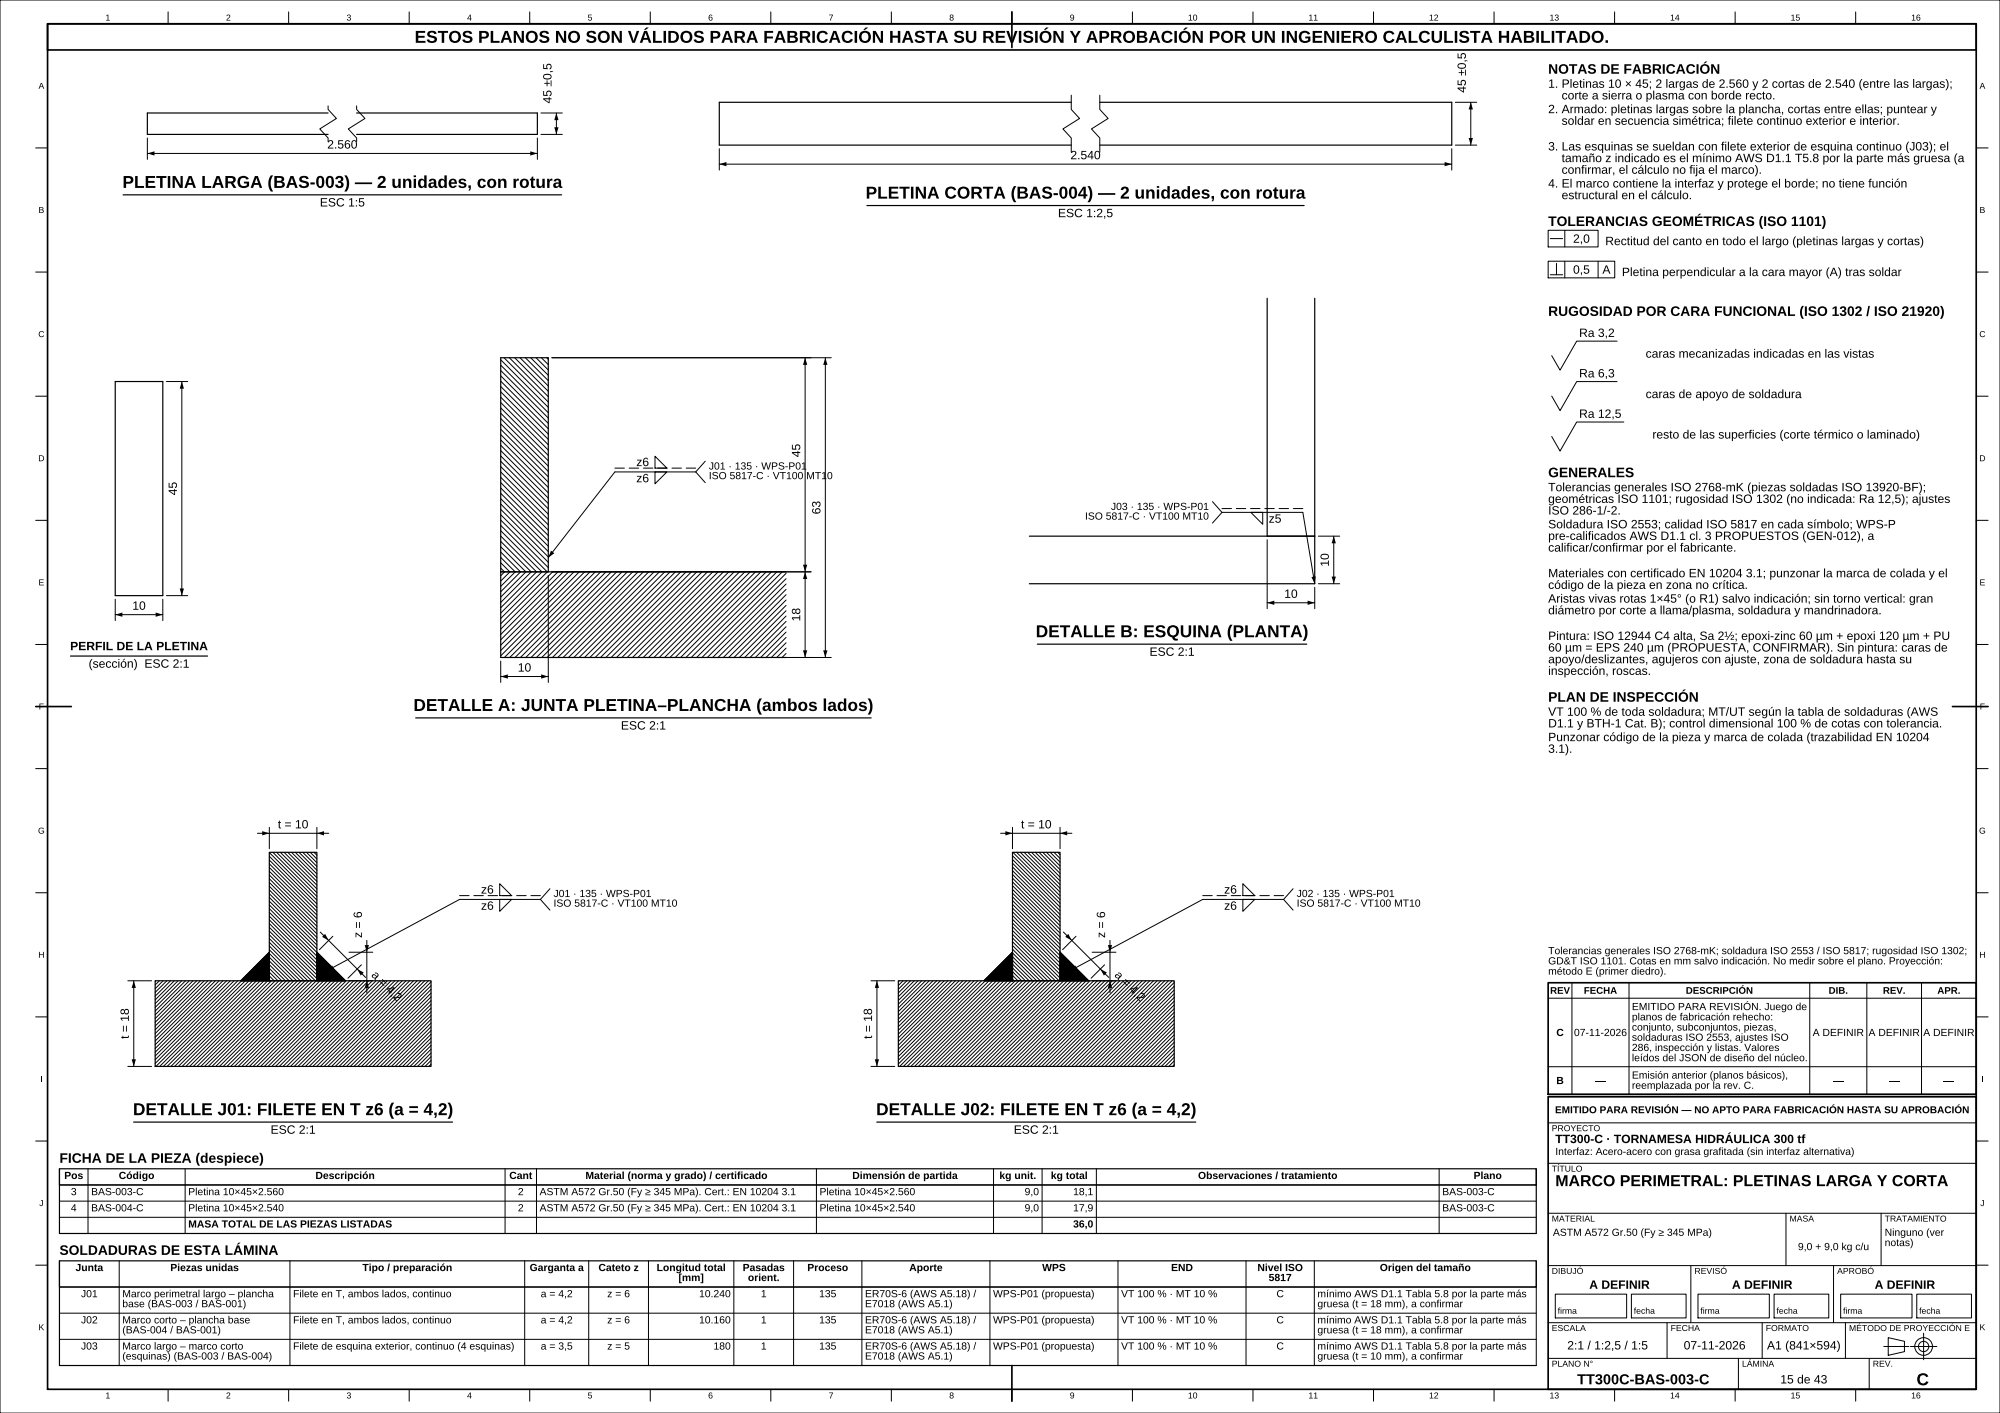
[picture p74: page 1]
