mafiucivil/Tornamesa/entregables/RevC/planos/TT300C-BAS-005-C.pdf

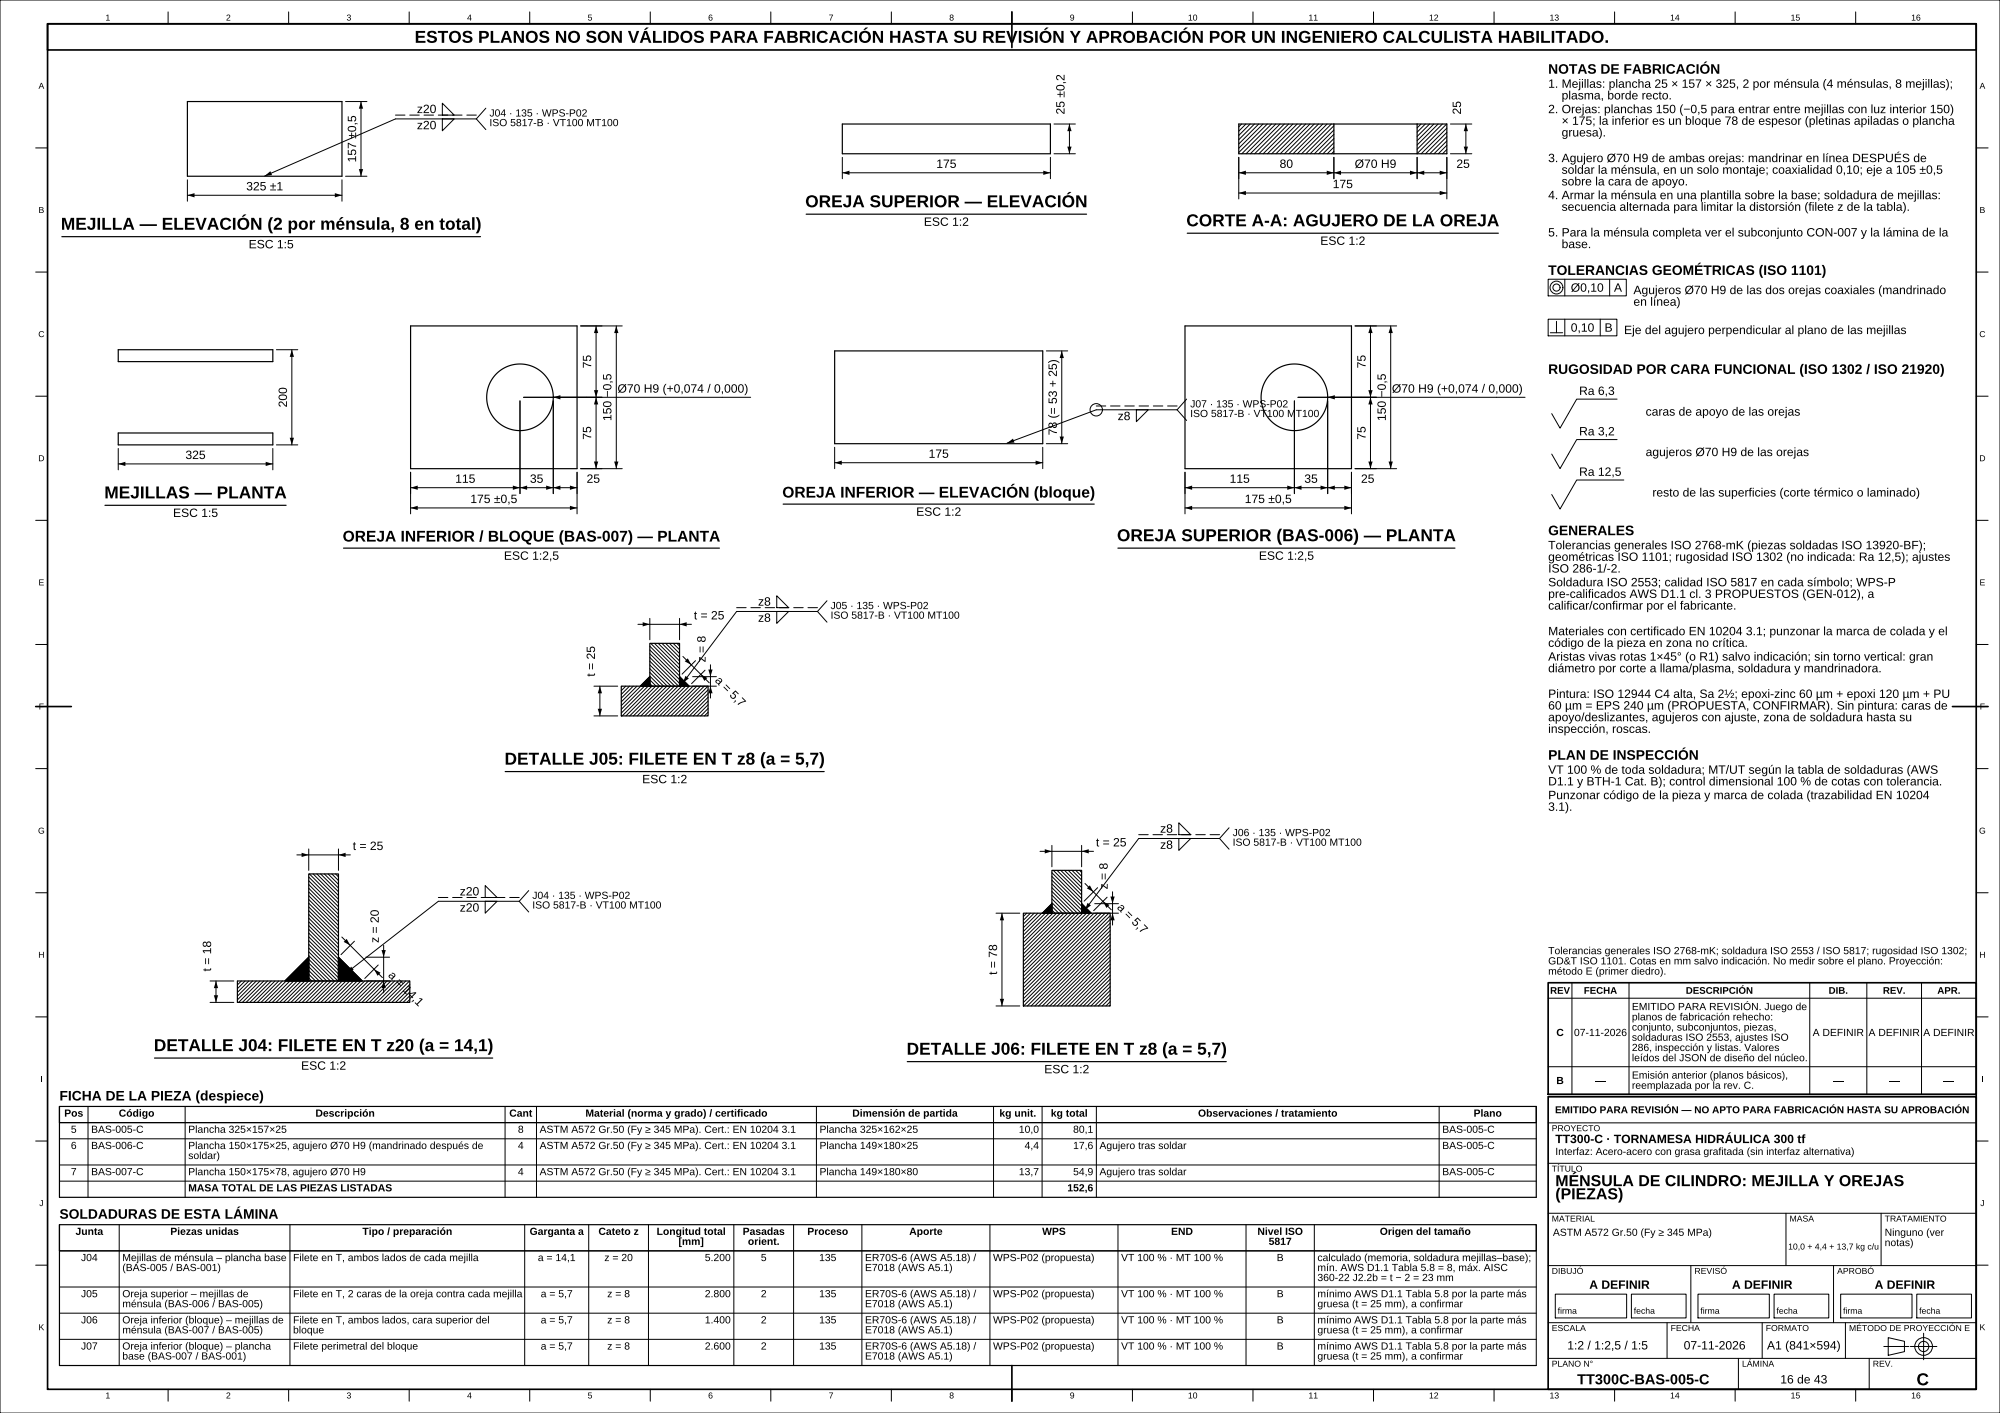
[picture p75: page 1]
