mafiucivil/Tornamesa/entregables/RevC/planos/TT300C-CON-001-C.pdf

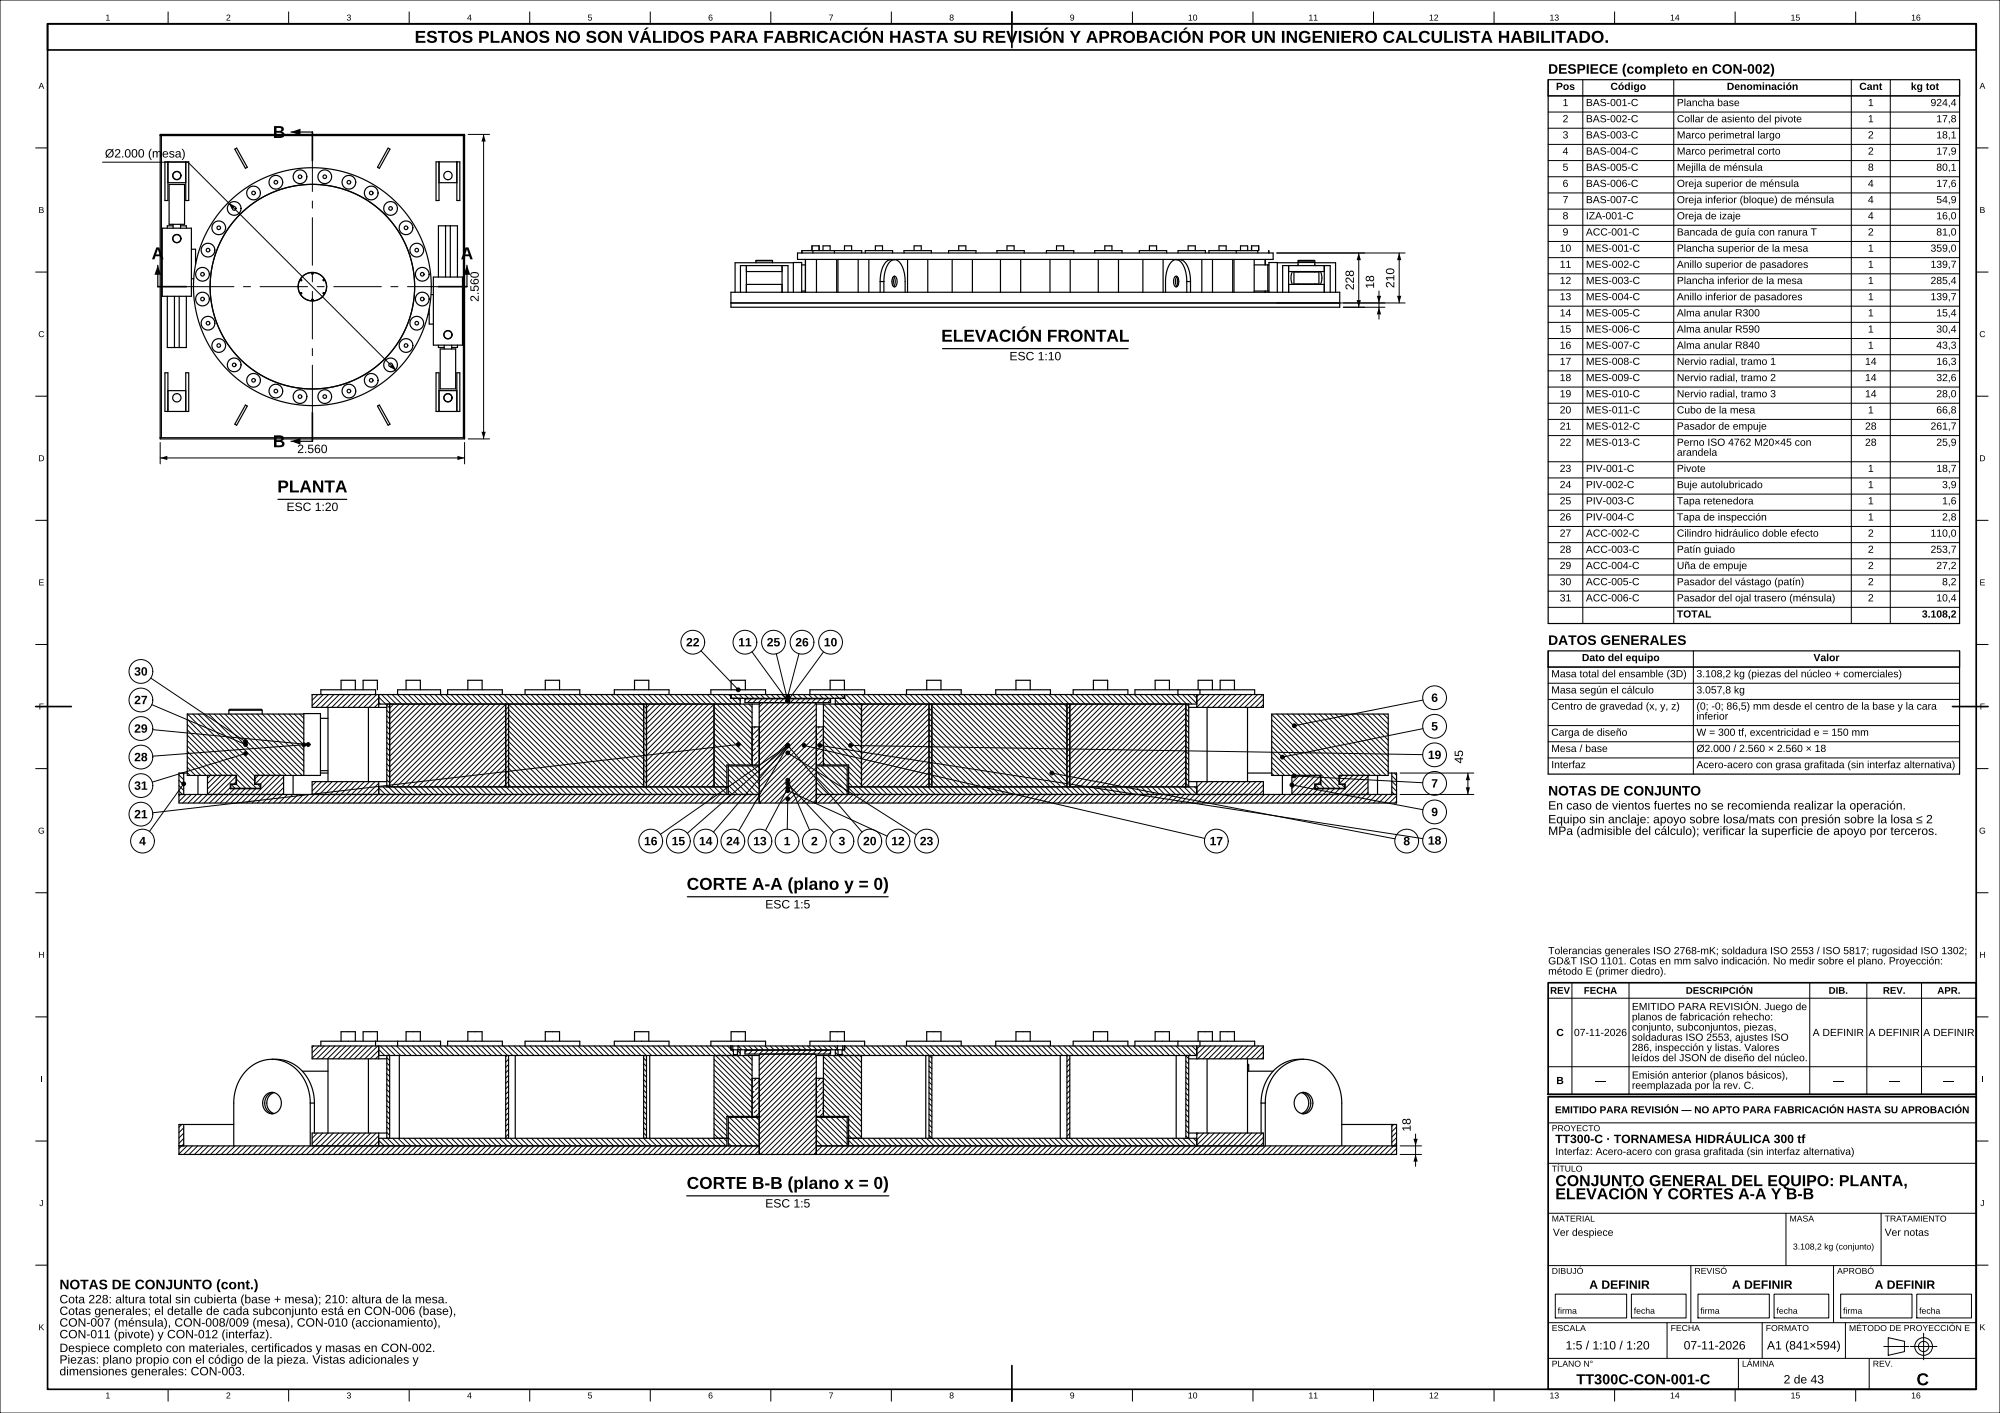
[picture p76: page 1]
