mafiucivil/Tornamesa/entregables/RevC/planos/TT300C-CON-002-C.pdf

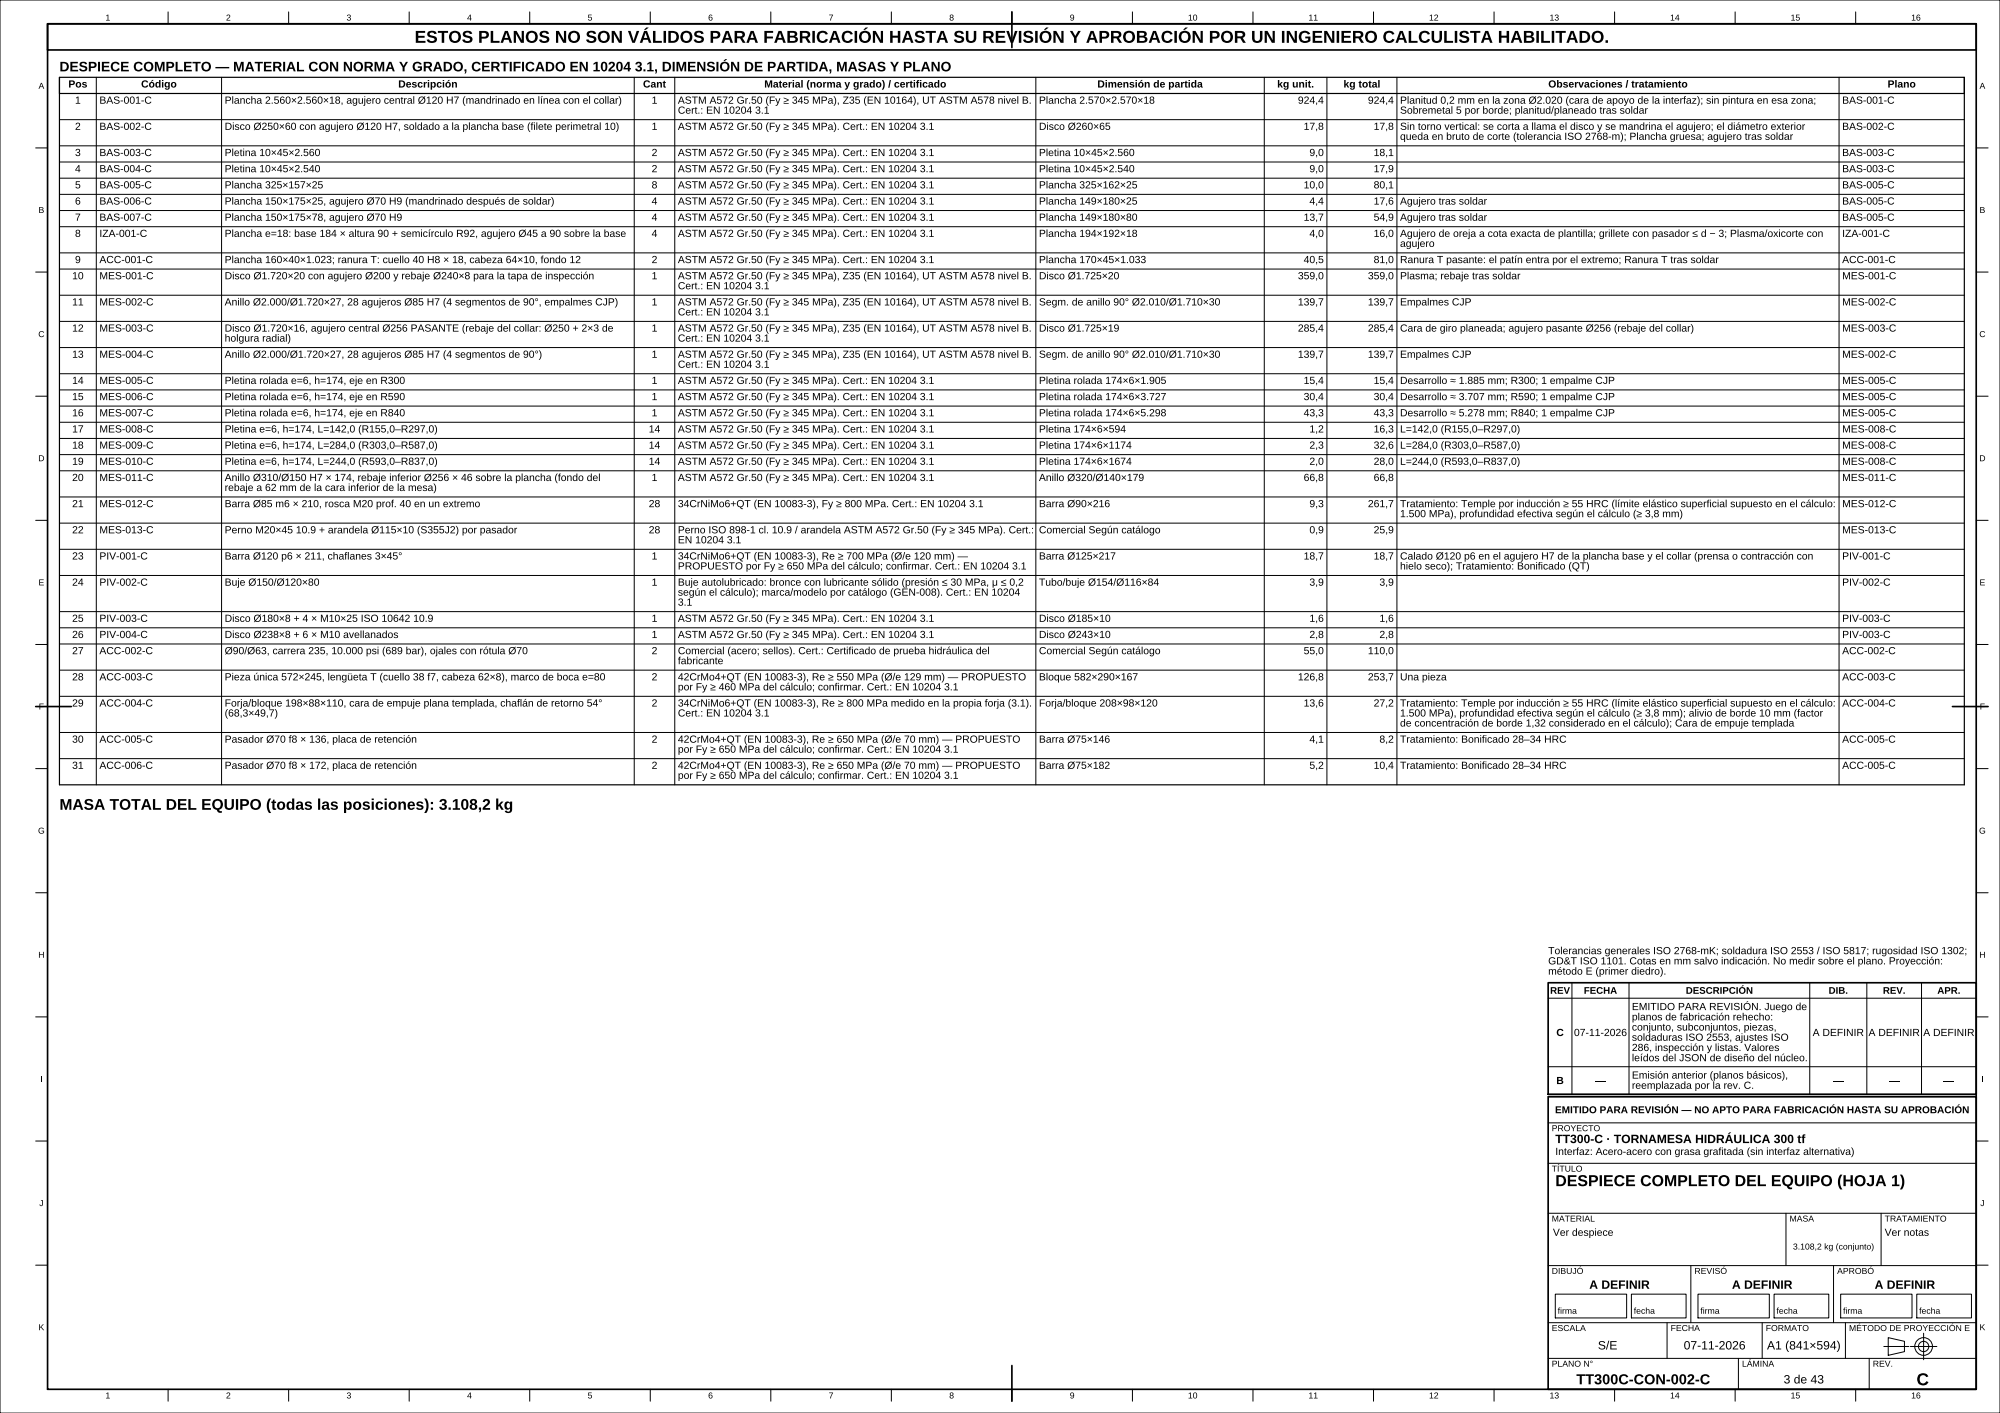
[picture p77: page 1]
