mafiucivil/Tornamesa/entregables/RevC/planos/TT300C-CON-003-C.pdf

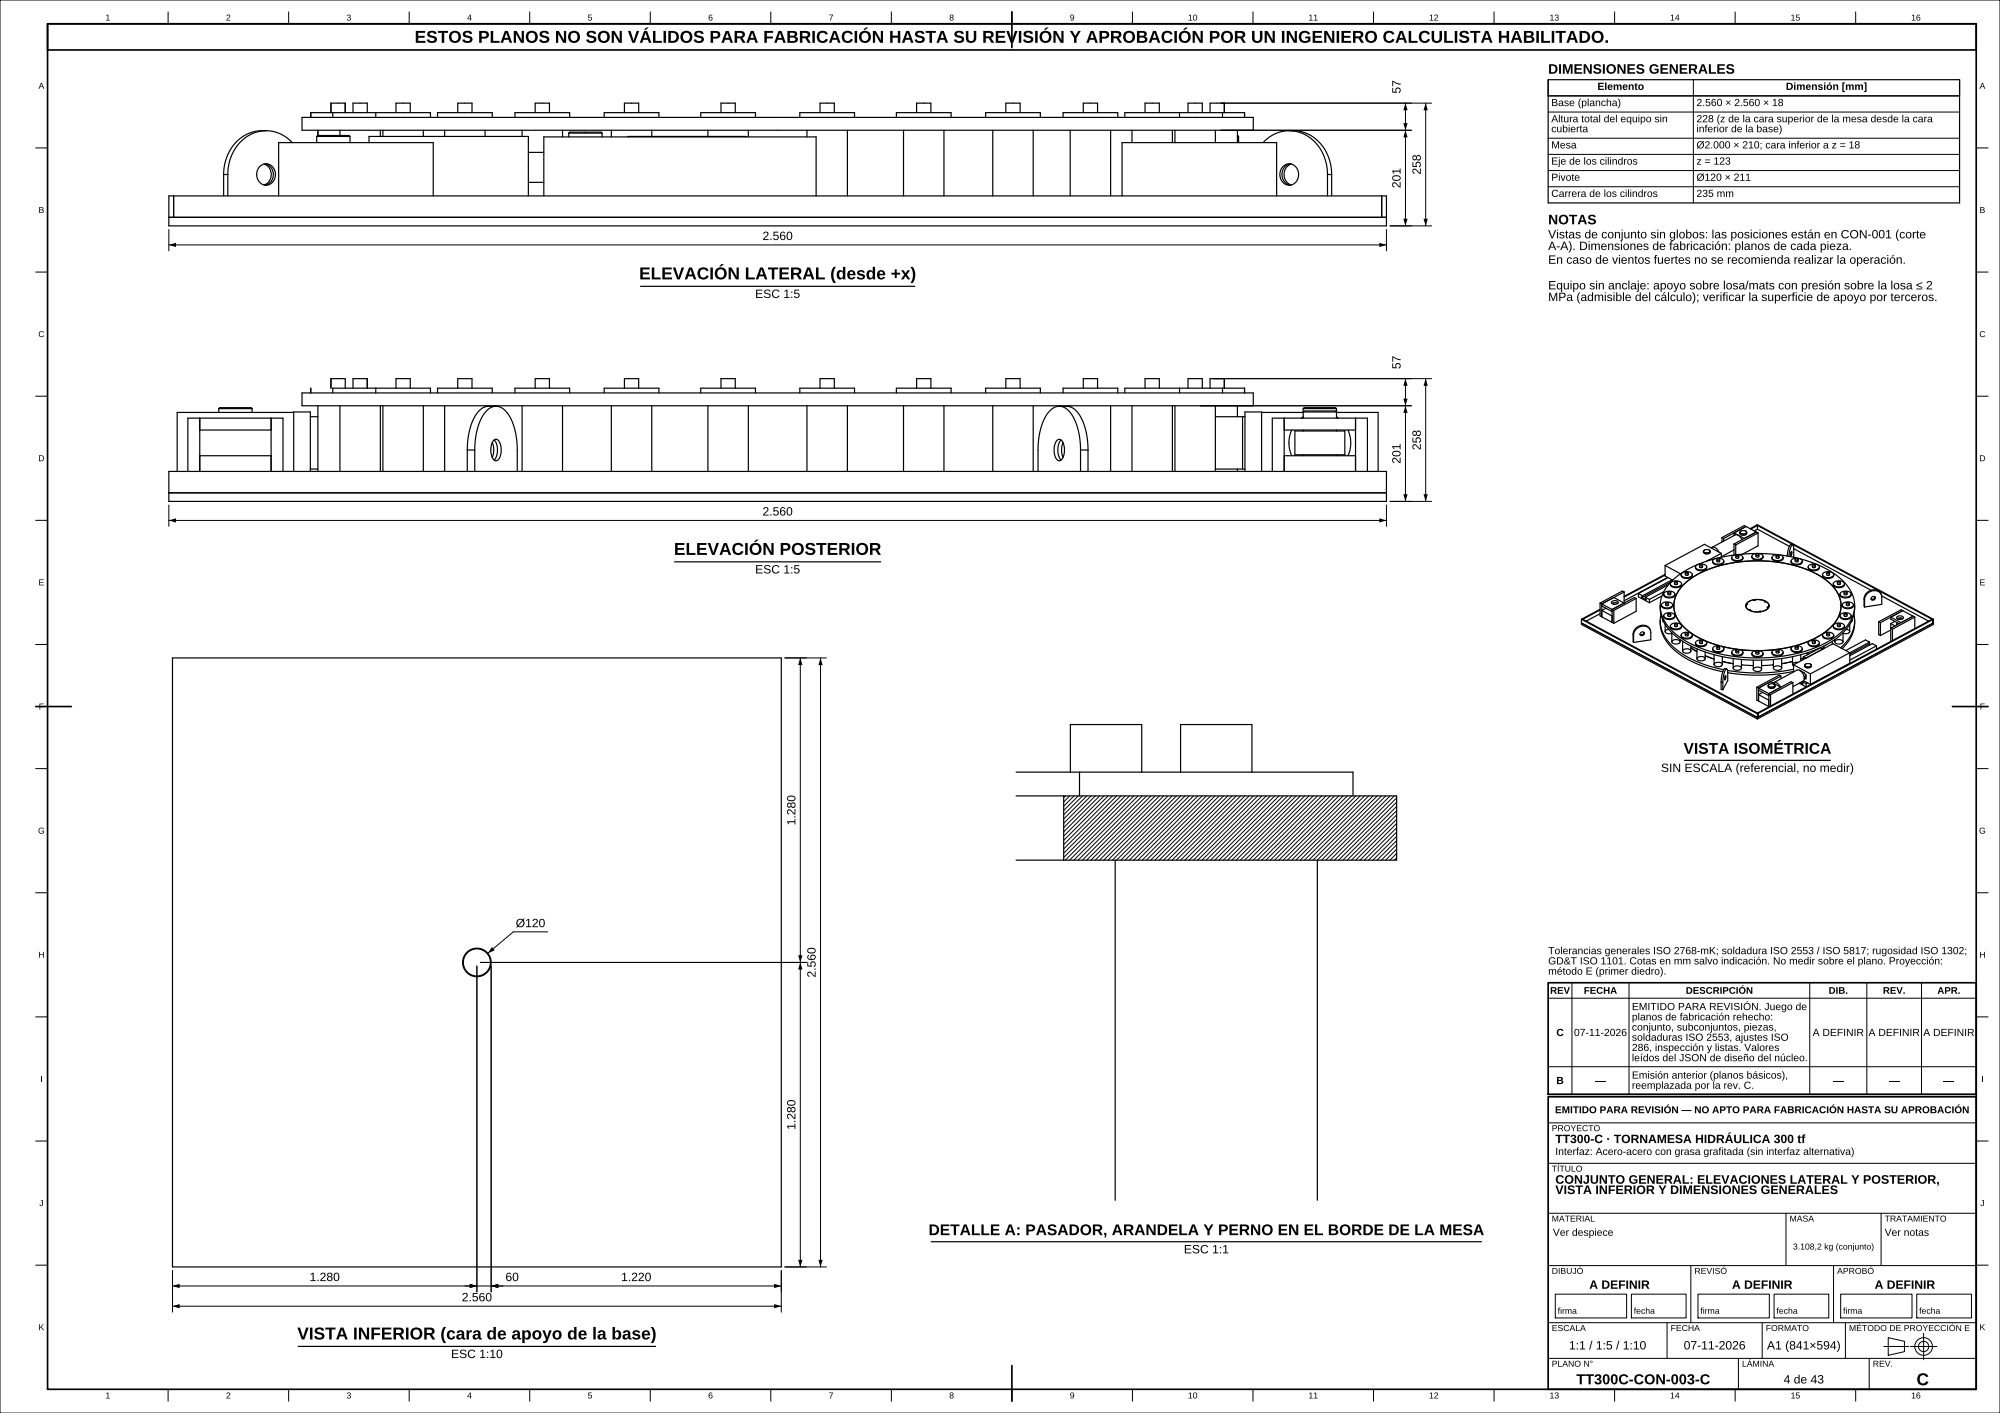
[picture p78: page 1]
