mafiucivil/Tornamesa/entregables/RevC/planos/TT300C-CON-004-C.pdf

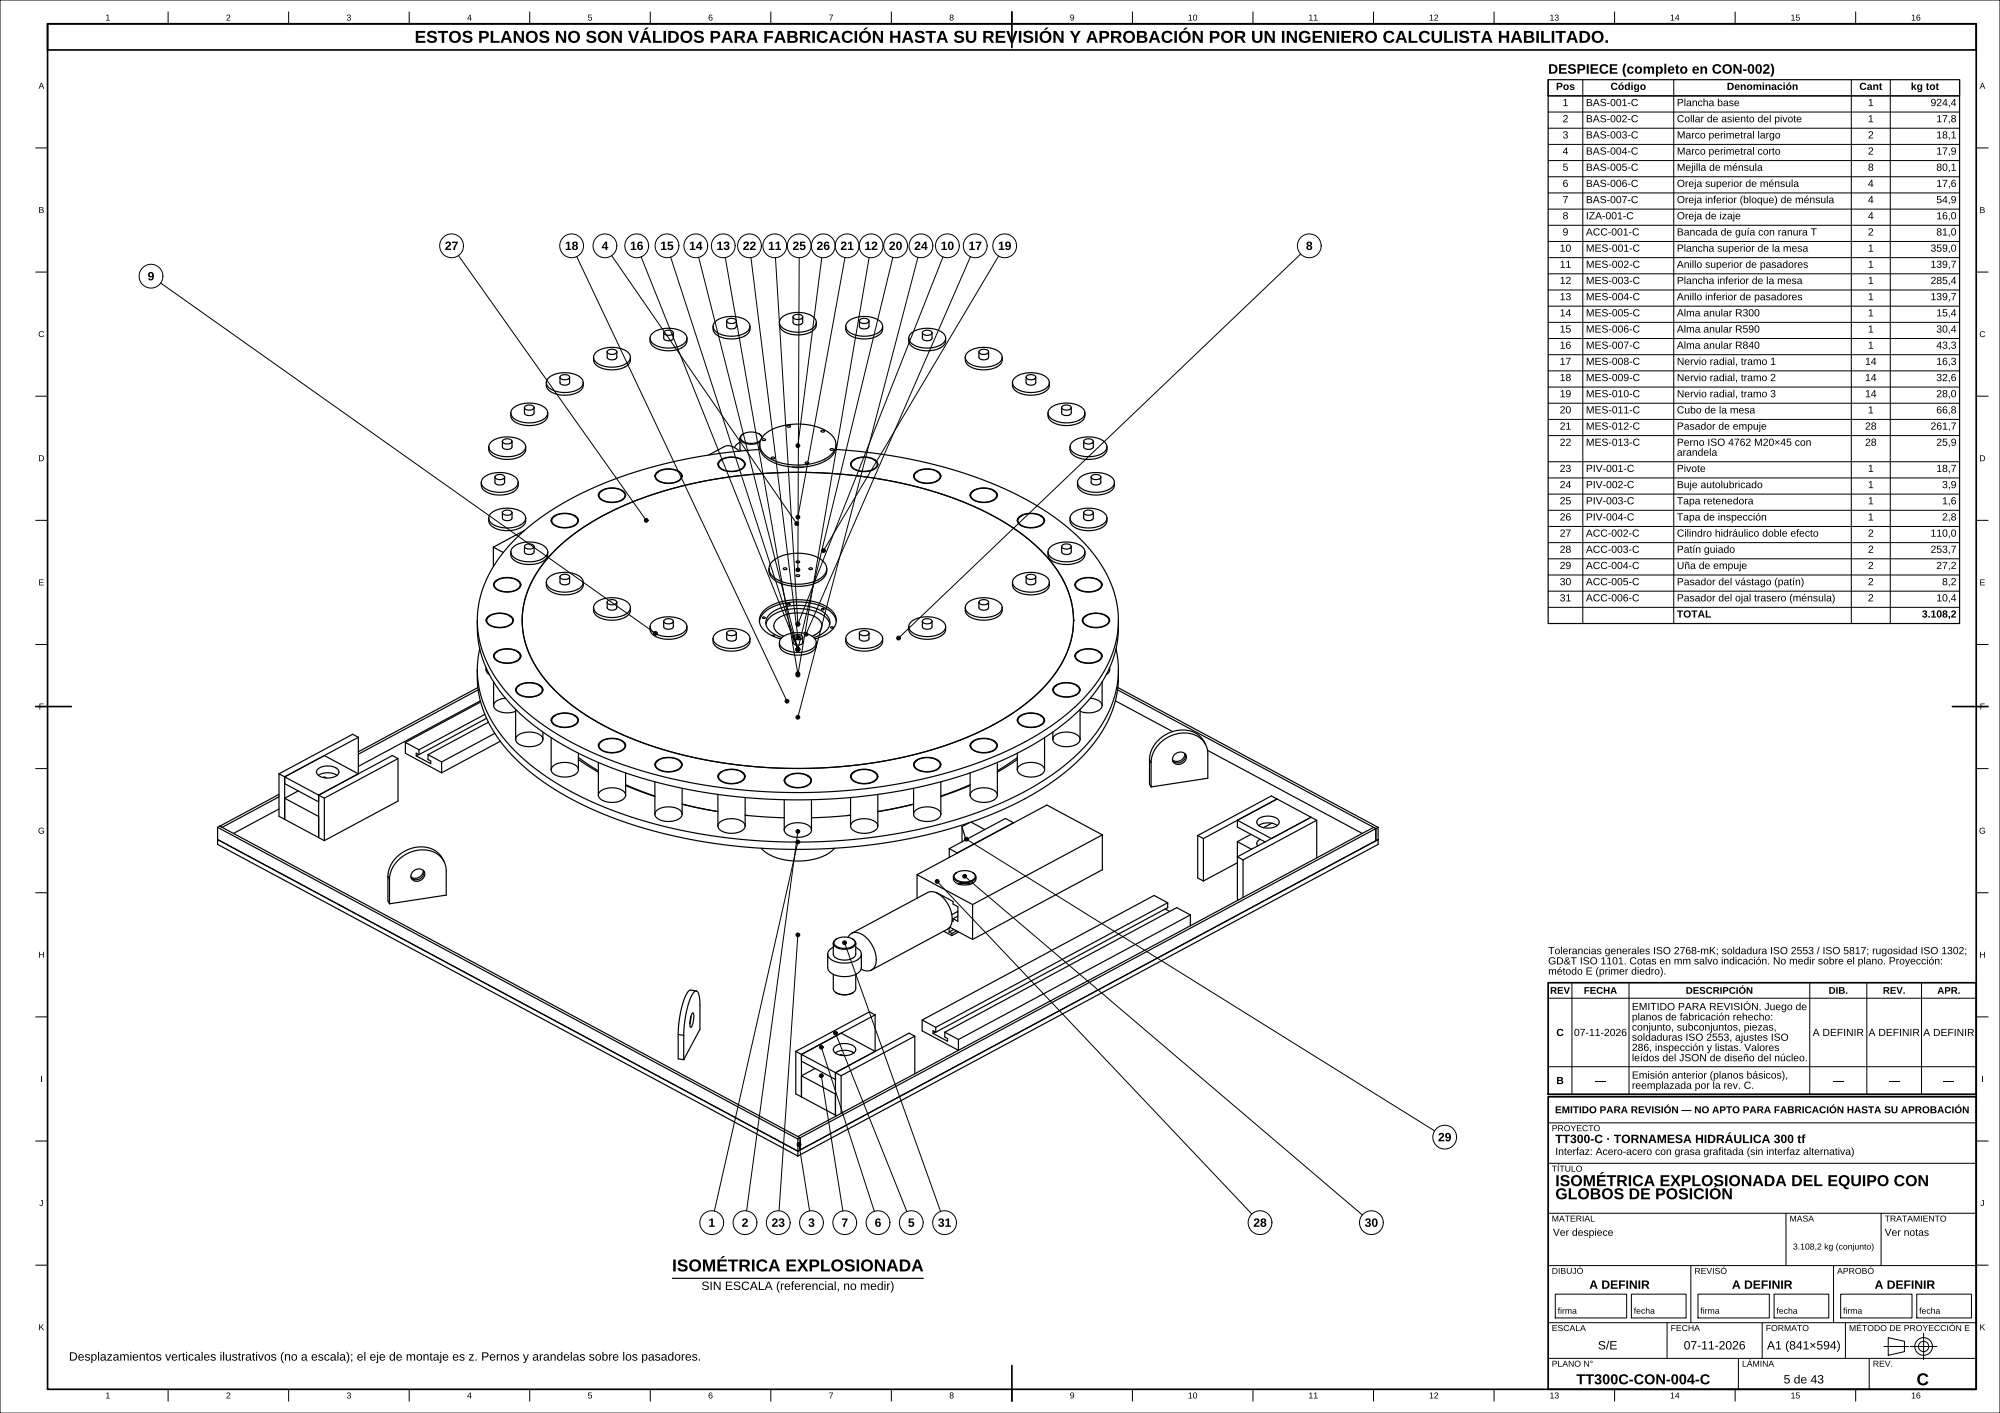
[picture p79: page 1]
