mafiucivil/Tornamesa/entregables/RevC/planos/TT300C-CON-005-C.pdf

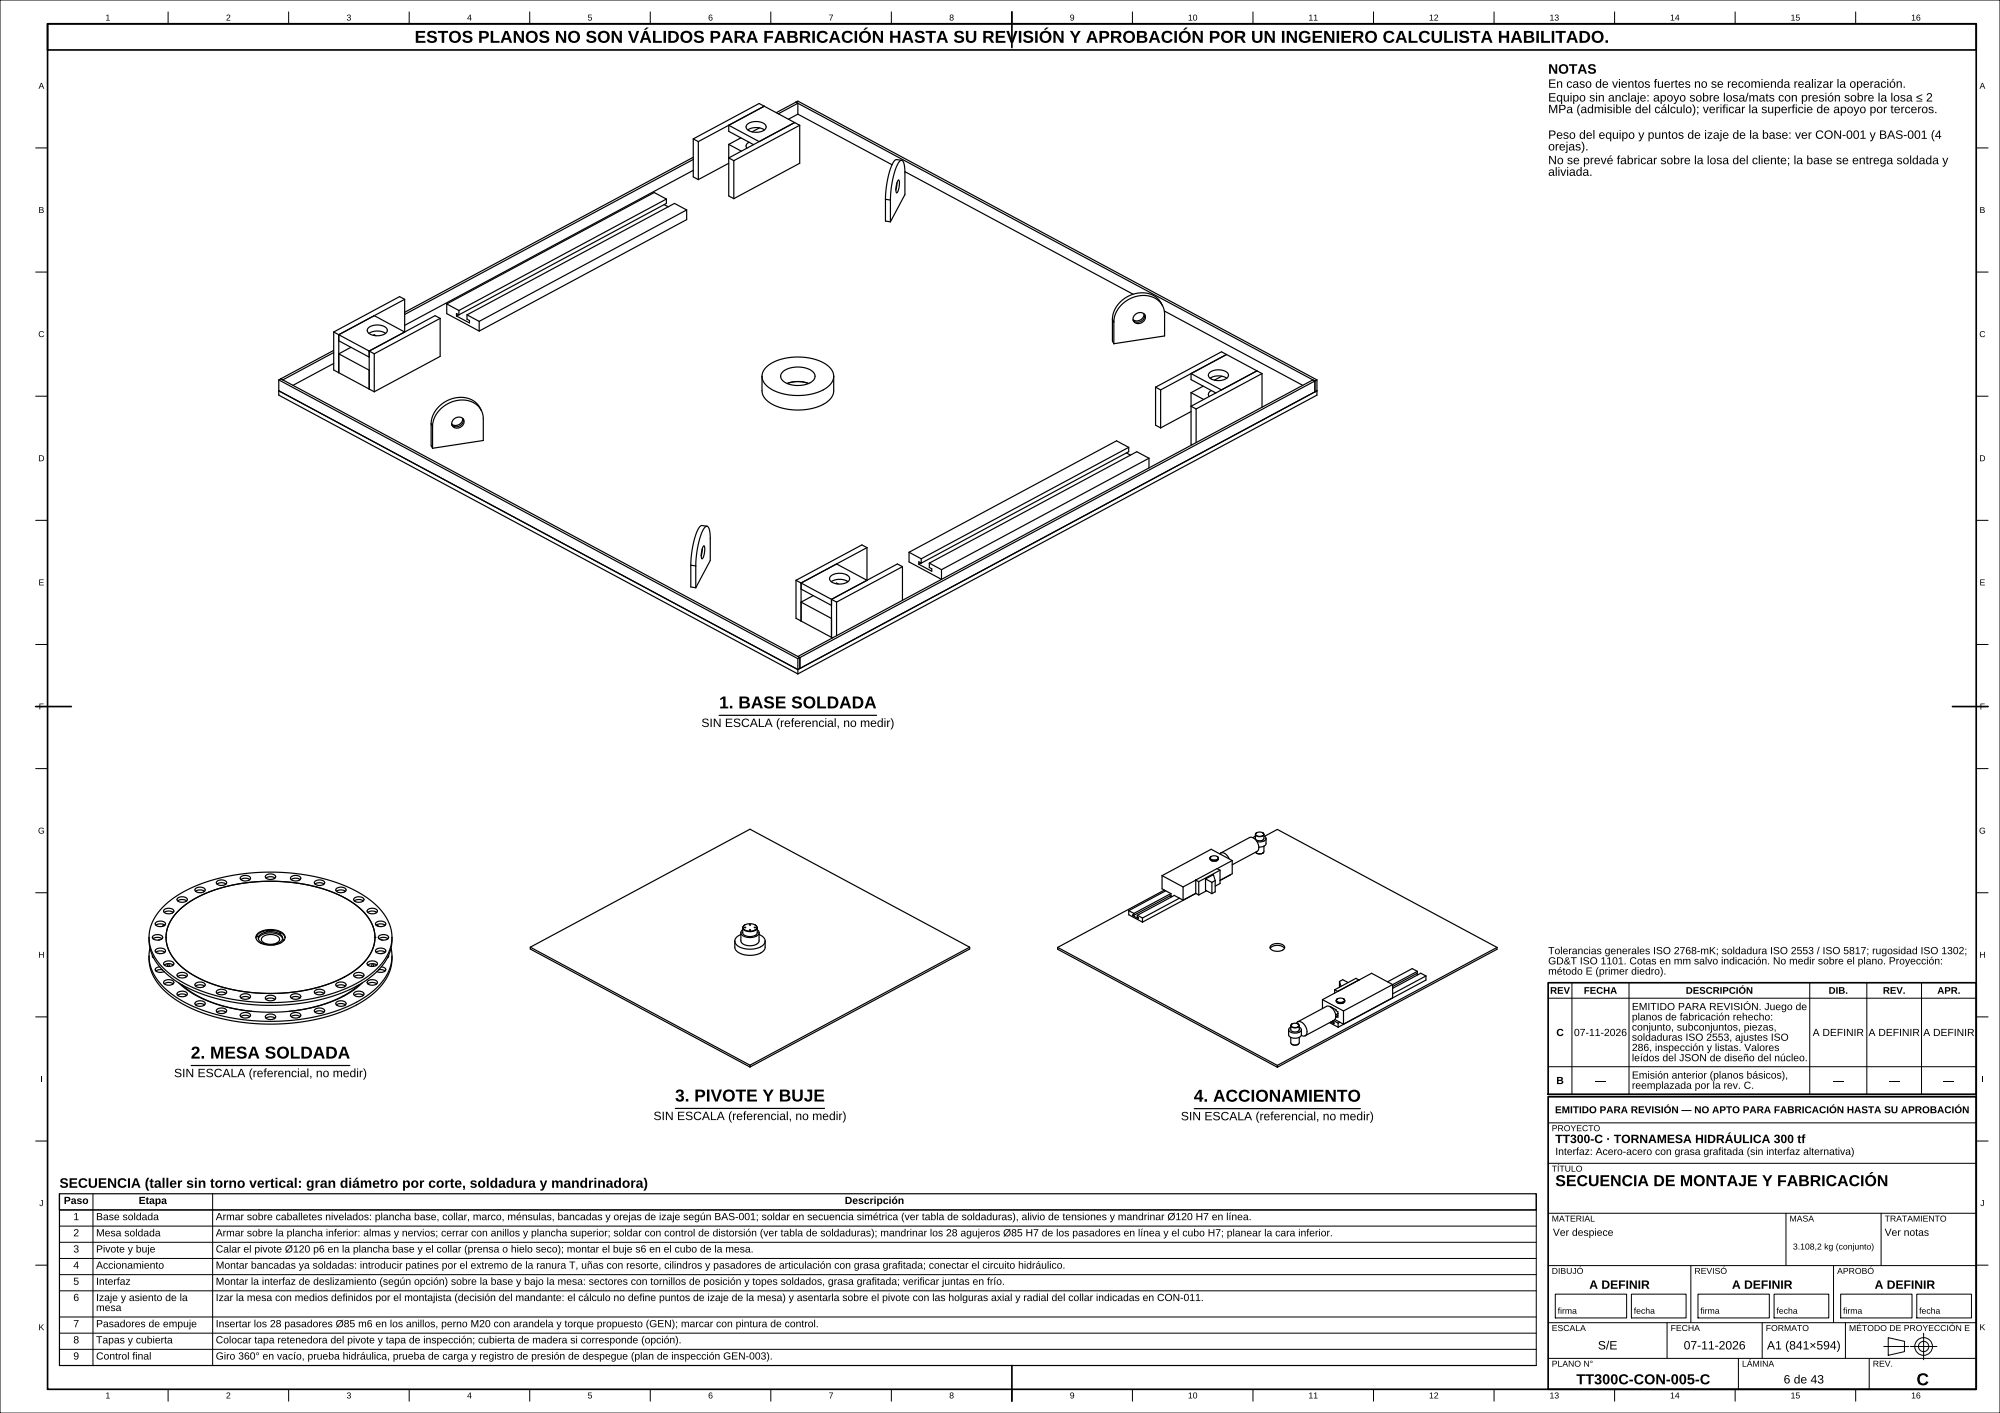
[picture p80: page 1]
