mafiucivil/Tornamesa/entregables/RevC/planos/TT300C-CON-006-C.pdf

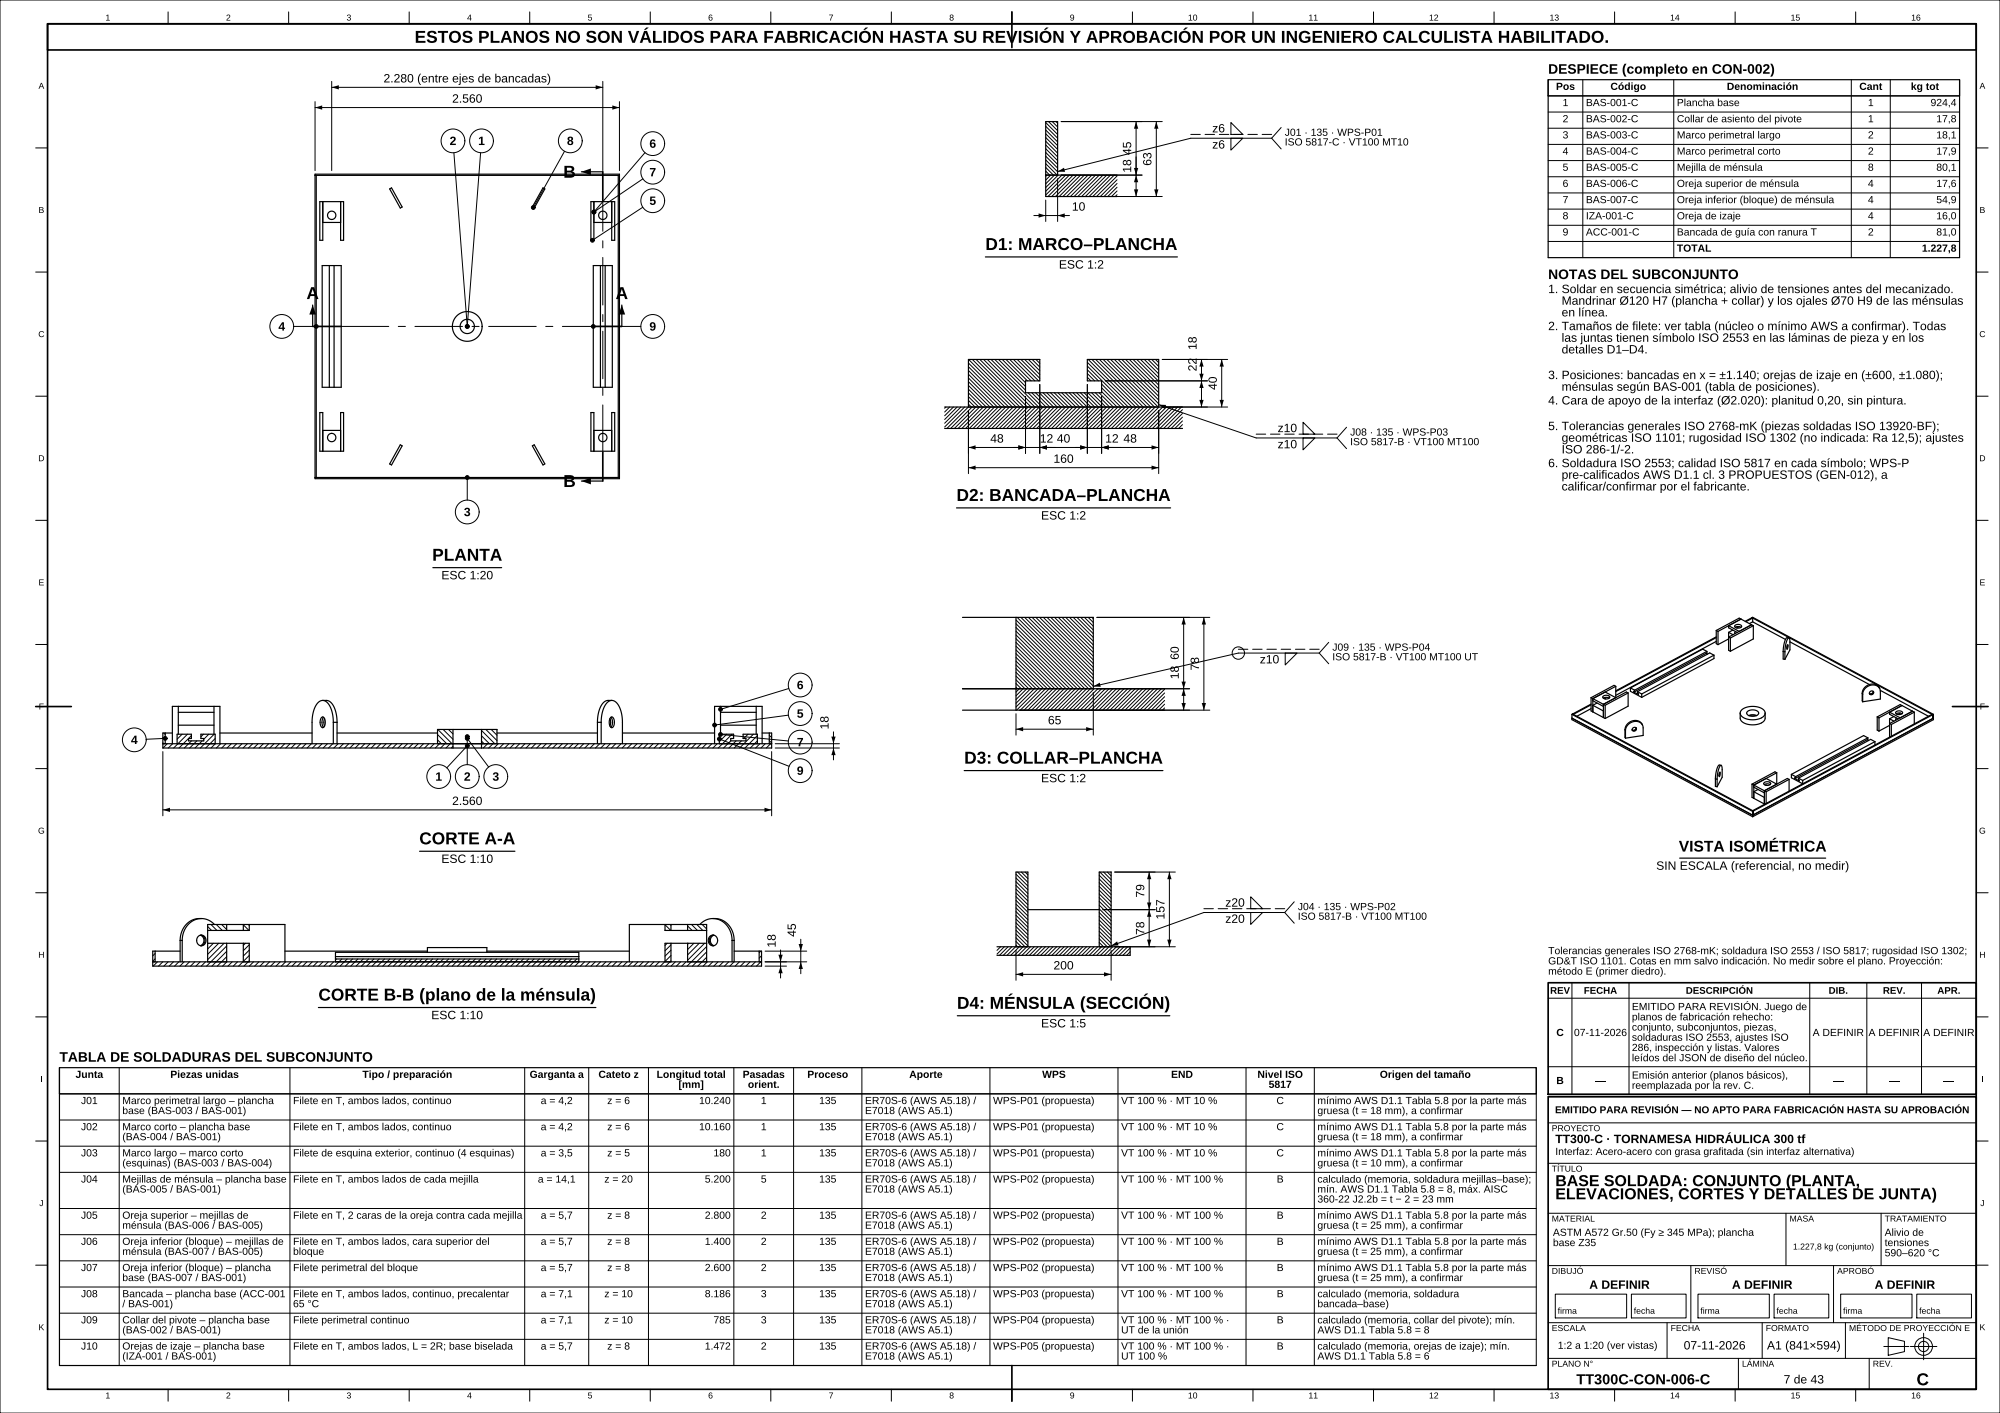
[picture p81: page 1]
