mafiucivil/Tornamesa/entregables/RevC/planos/TT300C-CON-007-C.pdf

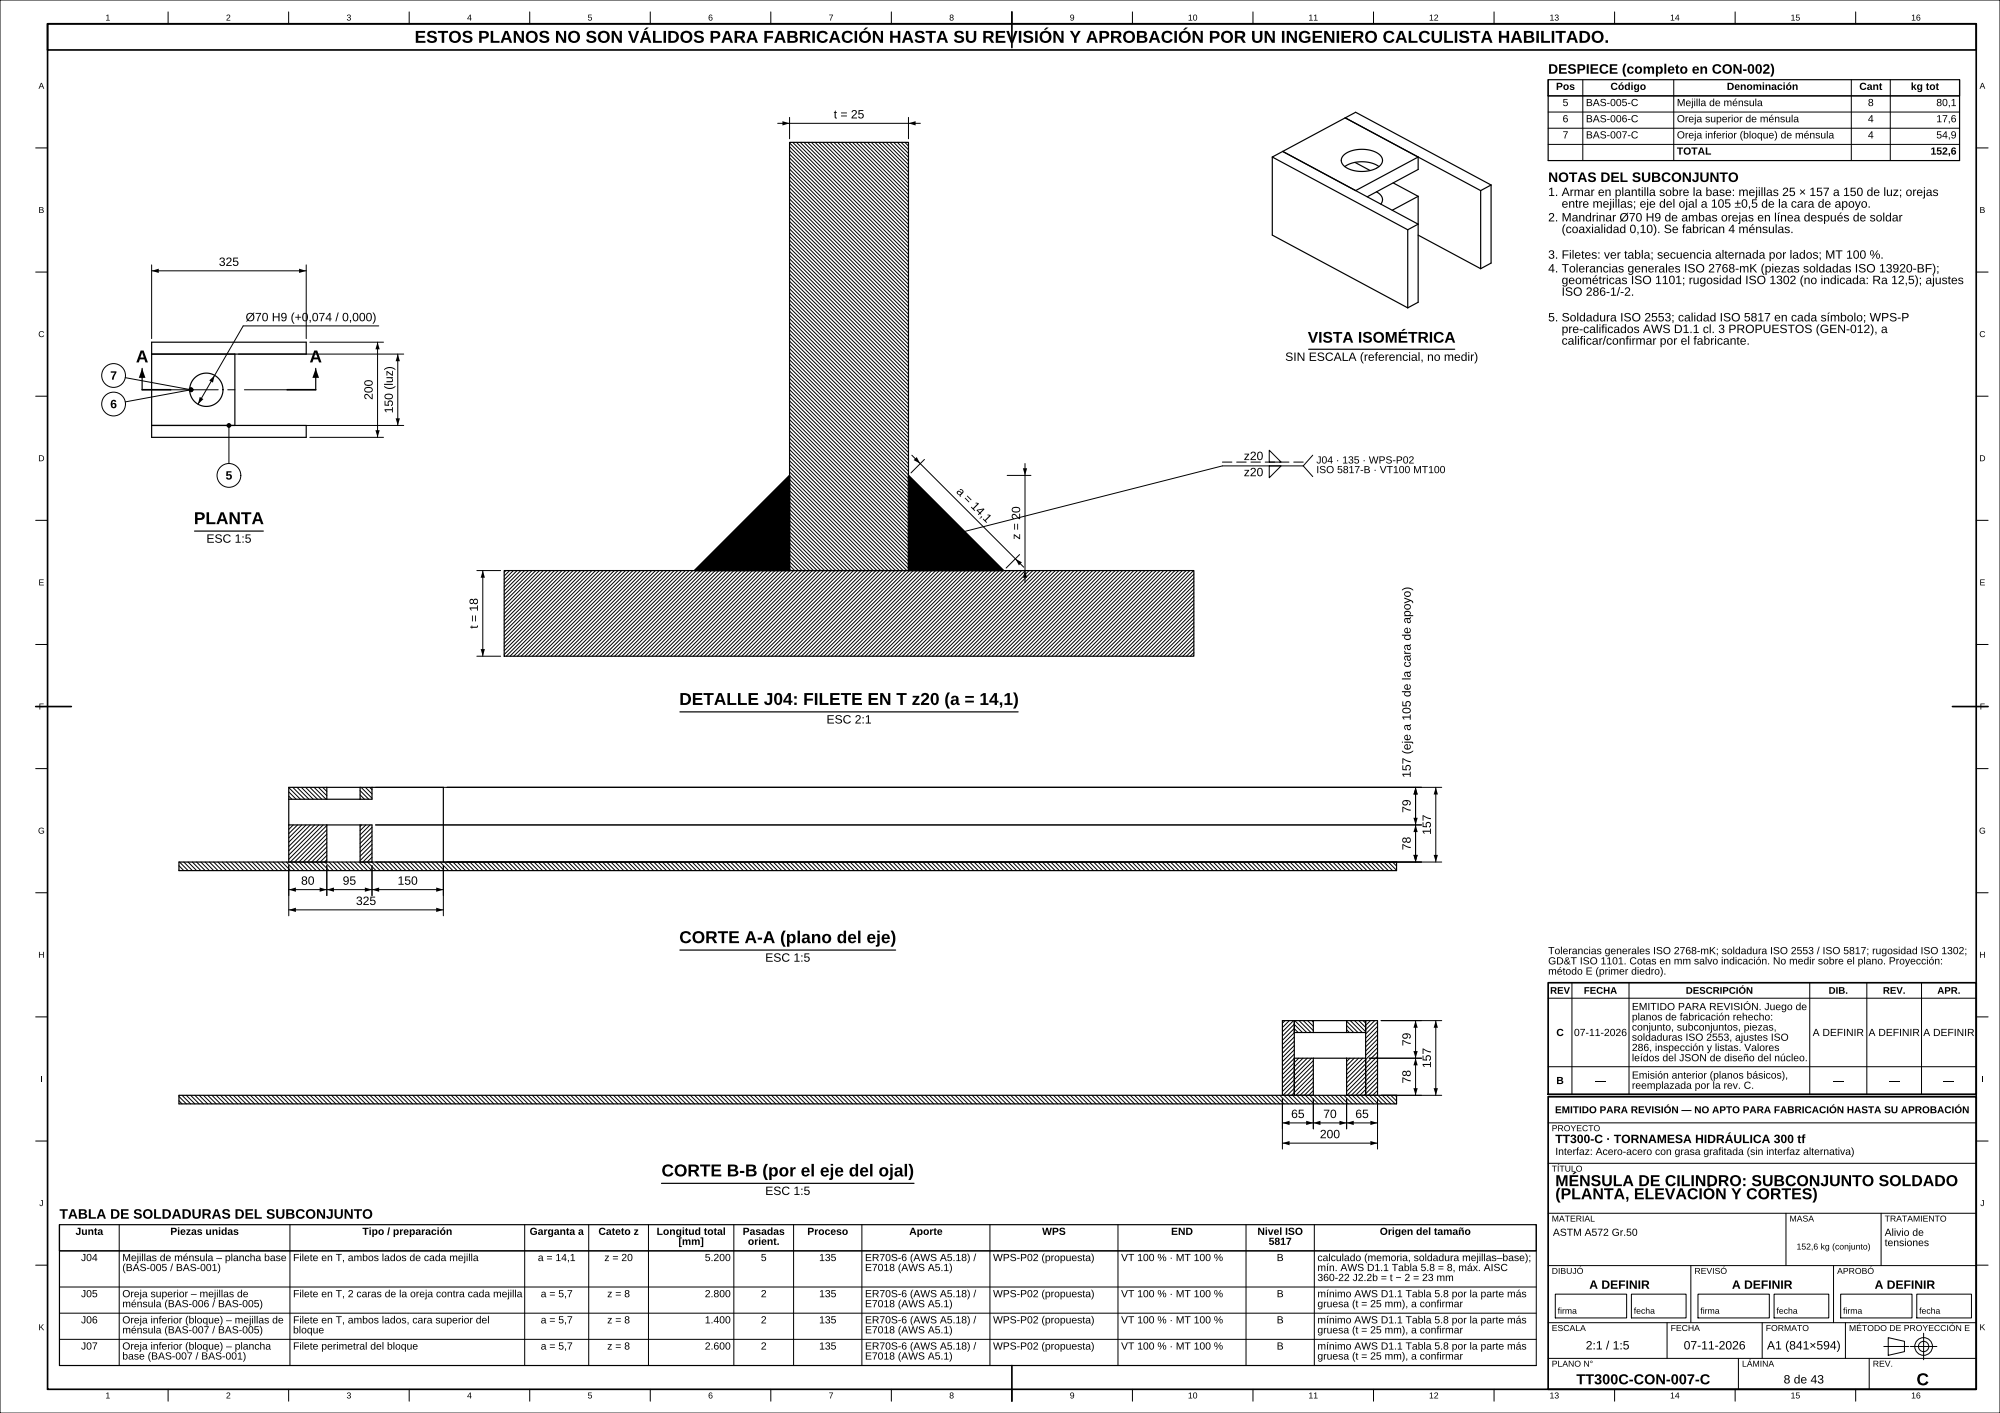
[picture p82: page 1]
