mafiucivil/Tornamesa/entregables/RevC/planos/TT300C-CON-008-C.pdf

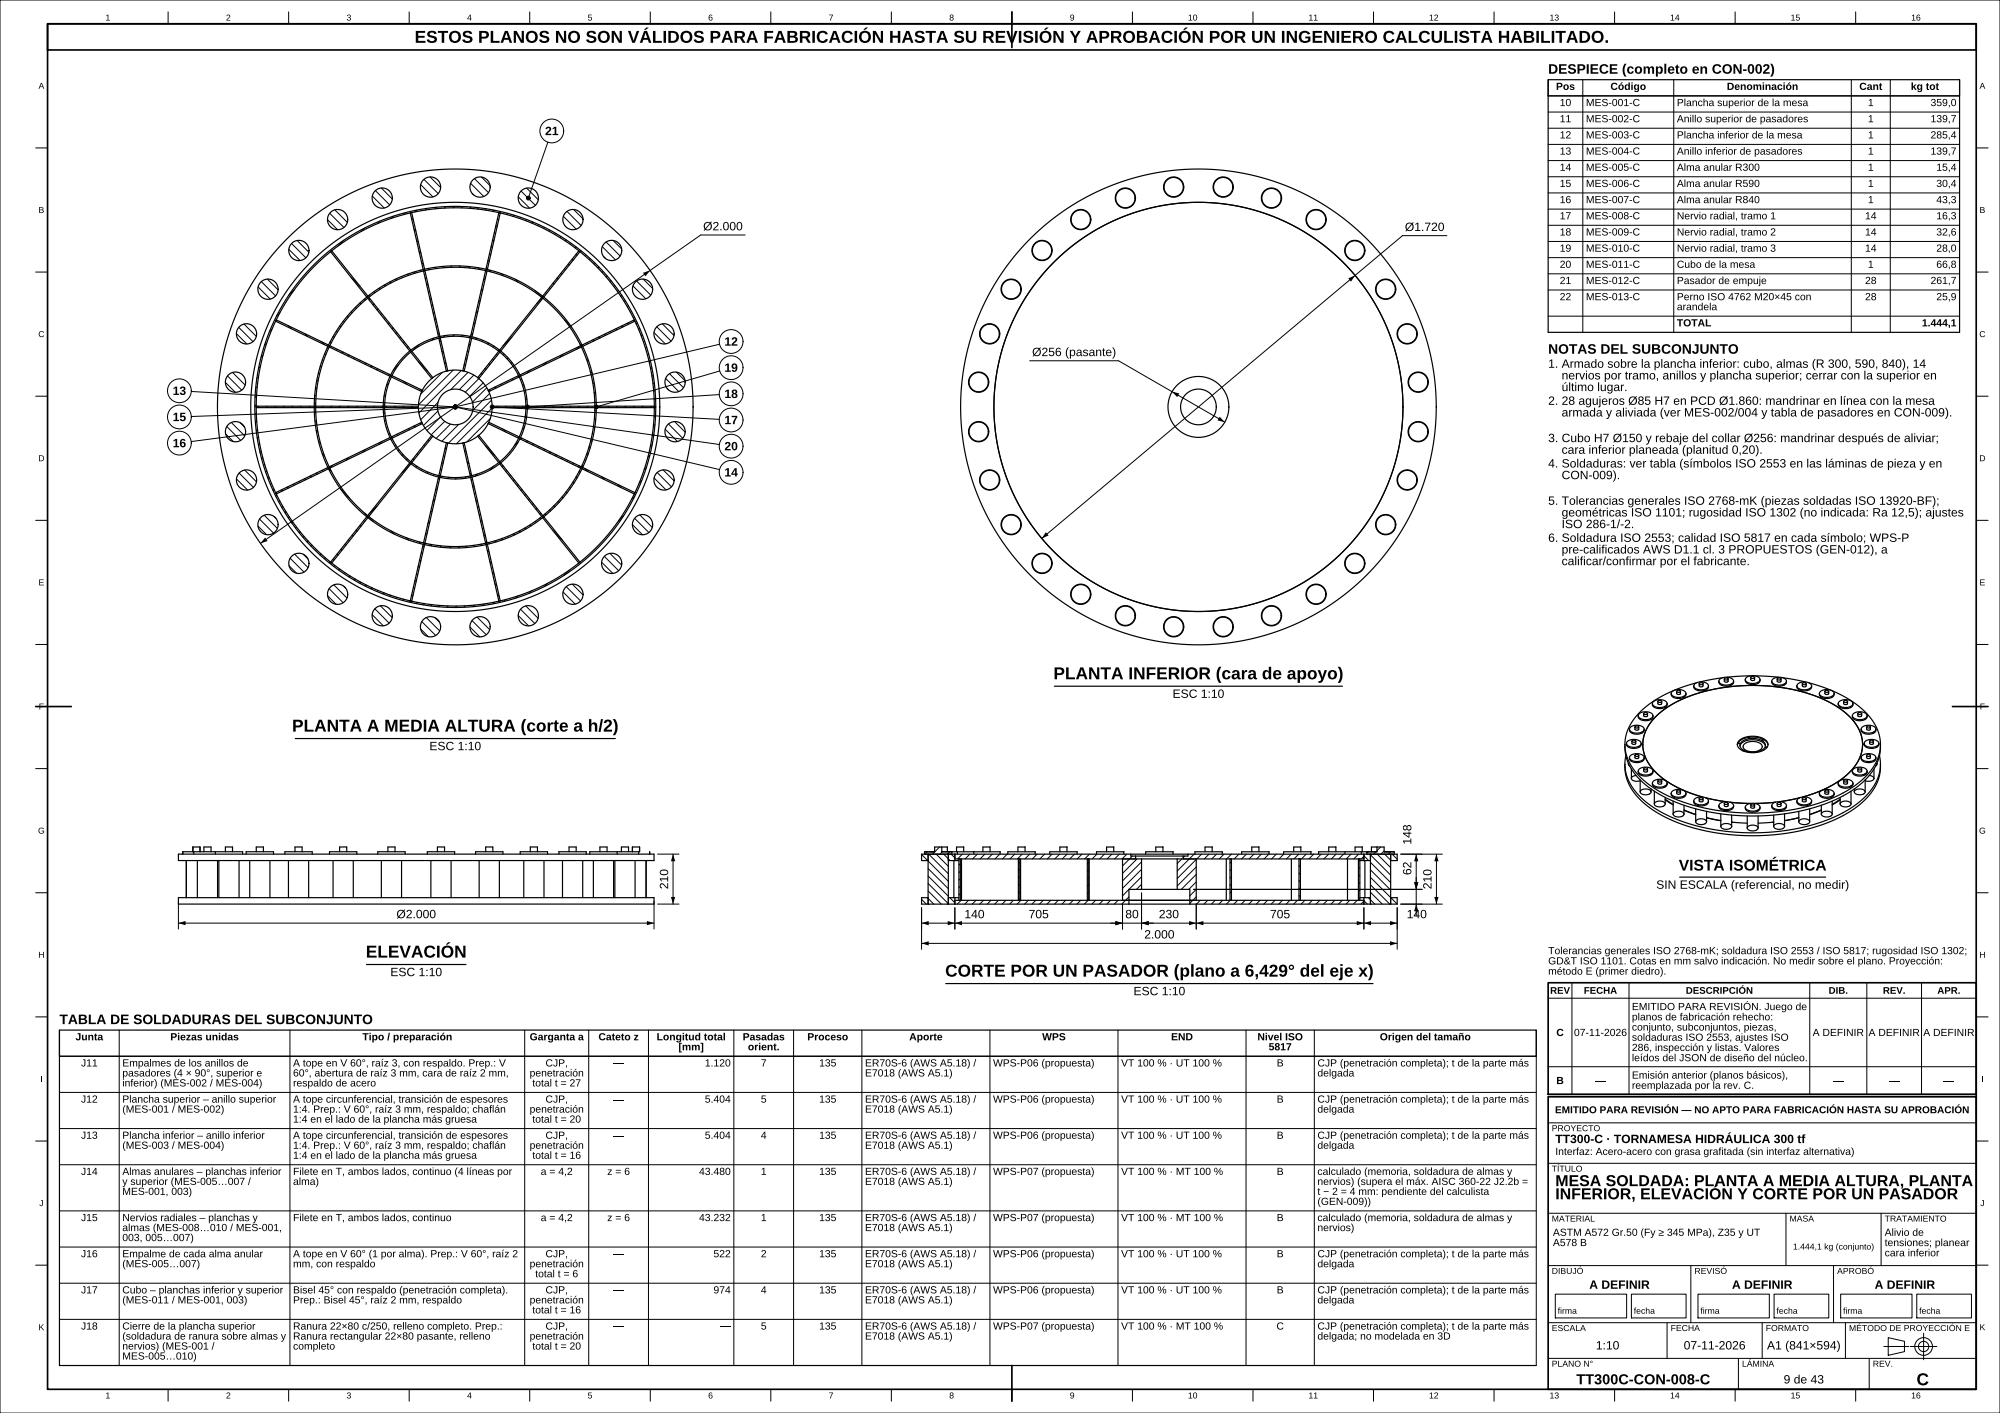
[picture p83: page 1]
