mafiucivil/Tornamesa/entregables/RevC/planos/TT300C-CON-009-C.pdf

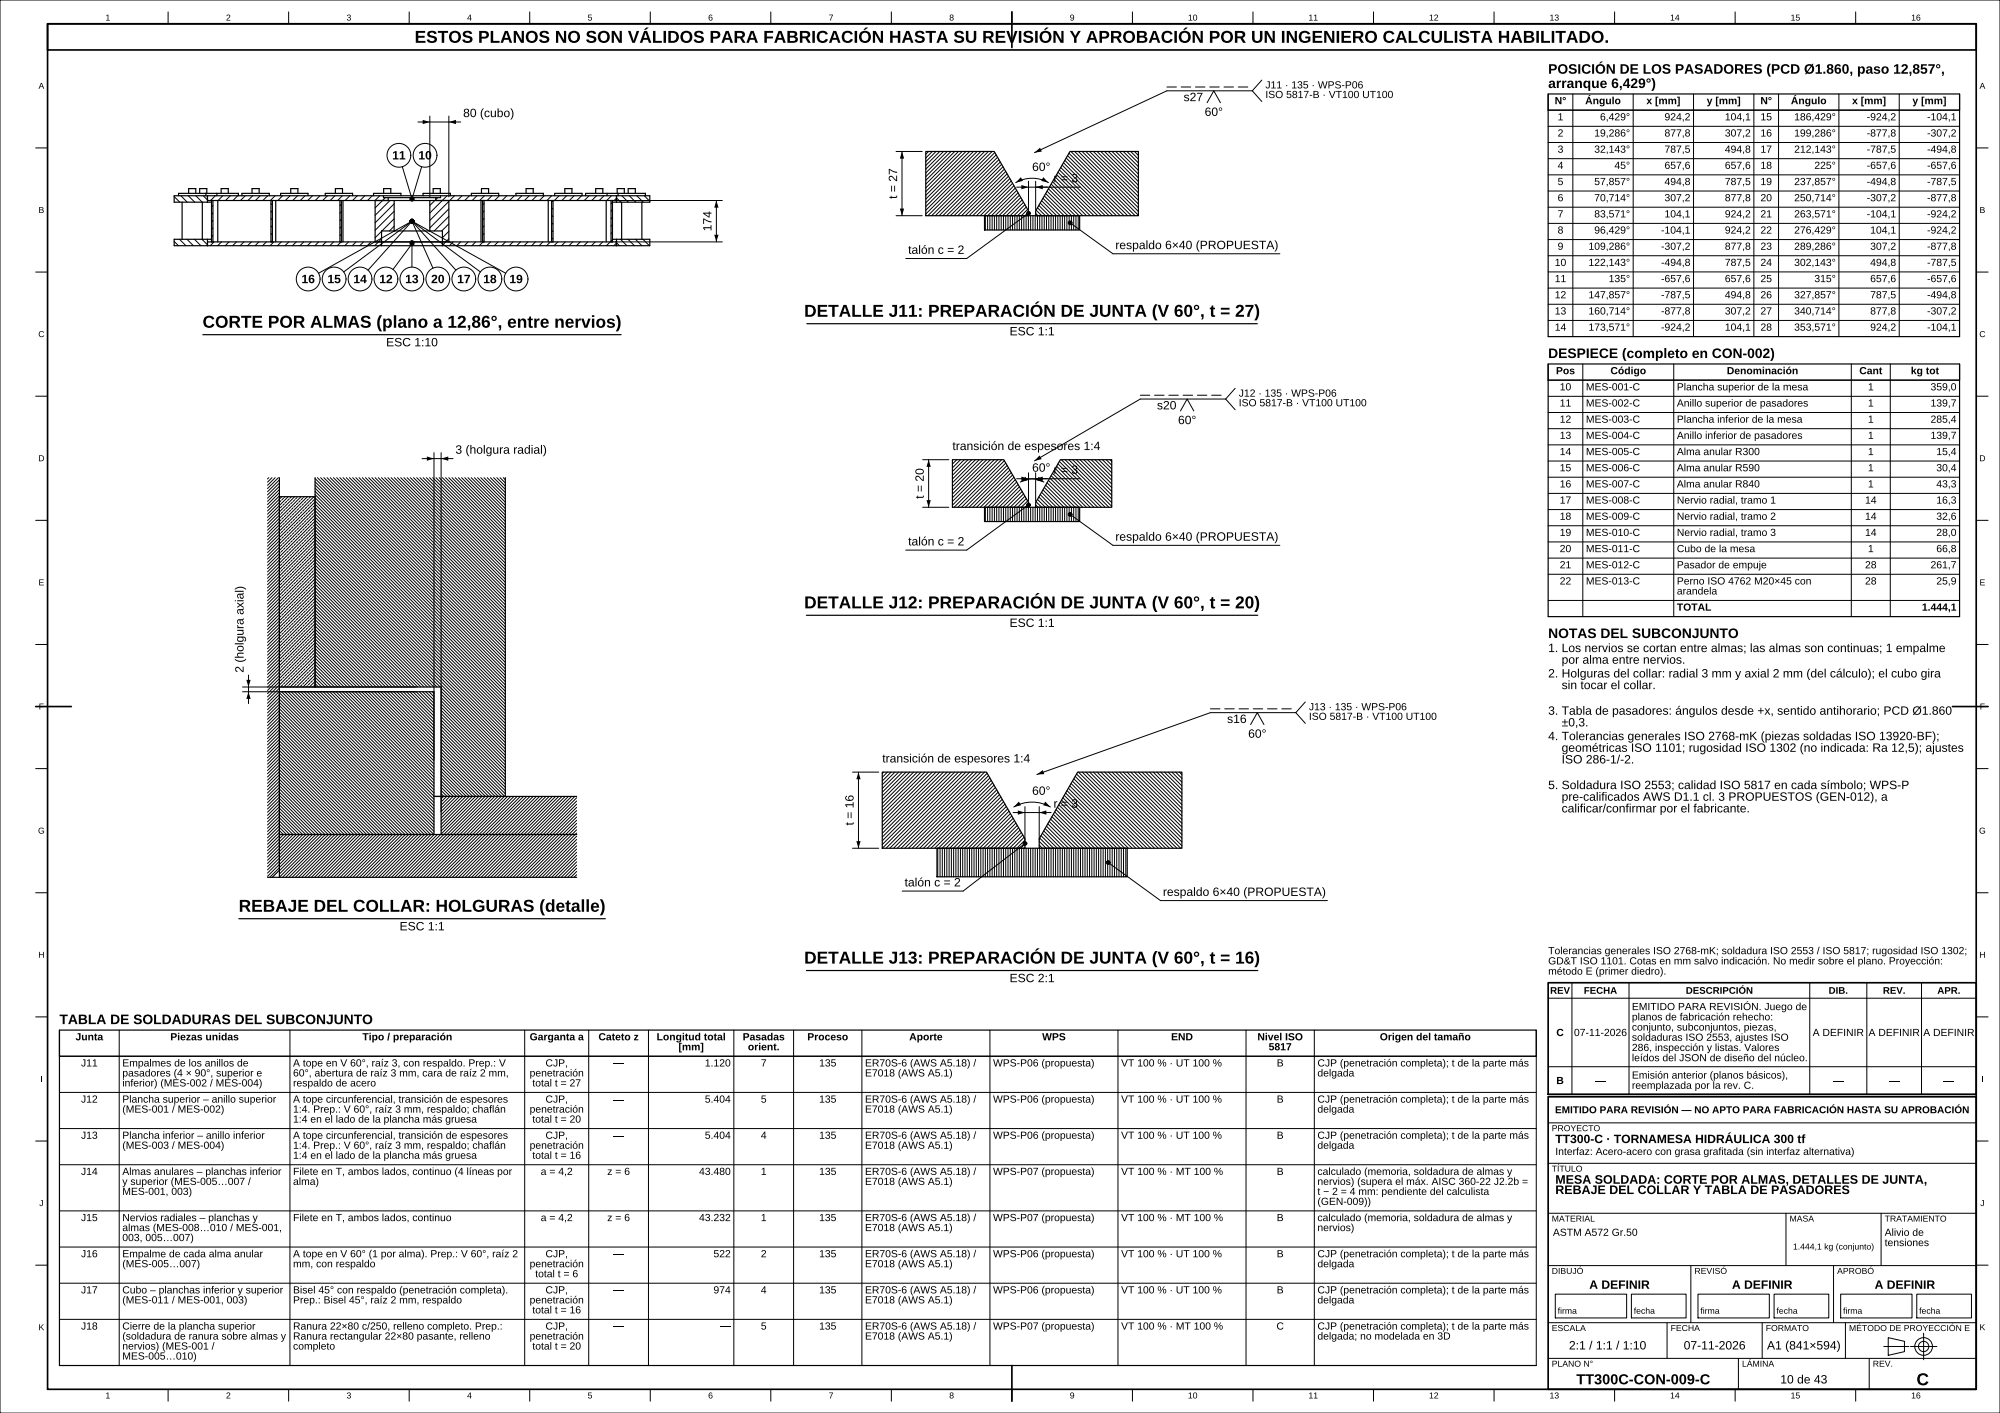
[picture p84: page 1]
