mafiucivil/Tornamesa/entregables/RevC/planos/TT300C-CON-010-C.pdf

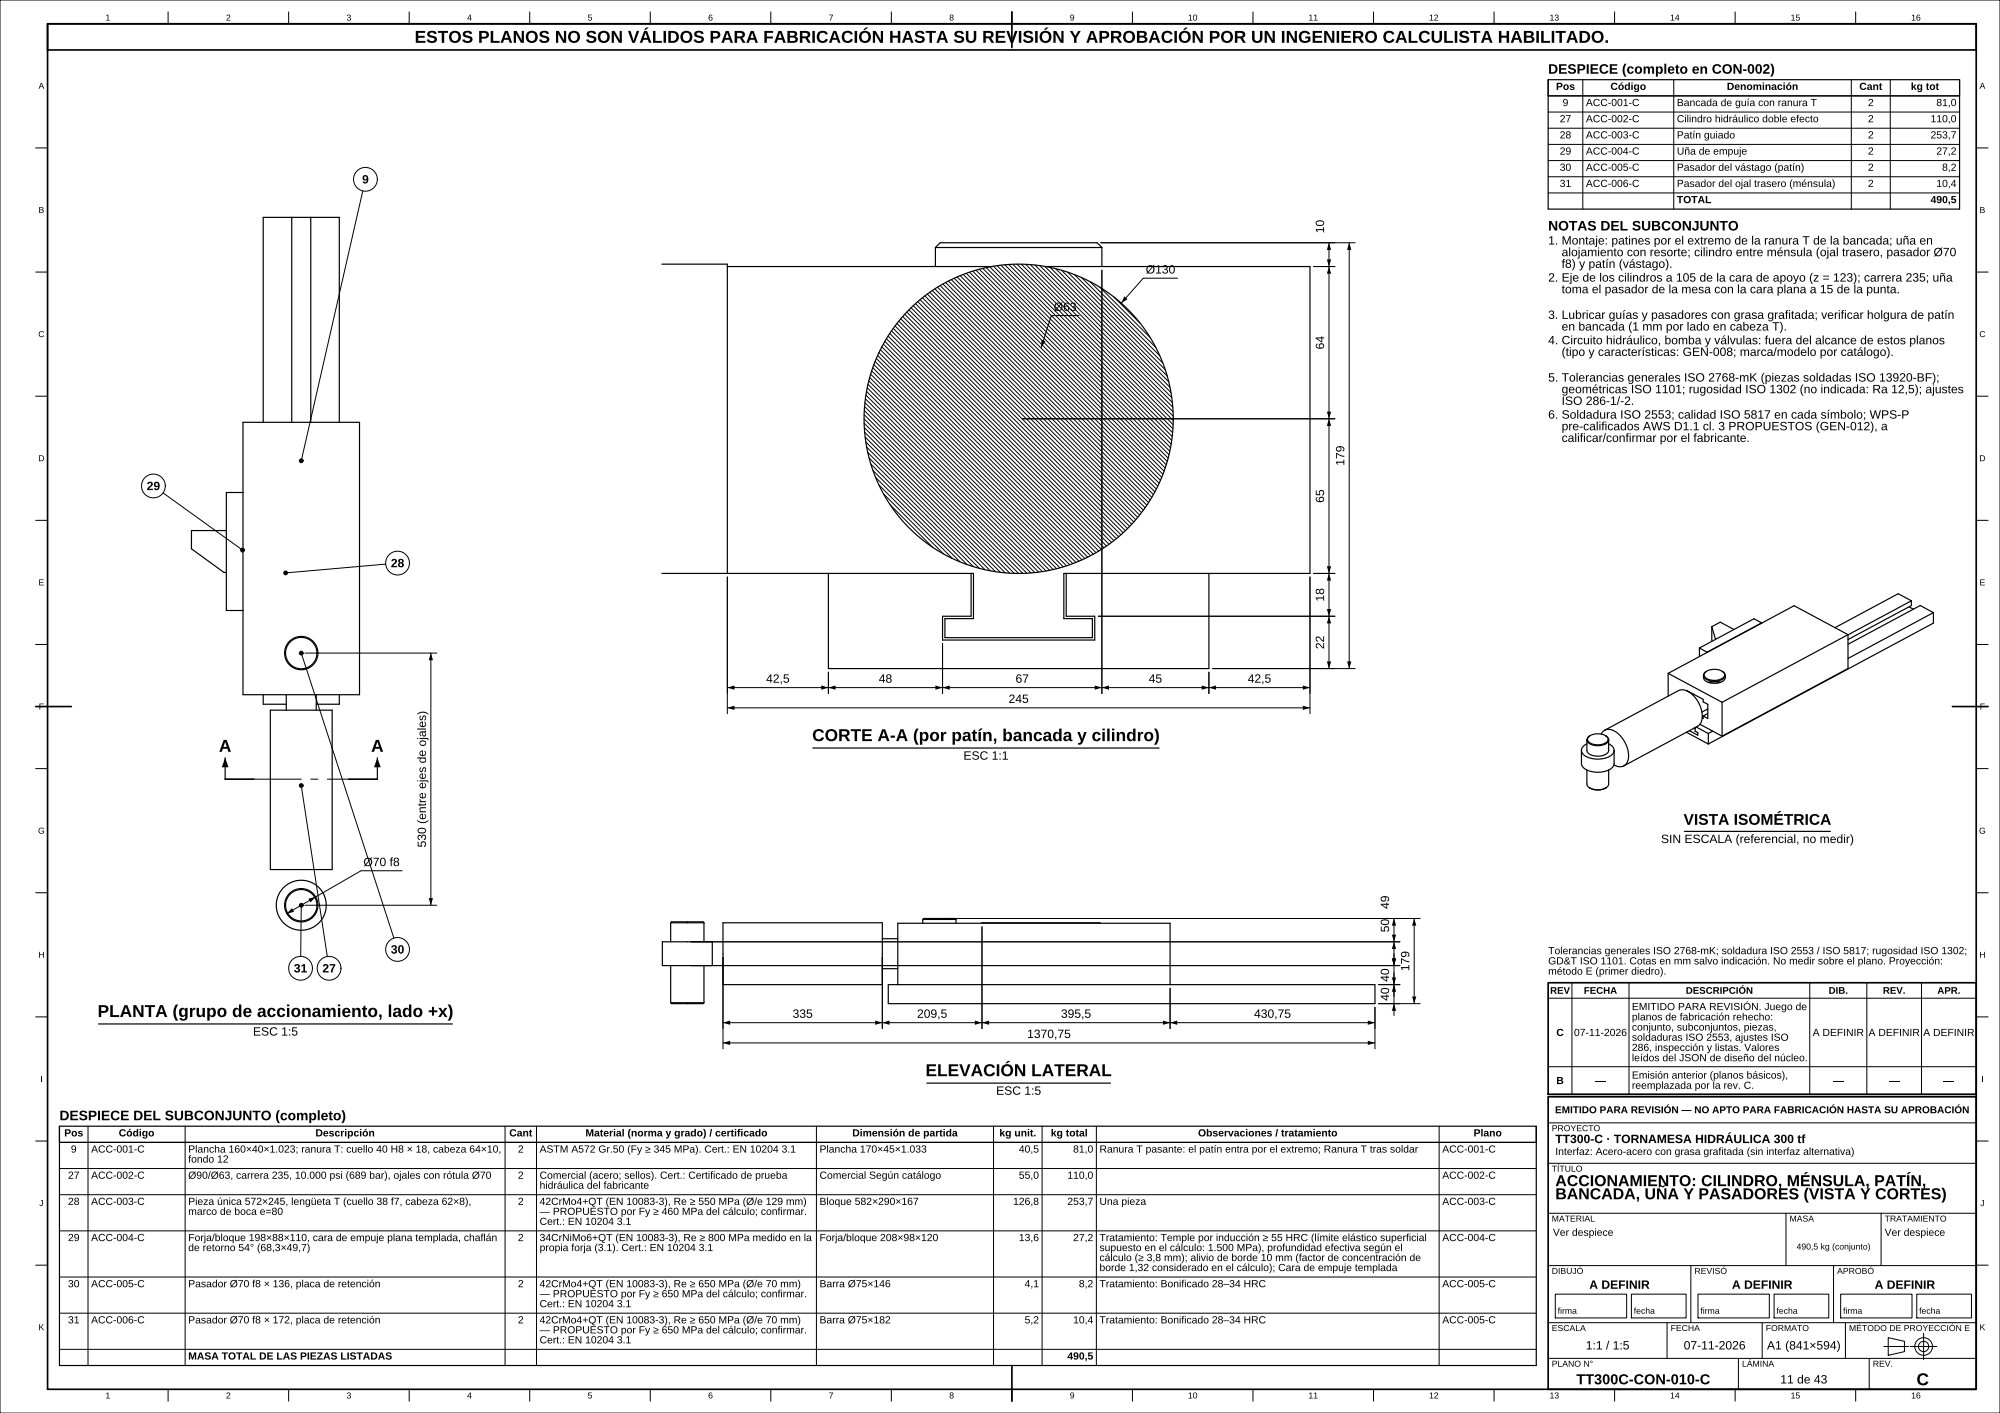
[picture p85: page 1]
