mafiucivil/Tornamesa/entregables/RevC/planos/TT300C-CON-011-C.pdf

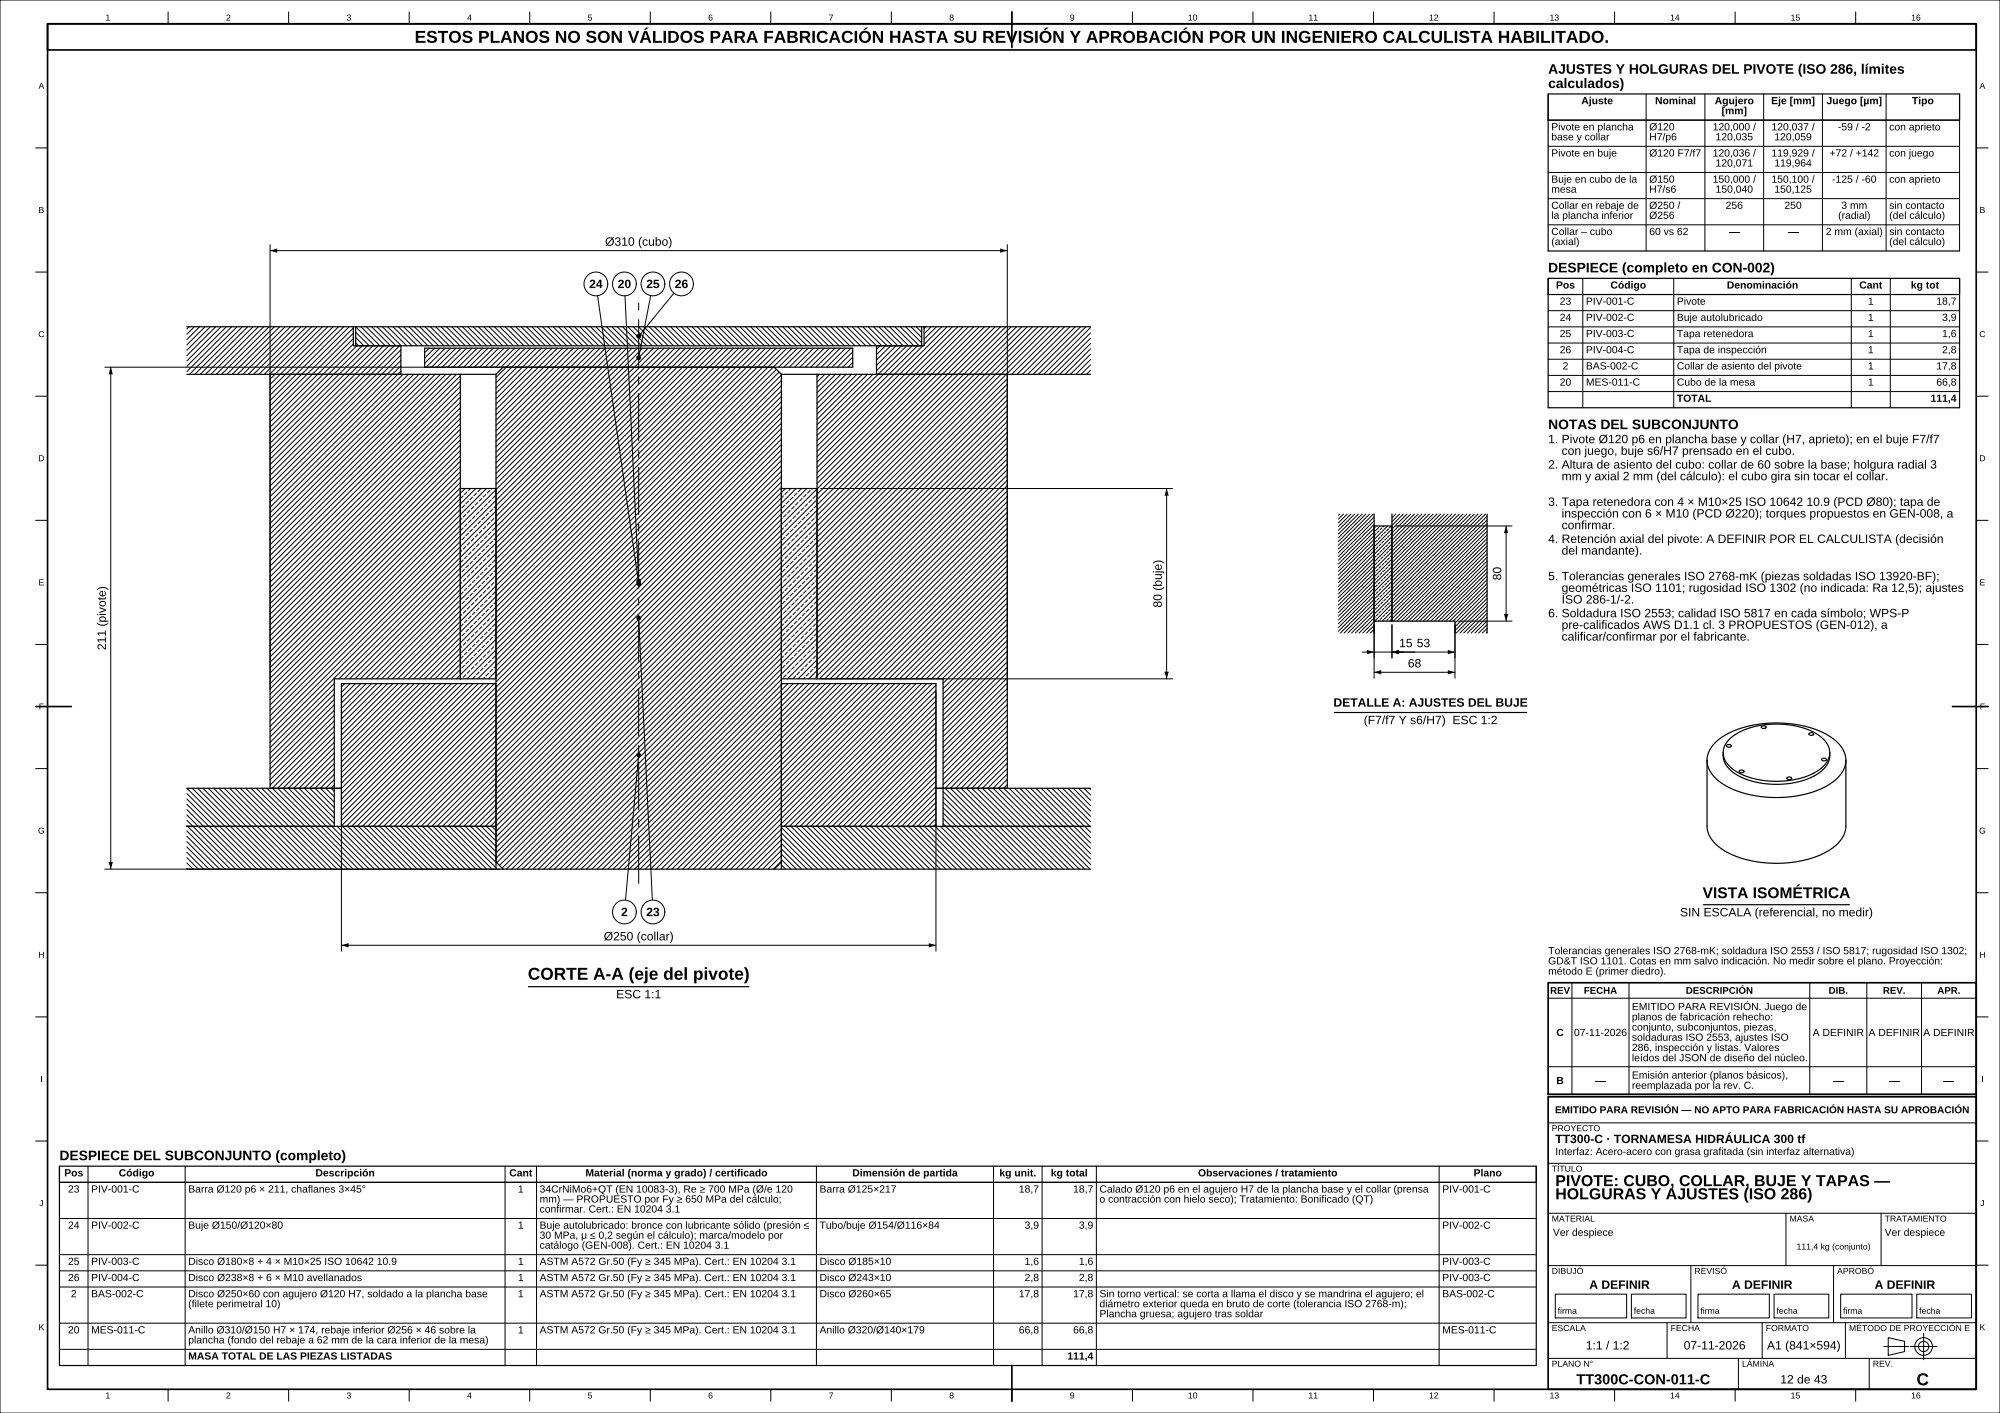
[picture p86: page 1]
