mafiucivil/Tornamesa/entregables/RevC/planos/TT300C-GEN-001-C.pdf

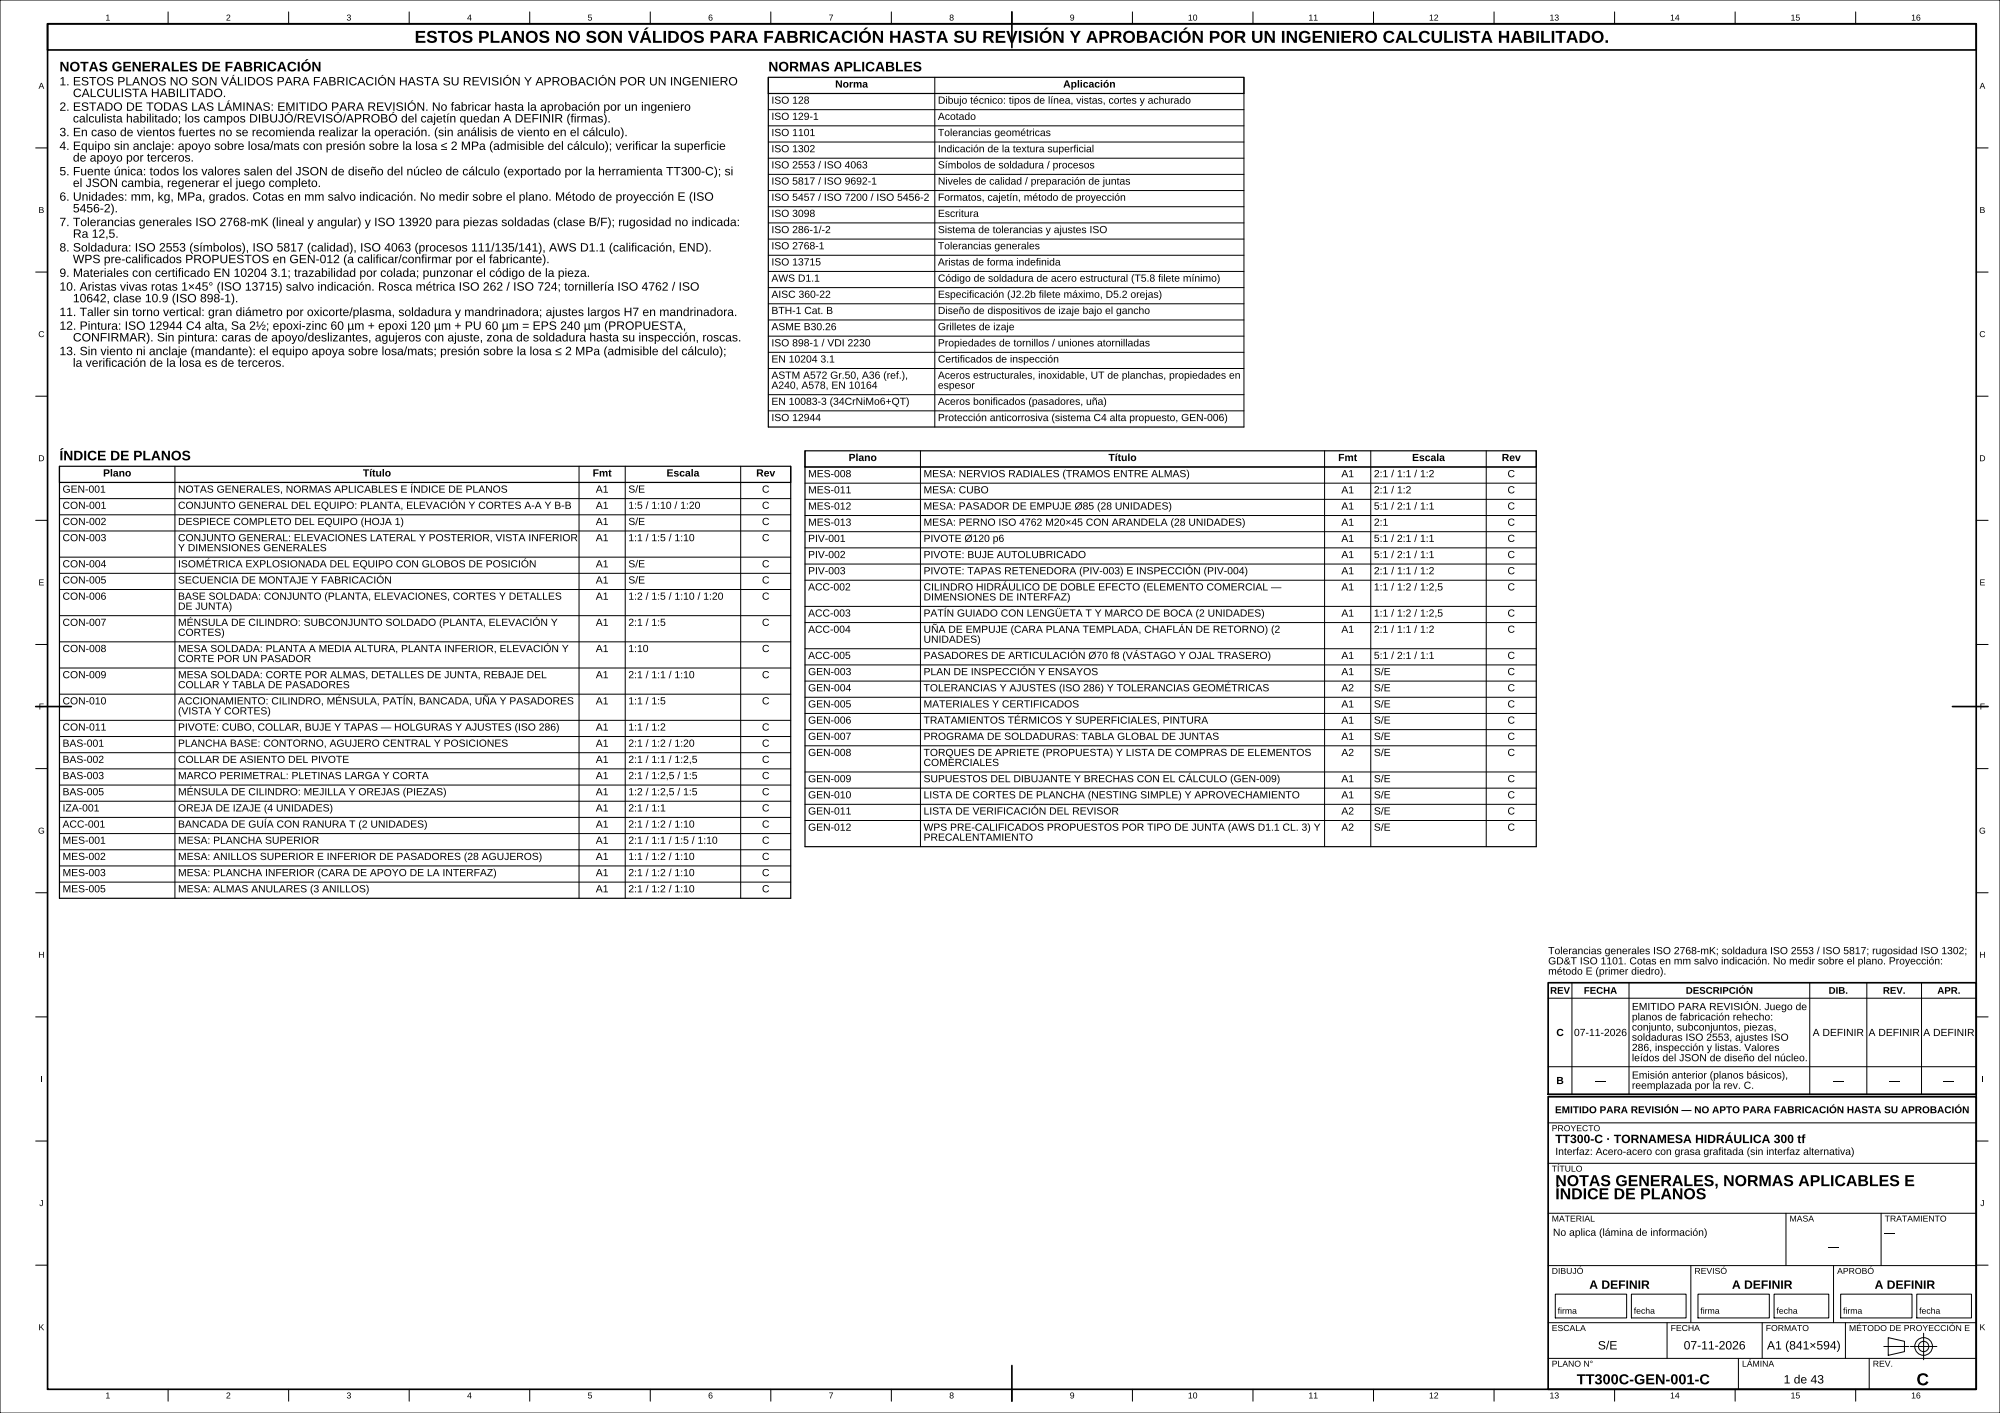
[picture p87: page 1]
