mafiucivil/Tornamesa/entregables/RevC/planos/TT300C-GEN-003-C.pdf

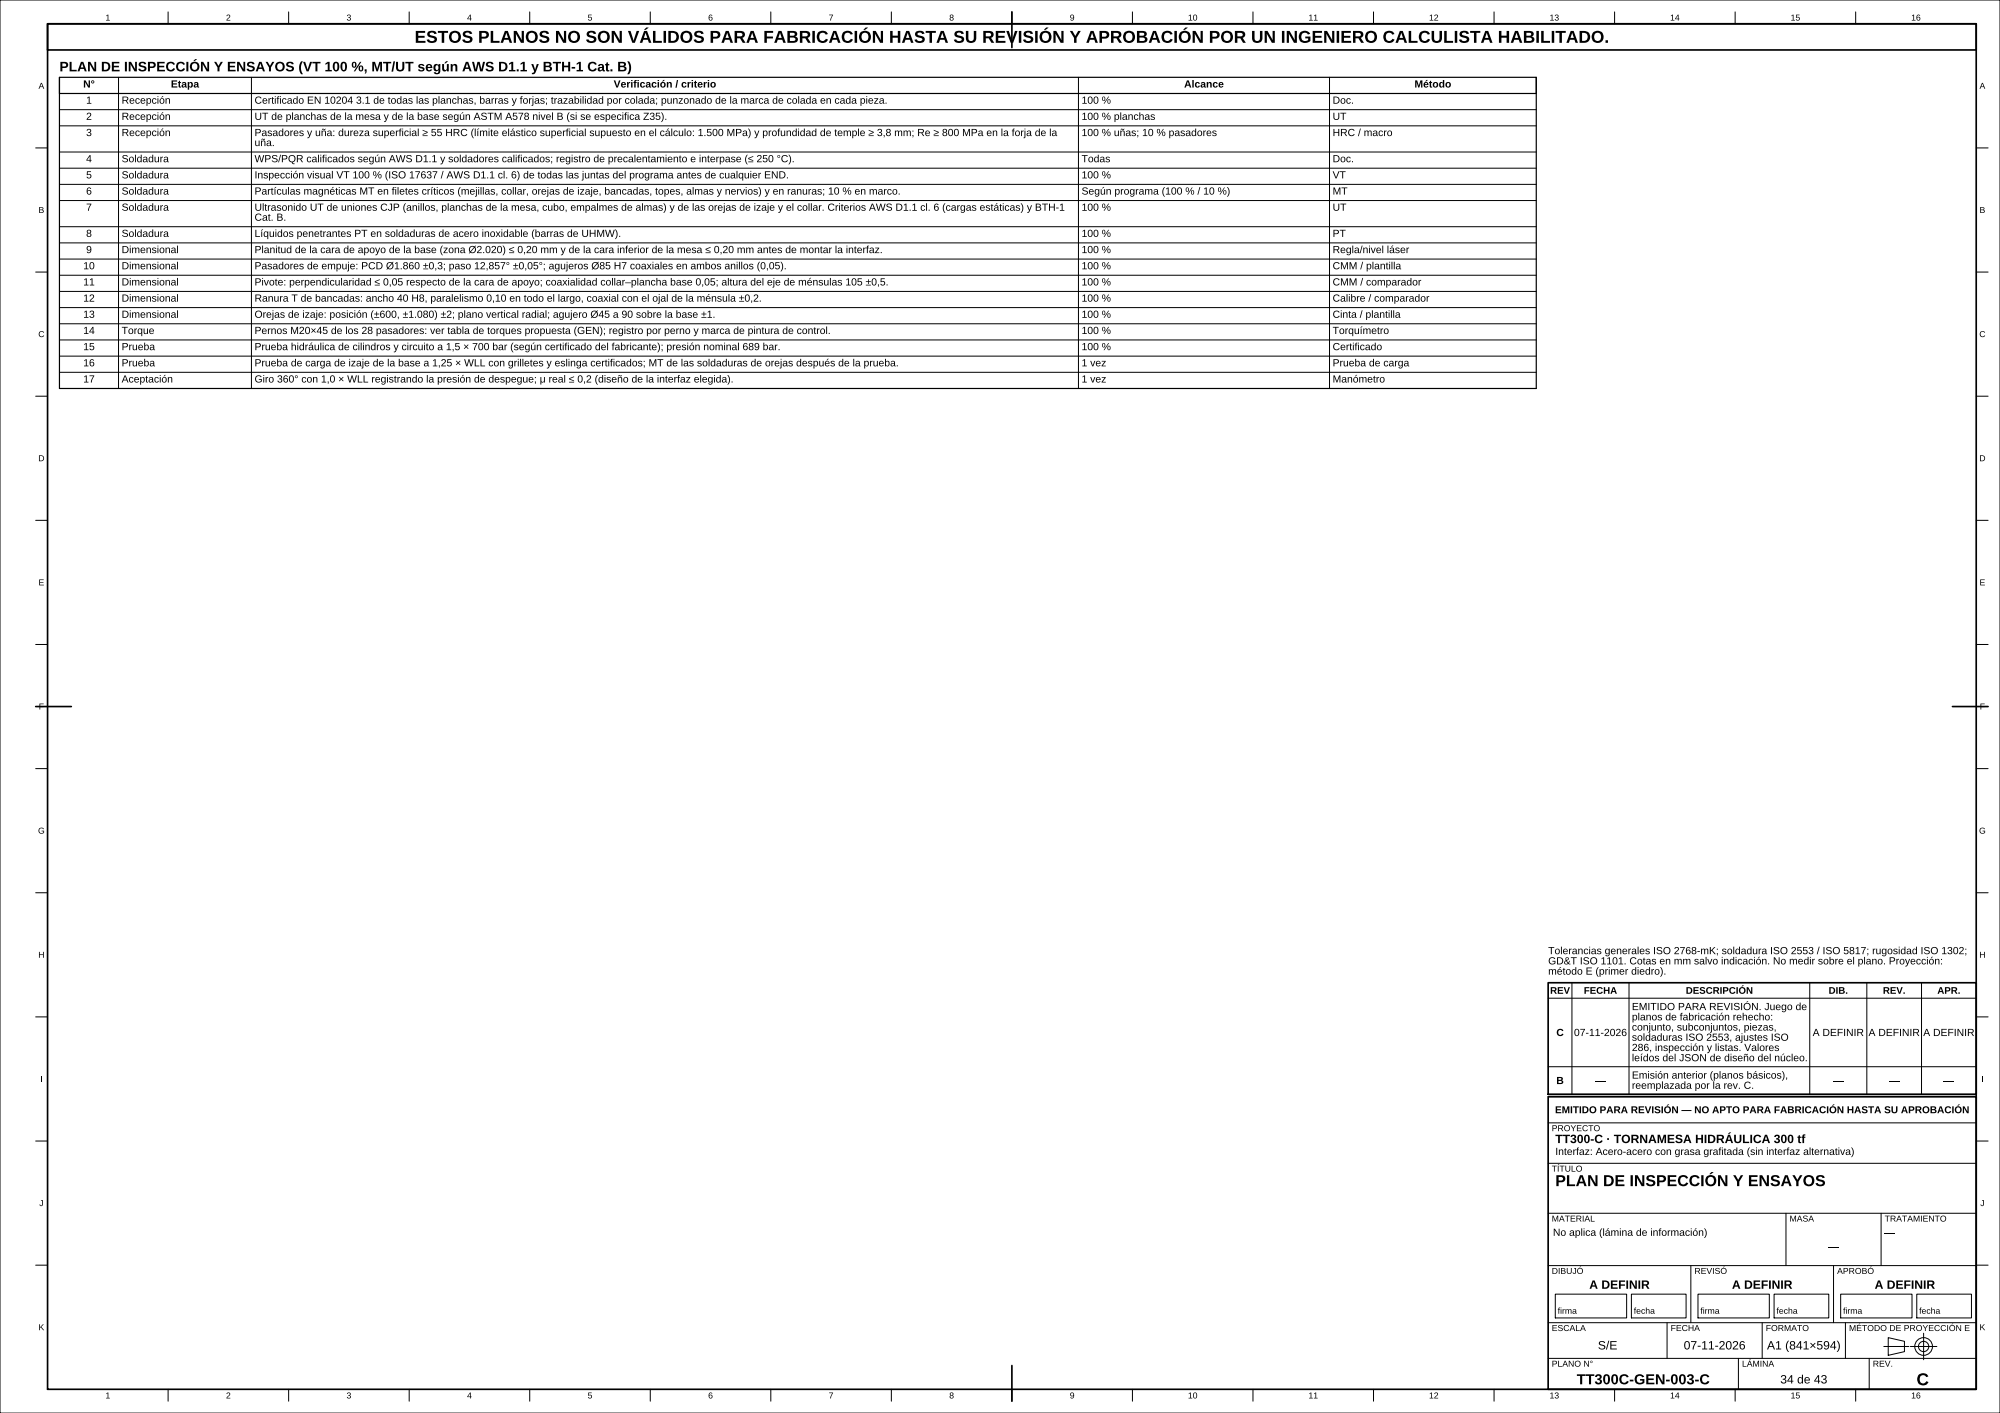
[picture p88: page 1]
