mafiucivil/Tornamesa/entregables/RevC/planos/TT300C-GEN-004-C.pdf

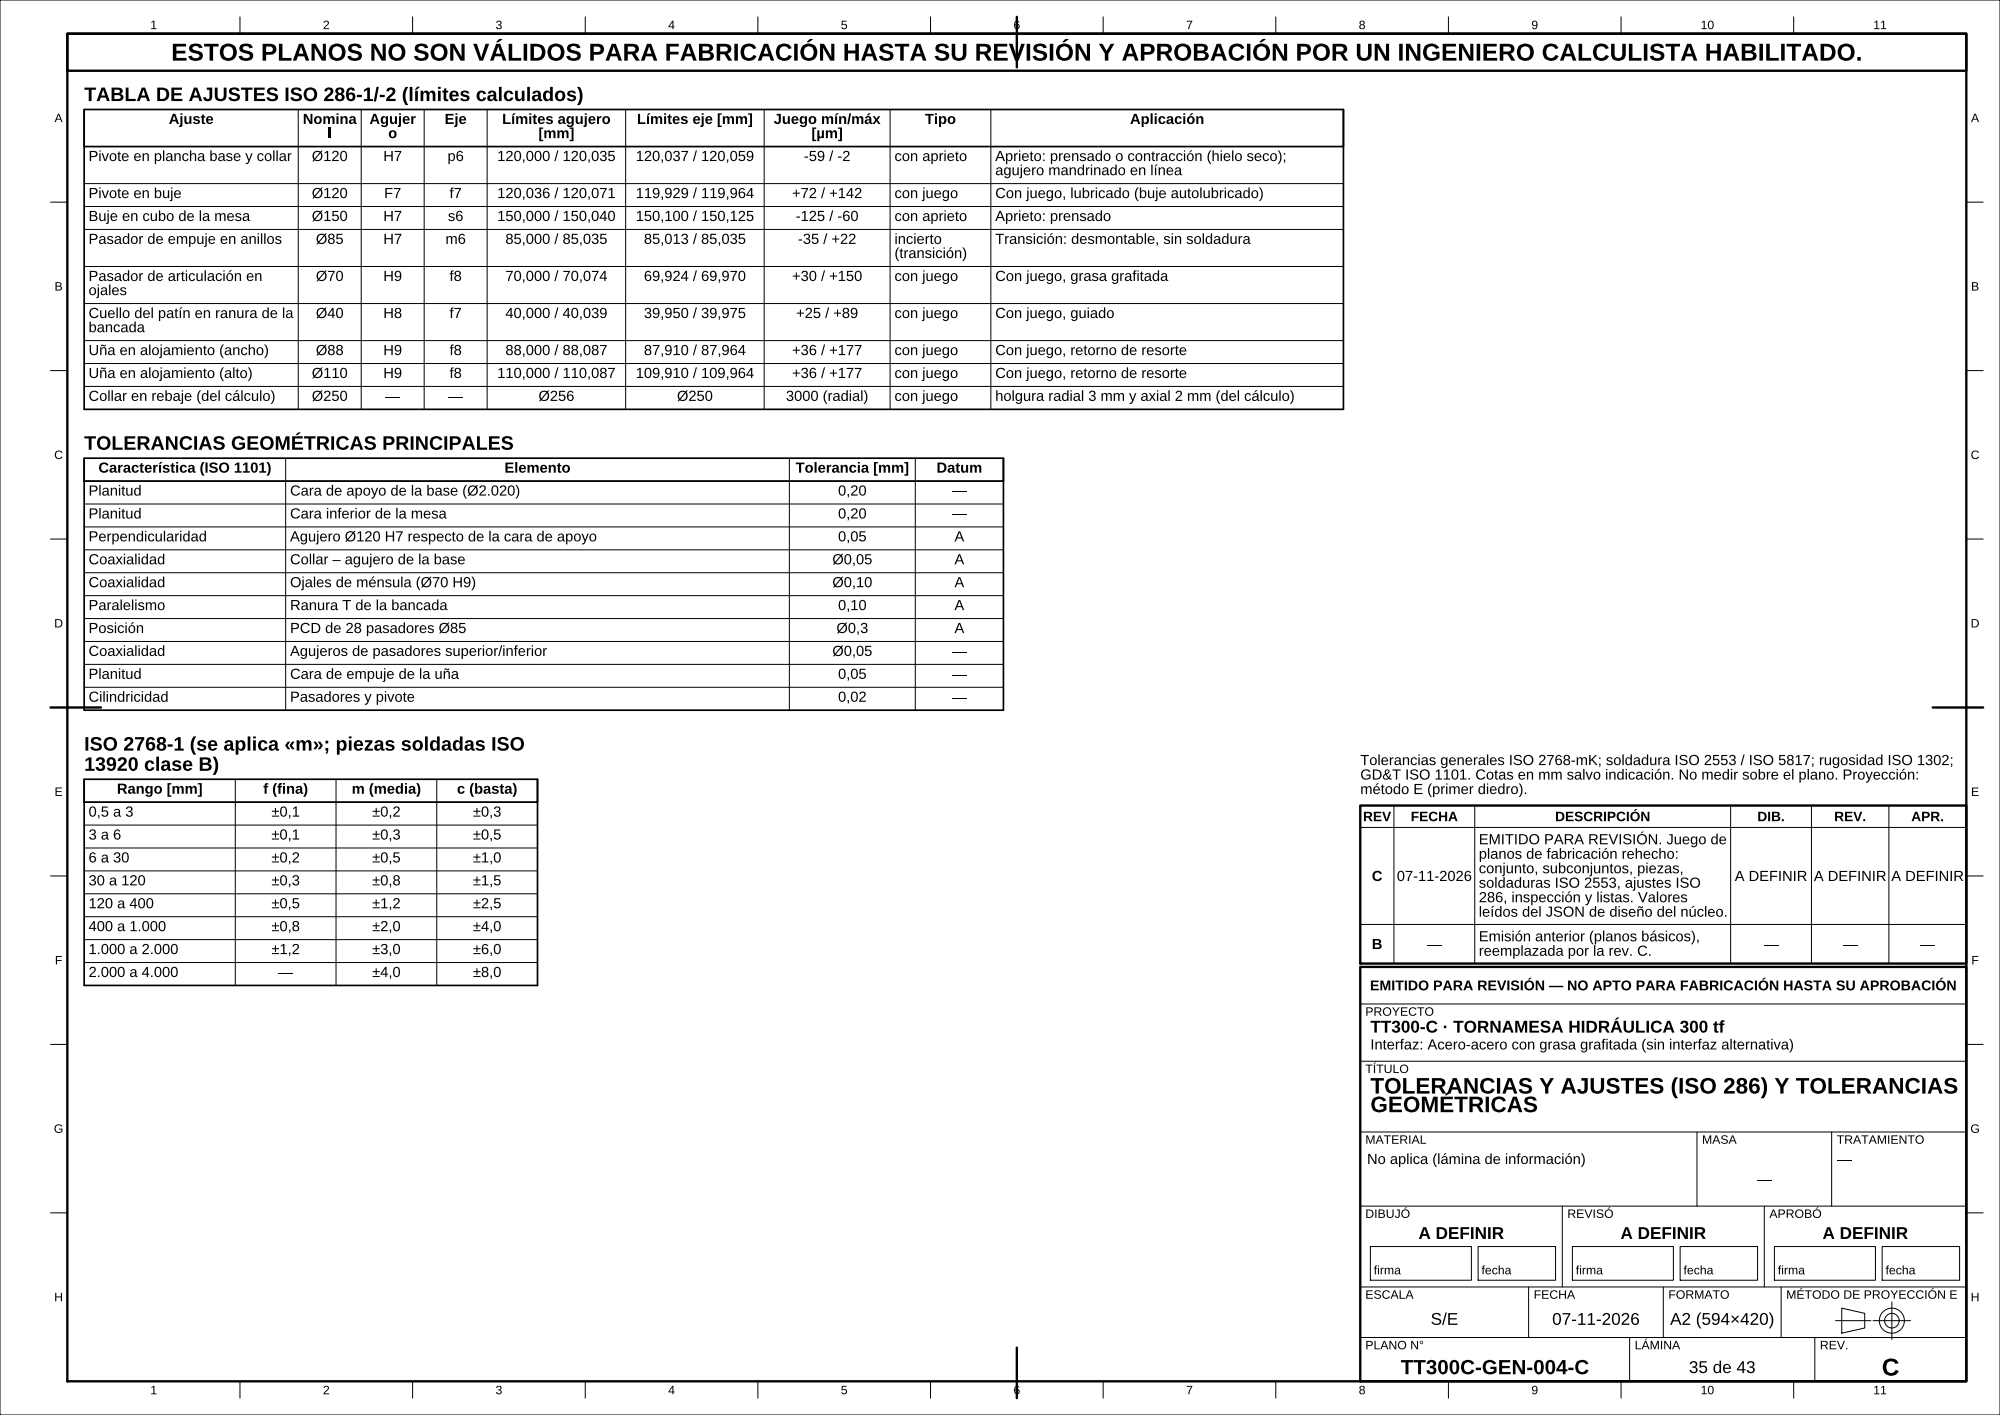
[picture p89: page 1]
