mafiucivil/Tornamesa/entregables/RevC/planos/TT300C-GEN-005-C.pdf

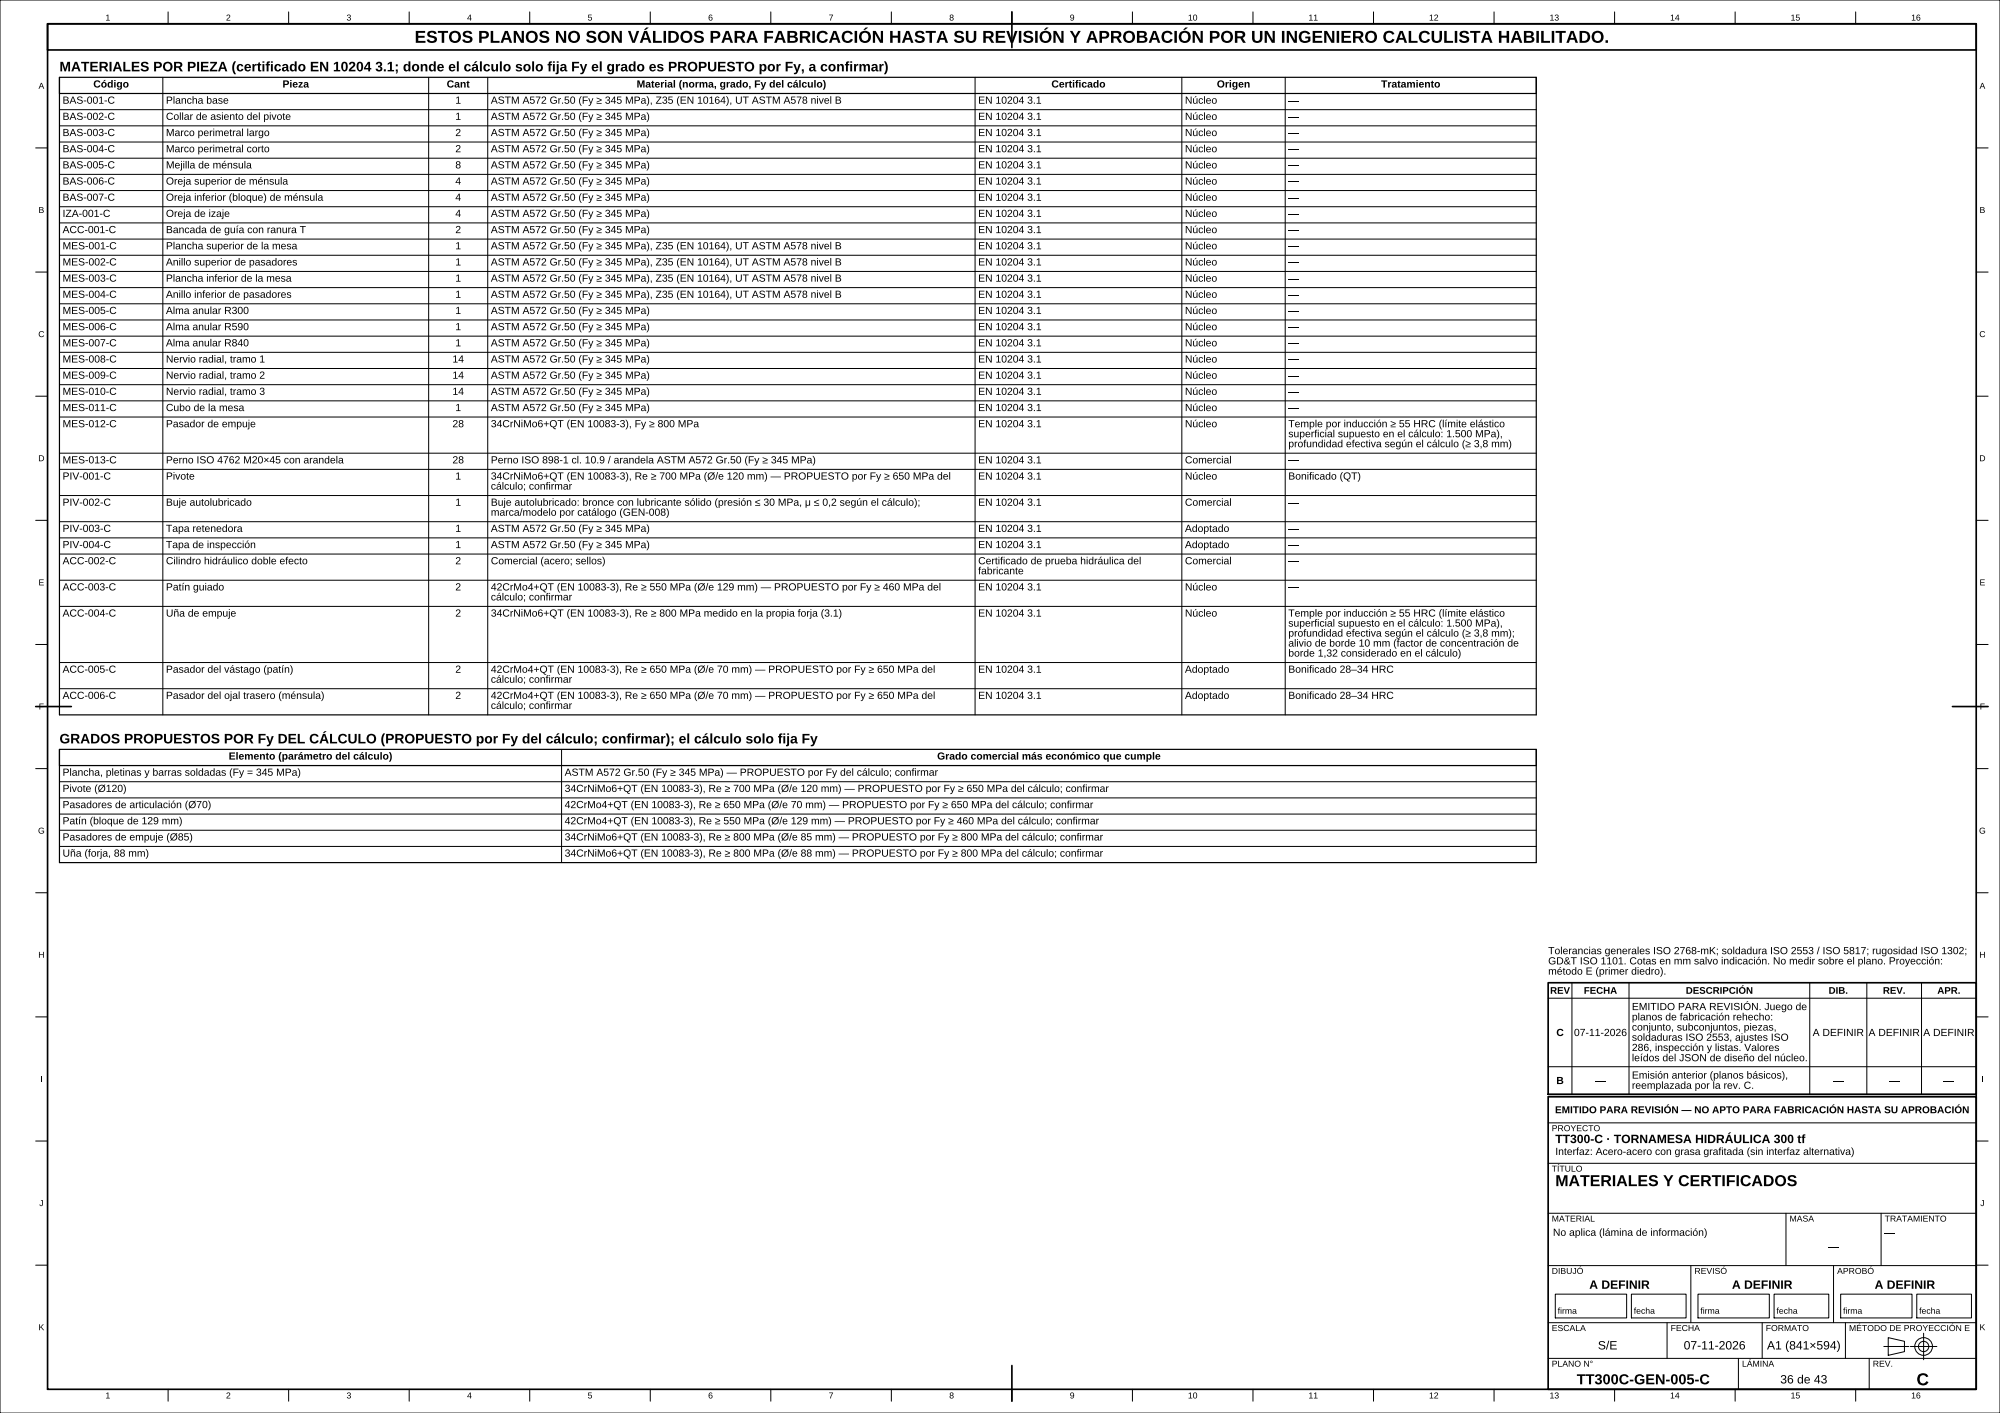
[picture p90: page 1]
