mafiucivil/Tornamesa/entregables/RevC/planos/TT300C-GEN-006-C.pdf

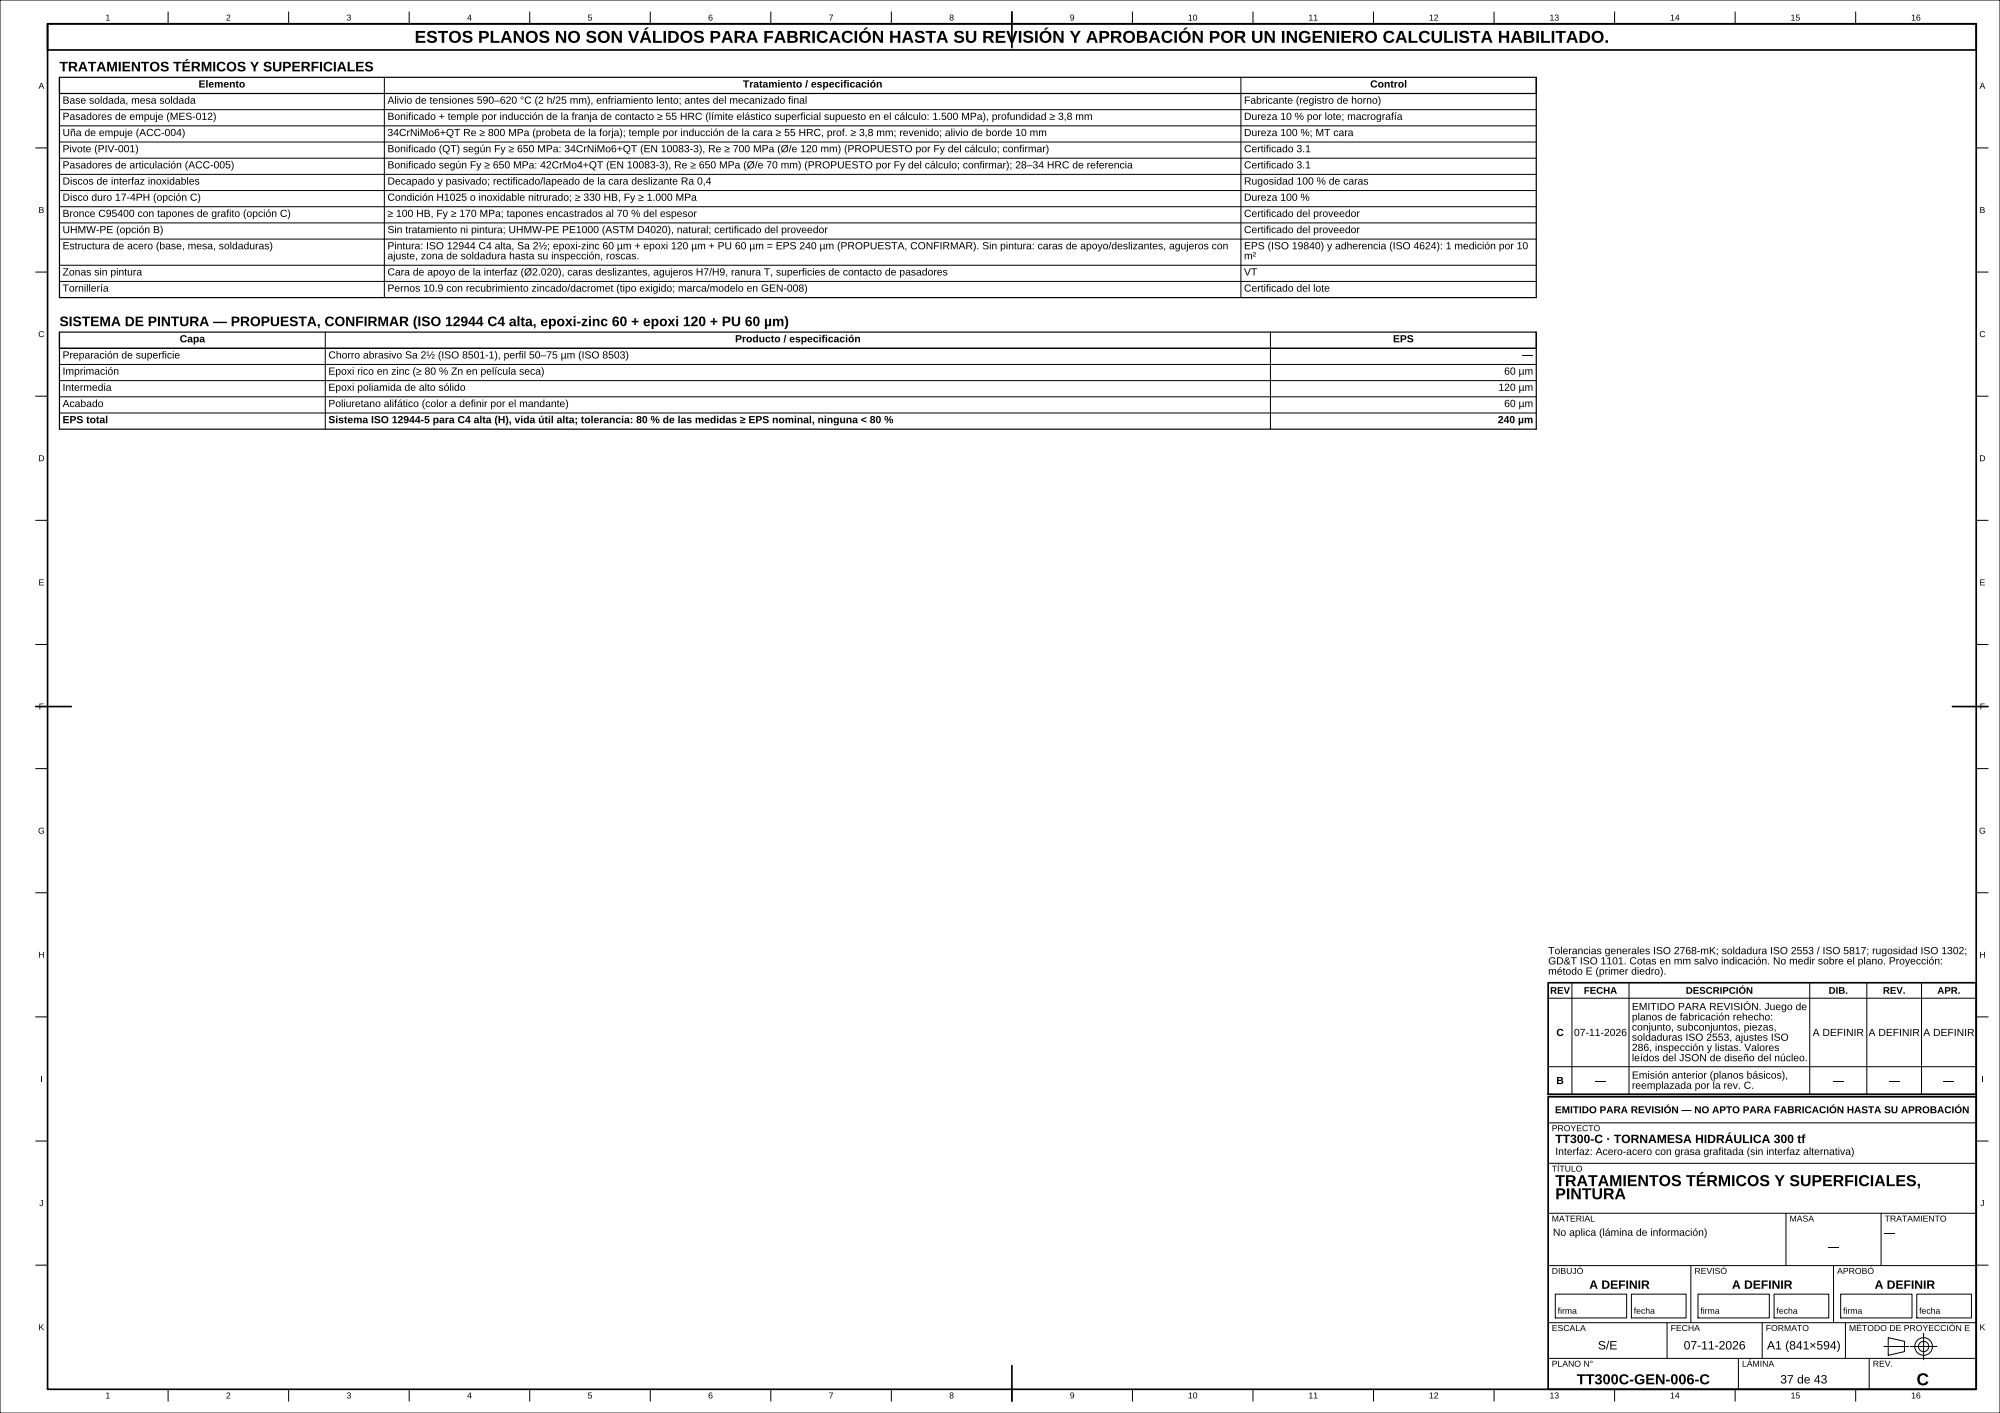
[picture p91: page 1]
