mafiucivil/Tornamesa/entregables/RevC/planos/TT300C-GEN-007-C.pdf

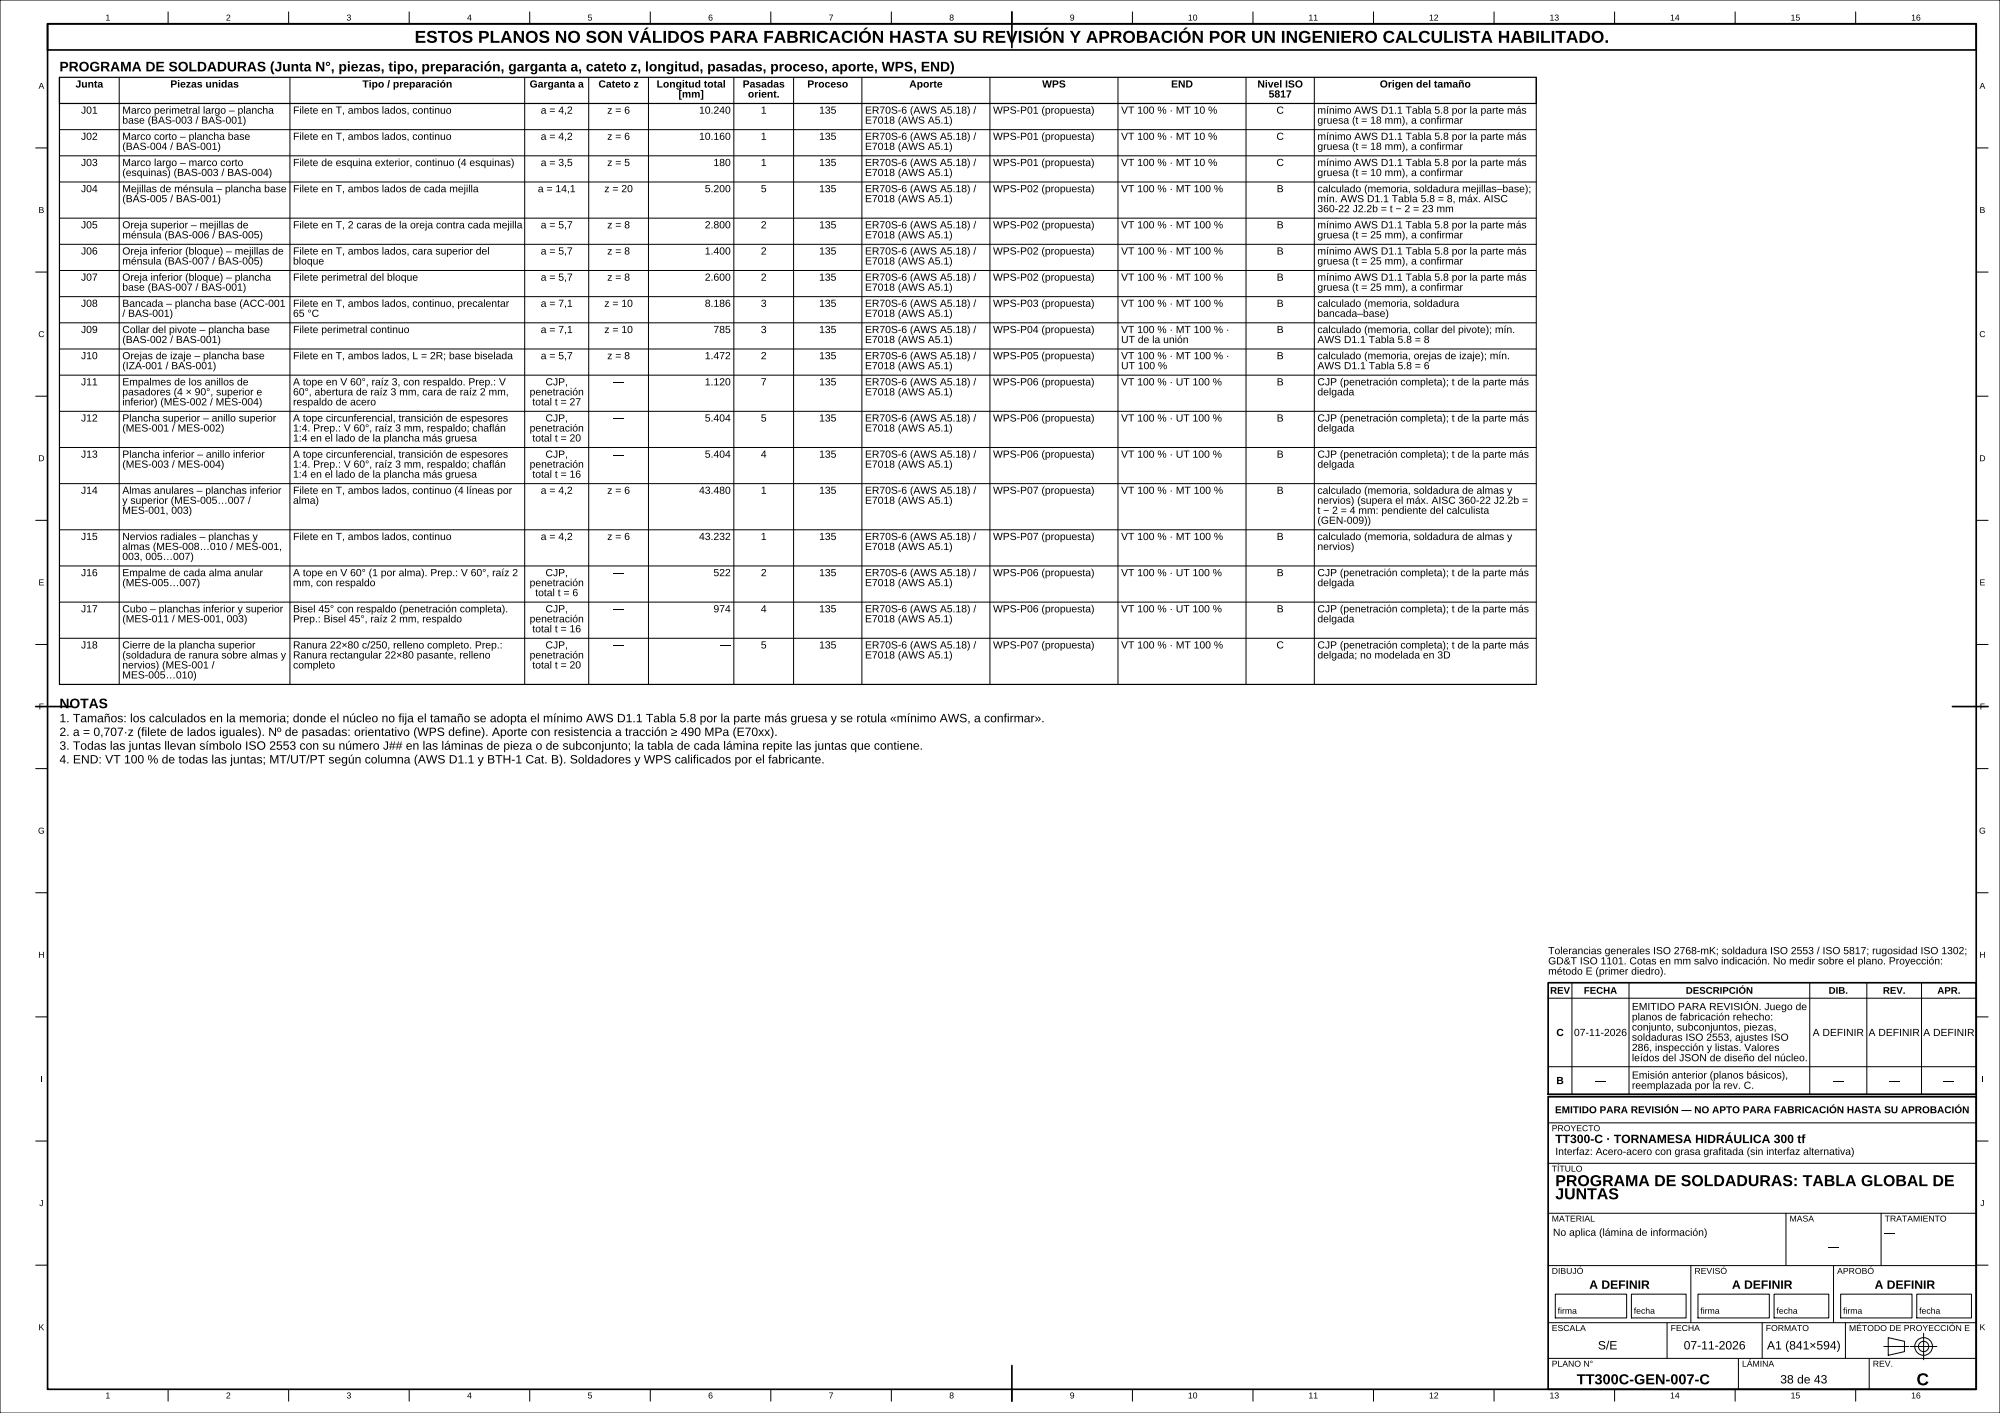
[picture p92: page 1]
