mafiucivil/Tornamesa/entregables/RevC/planos/TT300C-GEN-008-C.pdf

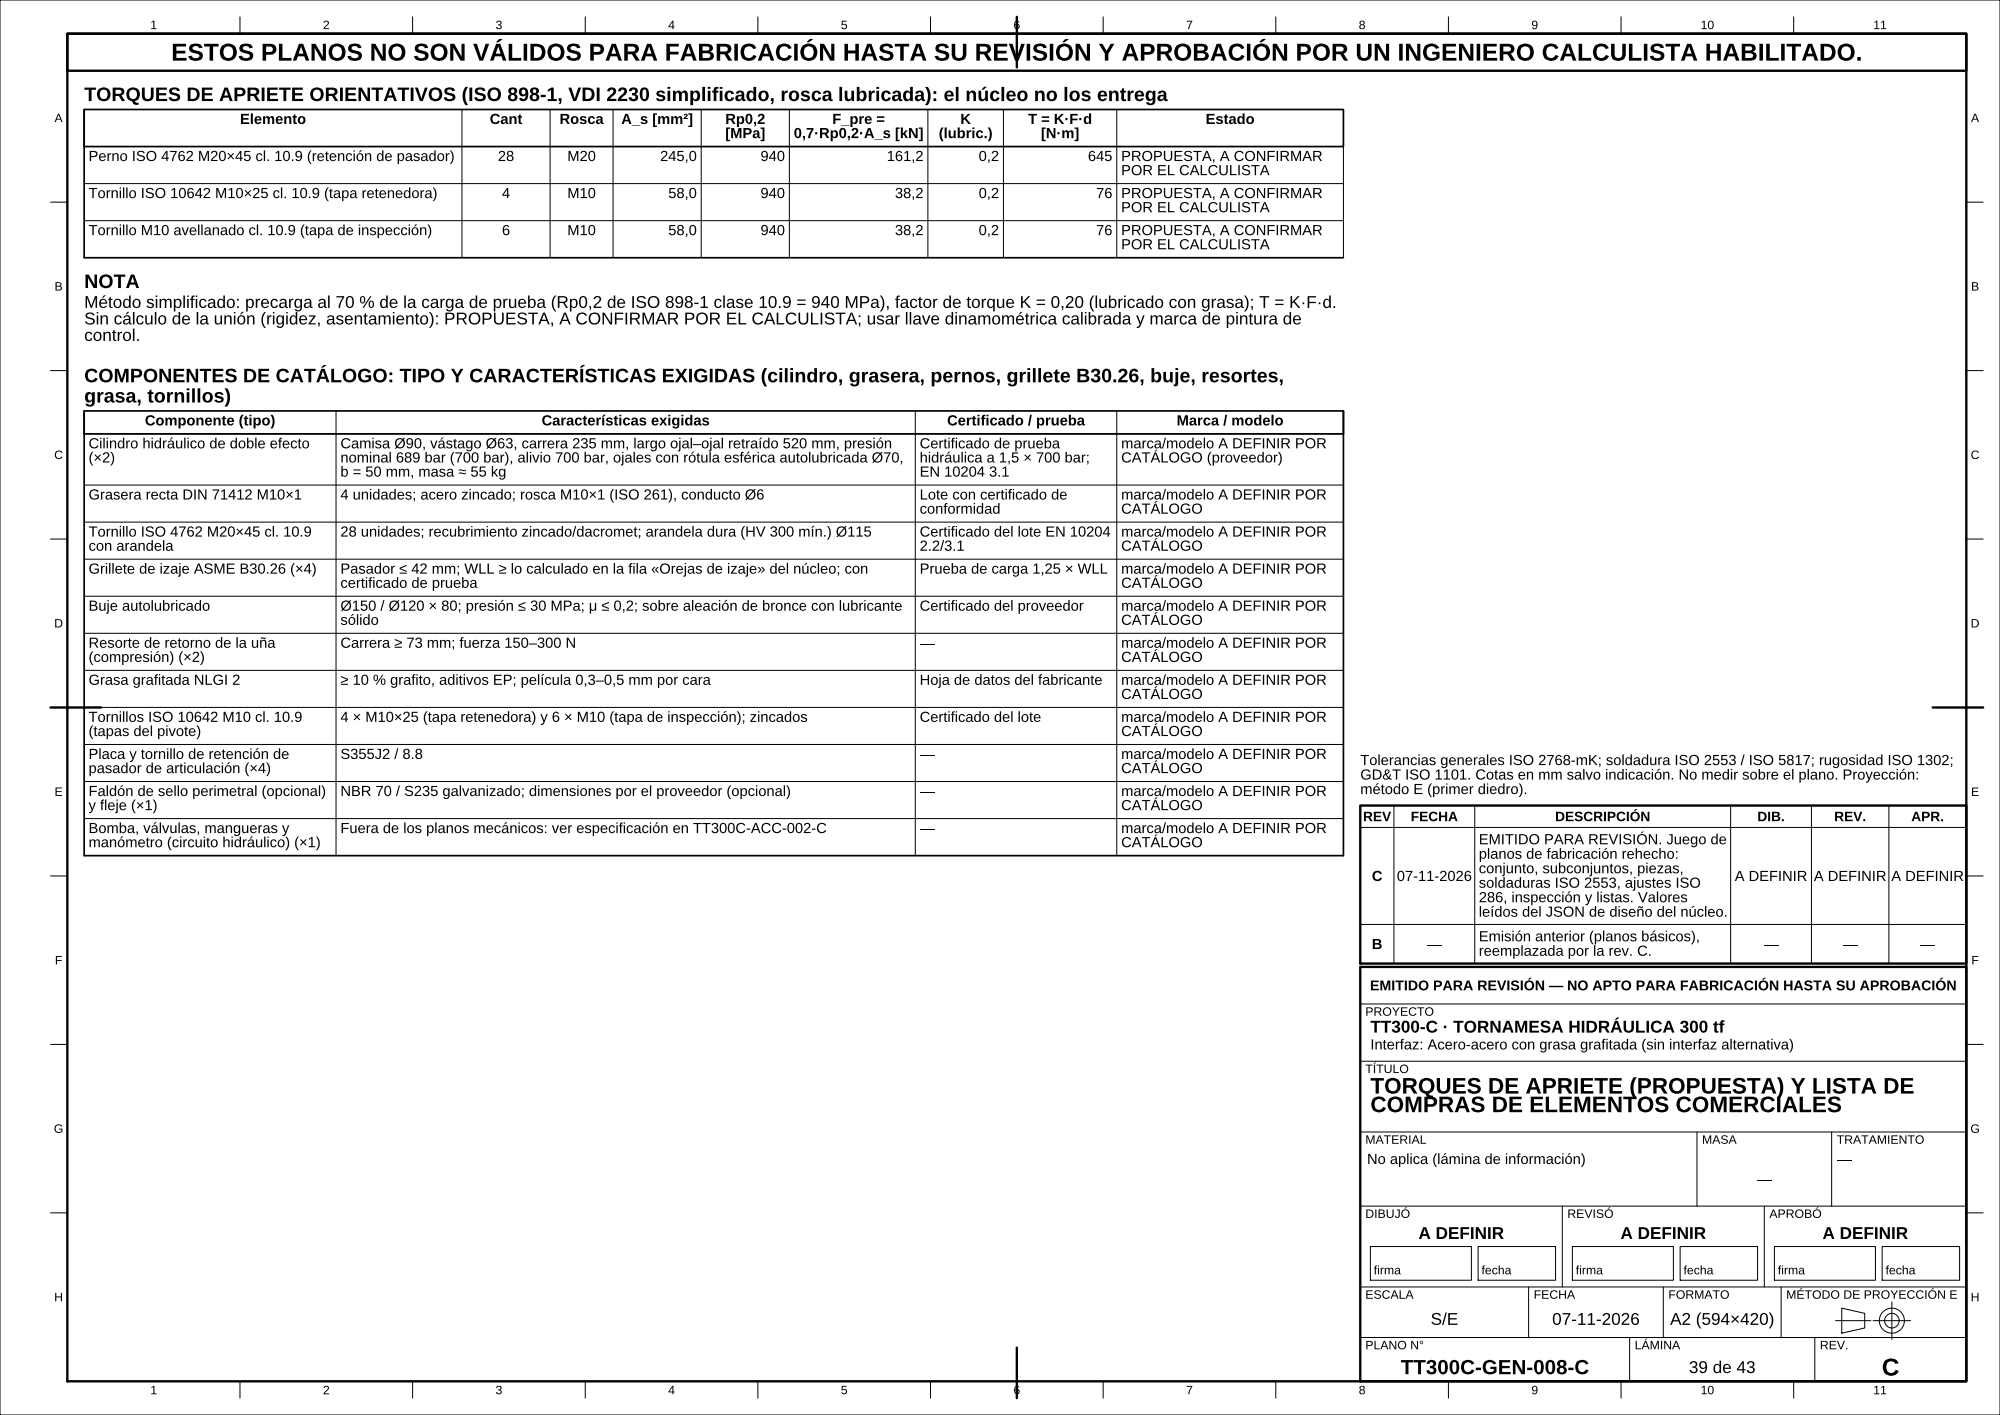
[picture p93: page 1]
