mafiucivil/Tornamesa/entregables/RevC/planos/TT300C-GEN-009-C.pdf

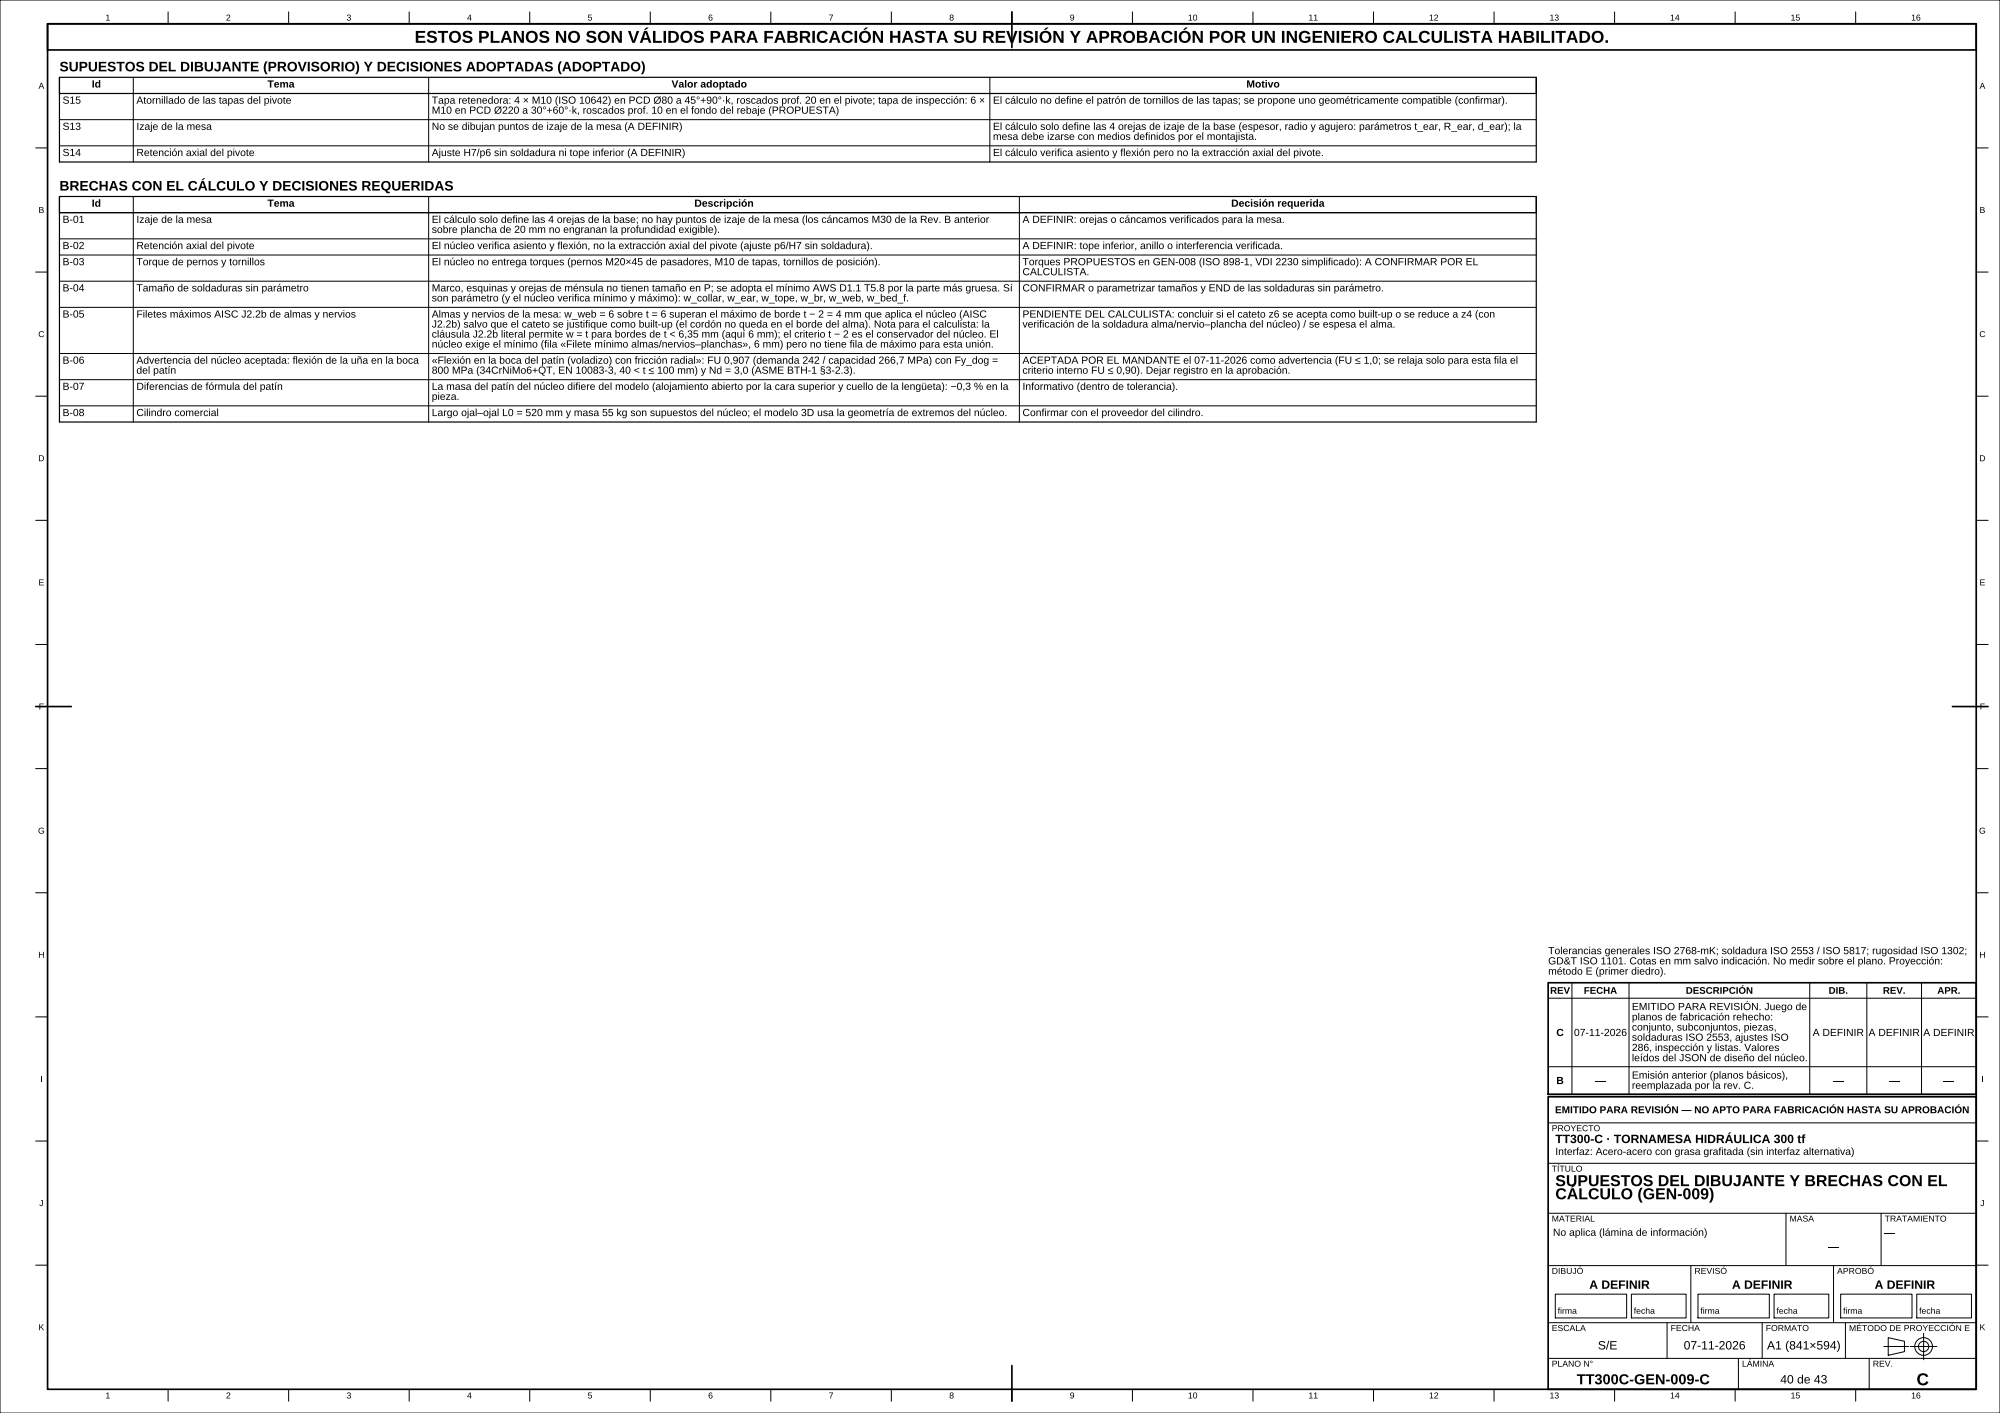
[picture p94: page 1]
