mafiucivil/Tornamesa/entregables/RevC/planos/TT300C-GEN-010-C.pdf

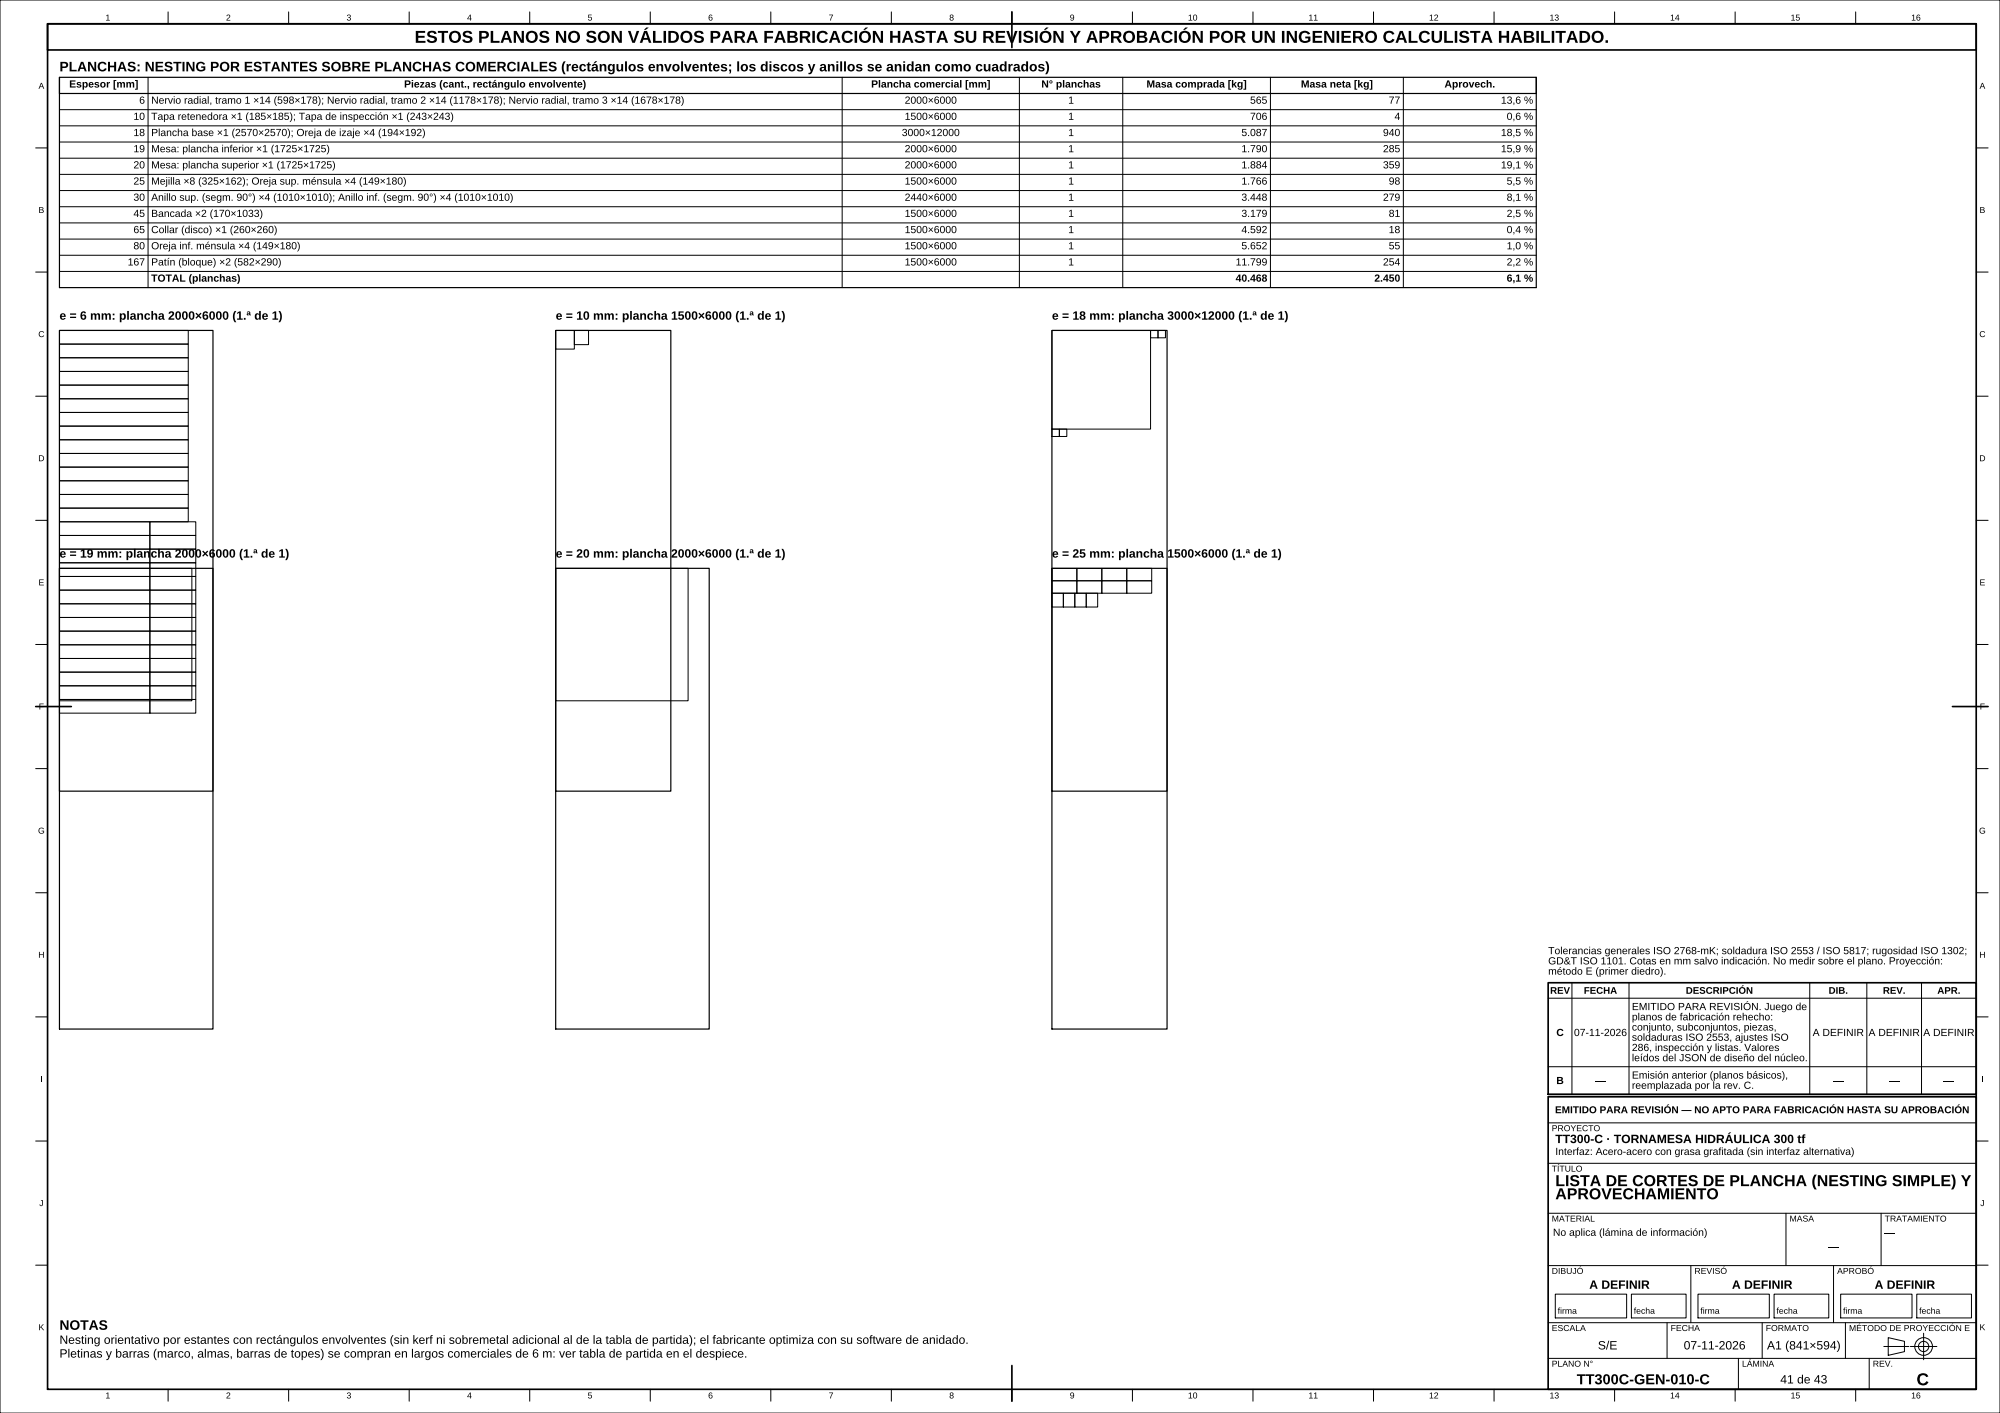
[picture p95: page 1]
