mafiucivil/Tornamesa/entregables/RevC/planos/TT300C-GEN-011-C.pdf

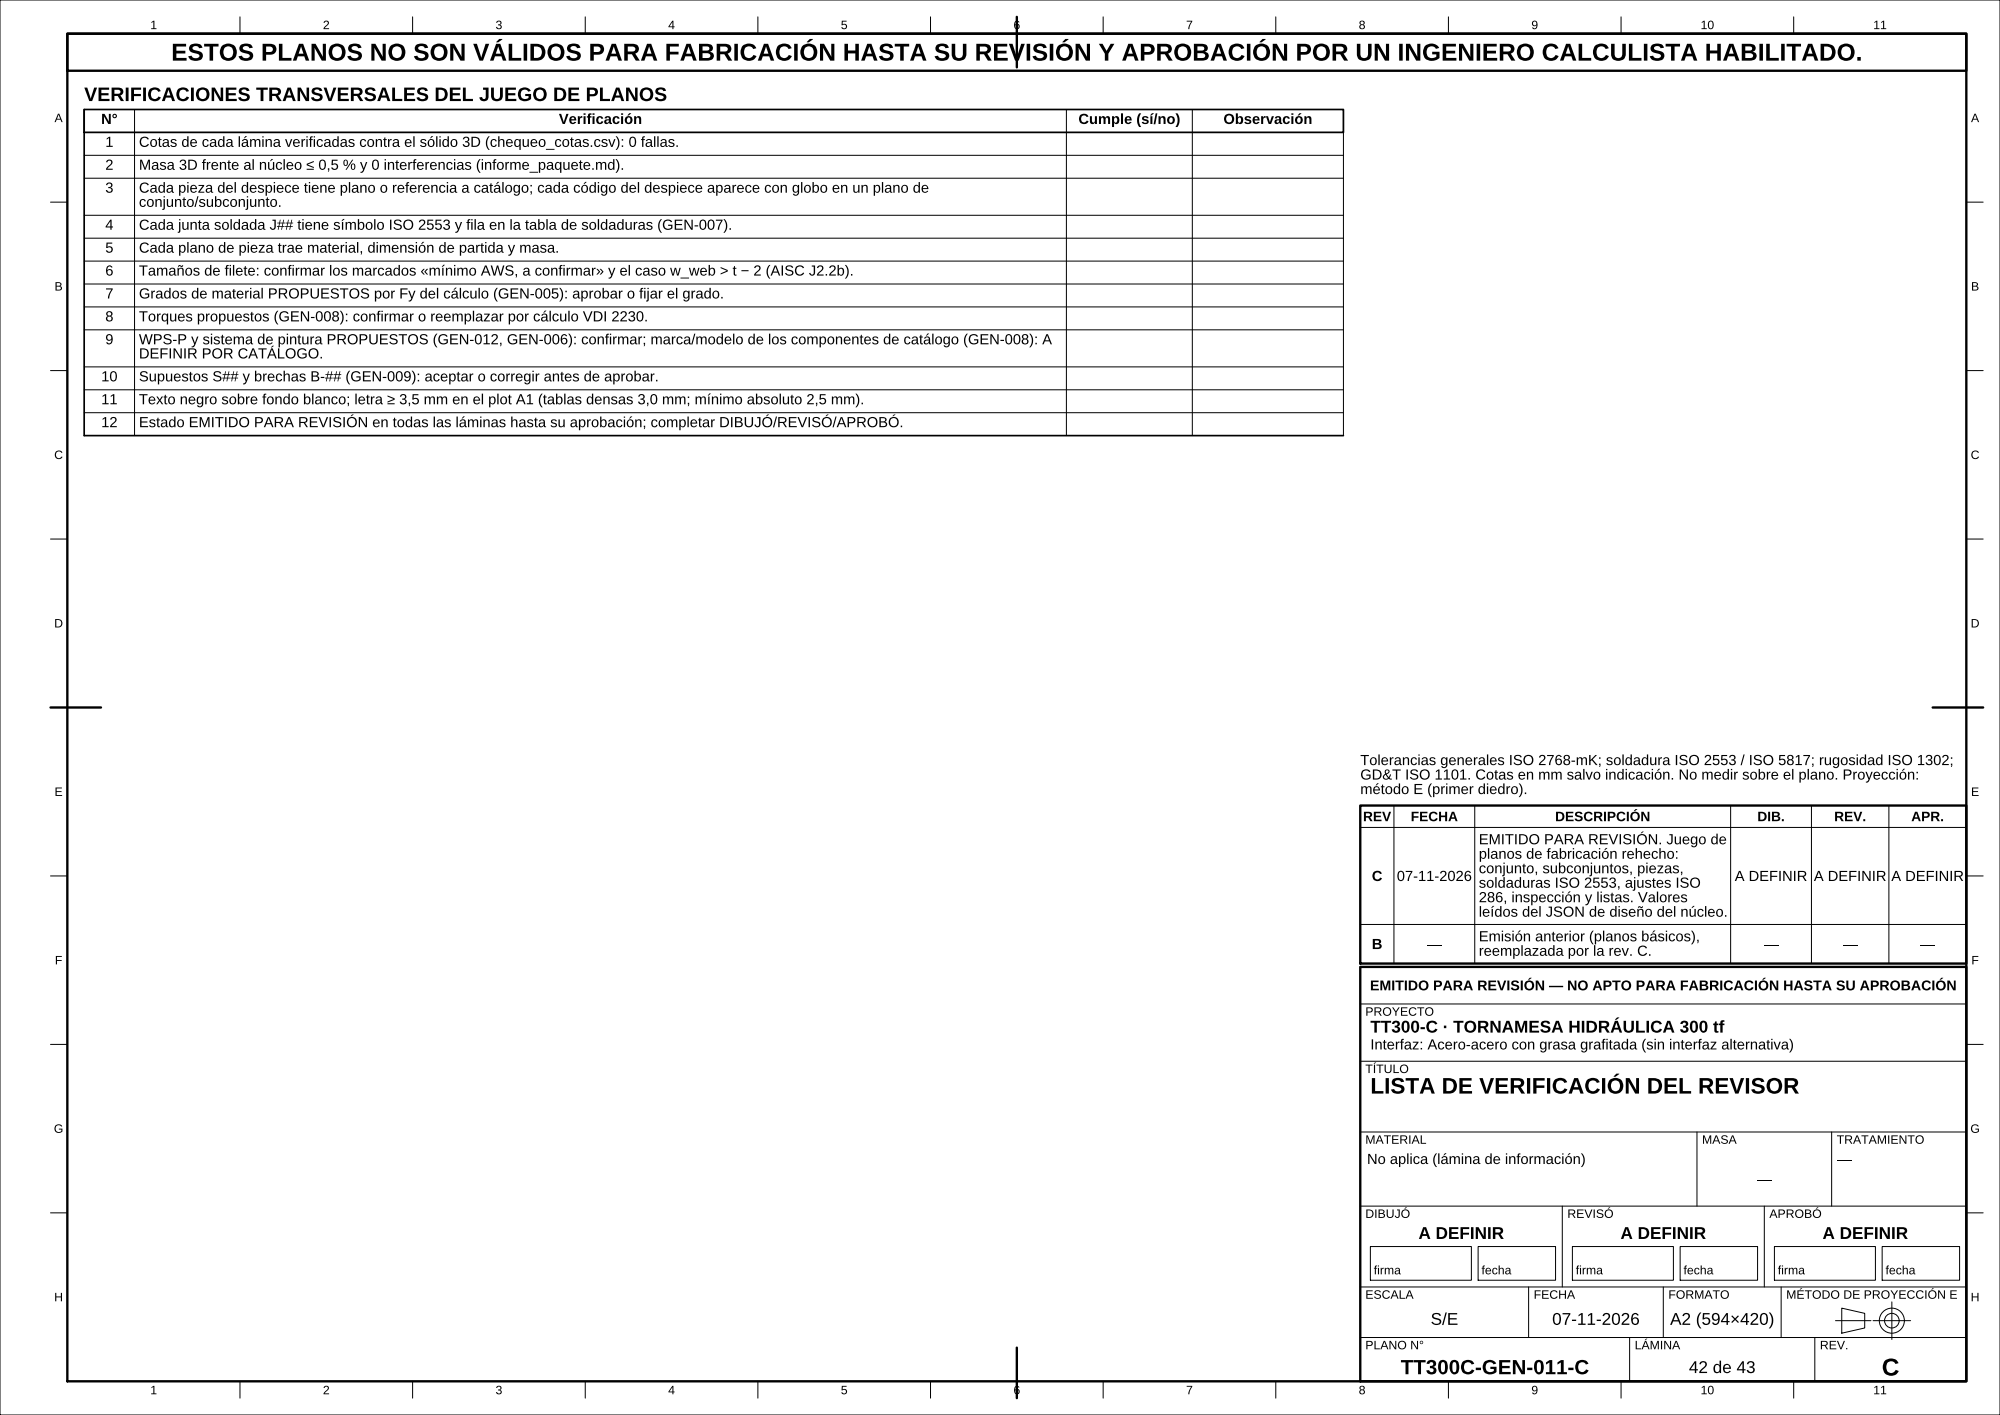
[picture p96: page 1]
