mafiucivil/Tornamesa/entregables/RevC/planos/TT300C-GEN-012-C.pdf

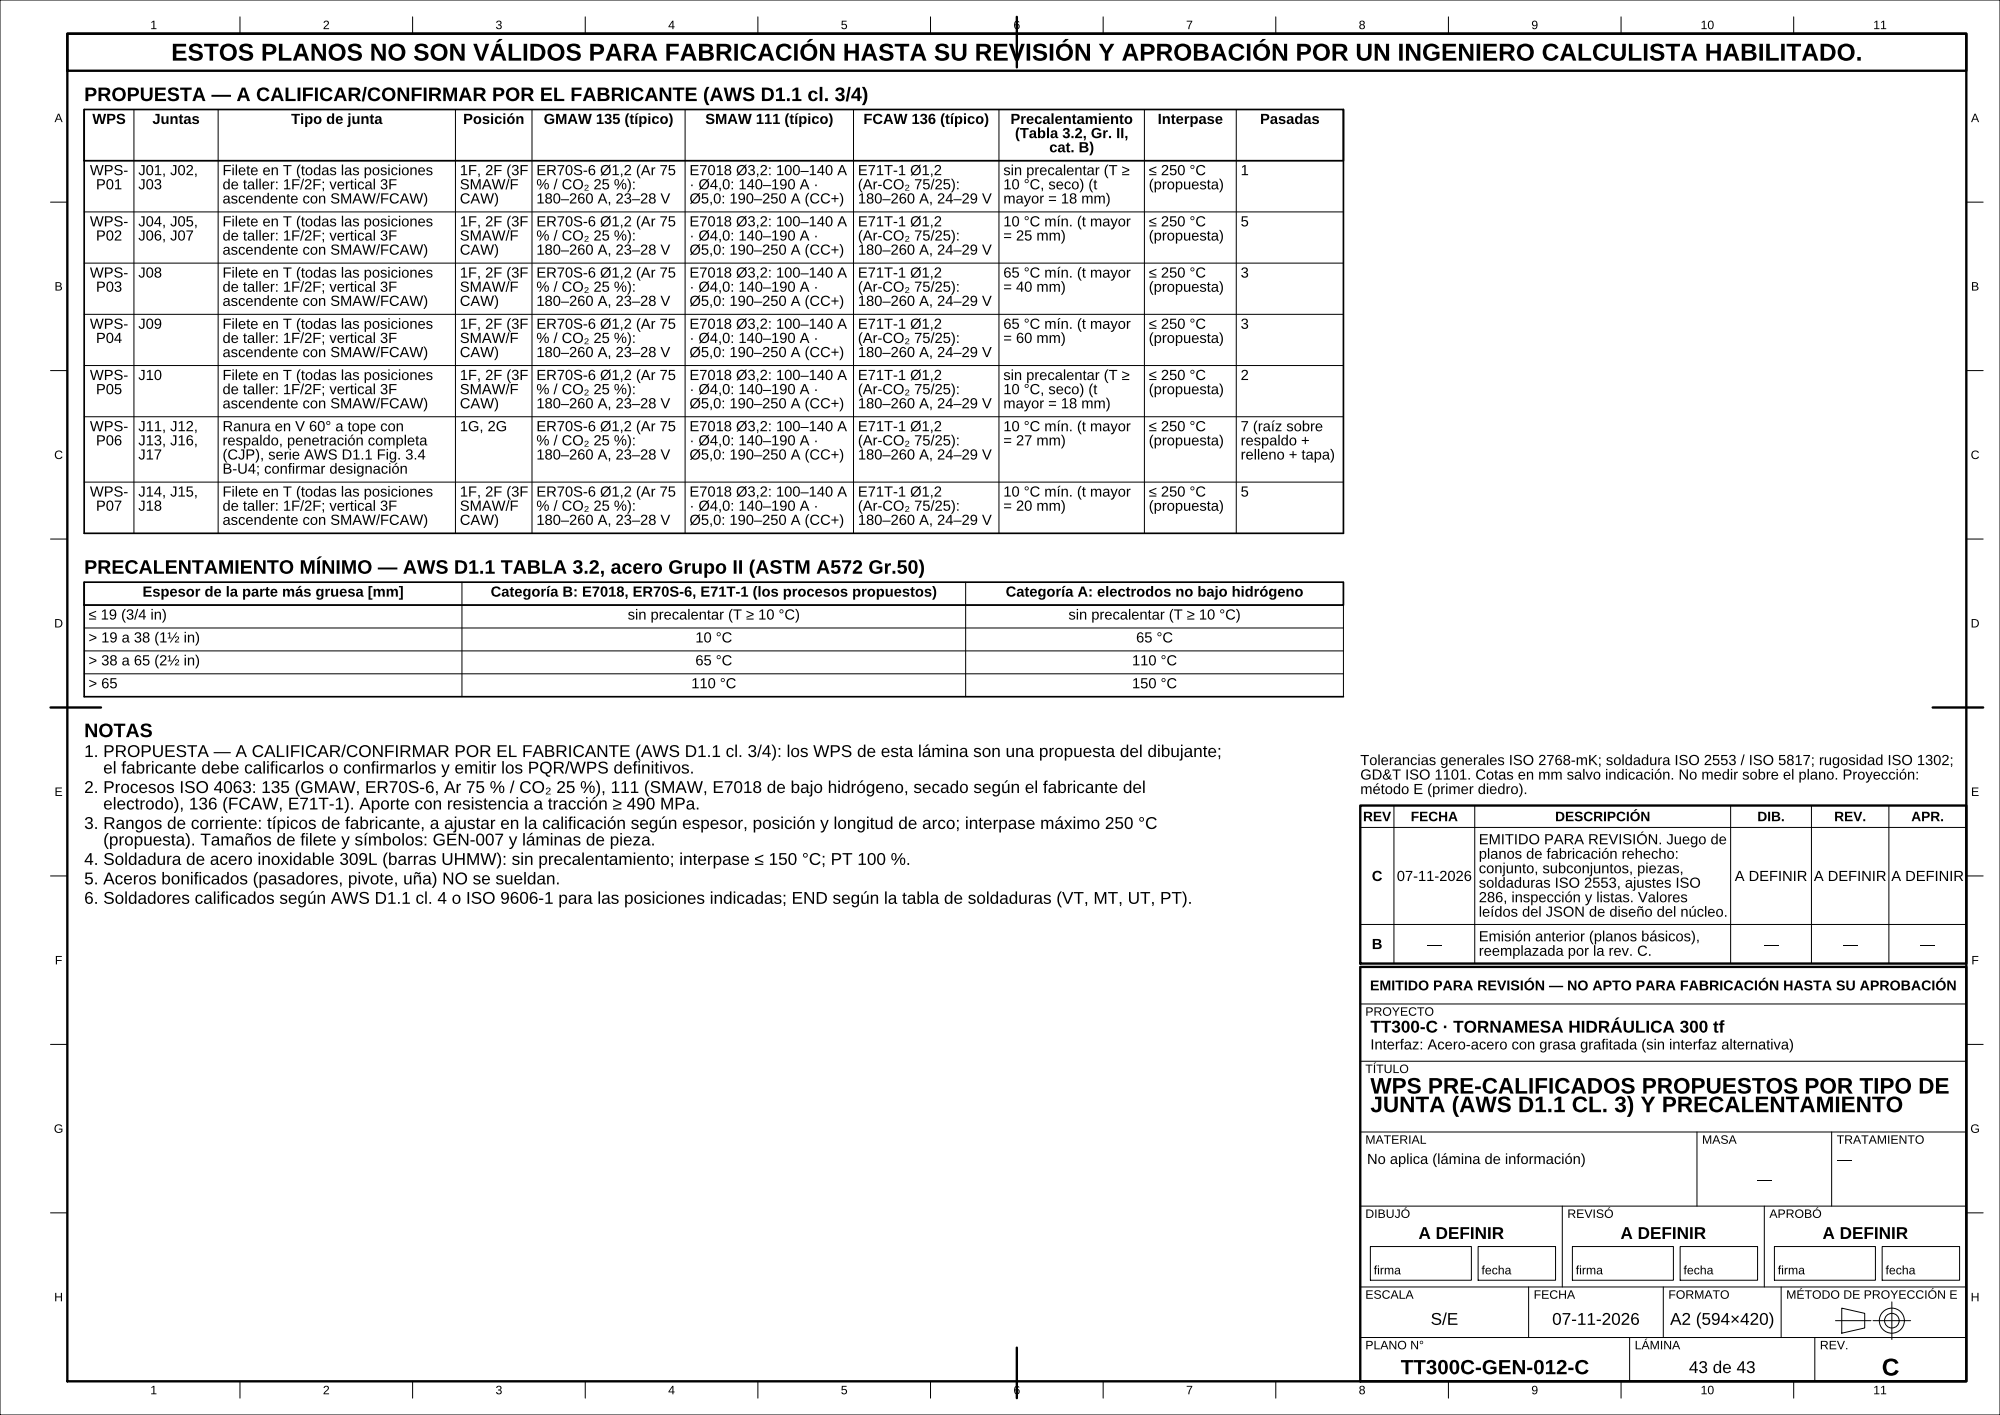
[picture p97: page 1]
