mafiucivil/Tornamesa/entregables/RevC/planos/TT300C-IZA-001-C.pdf

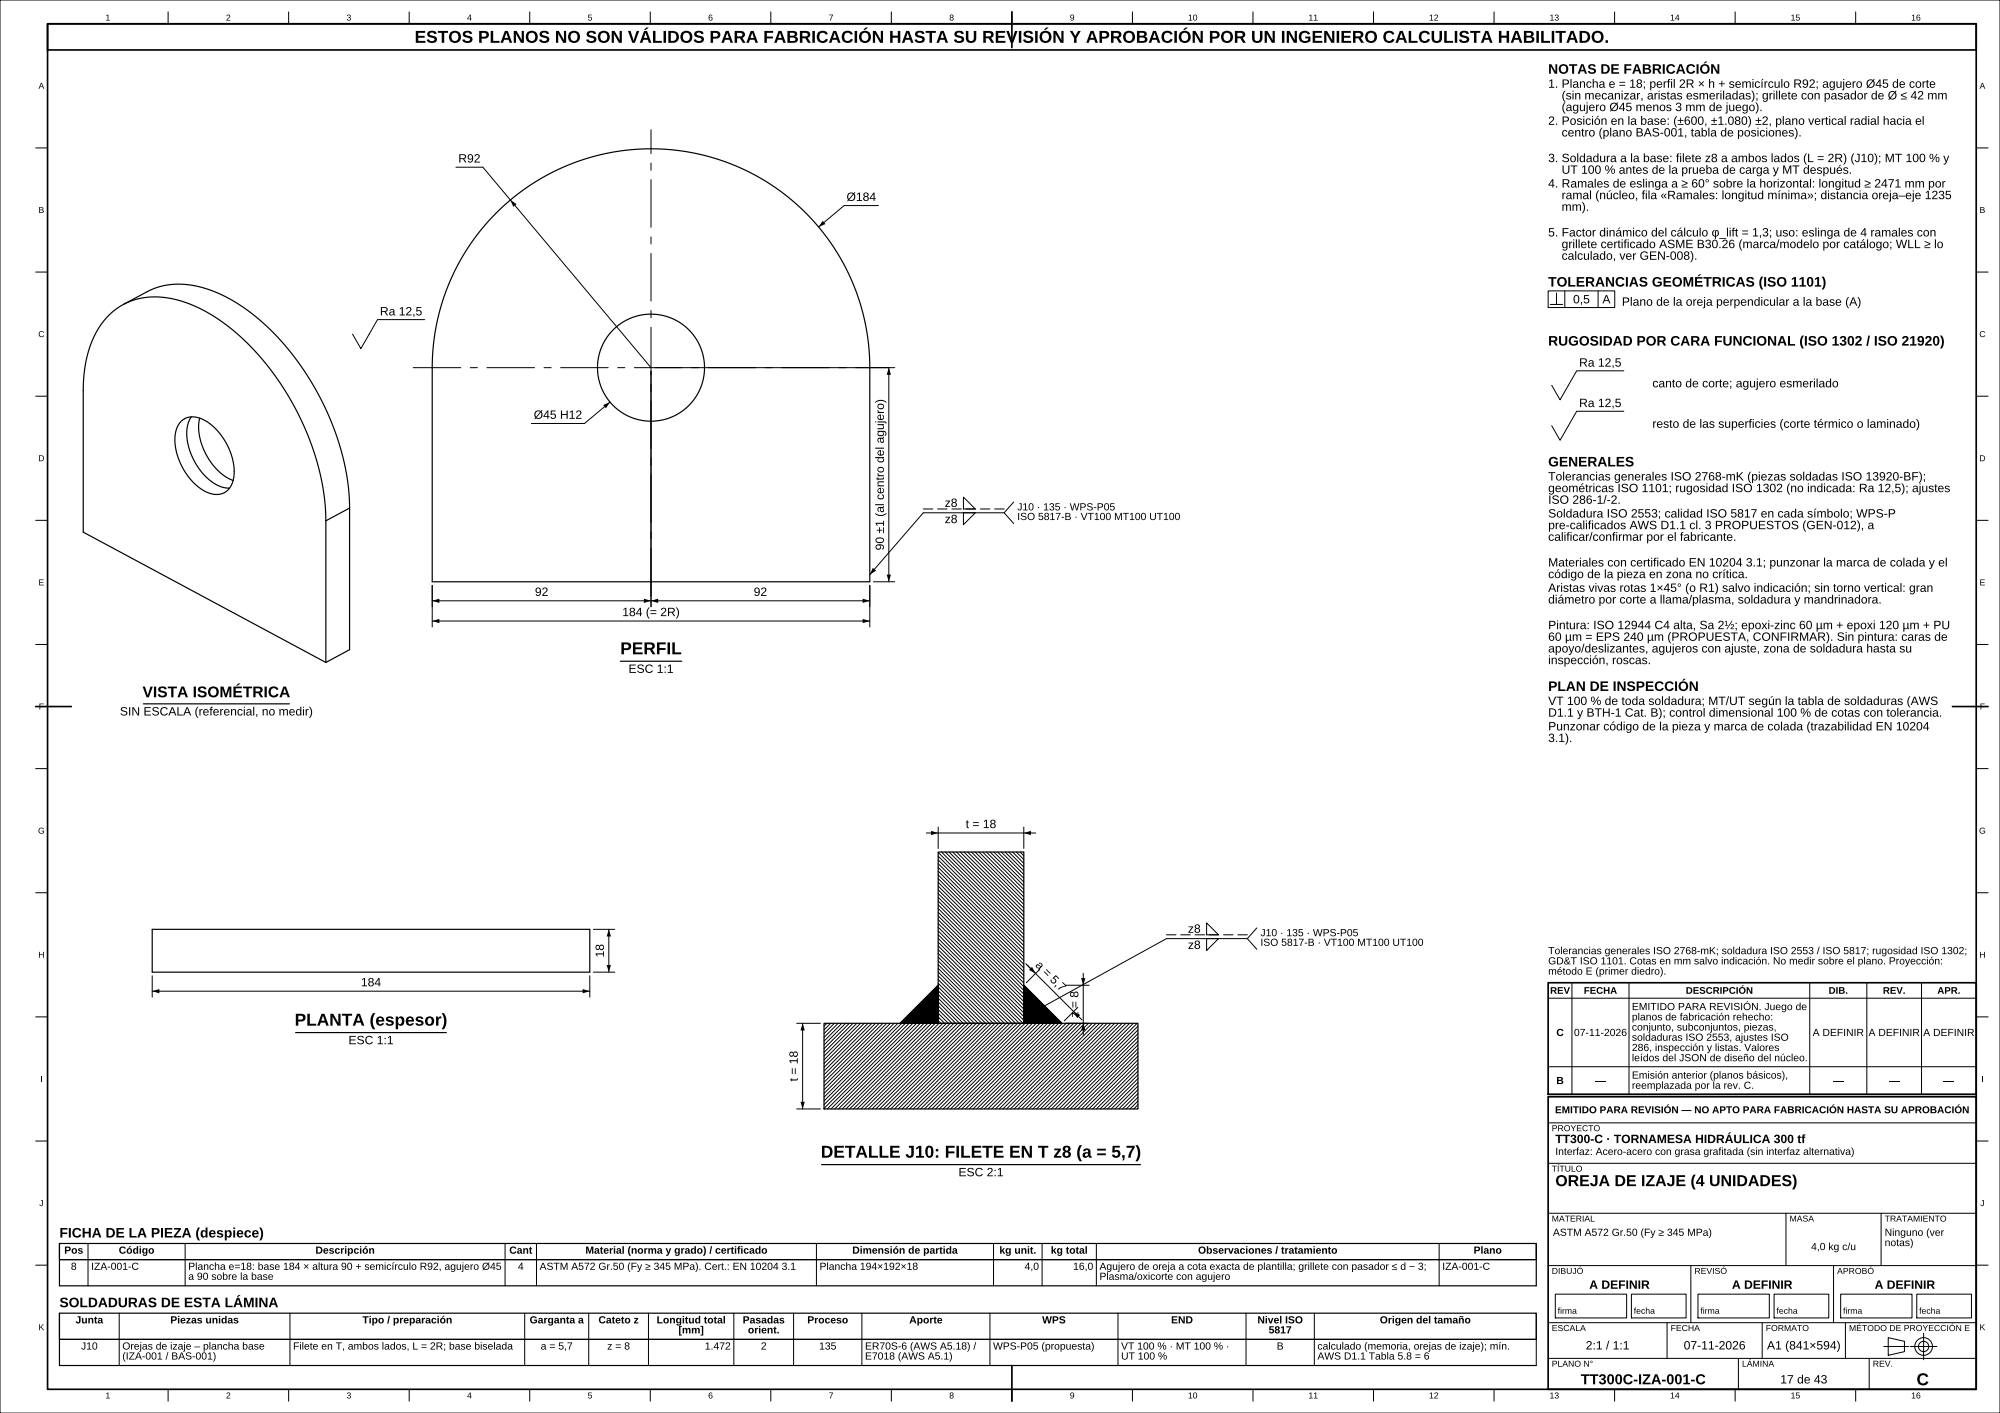
[picture p98: page 1]
