mafiucivil/Tornamesa/entregables/RevC/planos/TT300C-MES-001-C.pdf

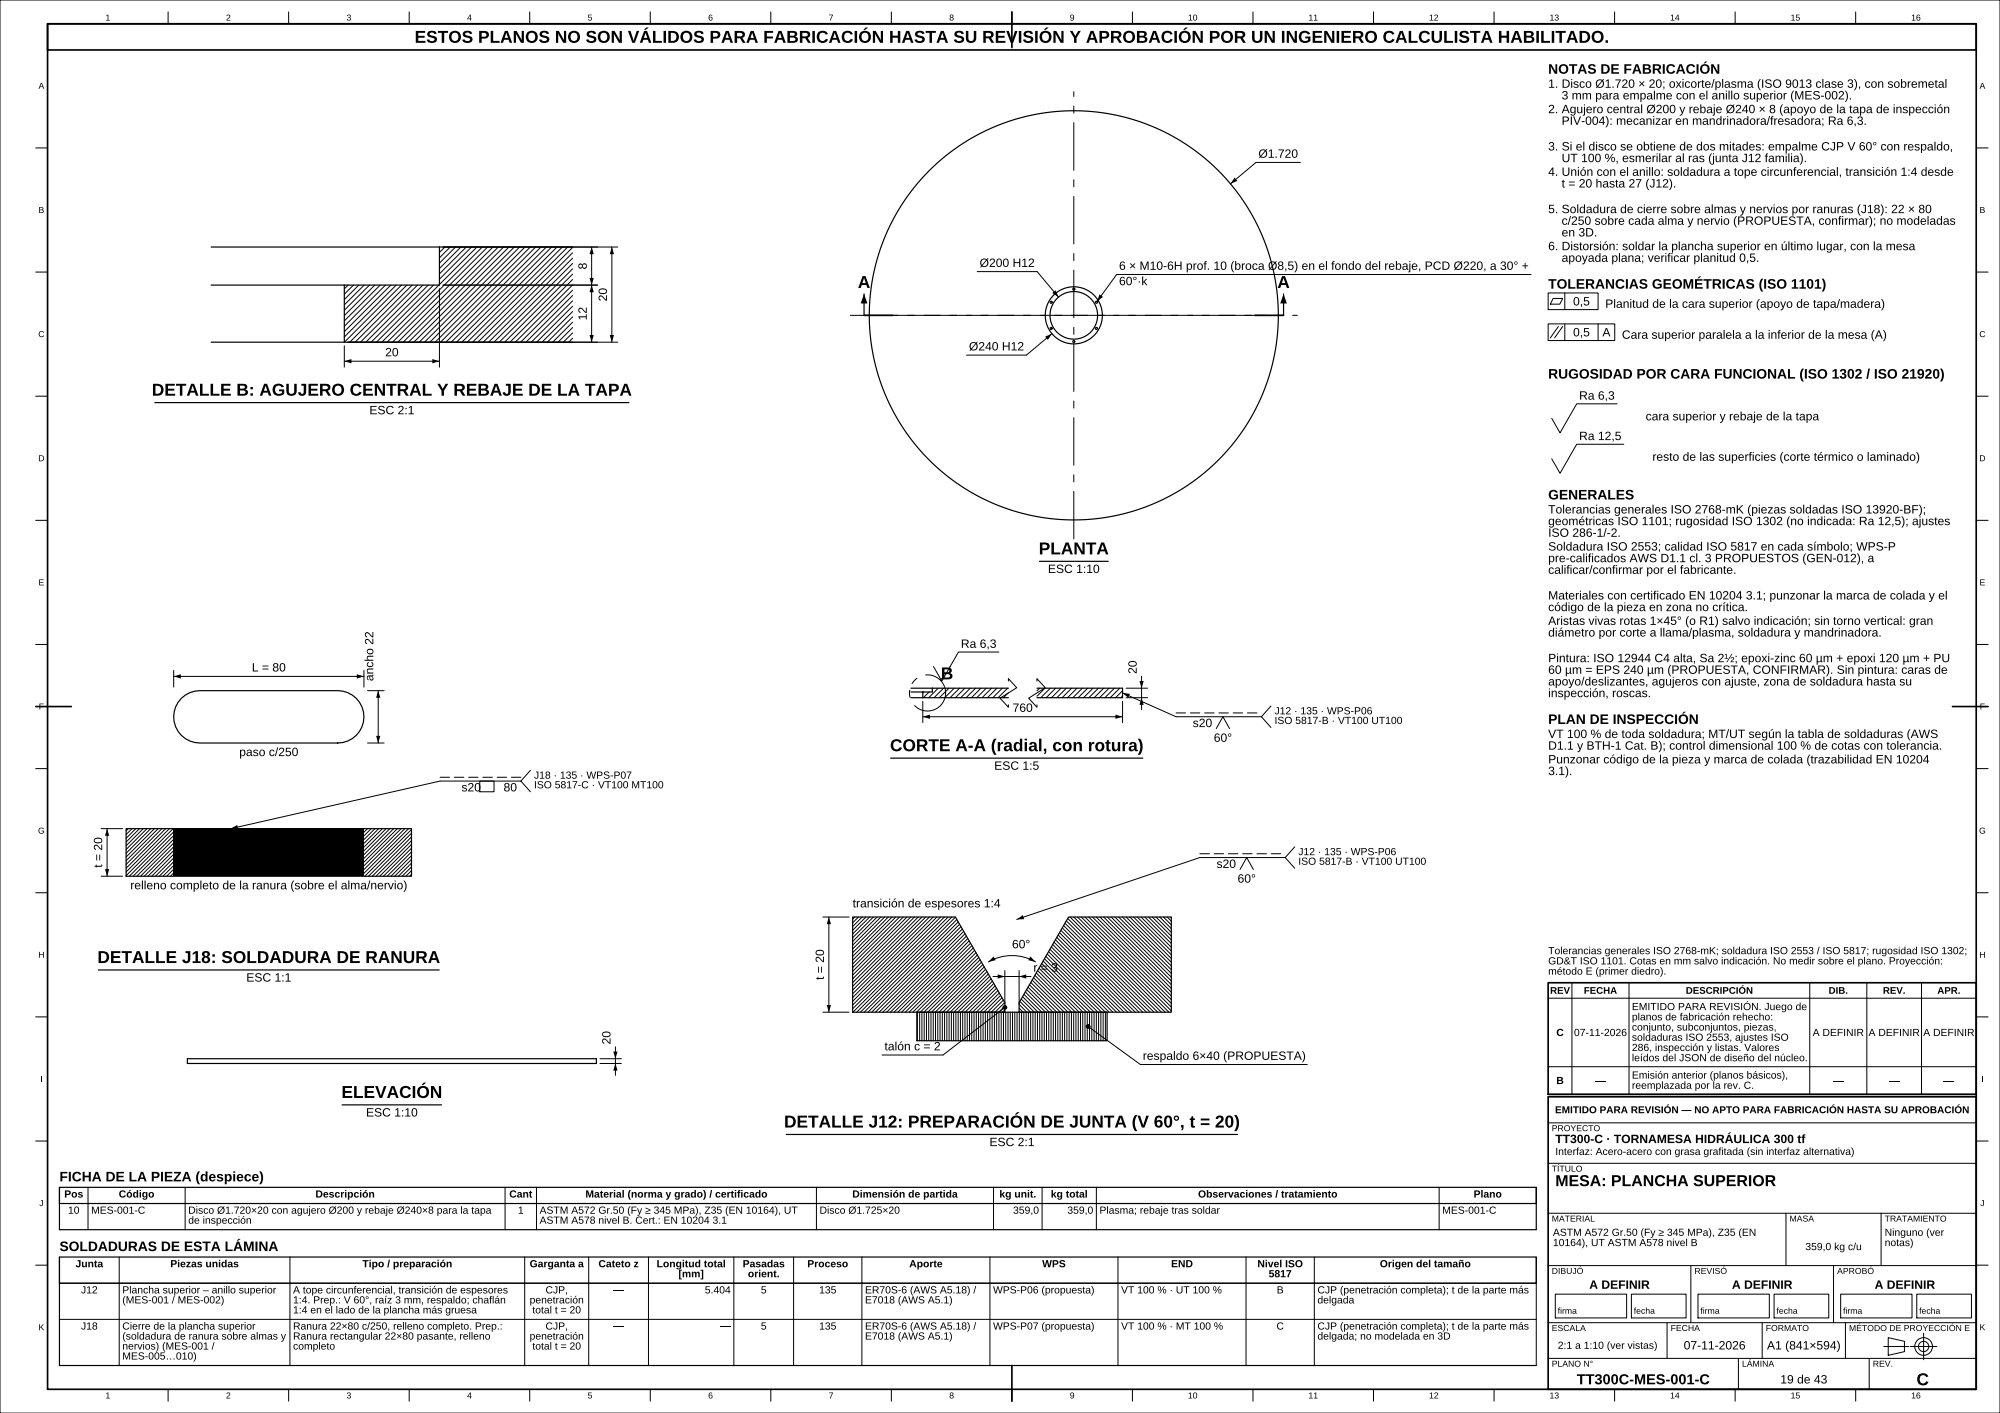
[picture p99: page 1]
