mafiucivil/Tornamesa/entregables/RevC/planos/TT300C-MES-002-C.pdf

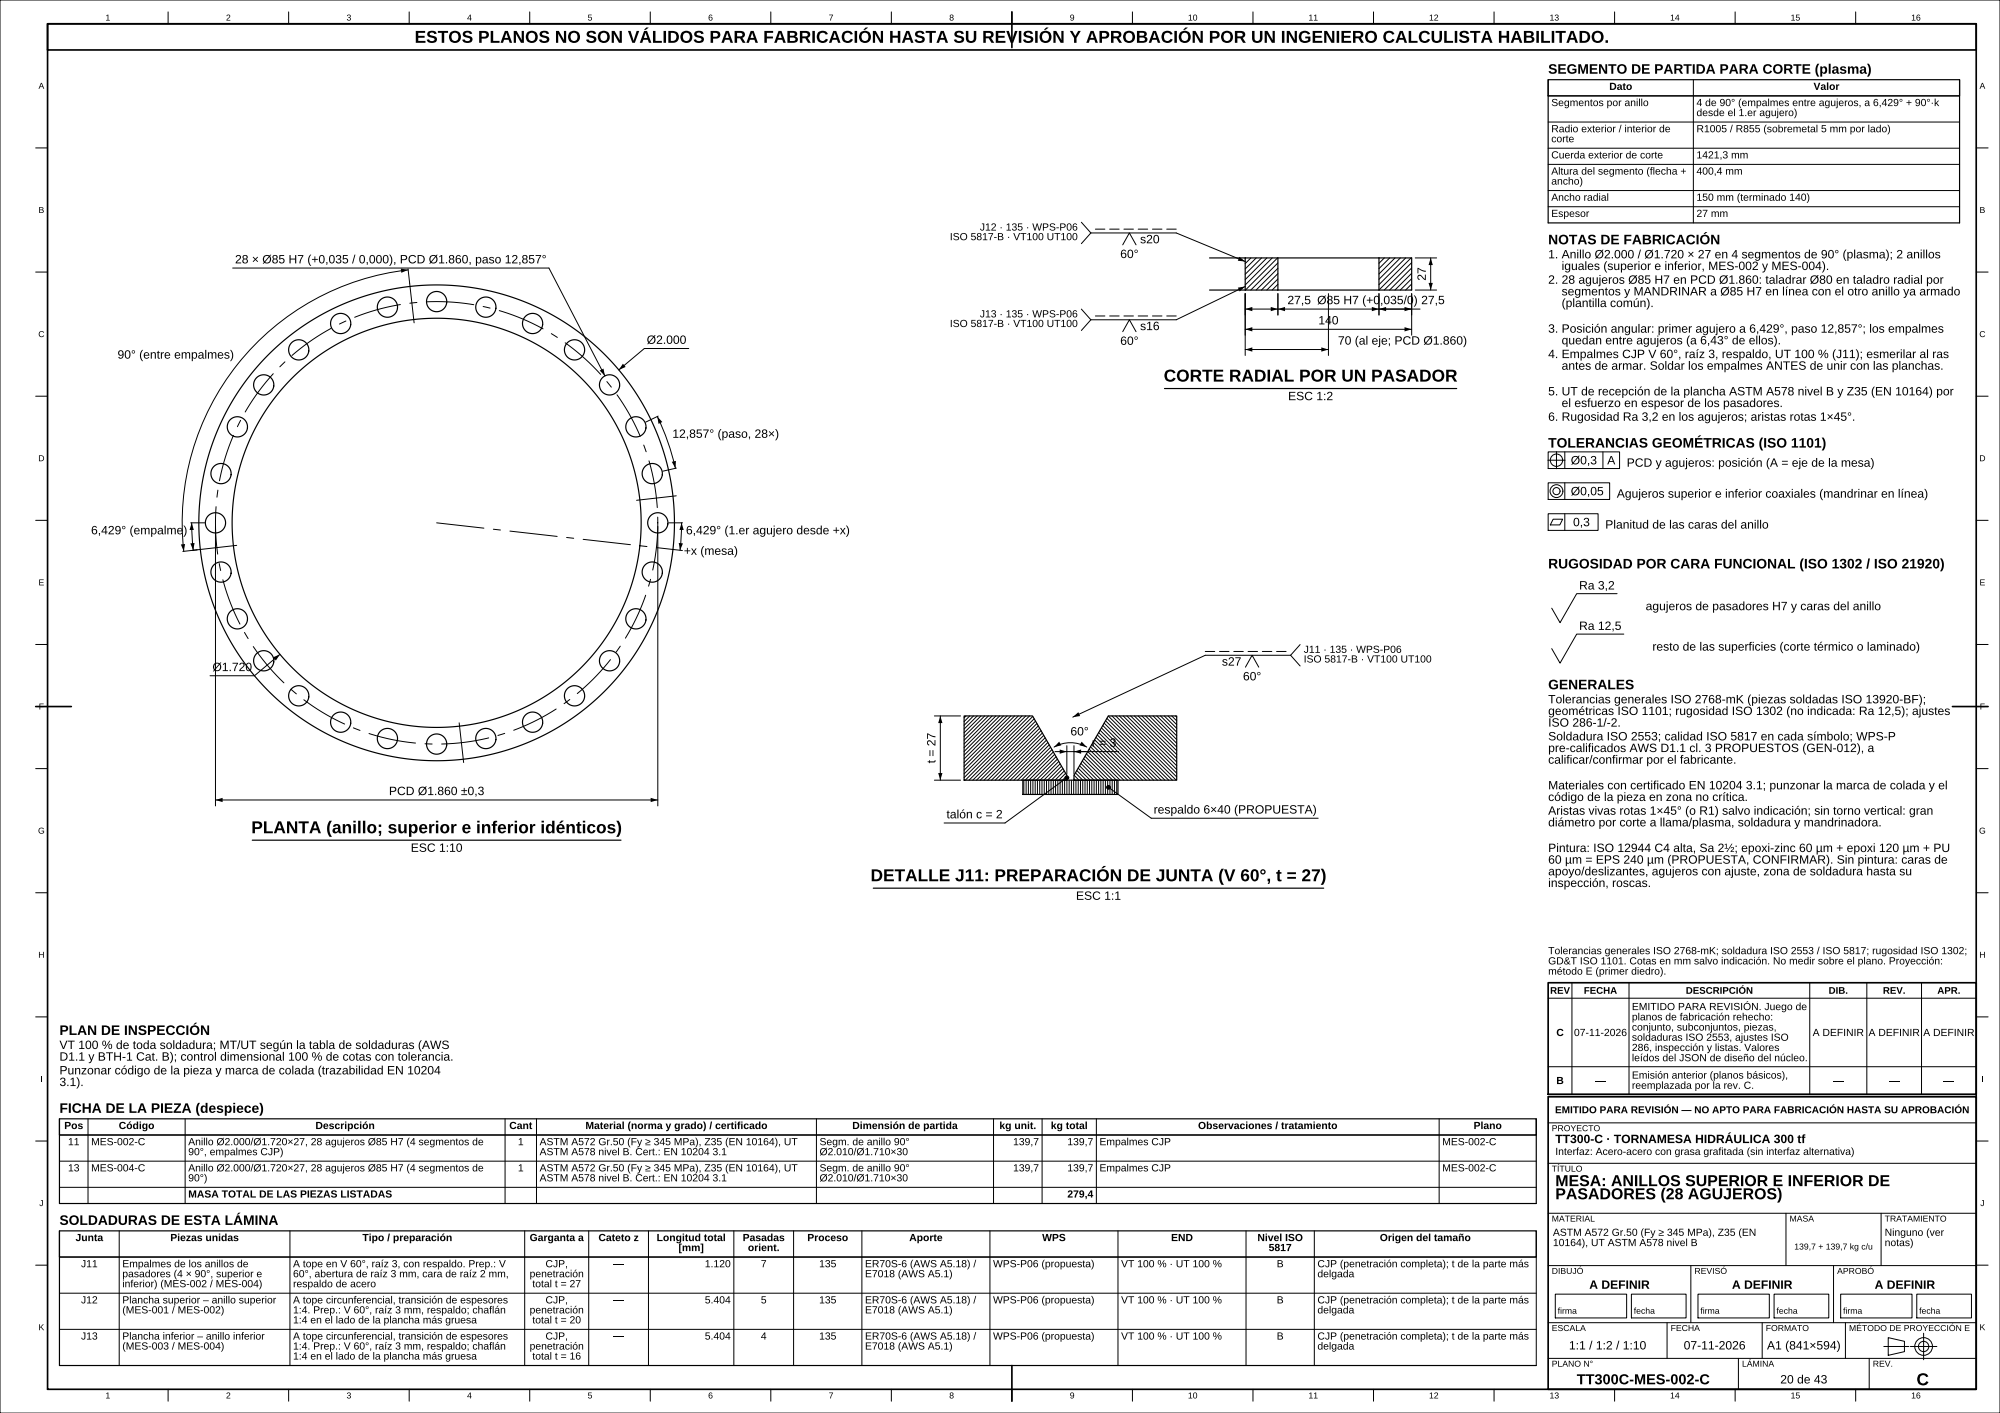
[picture p100: page 1]
