mafiucivil/Tornamesa/entregables/RevC/planos/TT300C-MES-003-C.pdf

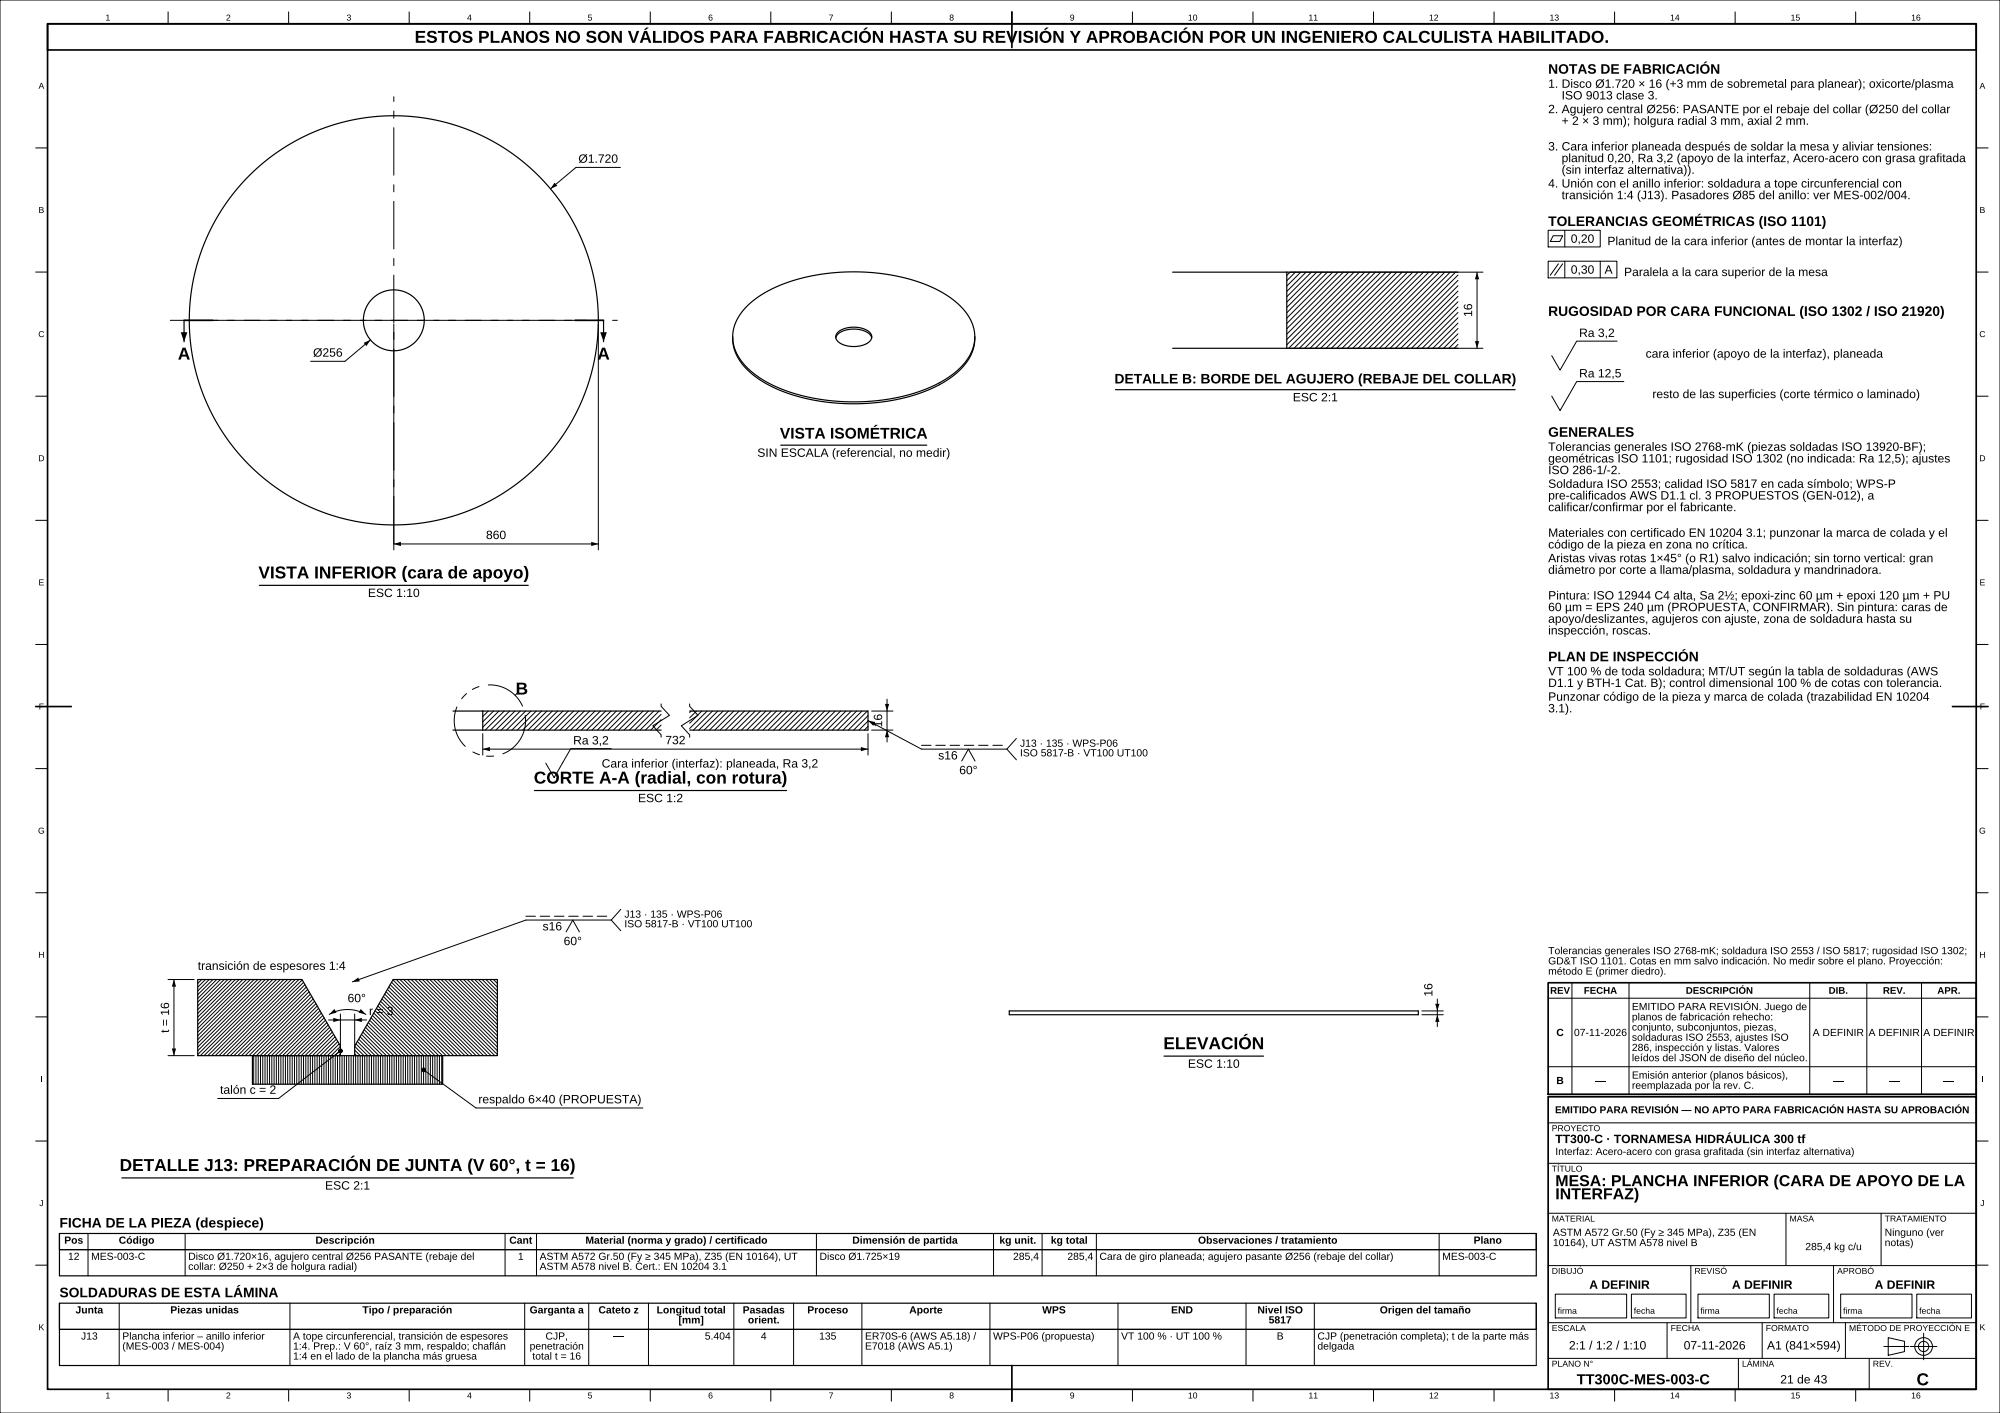
[picture p101: page 1]
