mafiucivil/Tornamesa/entregables/RevC/planos/TT300C-MES-005-C.pdf

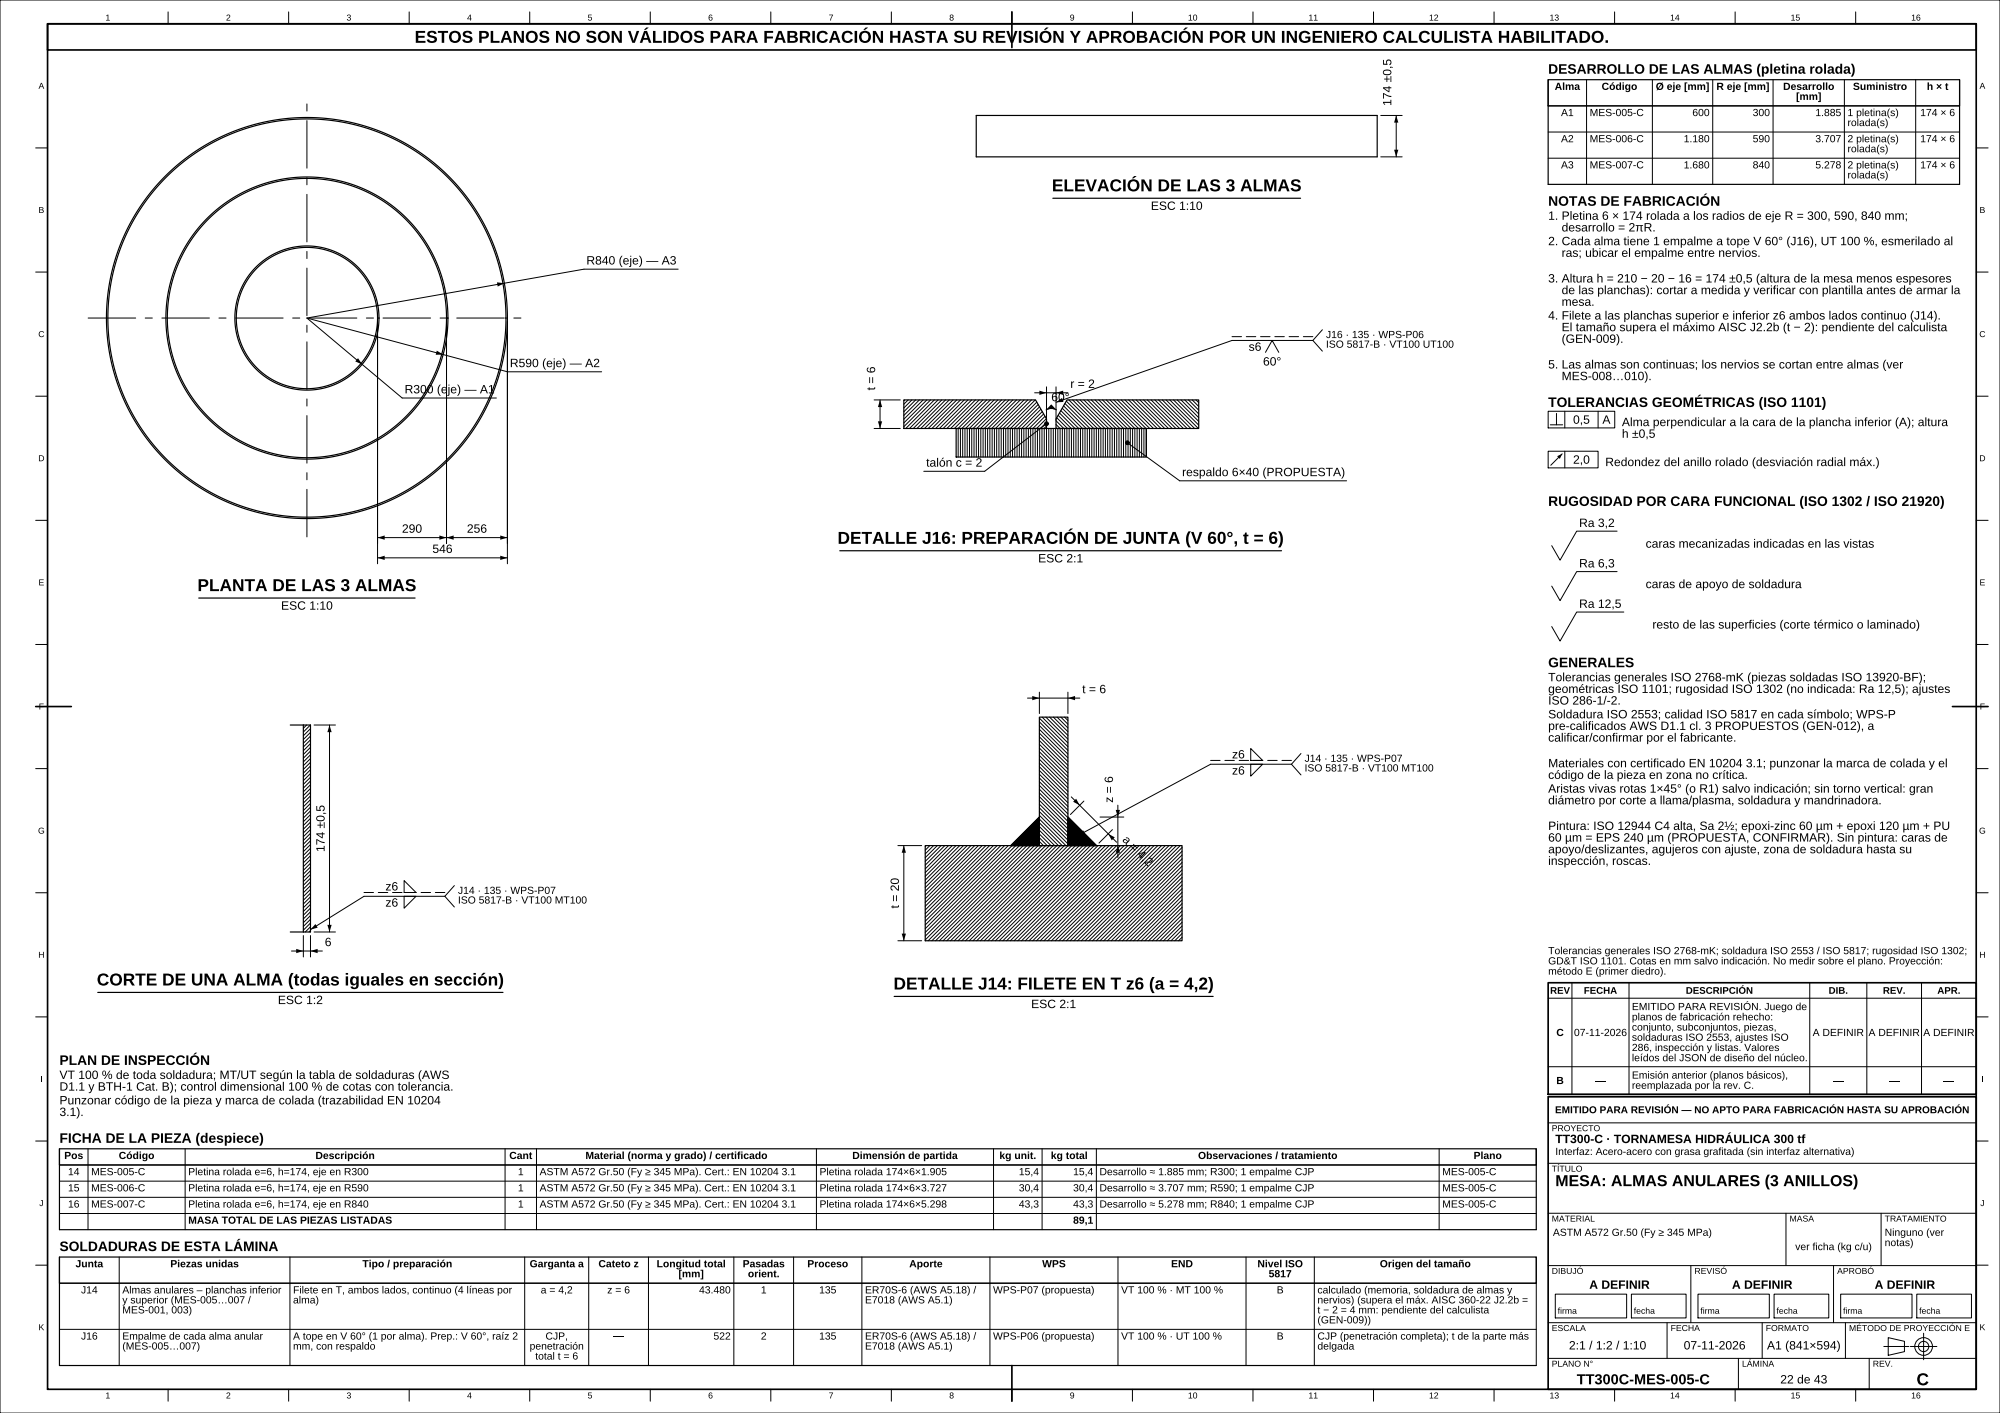
[picture p102: page 1]
