mafiucivil/Tornamesa/entregables/RevC/planos/TT300C-MES-008-C.pdf

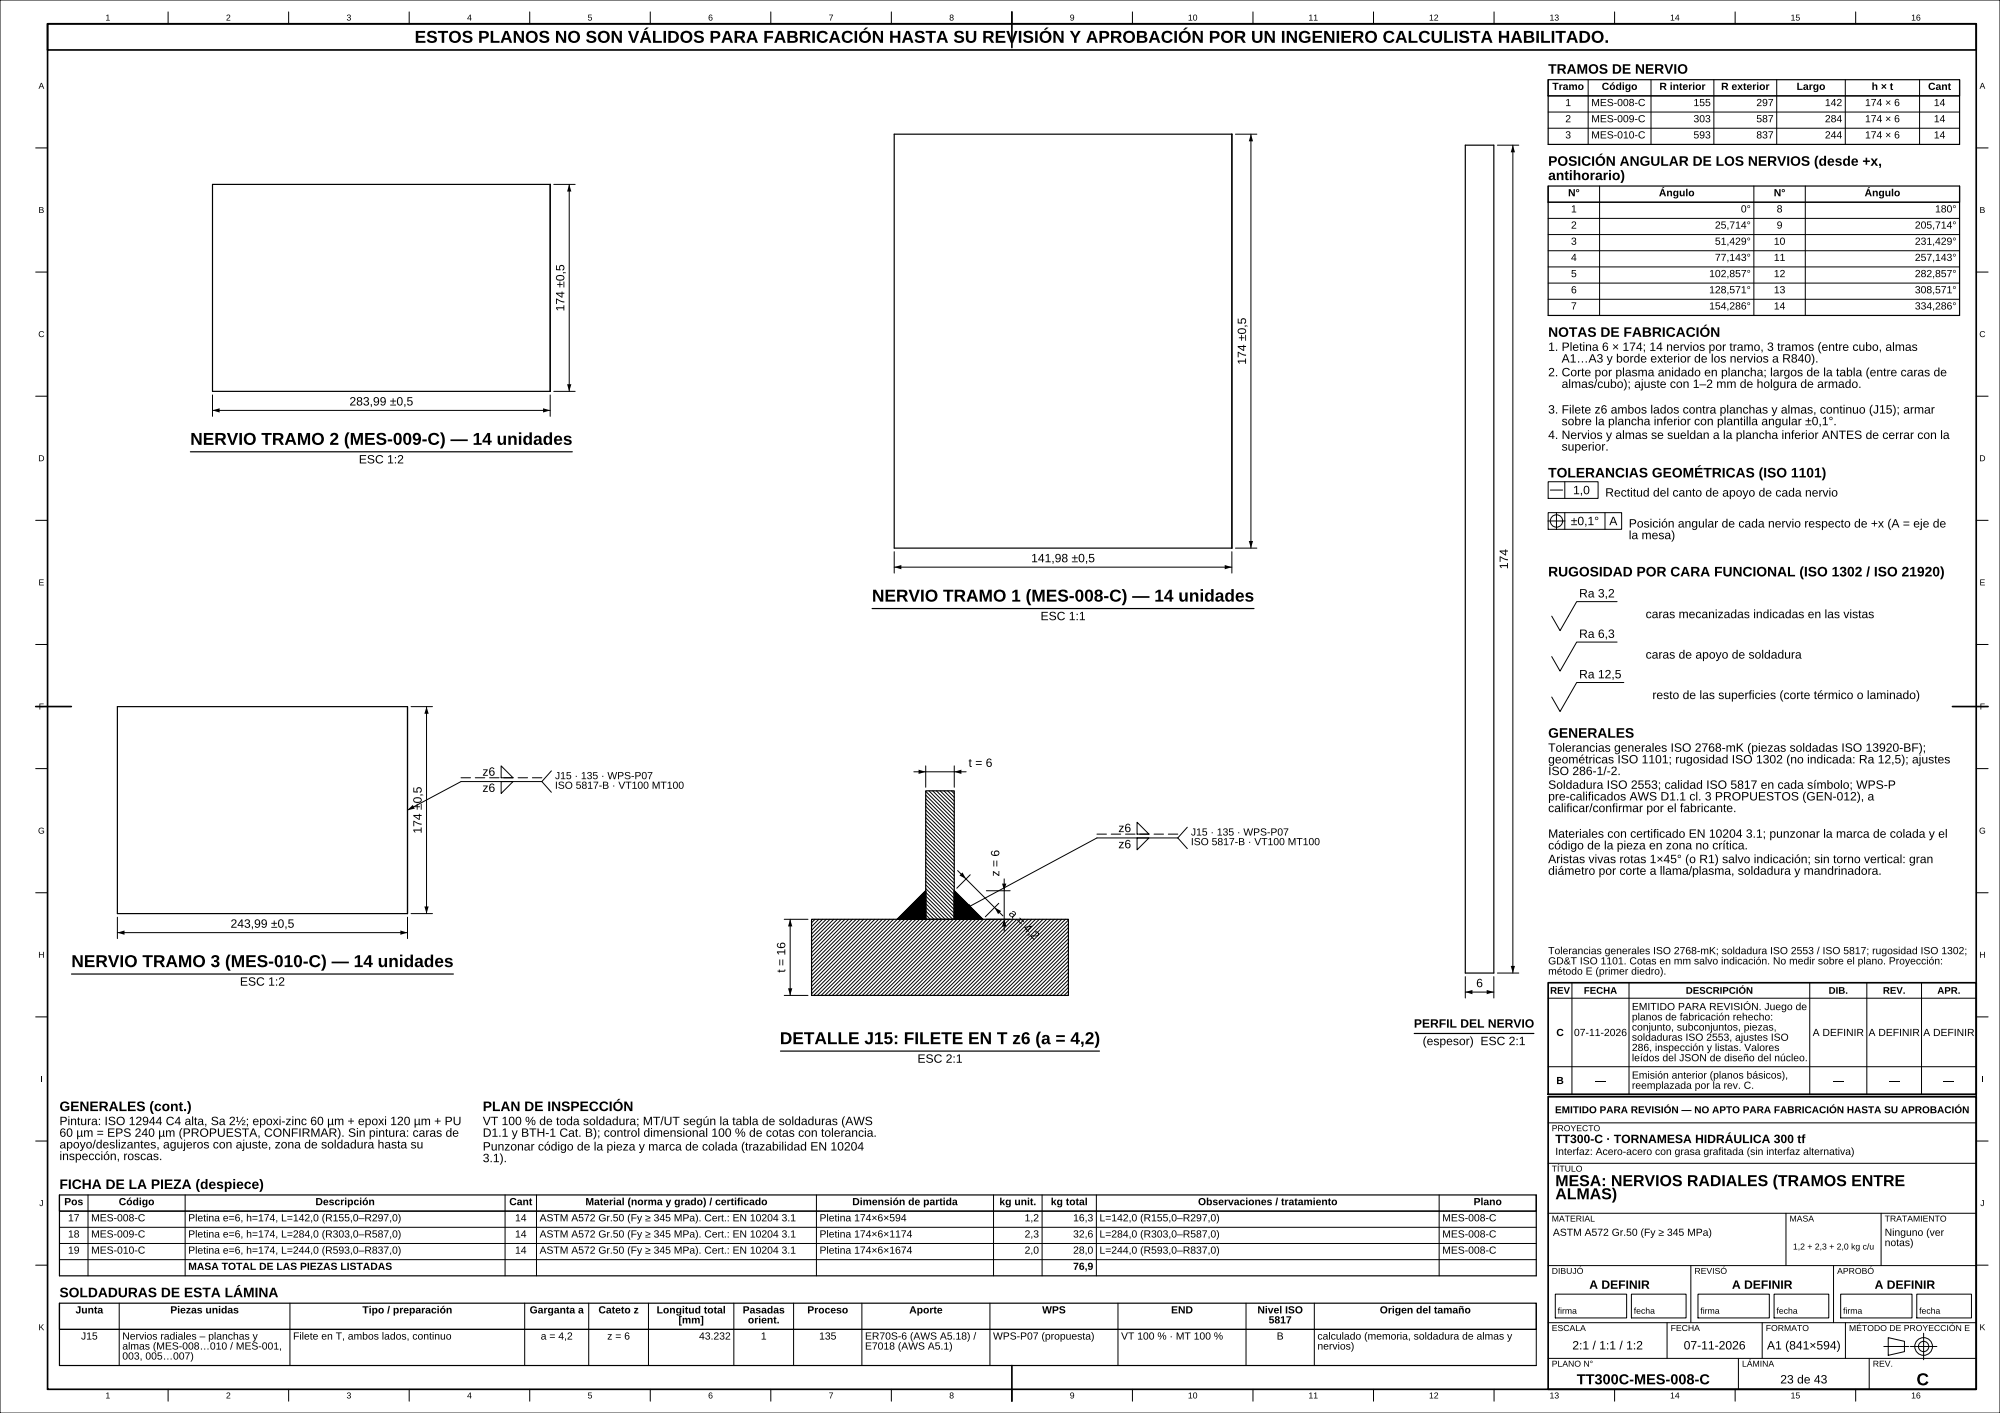
[picture p103: page 1]
