mafiucivil/Tornamesa/entregables/RevC/planos/TT300C-MES-011-C.pdf

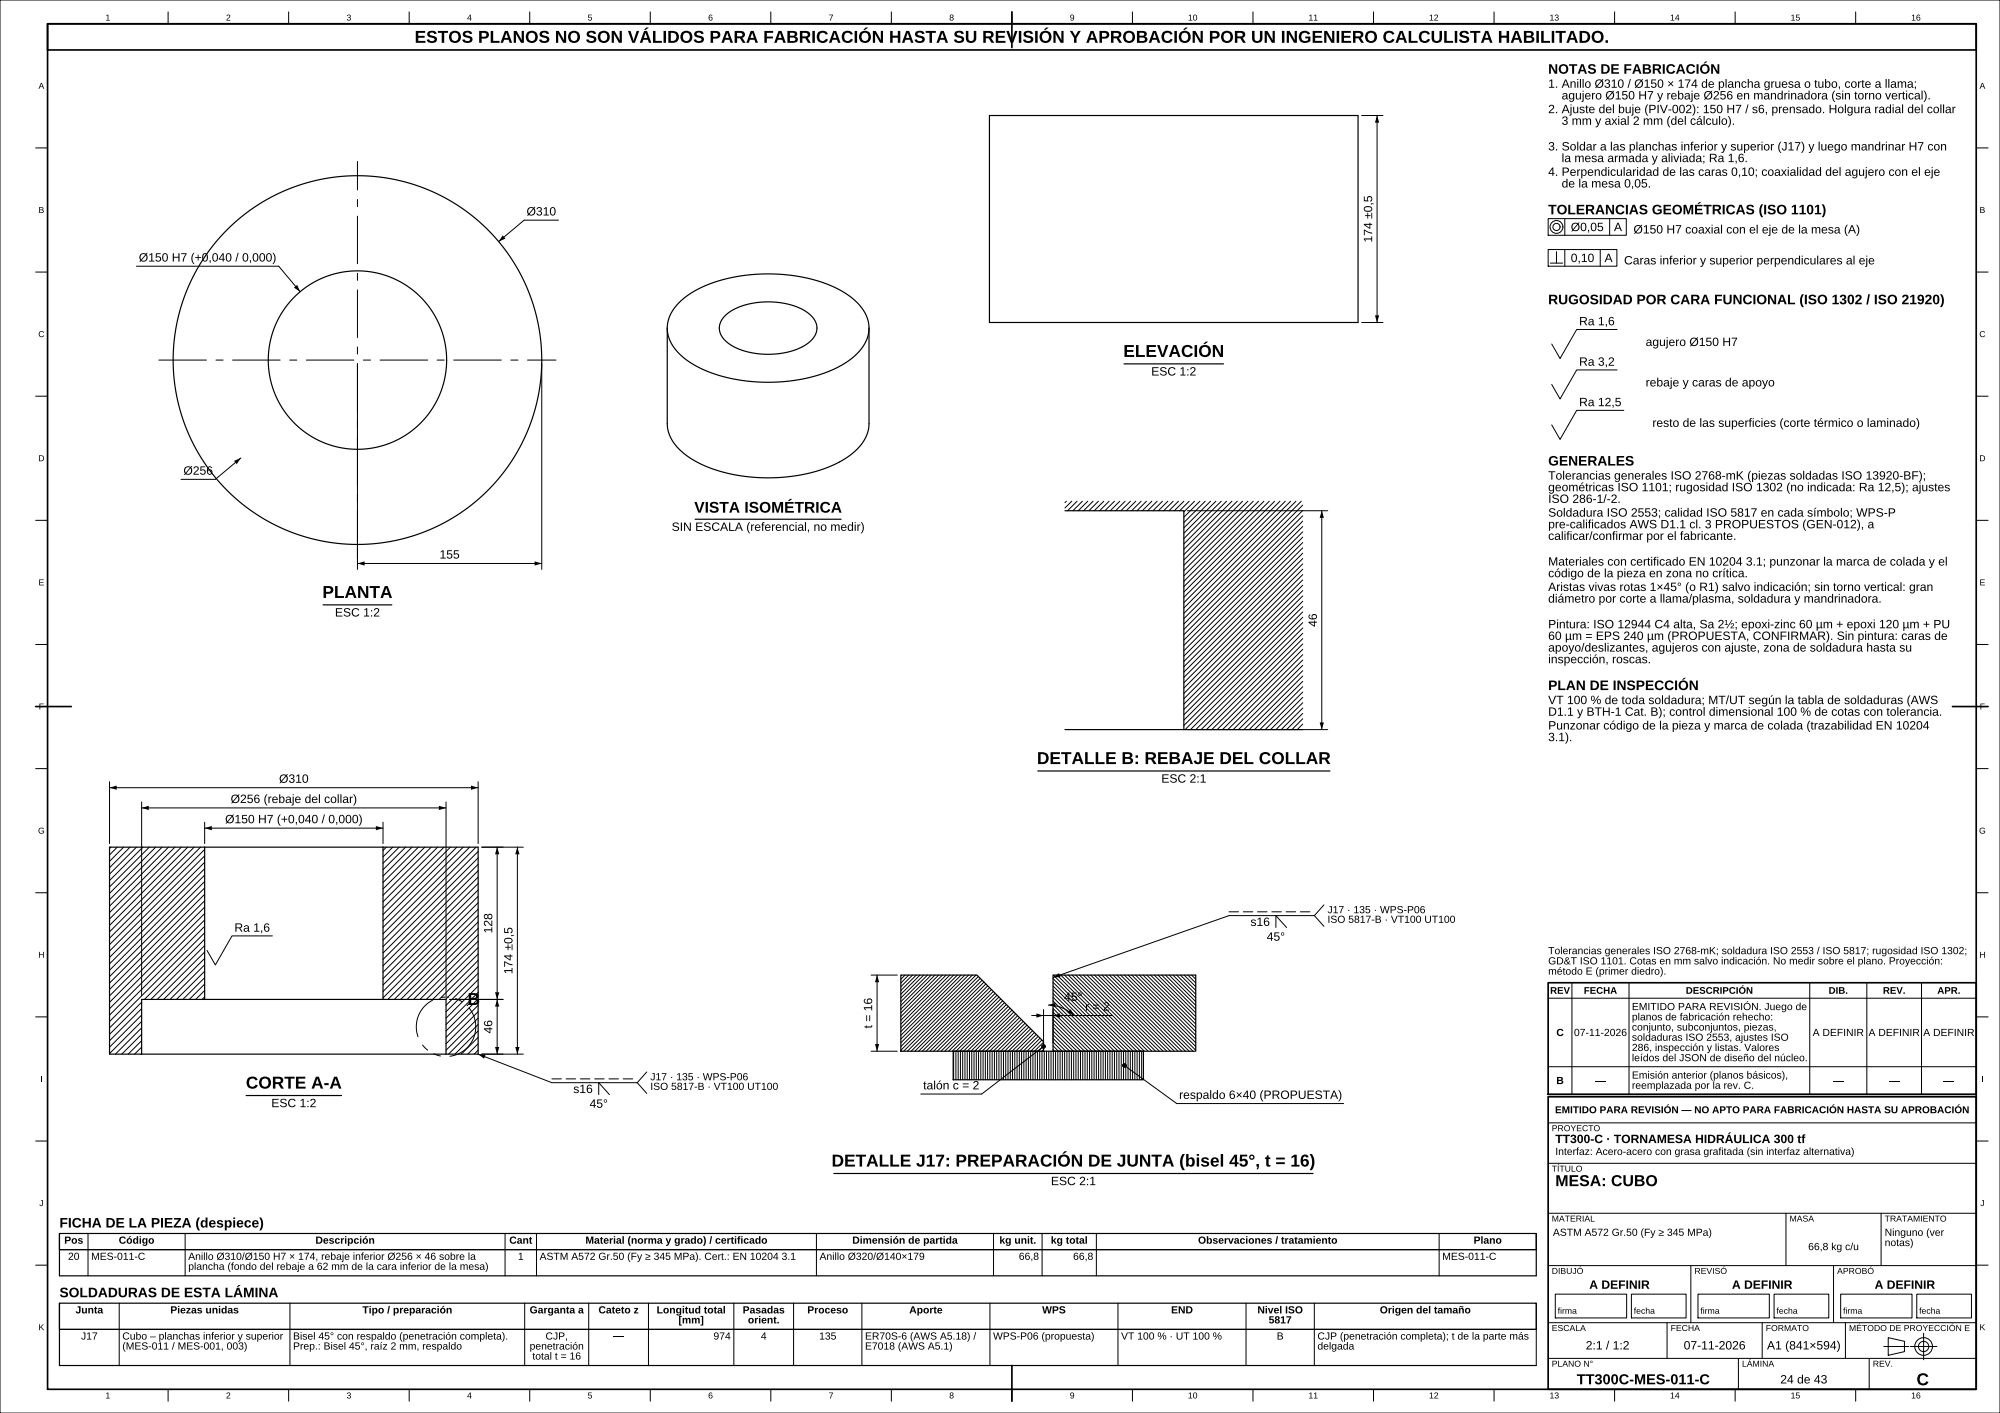
[picture p104: page 1]
