mafiucivil/Tornamesa/entregables/RevC/planos/TT300C-MES-012-C.pdf

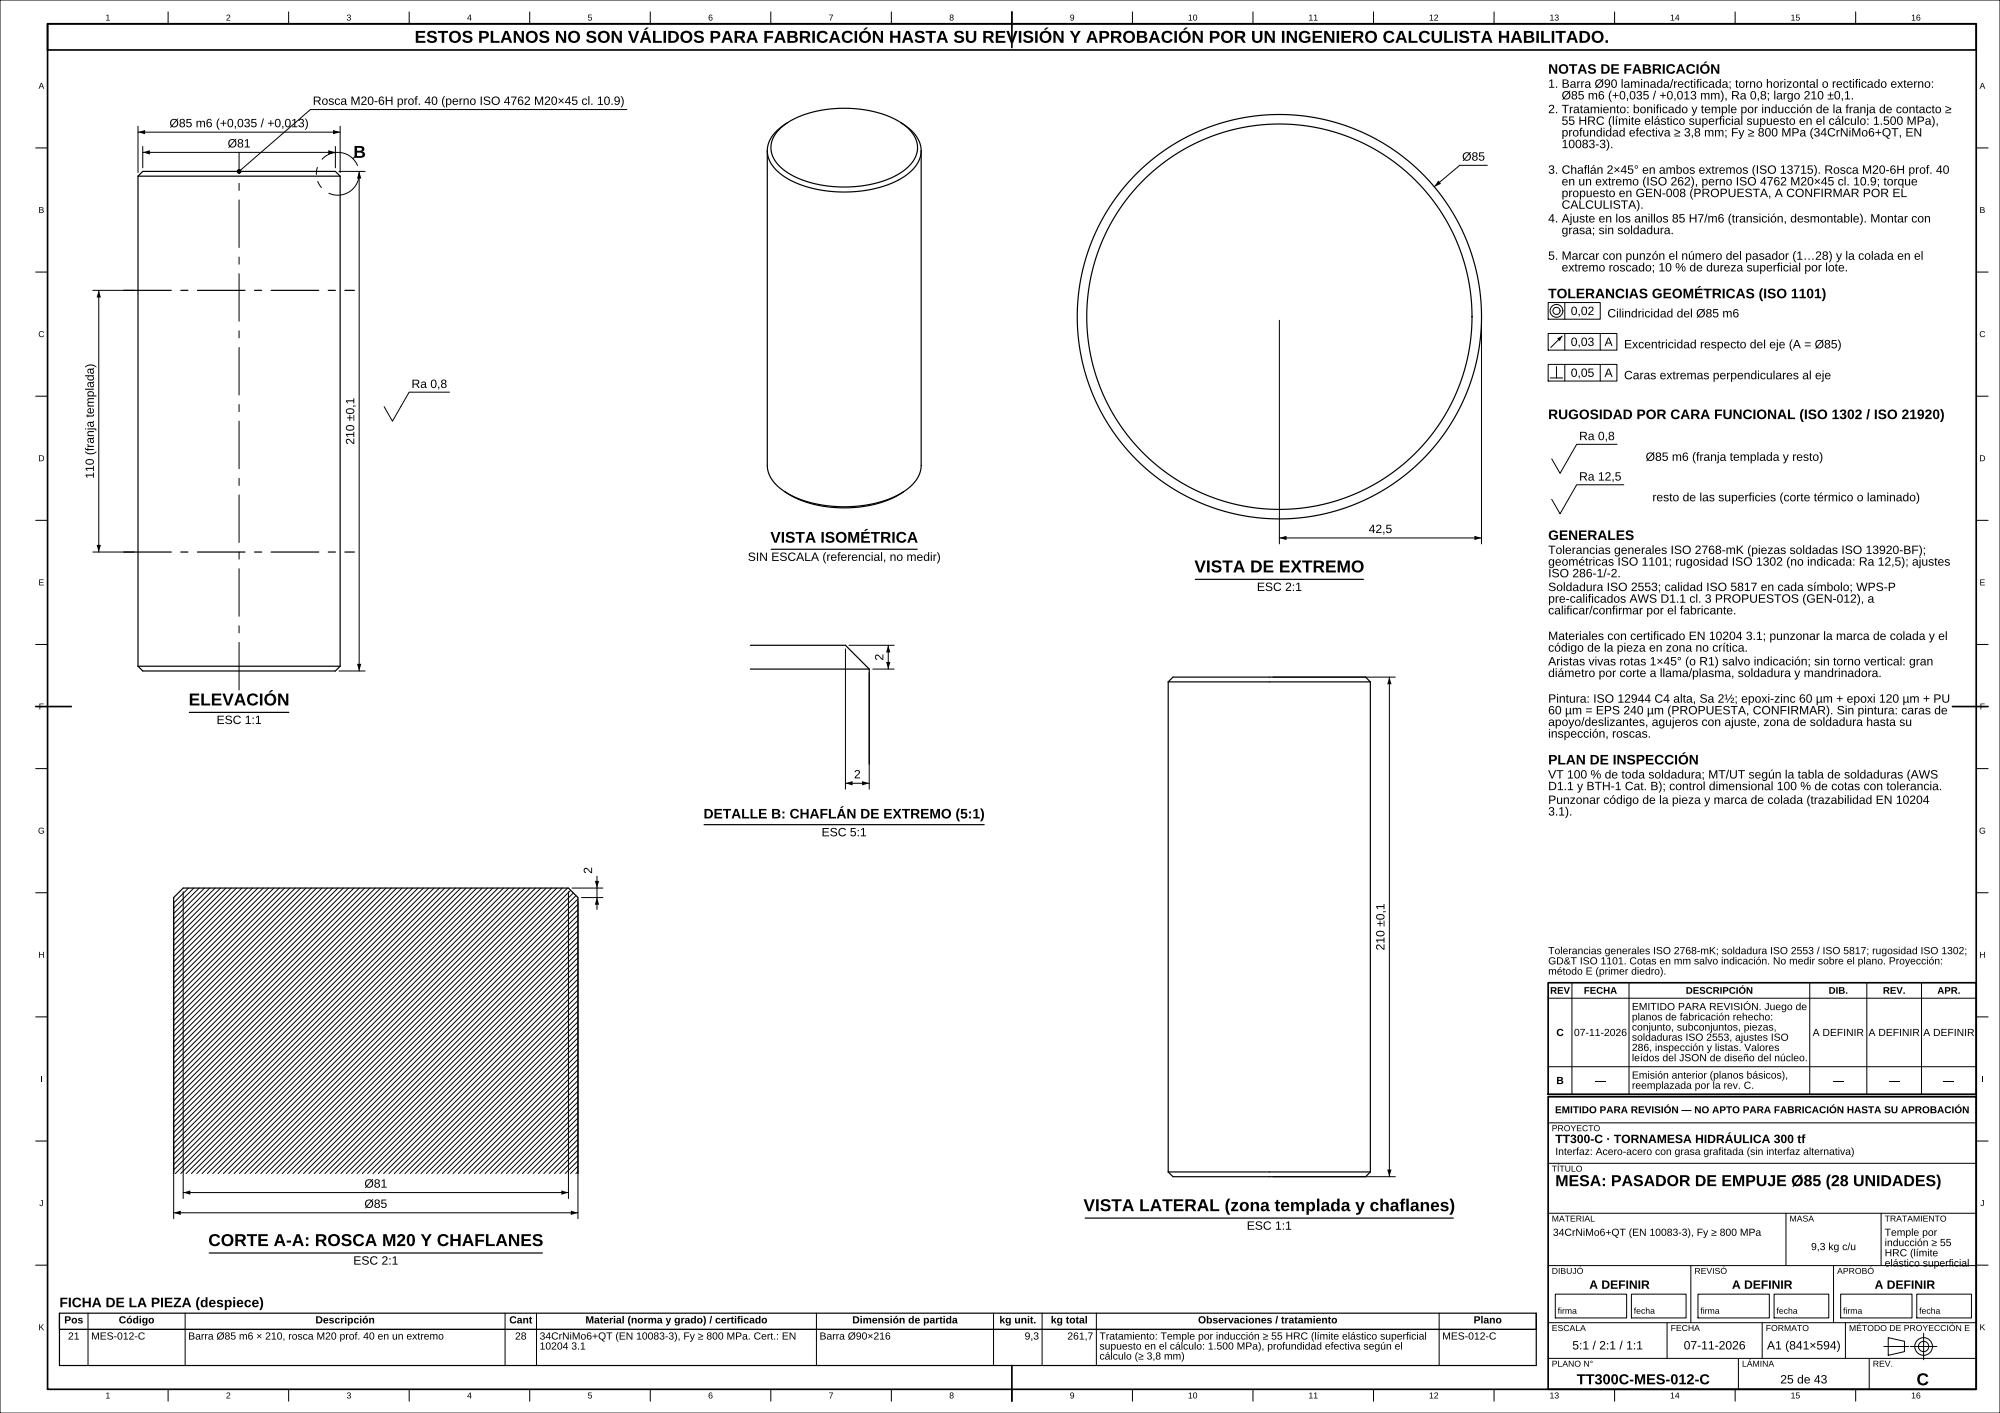
[picture p105: page 1]
