mafiucivil/Tornamesa/entregables/RevC/planos/TT300C-MES-013-C.pdf

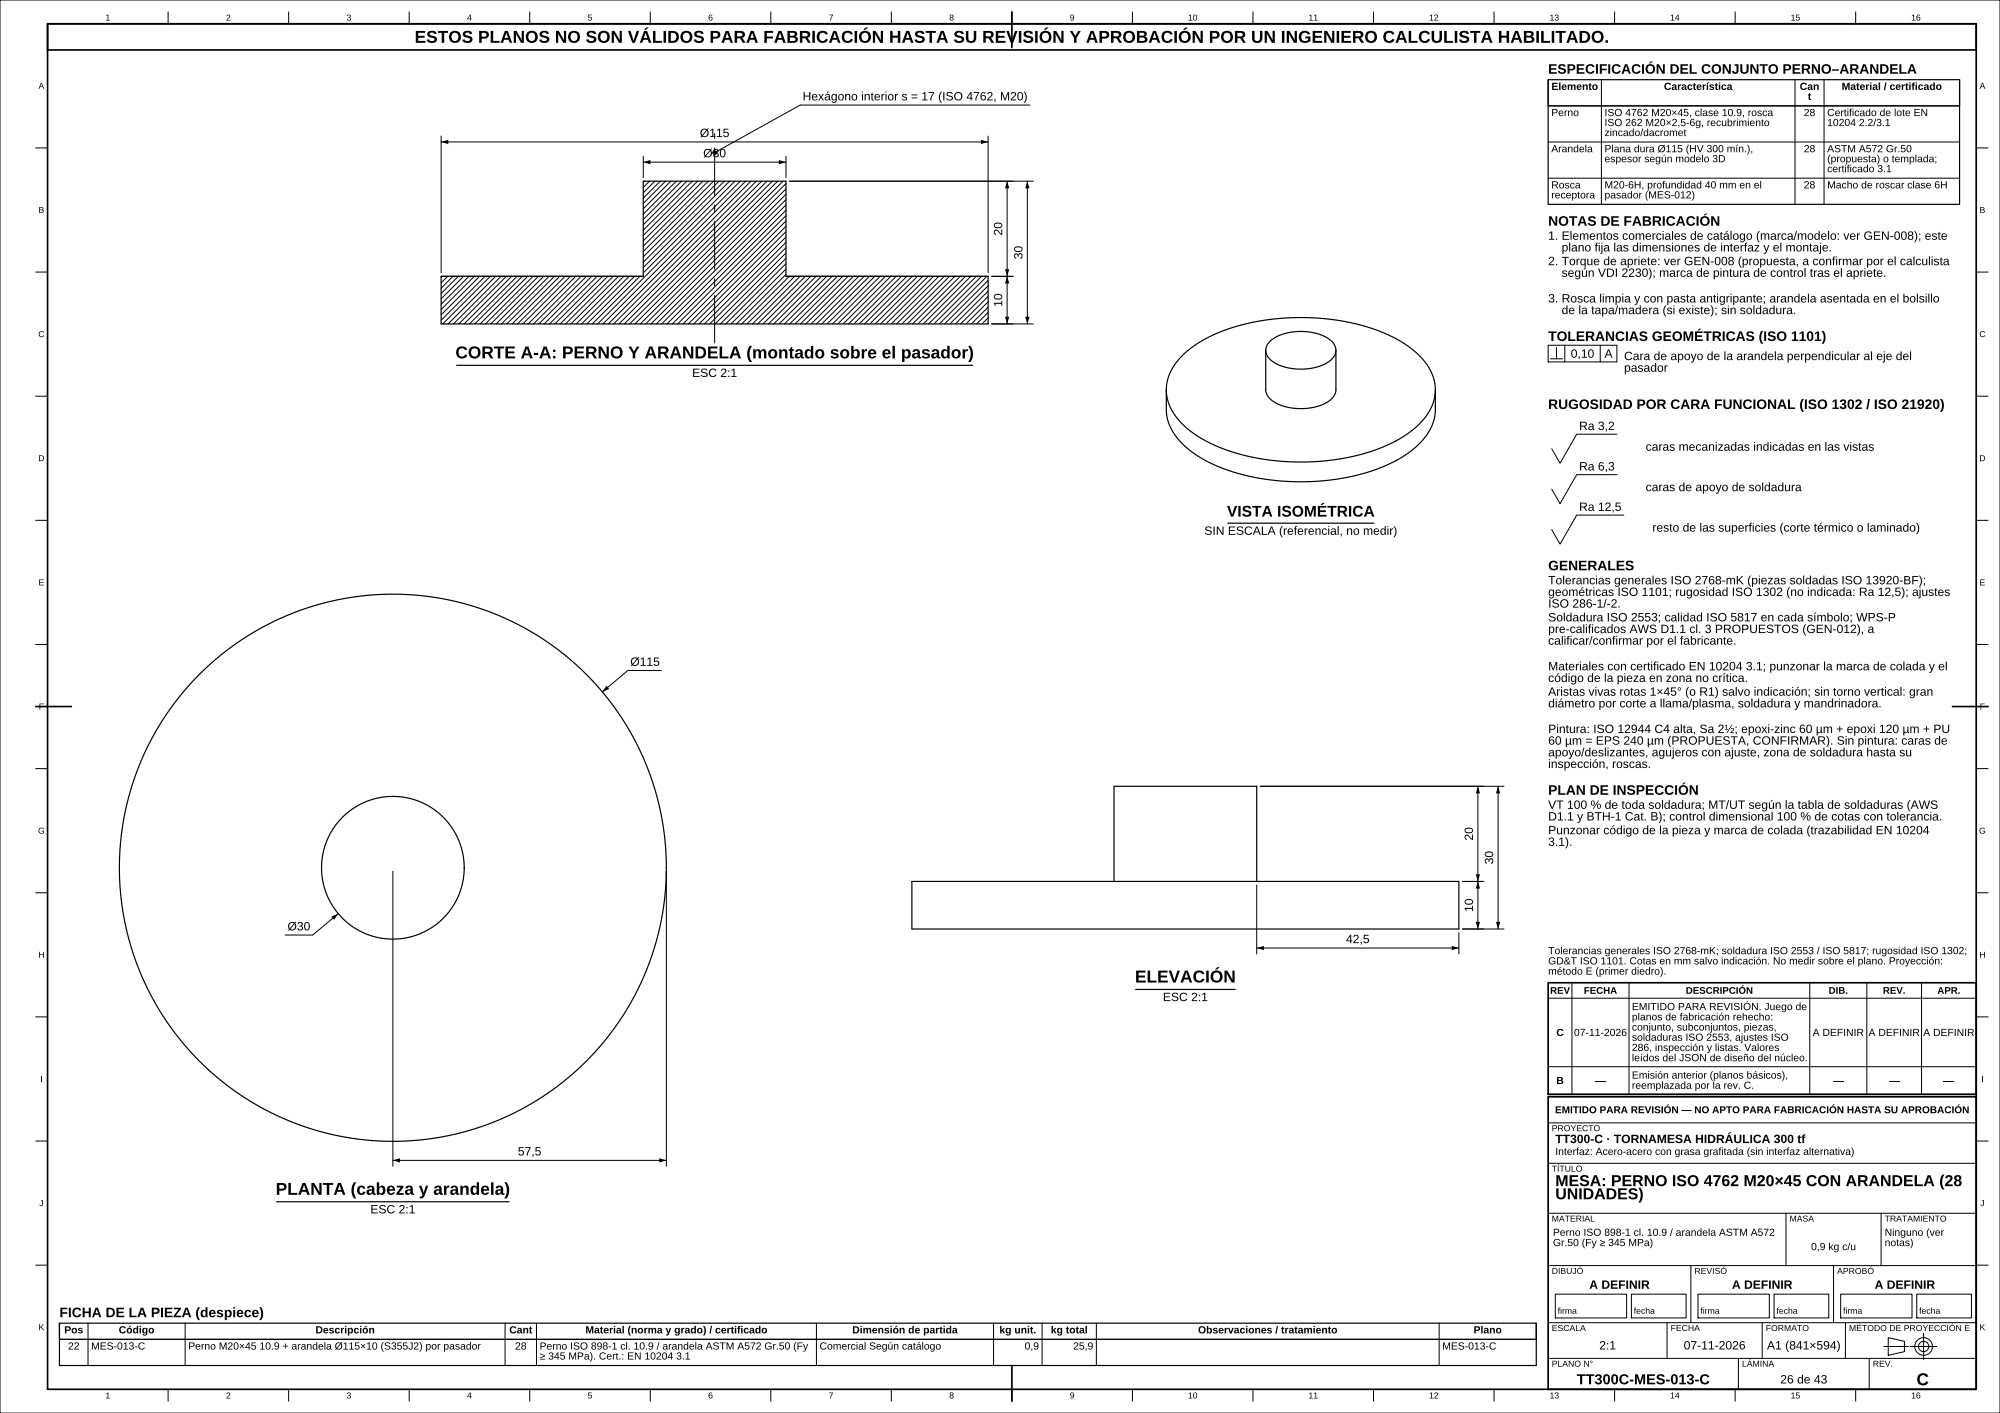
[picture p106: page 1]
