mafiucivil/Tornamesa/entregables/RevC/planos/TT300C-PIV-001-C.pdf

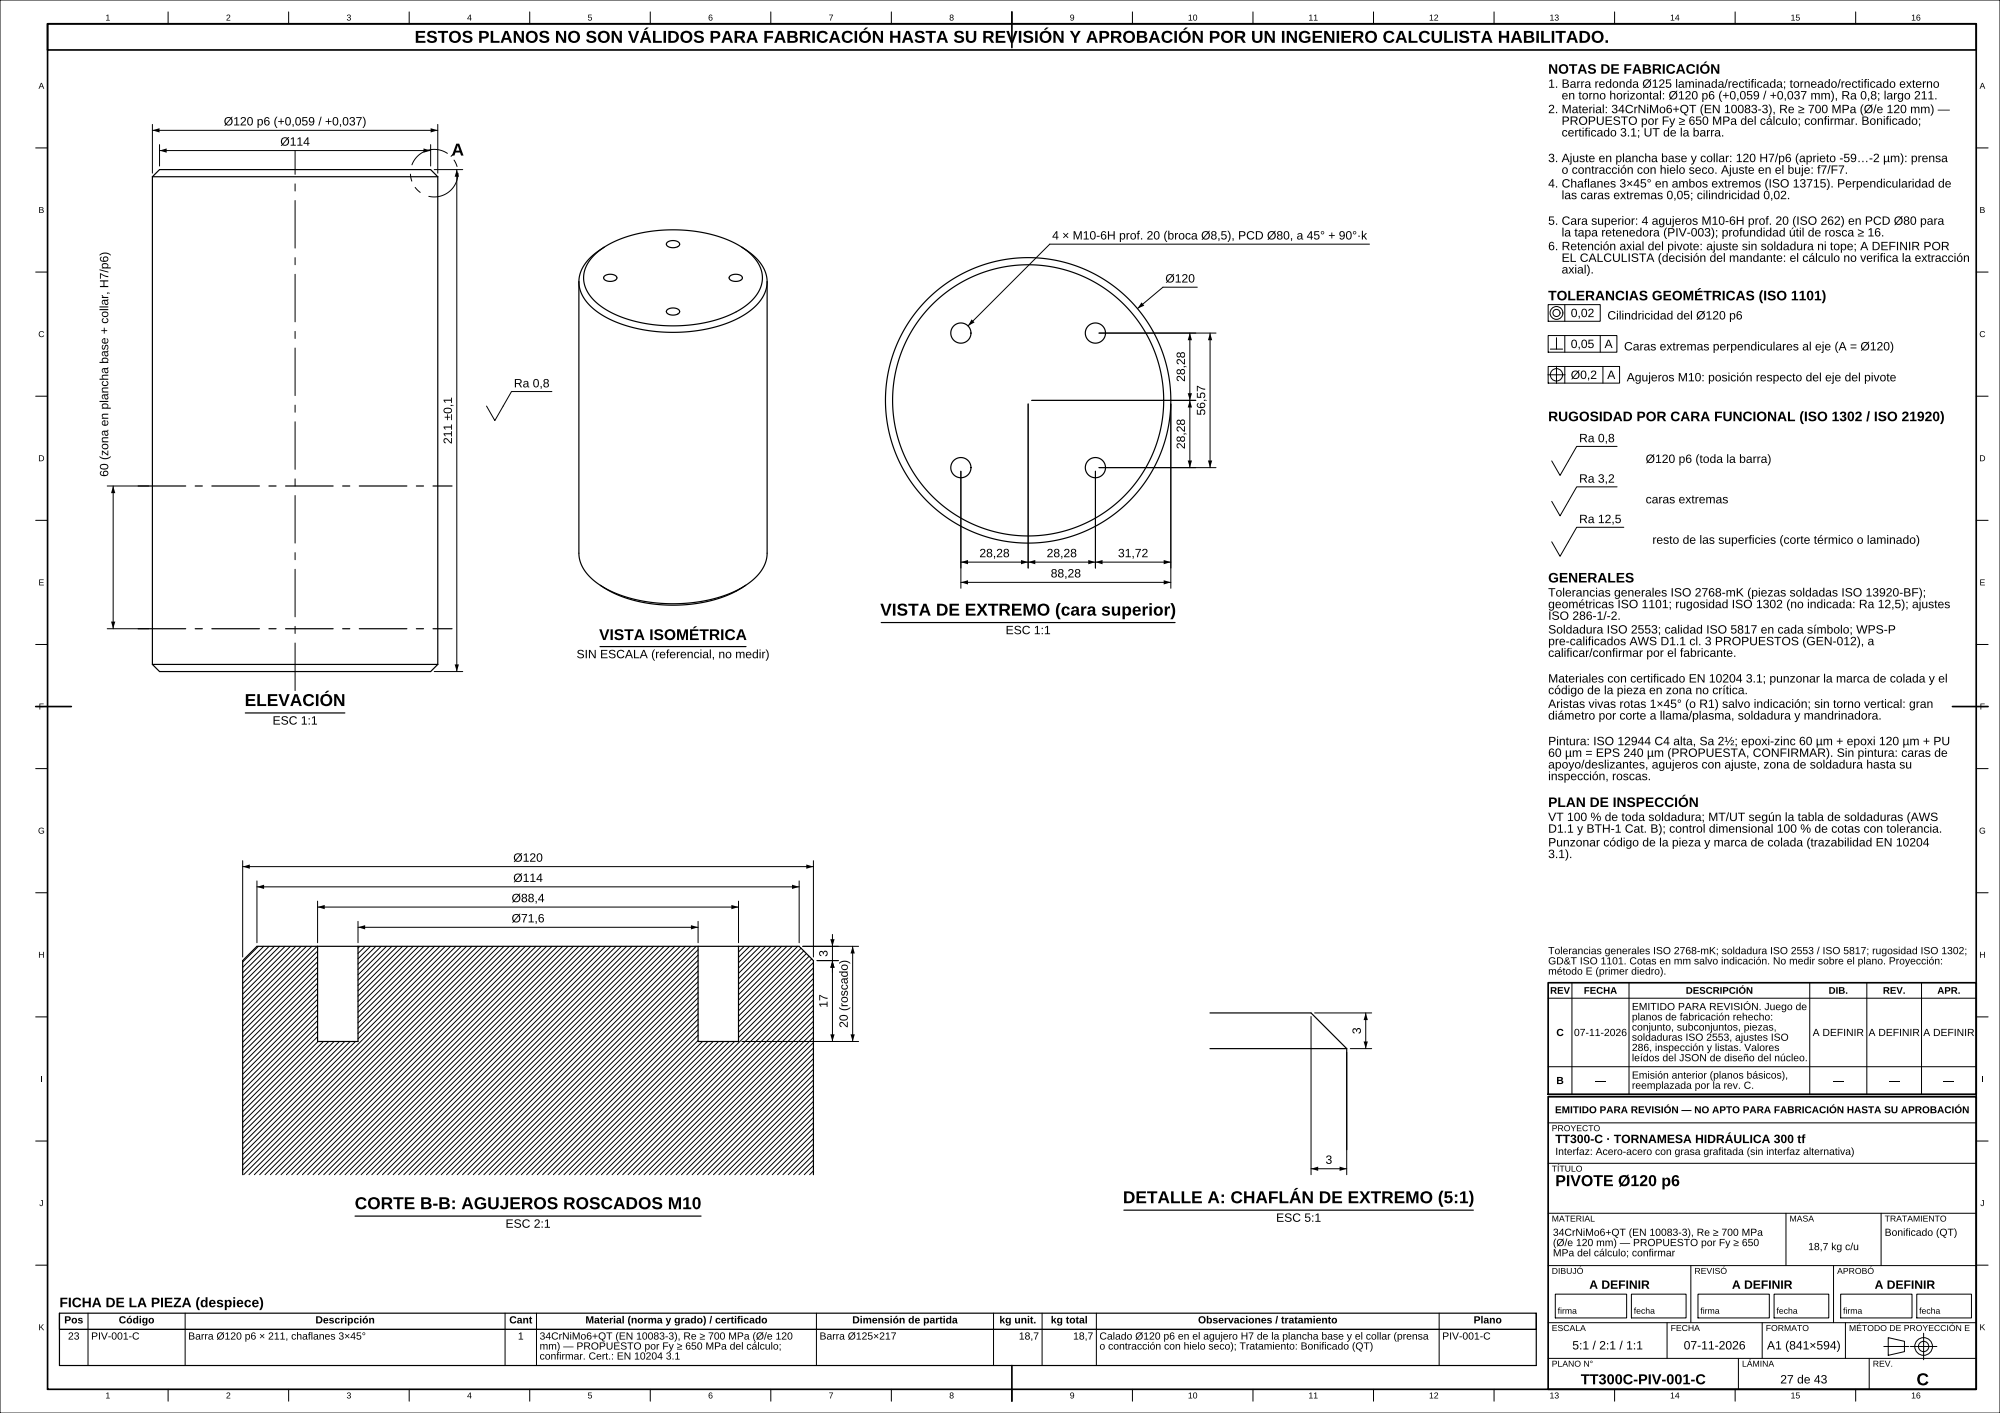
[picture p107: page 1]
