mafiucivil/Tornamesa/entregables/RevC/planos/TT300C-PIV-002-C.pdf

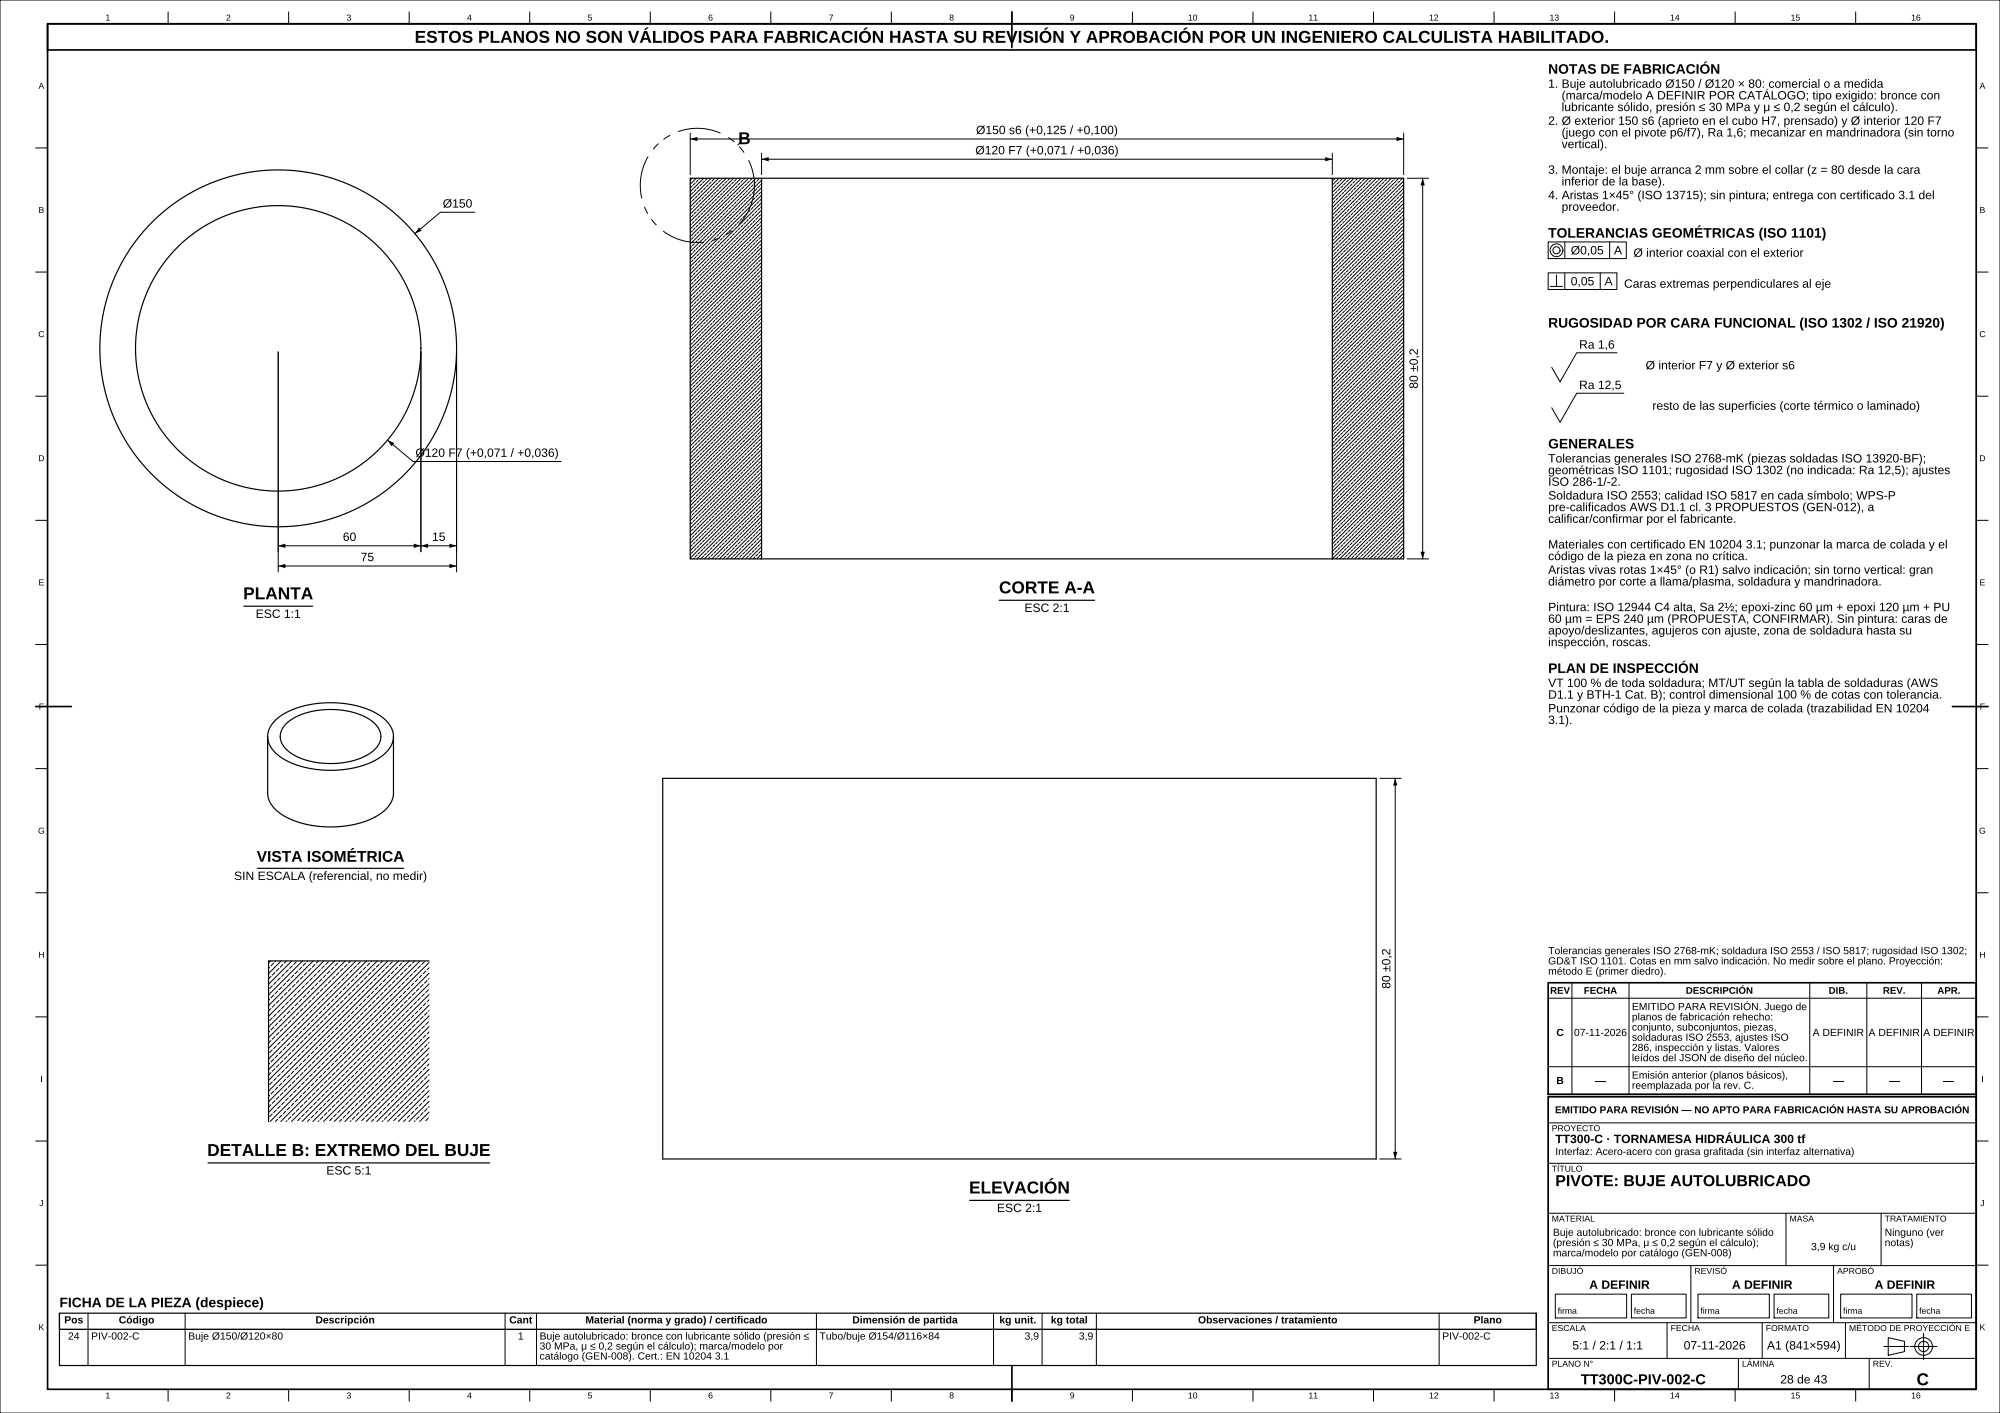
[picture p108: page 1]
