mafiucivil/Tornamesa/entregables/RevC/planos/TT300C-PIV-003-C.pdf

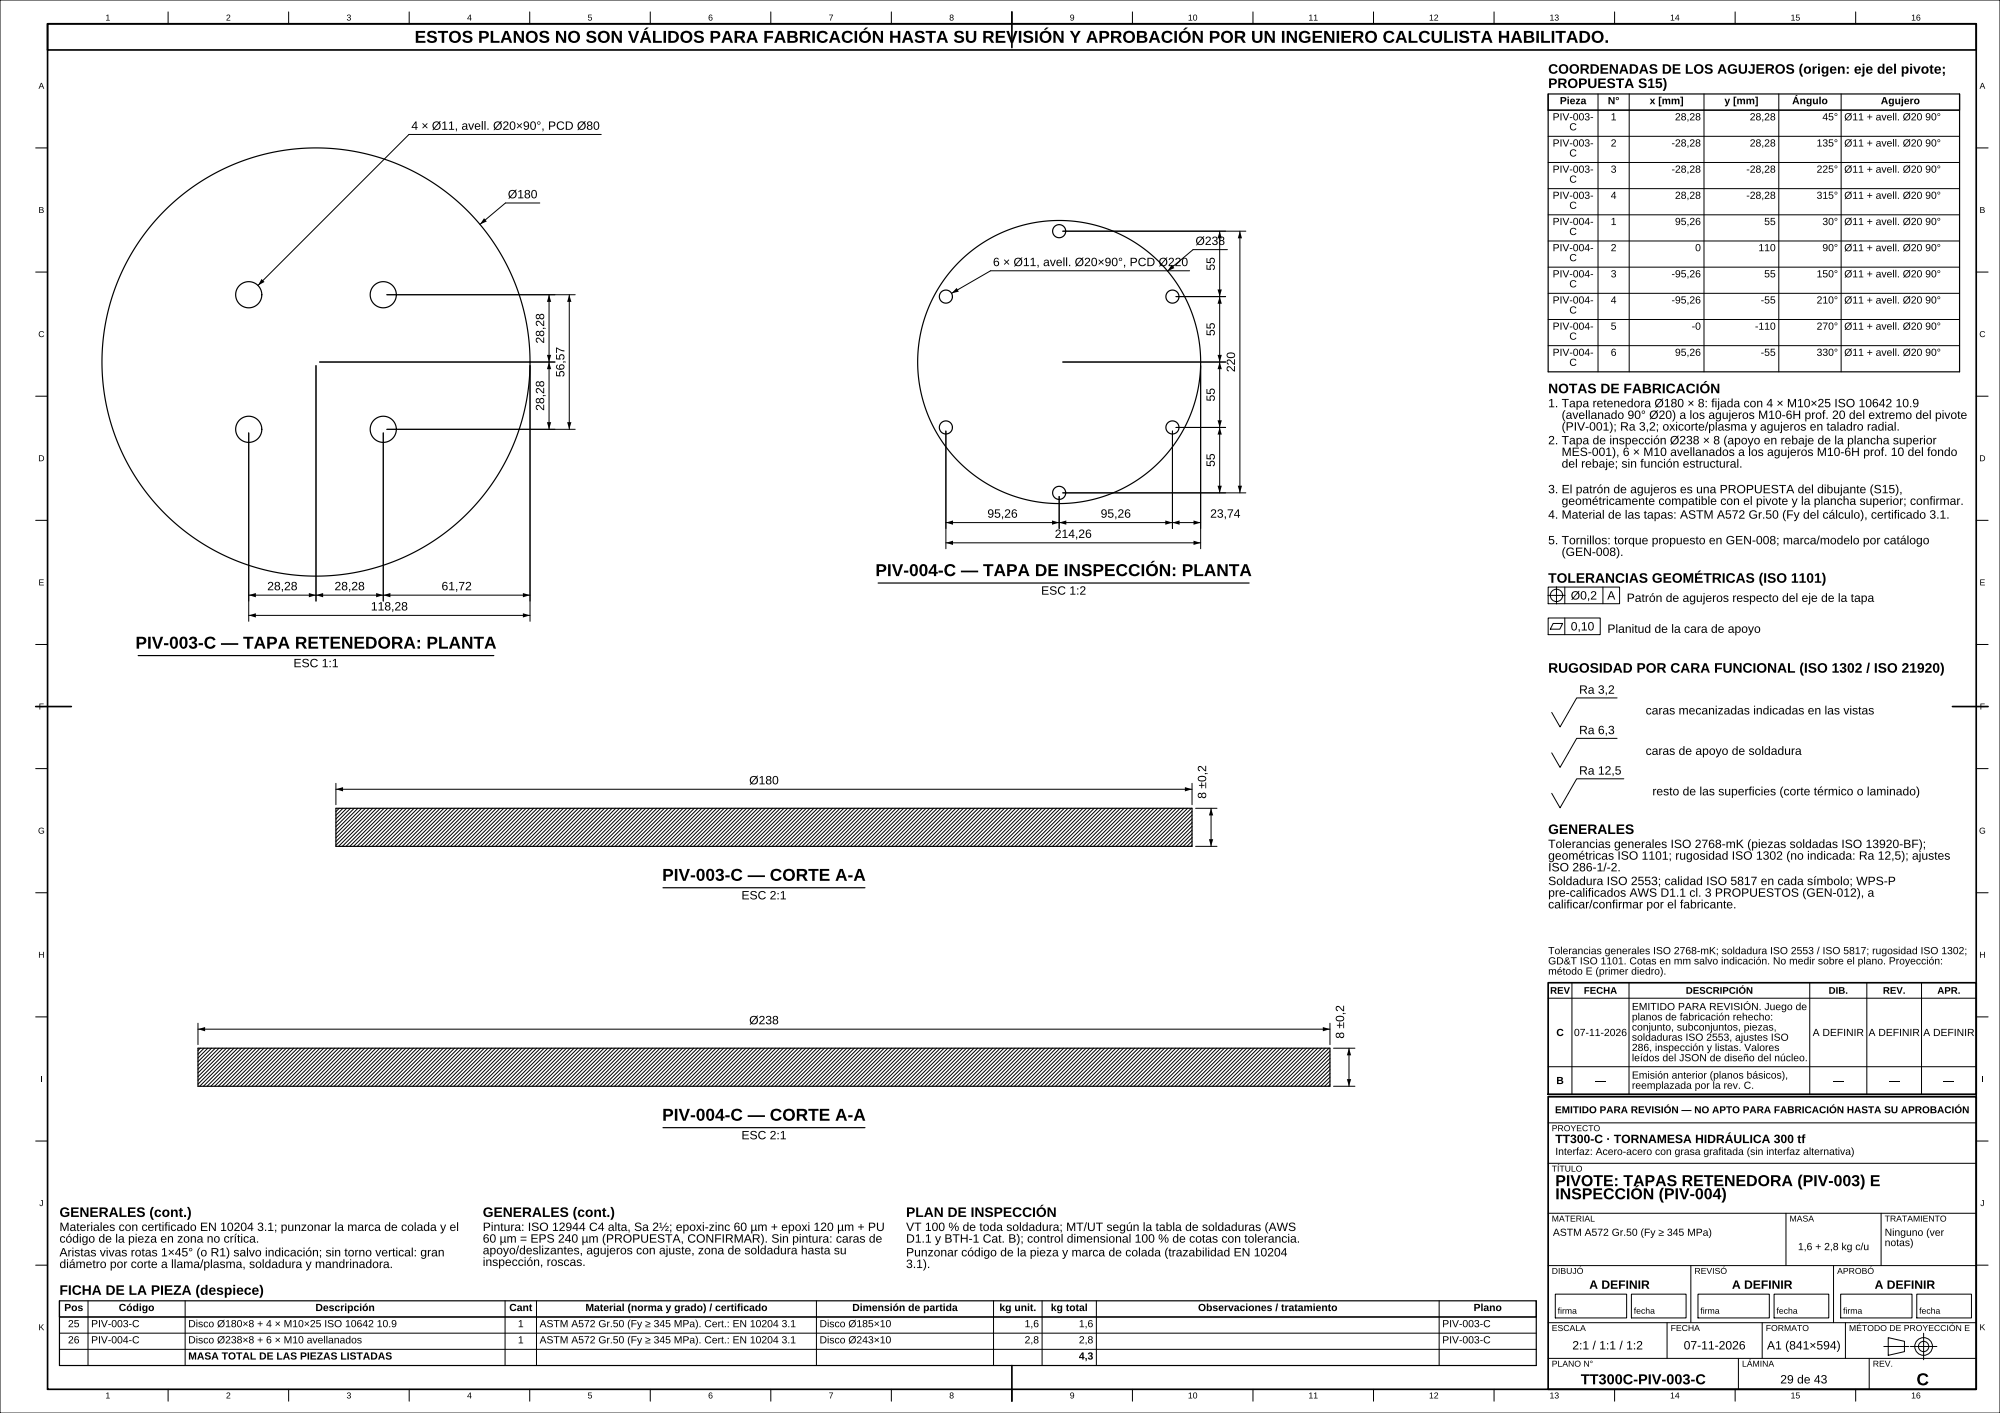
[picture p109: page 1]
