mafiucivil/Tornamesa/(commit log)

2026-10-30 Agrega especificación de diseño: núcleo, agentes de desarrollo y del producto
    Claude-Session: https://claude.ai/code/session_01SeBjpMuD3aPBEuuQGZZPwS
2026-10-30 Spec: BTH-1 Cat. B, soldadura parametrizada y selección comercial de cilindro
    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
2026-10-30 Spec: accionamiento paramétrico, base 2 x 50 t, verificación de capacidad de cilindros
    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
2026-10-31 Agrega análisis de la tornamesa de referencia KIET 400T
    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
2026-10-31 Agrega TT300-C: núcleo de cálculo, agentes y herramienta HTML de verificación
    - Núcleo (packages/core/tt300c.js): cinemática de cilindro pivotado y uña,
    accionamiento, masas, FEA de mesa e izaje, flexión global axisimétrica y
    verificaciones con referencia normativa (AISC 360-22, ASME BTH-1 Cat. B,
    AWS D1.1, AISC Apéndice 3).
    - Agentes deterministas: validador, auditor normativo, revisor cruzado,
    escenarios y optimizador de peso.
    - Herramienta autónoma dist/TT300-C_Verificacion.html.
    - Tests Node (benchmarks FEA, cinemática KIET, golden file) y verificación
    independiente en Python.
    - Subagentes de desarrollo en .claude/agents/ y registro normativo.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
2026-10-31 TT300-C: chequeos de horquilla y ménsula, izaje a medio lado, nuevos valores por defecto
    - Horquilla de la uña debe caber entre los anillos de pasadores: la mesa
    sube a 190 mm y los pasadores a Ø95 (golden regenerado por este motivo).
    - Ménsula en caja dentro de la base; geometría derivada (luz interior según
    el giro del cilindro).
    - Puntos de izaje a medio lado (las esquinas las ocupan las ménsulas).
    - Optimizador con fase de factibilidad por máximo descenso del déficit;
    plancha base mínima 16 mm por planitud.
    - Exportador de diseño para el generador de planos.
    Claude-Session: https://claude.ai/code/session_01SeBjpMuD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
2026-10-31 Agrega generador de planos TT300-C (6 láminas A1, PDF + DXF) desde el JSON del núcleo
    - D-01 conjunto general, D-02 bases de cálculo y verificaciones,
    F-01 mesa giratoria, F-02 base y ménsulas, F-03 piezas mecánicas y
    especificación hidráulica, F-04 lista de corte, soldaduras, control,
    montaje y operación.
    - Se niega a emitir si el diseño no gira o la estructura no cumple.
    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
2026-11-02 TT300-C: modelo 3D (STEP/GLB), masas exactas, sin sismo y base mínima verificable
    - Modelo 3D paramétrico en CadQuery desde el JSON de diseño, con control de
    masas contra el núcleo (diferencia 0,0 % por pieza).
    - Fórmulas de masa del núcleo alineadas con la geometría real (agujeros de
    pasadores en todo el anillo, alojamiento de tapa, ménsulas, uñas, pivote):
    masa total 2436 kg; golden regenerado por este motivo.
    - Caso sísmico: no aplica por decisión del mandante (Ch sigue disponible).
    - Nuevo parámetro t_base_min con su verificación (planitud).
    Claude-Session: https://claude.ai/code/session_01SeBjpMuD3aPBEuuQGZZPwS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
2026-11-02 TT300-C: control de interferencias 3D y chequeos de holgura de la uña (diseño en revisión)
    - El modelo 3D verifica interferencias entre piezas; detectó que la horquilla
    y el cuerpo de la uña invaden los pasadores vecinos.
    - El núcleo incorpora esos chequeos (horquilla, cuerpo acodado, punta, alma
    exterior), uña acodada, desgarro de orejas y distancia ojal–cuerpo.
    - Con estos chequeos la geometría por defecto NO gira: tests de valores por
    defecto y golden fallan a propósito hasta resolver el mecanismo de empuje.
    - Visor 3D autónomo (dist/TT300-C_Modelo3D.html).
    Claude-Session: https://claude.ai/code/session_01SeBjpMuD3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
2026-11-02 TT300-C: accionamiento por uña guiada (patín en bancada) y cilindro Ø90
    - Reemplaza la uña libre (no factible con pasadores Ø95: interferencia con
    pasadores vecinos) por patín guiado en bancada con ranura, cilindro coaxial
    con la guía y uña con holgura radial en el alojamiento.
    - Factor de guía K = (1 + 2μg·Δ/Lg)/η con Lg = 2/3 del patín (rev. M3);
    nuevas verificaciones: flexión y corte de la uña en la boca, labio del
    alojamiento (rev. M4), lengüeta/ranura, pared de ranura, soldadura de
    bancada, holgura radial (rev. C2) y geometría en planta y alzado.
    - Base 2400 × 2400 × 20, mesa 210, pasadores Ø100 34CrNiMo6, puntos de izaje
    en los lados y. Masa 3017 kg; FS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
2026-11-02 TT300-C: modelo 3D del accionamiento guiado sin interferencias; masas exactas
    - Modelo 3D con bancadas, patines (lengüeta, horquilla, boca, ranura de paso
    del vástago), uñas con asiento y cilindros coaxiales; 26 pares de piezas
    verificados sin interferencia.
    - Masas del núcleo alineadas con el sólido (diferencia ≤ 0,5 % por pieza).
    - Patín extendido 20 mm más allá del eje del pasador para alojar toda la uña
    (Lg mayor: K = 1,234, FS diseño 1,41). Bancada de 110 mm. Golden regenerado.
    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
2026-11-02 TT300-C: retorno radial de la uña (resorte) en el patín; base 2480
    - La uña se retrae radialmente ≈ 76 mm al retornar para despejar el pasador
    siguiente (como el trinquete de TT300-B); el alojamiento incluye recorrido
    y resorte, con su verificación geométrica.
    - Patín 210 mm, guía en x = 1120, base 2480 × 2480 × 20, bancada 120.
    - Masa 3107 kg; FS diseño 1,35; modelo 3D sin interferencias. Golden regenerado.
    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
2026-11-02 Planos Rev B: uña guiada con patín en bancada, cilindros Ø90
    - Ajustes de diagramación D-01, F-02 y F-04 (cotas, títulos, notas)
    - Pasadores de empuje en 34CrNiMo6+QT con Fy en lista de materiales y de corte
    - Rótulo actualizado al accionamiento por patín guiado
    - Visor 3D: bancadas 1e y patines 16 como grupos visibles
    - Entregables Rev B (PDF, DXF, STEP, JSON) en entregables/RevB
    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
2026-11-03 Presión nominal del cilindro como dato de entrada (psi)
    - Nuevo parámetro p_rated (10.000 o 5.000 psi) con verificación del alivio, la alarma y el retorno
    - Fila informativa del émbolo mínimo para las presiones elegidas
    - Agente de escenarios: tabla por clase de presión; validador rechaza alivio sobre la nominal
    - Planos: clase de presión del cilindro y de mangueras desde el parámetro
    - Golden file y entregables Rev B regenerados
    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
2026-11-03 Registro normativo: protección contra sobrepresión (ISO 4413:2010) confirmada por el revisor
    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
2026-11-03 Memoria de cálculo automática (Word y PDF) desde el núcleo
    - tools/memoria_tt300c.py: hipótesis, desarrollo, verificaciones por grupo, resumen, pendientes y anexo de control de calidad; texto negro
    - export_design.js: grupos de parámetros, apoyo, fuerzas a lo largo de la carrera, escenarios, revisión cruzada y auditoría
    - npm run memoria
    - Registro normativo: sismo no aplica (decisión del mandante)
    - Entregables Rev B versionados (PDF, DXF, STEP, memoria)
    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
    [TT300-C.step]
2026-11-03 Accionamiento: uña de cara plana con fricción en el contacto, ranura T y verificaciones corregidas
    Correcciones por la revisión independiente del accionamiento:
    - Equilibrio del patín con fricción cara–pasador (sentido según la velocidad del punto de contacto, cambia en y_p = r); F de diseño = máximo en la carrera
    - Uña de cara plana templada: Hertz, chaflán de retorno (geometría, corte, flexión, autobloqueo)
    - Alojamiento como bloque rígido-plástico; paredes del marco de boca
    - Lengüeta con pico de distribución lineal; fondo de ranura; ranura T con retención vertical (vuelco y cabeceo)
    - Pasadores con resultante F·√(1+μ_s²); empuje asimétrico al pivote
    - Geometría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
2026-11-03 WIP: avance parcial de verificador independiente y modelo 3D (agentes en curso)
    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
2026-11-03 Núcleo: correcciones de la reverificación independiente (N1, N3, N4, N6, N7)
    - Pared de la ranura T: brazo hasta el fondo de la cabeza T; bancada 190 de ancho
    - Guía a calado con F_pas = η·F_calado (mesa detenida, sin descontar fricción de guía)
    - Flexión de la uña con el momento de μs·F·b/2
    - μ máx con par del pivote proporcional a μ; empuje asimétrico en ambos extremos
    - Hertz rotulado: ambas caras templadas
    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
2026-11-03 WIP: scripts de verificación independiente y CAD en actualización
    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
2026-11-03 WIP: CAD en actualización (agente de planos)
    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
2026-11-03 Planos Rev B y modelo 3D: uña de cara plana con chaflán, patín con lengüeta T, bancada con ranura T
    - 3D: chequeo de interferencias en todos los pares (120, 0 interferencias); tapa pos 7 e=8 con M10 avellanados (choque previo con pos 8)
    - Planos: lista de materiales con temple por inducción (pos 3 y 10), corte E-E de la bancada, detalle de uña y patín, capa TRAT
    - Pendiente: alojamiento de la uña más alto que la caja del patín (P1)
    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
2026-11-03 Patín con tapa y fondo del alojamiento de la uña; ranura T 18+10; entregables regenerados
    - Núcleo: cara superior del patín = máx(horquilla, uña + tapa t_pk); verificaciones de fondo del alojamiento y altura bajo la mesa; masa del cuello h_ranura + 1
    - Bancada 170×40 (ranura T 40×18 + 64×10, fondo 12); frente del patín +165
    - 3D: 120 pares sin interferencia; masas 3D/núcleo ≤ 0,3 %
    - npm test incluye el verificador independiente del accionamiento (0 hallazgos)
    - Planos, visor, herramienta y memoria regenerados
    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
    [TT300-C.step]
2026-11-04 Pasadores de empuje Ø85: biapoyados con carga repartida en la altura de la uña
    - Modelo del pasador: M = F_r(L − c/2)/4, corte V = F_r(1/2 + e/L), aplastamiento V/(d·t) por anillo
    - Empotramiento por ajuste en anillos de 35 mm: solo 12 % del perfecto (informativo, no se cuenta)
    - Marco de boca t_fw 80 (boca más cerca del eje con pasador menor)
    - Masa 3.285 kg (pasadores 363 → 262 kg); FS de diseño 1,383
    - 3D (120 pares sin interferencia), planos, visor, herramienta y memoria regenerados
    - Pendiente: actualizar verificadores independientes al modelo nuevo del pasador
    Claude-Session: https://claude.ai/code/session_01SeBjpMuD3aPB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
    [TT300-C.step]
2026-11-04 Hertz con carga de borde (k = 1,32) y alivio de borde en la cara de la uña; temple ≥ 55 HRC
    - Hallazgo N8 del verificador independiente: el pasador flecta bajo la uña rígida y la carga lineal sube a 1,32·F/h en los bordes
    - Núcleo: q = k_borde·F/h en Hertz y en la profundidad de temple; Fy superficial 1500 (≥ 55 HRC)
    - Planos: bombeo (perfil logarítmico) en 10 mm de cada extremo de la cara de empuje
    - Verificadores independientes al día: sin diferencias / 85 coincidencias, 0 hallazgos; npm test completo en verde
    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
2026-11-04 Interfaz de giro alternativa: discos de acero inoxidable (A) y discos con lámina UHMW (B)
    - Dos checkboxes excluyentes en la herramienta; espesores calculados (disco inox por flexión sobre vacío local, UHMW por conformidad de planitud) y adoptados comerciales, con opción manual
    - Núcleo: μ efectivos por opción, altura agregada (el eje de los cilindros sube), masas, peso del disco rotatorio en la carga, verificaciones de retención, dilatación, PV, desgaste y juntas
    - Tabla comparativa de las tres alternativas; corte radial con los discos; memoria 6.1 con el cálculo del espesor
    - Planos y 3D por defecto sin cambios (con A o B se detienen con aviso: aún sin dibujar)
    - Tests 12/12; re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
2026-11-04 Interfaz alternativa: módulo confinado del UHMW, μ de B consistentes, retención con pegado y pendientes
    Hallazgos de la revisión independiente (H1–H5, H7, H9, H11):
    - UHMW: t ≥ E_c(S)·δ/(p_adm − q) con módulo de lámina delgada; planitud local 0,05 mm en ventana de Ø100 → 15 mm (Δ = 27 mm)
    - μ de B ordenados (0,08 / 0,20 / 0,25 / 0,25); B ya no baja la fuerza de diseño
    - Retención de los discos: μ respaldo 0,30 + pegado epóxico 0,5 MPa; pendientes de gripado (A) y retención de sectores UHMW (B)
    - PV durante la carrera; crecimiento radial del sector; Δ de masa total en la comparación
    - Tests 12/12; indep_interfaz.py (revisión independiente) en actualización
    Co-Auth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
2026-11-04 Interfaz alternativa: retención = máx(fricción; pegado), cortante térmico del adhesivo, arrastre UHMW con μ máximo
    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
2026-11-04 Verificador independiente de la interfaz (indep_interfaz.py) incorporado a npm test: 182 coincidencias, 0 críticos ni importantes
    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
2026-11-04 Auditoría numérica: kFEA 1,22, izaje con σ fuera de la zona singular y carga completa, FU infinito si la capacidad es ≤ 0
    - kFEA 1,15 → 1,22 (error de malla de las planchas de la mesa: 1,20 a 1,21 por Richardson)
    - runLift: carga propia con patines, bancadas, discos y UHMW; σvm máximo a ≥ 2·pad del cáncamo
    - add(): capacidad ≤ 0 ya no da FU negativo aprobado (Infinity = no cumple)
    - parseRings sin duplicados; masas sin valores negativos; analyze rechaza A y B a la vez
    - tests/convergencia.js (auditoría de convergencia, en actualización)
    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
2026-11-04 WIP: tests/convergencia.js en actualización (agente de auditoría numérica)
    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
2026-11-04 Auditoría numérica: tests/convergencia.js APTO (134 pruebas, 0 fallas, 0 críticos ni importantes)
    - Réplica de runLift al día; carga de izaje contra la masa total (+0,55 %, ruido de escalera sin sesgo)
    - npm run test:convergencia (modo rápido, ≈ 1,5 min)
    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
2026-11-05 Interfaz alternativa C: placa de bronce con tapones de grafito (checkbox y 3 configuraciones)
    - Núcleo: espesor del bronce por flexión sobre vacío local con ligamento entre tapones; disco duro rotatorio o 2.ª placa de bronce; pastillas segmentadas; μ de C; presión neta, PV, desgaste, dureza, retención, adhesivo, dilatación
    - UI: checkbox C excluyente con A y B, selector de configuración, comparación de 4 alternativas, corte radial con bronce
    - Puntos de izaje 100 mm hacia adentro (c_lug 50 → 150): con la carga de izaje corregida, A, B y C dejaban la flecha de la base sobre B/300
    - Planos y 3D regenerados (120 pares sin interferencia); memoria 6.1 ampliada; tests 13/13
    - Verificac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
    [TT300-C.step]
2026-11-05 Pivote: reacción del empuje no equilibrado con un número impar de cilindros
    Con 1 o 3 cilindros el par no es puro y el pivote reacciona con la fuerza tangencial del pasador; antes la herramienta daba FU 0,33 en el buje con 1 cilindro y 150 tf, y la presión real es 37 MPa (admisible 30).
    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
2026-11-05 WIP: tests/indep_interfaz.py en actualización (verificación independiente de la opción C)
    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
2026-11-05 Opción C: pastillas cargan el respaldo con q/cobertura (plancha inferior y losa), cobertura 0,9, μ ordenados y filas de retención
    Hallazgos de la revisión independiente de la opción C (C1, C3, C7, C9, C11):
    - R.qc = q_máx/cobertura en el FEA de la plancha inferior, la flexión global y la losa; con 70 % la plancha inferior daba 1,19
    - bz_cover por defecto 0,9; μ de C 0,08/0,15/0,20/0,25
    - Filas nuevas: retención del disco duro o 2.ª placa, dilatación de la 2.ª placa
    - Tests 14/14; verificación independiente en actualización
    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
2026-11-05 Ideas de los equipos comerciales: comparación de mercado, capacidad por n° de cilindros, bomba y retorno rápido, control, cubierta de madera y skidding
    - Núcleo: capacityW/capacityByCyl/market; Q_ret, potencia del motor, velocidad de retorno, tiempo objetivo; cubierta de madera (checkbox) con aplastamiento y masa; enrase con rieles
    - UI: comparación con equipos comerciales (Enerpac ETT, KIET, Hydra-Slide), capacidad con 1 y 2 cilindros, umbrales de presión y bomba, madera en el corte radial
    - Memoria: 6.2 cubierta, 7.7 bomba/control/capacidad, 11 mercado con fuentes
    - Tests 17/17; verificación independiente de lo nuevo en curso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
2026-11-05 Fijación desmontable por sectores con topes y ranuras de engrase (discos inoxidables, UHMW y bronce)
    - El pegado deja de ser el modo por defecto (no es desmontable): sectores con topes soldados al respaldo toman el par por aplastamiento y soldadura; tornillos avellanados solo de posición
    - Disco de la mesa (A) y bronce (C) con ranuras de engrase: más espesor (6/8 mm en A), área de ranuras, volumen de grasa y graseras
    - Verificación de masa por sector (≤ 25 kg, ISO 11228-1); pegado queda como alternativa con aviso de no desmontable
    - Tests 18/18; verificación independiente en actualización
    Claude-Session: https://claude.ai/co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
2026-11-05 Hallazgos de la verificación independiente: área de apoyo de la madera, camino de fuerza del pivote (base y buje), resultante con fricción, potencia a presión de alarma
    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
2026-11-05 Pared del marco de boca: el cortante no puede superar la fuerza total del empuje (hallazgo de la auditoría de sobredimensionamiento); regenera parámetros por defecto
    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
2026-11-05 Réplicas independientes en actualización (interfaz de bronce y funciones nuevas)
    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
2026-11-06 Asiento del pivote con momento (P6, pendiente de decisión de diseño) y límite de la madera en la capacidad (C1)
    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
2026-11-06 Réplica de funciones nuevas actualizada
    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
2026-11-06 Soldadura del tope con par de excentricidad (T2): corte + tracción del filete trasero, parámetro b_tope
    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
2026-11-06 Réplica de interfaz actualizada a la soldadura del tope con b_tope (0 discrepancias)
    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
2026-11-06 Paquete de reducción de masa (t_pr 27, t_web/t_rib 6, t_base 18, w_bed 160, w_s 245) y collar soldado de asiento del pivote (opción A)
    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
2026-11-06 f_apoyo = 0,90 (tablones contiguos dentro del anillo de acero, definido por el mandante)
    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
2026-11-06 Réplica de interfaz: rebaje del cubo por el collar del pivote
    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
2026-11-06 Orejas de izaje soldadas (4, placa de 18 mm): verificaciones, masa y parámetros
    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
2026-11-06 Paquete de dibujo en la herramienta: láminas DXF/SVG/PDF, lista de materiales CSV y JSON de diseño (checkbox Exportar paquete de dibujo)
    Módulo packages/web/planos_export.js incorporado por el build; panel y botones en ui.js; pruebas con node --test y verificación con Playwright.
    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
2026-11-06 WIP paquete de planos: geometría común y exportación (trabajo de los agentes en curso)
    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
2026-11-06 Nombres de los casos nominal y seco con la opción de bronce
    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
2026-11-06 Modelo 3D TT300-C reescrito por ítems: collar, orejas, interfaz A/B/C por sectores, madera; geometría derivada y exportación de interfazGeom
    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
2026-11-06 Láminas de fabricación (base, ménsula, oreja, bancada, patín, uña, articulaciones) con HLR, cajetín normalizado y chequeo de cotas
    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
2026-11-06 Láminas de la mesa, pasador y pivote
2026-11-06 Láminas de interfaz (A/B/C) y cubierta de madera
2026-11-06 Láminas generales, orquestador generar_paquete.py, despiece CSV/XLSX, informe y lista de verificación
2026-11-06 Nota NO desmontable (pegado), explicación numérica de masas, wrapper planos_tt300c.py
2026-11-06 Paquete de planos Rev. C: láminas, STEP/GLB, despiece, informe y variantes verificadas (A, A pegado, B, C1-C3, madera)
    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
    [TT300-C.step, TT300-C_despiece.csv, TT300-C_despiece.xlsx, TT300C-ACC-001-B.dxf, TT300C-ACC-002-B.dxf, TT300C-ACC-003-B.dxf, TT300C-ACC-004-B.dxf, TT300C-BAS-001-B.dxf]
2026-11-06 Bomba por defecto 10/20 L/min (10,5 min por vuelta, objetivo 15), memoria con control 3D y paquete RevC regenerado
    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
    [TT300-C.step, TT300-C_despiece.xlsx, TT300C-ACC-001-B.dxf, TT300C-ACC-002-B.dxf, TT300C-ACC-003-B.dxf, TT300C-ACC-004-B.dxf, TT300C-BAS-001-B.dxf, TT300C-BAS-005-B.dxf]
2026-11-06 Verificador independiente de orejas de izaje, collar del pivote y masa de collar/orejas (tests/indep_izaje_collar.py)
    Réplica en Python desde AISC 360-22 (D2, D5, J2.4, J7), AWS D1.1 y ASME BTH-1/B30.26: 5625 comparaciones contra el núcleo
    (caso base, 15 barridos, 60 combinaciones), 0 discrepancias numéricas. Hallazgo mayor H1 (carga del filete del collar) y 7 menores;
    sale con 1 por H1, por eso no se agrega al npm test.
    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
2026-11-06 Tope desmontable: geometria realizable (alivio superior e inferior, altura de contacto h_c, brazo z) y w_br 16 -> 20
    Hallazgo del dibujante: el nucleo calculaba el aplastamiento con t completo y el brazo t/2, sin definir la
    altura de la barra. Con t = 6 mm el filete de 6 mm (AWS D1.1 Tabla 5.8, parte mas gruesa) no cabe en una barra
    de 5 mm y, con el alivio que exige el filete delantero, el contacto es nulo.
    Geometria elegida (barra a ras + chaflan de alivio en el canto del sector, filetes continuos):
    - barra h_barra = t - a_sup (a_sup = 2 mm: >= 1 mm bajo la cara al final de la vida, incluido el relapeado)
    - alivio inferior a_inf = w_tope + 1 (0 = automatico) para librar el triangulo del f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
2026-11-06 WIP núcleo: segunda pasada (orejas R 92, collar, barras de topes); en curso, tests sin cerrar
    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
2026-11-06 Nucleo, 2.a pasada: orejas R 92 (AISC D5.2), collar con V_c/M_c reales, rebaje del cubo con holguras, e efectivo, barras de topes en m.total
    Cierra el WIP 2064e15 (nucleo y tests de tt300c) con exportadores, golden y dist.
    Cambios del nucleo (packages/core/tt300c.js):
    - R_ear 60 -> 92 (decision del usuario; AISC 360-22 D5.2(3): a = R - d/2 >= 1,33 b_e, FU 0,995).
    Se reemplaza la fila "R - d/2 >= 0,5 d" por D5.2(3) (extension a y ancho 2R >= 2 b_e + d) y D5.2(2)
    (holgura agujero-pasador <= 1 mm si el pasador gira: params nuevos g_ear 3 y ear_gira 0).
    Nuevas filas: placa de la oreja en la base (flexion Th.h + traccion Tv, y corte), filete minimo (AWS D1.1 Tabla 5.8)
    y maximo (AISC J2.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
2026-11-06 Nucleo, 3.a pasada: R_i real de la interfaz (collar), rebaje del collar en la mesa con δ, e_piv automatico
    Interfaz de contacto: el anillo ya no parte de R_i = D_piv/2 + 15 = 75 mm sino de
    R_i = D_boss/2 + c_boss_r + m_ri = 131 mm (m_ri nuevo, 3 mm) cuando hay collar, para
    default, A, B, C1-C3 y madera (sin collar queda D_piv/2 + 15). Se propaga a area,
    q_med/q_max, kq, r_u, H_ecc, masa de discos/bronce/UHMW, ranuras de engrase, largo
    de topes (Lav = R_o - R_i - 100 = 769 mm), lamina UHMW, flexion global de la mesa y
    capacidad (wCap). Nadie deja de cumplir: q_max sube 0,75 % (1,661 -> 1,674 MPa).
    Rebaje de la mesa: profundidad desde la cara inferior = h_boss - delta + c_boss_a
    (delta = alt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
2026-11-06 Paquete de planos: R_i del nucleo, barras de topes con geometria verificada, rebaje del collar con holguras, nuevas notas N2/N8, conciliacion de masas
    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
2026-11-06 Paquete de planos: corrige detalle de capas INT-001, secciones de topes, notas
    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
2026-11-06 Verificadores independientes: R_i real, rebaje del cubo con delta, topes nuevos, collar y D5.2
    - indep_tt300c: R_i = D_boss/2 + c_boss_r + m_ri, masa con agujero pasante de la plancha inferior y rebaje del cubo, bomba (tiempo por vuelta, v de retorno).
    - indep_accionamiento: misma geometria; N2 (temple) y N8 (alivio de borde) pasan a 'abierto a planos' (impresos, no bloqueantes); exit 1 solo con discrepancias numericas, criticos o mayores.
    - indep_interfaz: R_i, h_c, z, espesor minimo del sector, menor Fy sector/barra, aplastamiento, soldadura T2 con z, flexion de la barra, masa de barras (m.stopBars), UHMW por aplastamiento; comparacion con interfazGeom.
    - indep_izaje_collar: corrige el Typ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
2026-11-06 Paquete de planos: retoques de legibilidad (GEN-002, MES-001, BAS-001, IZA-001)
    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
2026-11-06 Entregables Rev. C regenerados con el nucleo actual (default + variantes A, A pegado, B, C1-C3, madera)
    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
    [TT300-C.step, TT300-C_despiece.csv, TT300-C_despiece.xlsx, TT300C-ACC-001-B.dxf, TT300C-ACC-002-B.dxf, TT300C-ACC-003-B.dxf, TT300C-ACC-004-B.dxf, TT300C-BAS-001-B.dxf]
2026-11-06 Nucleo, 4.a pasada: hc_min 6, tolerancia de contacto, masas netas de sectores, anillo de la madera, filete maximo de mejillas
    Decidido por el usuario: hc_min 3 -> 6 mm (hallazgo T6). Espesor minimo del sector con tope =
    a_sup + a_inf + hc_min = 2 + 7 + 6 = 15 mm. Con h_c = 3 el aplastamiento (FU 0,90) pasaba a >1,3 por 1 mm de
    error de corte. Propaga: A 12/12 -> 15/15, B discos 12 -> 15 (UHMW sigue en 25), C bronce y disco duro 12 -> 15;
    delta A/C 24 -> 30 mm, B 49 -> 55 mm (eje de cilindros, rebaje del collar, soldadura mejillas-base).
    Decision mia, a confirmar: tol_hc (nuevo, 1 mm). El largo del tope se dimensiona con h_c - tol_hc (antes con h_c y
    FU objetivo 0,90: al subir h_c el largo s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
2026-11-06 Paquete de planos: núcleo 4.ª pasada (masas netas sin conciliación, anillo de la madera, juntas del JSON, c_lug 200), BAS-001 con detalles D1/D2, IZA-001 con planta de las 4 orejas, MES-003 sin texto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
2026-11-06 Paquete de planos: control de revisión actualizado, GEN-009 legible, cajetín
    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
2026-11-06 Paquete de planos: GEN-006/007 con texto legible
    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
2026-11-06 Paquete de planos: IZA-001 detalle de oreja sin solapes
    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
2026-11-06 Paquete de planos: MES-003 cota del rebaje con texto corto
    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
2026-11-06 Paquete de planos: residual de los tapones de grafito explicado con el núcleo (f_g uniforme frente al patrón S09)
    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
2026-11-06 Verificador independiente de la interfaz adaptado a la 4.a pasada del nucleo (0 discrepancias)
    indep_interfaz.py: 191 discrepancias -> 0 sin tocar tolerancias (0,1 %). Formulas propias nuevas:
    - tol_hc: L = max(F/(adm (h_c - tol_hc)); L_sold)/0,9 a 5 mm; fila de aplastamiento con h_c - tol_hc;
    lamina UHMW con h_c >= F_s/(0,9 L p_adm) + tol_hc; hc_min 6 -> sector 15 mm.
    - masas netas (cuts_for): junta j (max(j_sec; dilatacion) redondeada HACIA ARRIBA a 0,1 mm), muesca
    (b+2) L t, chaflan a_inf^2 L, franja (b+j)(Ro-Ri)t en la lamina UHMW, pegado sin muescas, C3 sin junta;
    m.ss/m.uhmw/m.bz/m.sectorCuts, m.ssTop bruta, mSS/mUH/mBz brutas, masa por sector neta (ISO 11228-1).
    - barras del reb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
2026-11-06 Paquete de planos: INT-002/INT-003 cotas y marcos GD&T fuera de la trama de tapones
    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
2026-11-06 Tornamesa_v1.0.html como archivo principal, con selector de alternativa de interfaz (base, A, B, C1-C3)
    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
2026-11-06 Paquete de planos: MAD-001 símbolo de soldadura del anillo fuera de la trama
    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
2026-11-06 Paquete de planos: residual de la variante pegada y brecha de los tapones de grafito
    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
2026-11-06 Registro: sección Temperatura (exposición solar, 80 °C)
    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
2026-11-06 Entregables Rev. C regenerados con el núcleo de la 4.ª pasada (default + A, A pegado, B, C1-C3, madera); se retira la Rev. B anterior
    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
    [TT300-C.step, TT300-C_despiece.csv, TT300-C_despiece.xlsx, TT300C-ACC-001-B.dxf, TT300C-ACC-002-B.dxf, TT300C-ACC-003-B.dxf, TT300C-ACC-004-B.dxf, TT300C-BAS-001-B.dxf]
2026-11-06 WIP núcleo: verificación por temperatura (en curso, sin cerrar)
    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
2026-11-06 Verificación por temperatura de servicio (exposición solar, 80 °C), núcleo, UI y exportadores; v1.1
    Escenario aparte: con T_serv = 20 °C (por defecto) el cálculo estándar no cambia (tests/golden/tt300c_defaults.json
    sin cambios; solo se agregan 25 claves de parámetros a params_defaults.json, sin alterar valores existentes).
    Datos y niveles de confianza A/B/C de docs/normas/registro.md, sección «Temperatura (exposición solar, 80 °C)».
    Núcleo (packages/core/tt300c.js):
    - Grupo de parámetros «Temperatura» (T_serv 20–120, T_ref, dT_grad, factores kT_* a 80 °C con confianza en el rótulo,
    aceite, p_max_cil, alivio_term, nu_min, etc.); factores interpolados linealmente 20→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
2026-11-06 WIP: trabajo en curso de los agentes (réplica térmica y memoria)
    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
2026-11-06 Memoria de cálculo TT300-C Rev. C: capítulos 9 (alternativas de interfaz y madera) y 10 (exposición solar a 80 °C), Anexo B, valores del núcleo regenerados
    - tools/export_alternativas.js (nuevo): análisis por alternativa (base, A, B, C1-C3, madera), termica de la madera y medidas cuantificadas; npm run memoria lo ejecuta.
    - tools/memoria_tt300c.py: Rev. C, herramienta principal leída de VERSION (Tornamesa_v1.1.html), capítulo 2 solo con criterios estándar, letras negras también en los estilos heredados, redondeo a cifras significativas antes de elegir decimales.
    - entregables/RevC: memoria Rev. C (DOCX/PDF) y TT300-C_alternativas.json; se retira la memoria Rev. B. LEEME actualizado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
2026-11-06 WIP: réplica independiente de la parte térmica (en curso)
    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
2026-11-06 WIP: tapones de grafito y alcance térmico (en curso)
    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
2026-11-06 WIP: tapones de grafito, alcance térmico y rediseño de planos (en curso)
    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
2026-11-06 cad: infraestructura de dibujo rev. C (draw, vistas, hojas_base, ISO 286) y primera lámina de pieza (en curso)
    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
2026-11-06 cad: láminas de fabricación por pieza (base, collar, marcos, ménsula, orejas, bancada, mesa, pasadores, pivote, accionamiento, interfaz) en curso
    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
2026-11-06 Tapones de grafito reales (N_real, f_g real/ideal, TT.tapones) y alcance térmico solo placas y disco (term_alcance); v1.2
    Tapones: N_real = centros de la malla escalonada (p, fila p*sqrt3/2) en el area util (corona menos franja bz_edge 4 mm, muesca del tope, tornillos y ranuras); reproduce el 3D (C1/C2 2640, C3 2364). bz_fg_modo=1 por defecto: masa del bronce, q_neto, PV, desgaste y lubricacion usan f_g real (C1 +8,4 kg de bronce). bz_fg_min 0,20 (supuesto C) como aviso; ningun patron con eta>=0,45 lo alcanza (max 0,176), se conserva Oe12/p30. Golden del modo ideal nuevo (tt300c_bz_ideal.json) sin cambios de valores.
    Termica: term_alcance=1 (placas y disco) saca del veredicto aceite atrapad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
2026-11-06 WIP: rediseño de planos y réplicas (en curso)
    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
2026-11-06 cad: conjuntos, láminas generales y nueva canalización del paquete (en curso)
    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
2026-11-06 cad: correcciones de rótulos de juntas, símbolos faltantes, relleno isométrico (en curso)
    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
2026-11-06 WIP: planos y entregables (en curso, tras reinicio del contenedor)
    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
    [TT300-C.step, TT300-C_despiece.csv, TT300-C_despiece.xlsx, TT300C-ACC-001-B.dxf, TT300C-ACC-001-C.dxf, TT300C-ACC-002-B.dxf, TT300C-ACC-002-C.dxf, TT300C-ACC-003-B.dxf]
2026-11-06 cad: tapones del núcleo v1.2 en lámina de bronce e informe
    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
2026-11-06 Entregables Rev. C: juego de planos rehecho (diseño por defecto, 39 láminas) con núcleo v1.2
    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
    [TT300-C.step, TT300-C_despiece.csv, TT300-C_despiece.xlsx, TT300C-ACC-001-B.dxf, TT300C-ACC-001-C.dxf, TT300C-ACC-002-B.dxf, TT300C-ACC-002-C.dxf, TT300C-ACC-003-B.dxf]
2026-11-06 Entregables Rev. C: variantes A, AF2 y C1 regeneradas (en curso)
    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
    [TT300-C.step, TT300-C_despiece.csv, TT300-C_despiece.xlsx, chequeo_cotas.csv, lista_de_cortes.csv, metricas_laminas.csv, soldaduras.csv]
2026-11-06 Entregables Rev. C: variantes B, W y C2 regeneradas (en curso)
    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
    [TT300-C.step, TT300-C_despiece.csv, TT300-C_despiece.xlsx, chequeo_cotas.csv, lista_de_cortes.csv, metricas_laminas.csv, soldaduras.csv]
2026-11-06 Entregables Rev. C: variante C3 regenerada; ajuste de cota del patín
    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
    [TT300-C.step, TT300-C_despiece.csv, TT300-C_despiece.xlsx, chequeo_cotas.csv, lista_de_cortes.csv, metricas_laminas.csv, soldaduras.csv]
2026-11-06 Entregables Rev. C: juego de planos completo regenerado (default + A, A pegado, B, C1-C3, madera) con núcleo v1.2
    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
    [TT300-C.step, TT300-C_despiece.xlsx, TT300C-ACC-001-C.dxf, TT300C-ACC-002-C.dxf, TT300C-ACC-003-C.dxf, TT300C-ACC-004-C.dxf, TT300C-ACC-005-C.dxf, TT300C-BAS-001-C.dxf]
2026-11-06 Réplicas independientes: conteo propio de tapones reales, empates, alcance térmico 1/2; indep_interfaz e indep_termica en exit 0
    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
2026-11-06 cad: compositor de lámina (escala normalizada máxima, cortes, detalles, roturas), cotas automáticas verificadas, esquemas de juntas y propuestas técnicas (en curso)
    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
2026-11-06 cad: láminas de interfaz y madera (tornillos, graseras, ranuras, tapones, tablones, anillo), conjuntos, GEN con WPS propuestos (en curso)
    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
2026-11-06 cad: huella de vista, símbolos de soldadura compactos, planificador acotado (en curso)
    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
2026-11-06 cad: ranuras con sector, ajustes de rotulado y chequeos (en curso)
    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
2026-11-06 Memoria Rev. C con núcleo v1.2: tapones reales (9.7), alcance térmico placas y disco (cap. 10), planos Rev. C (cap. 14) y Anexo C
    - 9.7 «Opción C: tapones de grafito, cantidad real frente a ideal»: definición de N_real, N real/ideal (C1/C2/C3), pérdidas por causa, sensibilidad ideal/real, barridos, patrón máximo alcanzable, criterios bz_fg_min/bz_eta_min, hallazgos G1-G4 y recomendación.
    - Cap. 10 reescrito con term_alcance = 1 (51 filas informativas fuera del veredicto); válvula de alivio térmico pasa a nota informativa 10.12 (Δp referencial, solo con movimiento restringido).
    - Cap. 11-12 actualizados; cap. 14 lee entregables/RevC/informe_paquete.md; Anexo C con parámetros v1.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
2026-11-06 cad: elevaciones adicionales con cotas, isométricas con copias locales, textos residuales (en curso)
    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
2026-11-06 cad: corte de la grasera, plano de corte del tope, ajustes (en curso)
    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
2026-11-06 cad: ajustes de rotulado (títulos largos, notas de agujeros centrados, márgenes de símbolos), cota R_i del sector UHMW
    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
2026-11-06 cad: título de detalles dentro de la celda, corte de bolsillos de la madera
    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
2026-11-06 cad: planificador con búsqueda local, rotulado de escala en cajetín, ranuras de engrase por opción (A: disco mesa; C: bronce)
    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
2026-11-06 cad: ranuras radiales excluyen tapones con el ángulo del tapón (hallazgo del verificador); título de CON-001
    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
2026-11-06 cad: bloque de rugosidad por cara funcional, contadores, checklist por pieza (en curso)
    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
2026-11-06 cad: GD&T y preparaciones faltantes según checklist por pieza; agujeros del rebaje de la tapa
    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
2026-11-06 cad: BAS-001 sin detalle duplicado del marco (mayor escala de la planta)
    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
2026-11-07 cad: GEN-004 siempre en A1 (las dos tablas se solapaban en A2)
    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
2026-11-07 cad: GEN-004 con las tablas una bajo otra (sin solape)
    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
2026-11-07 cad: nota de agujeros roscados de BAS-001 dentro del marco
    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
2026-11-07 Entregables Rev. C segunda pasada: default, A, A pegado, B, C1, madera regenerados (en curso C2, C3)
    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
    [TT300-C.step, TT300-C_despiece.csv, TT300-C_despiece.xlsx, TT300C-ACC-001-C.dxf, TT300C-ACC-002-C.dxf, TT300C-ACC-003-C.dxf, TT300C-ACC-004-C.dxf, TT300C-ACC-005-C.dxf]
2026-11-07 Entregables Rev. C segunda pasada: 8 casos regenerados (default, A, A pegado, B, C1-C3, madera), checklist por pieza y revisión visual
    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
    [TT300-C.step, TT300-C_despiece.csv, TT300-C_despiece.xlsx, checklist_piezas.csv, chequeo_cotas.csv, lista_de_cortes.csv, metricas_laminas.csv, soldaduras.csv]
2026-11-07 cad: control de calidad gráfico (choques de texto, marco, cajetín y banda) con ordenador de textos y recomposición por reserva de cotas
    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
2026-11-07 cad: título de vista sin desborde; MES-002 sin texto superpuesto
    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
2026-11-07 cad: checklist: agujeros = cilindros de r ≤ 80 (el arco R_i de los sectores no es un agujero)
    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
2026-11-07 cad: títulos largos partidos también en «:», notas de R_o sin choque, tolerancias de agujeros en el sector de ranuras
    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
2026-11-07 cad: reserva lateral de 115 mm para símbolos de soldadura fuera de la vista
    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
2026-11-07 cad: MES-005 radios de las almas rotulados hacia abajo (no invaden la banda de advertencia)
    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
2026-11-07 cad: holgura mínima entre textos en el ordenador, símbolos de soldadura fuera de las vistas (BAS-005, IZA-001), BAS-001 sin llamadas cruzadas, MES-002 sin cotas espurias, formato A2 solo si llena más
    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
2026-11-07 cad: PIV-003 llamada de agujeros abreviada (detalle completo en la tabla de coordenadas)
    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
2026-11-07 cad: BAS-001 con detalle J09, datum y símbolo fuera de las cotas, espesor de plancha en el corte
    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
2026-11-07 cad: MAD-001 sin cotas de ventana en los cortes
    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
2026-11-07 cad: sectores de la mesa y ranuras: tabla de conductos de engrase Ø6 con tolerancia y posición (sectores con grasera)
    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
2026-11-07 Entregables Rev. C tercera pasada: 8 casos regenerados con Fy_dog = 800 MPa, 0 choques de texto, 0 fuera de marco, checklist sin «NO»
    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
    [TT300-C.step, TT300-C_despiece.csv, TT300-C_despiece.xlsx, TT300C-ACC-001-C.dxf, TT300C-ACC-002-C.dxf, TT300C-ACC-003-C.dxf, TT300C-ACC-004-C.dxf, TT300C-ACC-005-C.dxf]
2026-11-07 Uña: Fy_dog 900 → 800 MPa (34CrNiMo6+QT, EN 10083-3, 40 < t ≤ 100 mm); FU 0,907 aceptada por el mandante
    - Núcleo: Fy_dog por defecto 800 MPa; goldens y params_defaults actualizados.
    - Test de valores por defecto: excepción documentada para la flexión de la uña en la boca del patín (FU ≤ 0,92).
    - informe.py: advertencia rotulada como aceptada por el mandante (07-11-2026).
    - docs/normas/registro.md: material de la uña y excepción del criterio FU ≤ 0,90.
    - HTML principal Tornamesa_v1.3.html.
    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
2026-11-07 cad: cotas solo entre aristas reales (filtro de vértices de partición/teselado y bordes de ventana), control de cadenas, rótulos sin nombres de parámetros, MES-002 y BAS-001 reacotados
    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
2026-11-07 cad: extremos de silueta como esquinas válidas, control de cadenas sin duplicados por recomposición, llamadas de agujeros sin bajar al título
    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
2026-11-07 cad: puntos de cota válidos por eje (arista perpendicular al eje medido), extremos de silueta solo con dos líneas visibles, cota entre ejes de ojales del cilindro, elevaciones de conjunto con total h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
2026-11-07 cad: en planta los agujeros se acotan por su eje (no por puntos de su circunferencia); elevación de la mesa con total horizontal
    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
2026-11-07 cad: CON-008 elevación con Ø2.000 entre siluetas reales; opción de acotado por eje
    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
2026-11-07 cad: llamadas de agujeros excéntricos eligen un agujero de la mitad superior (no cruzan la vista hacia el título)
    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
2026-11-07 cad: punto de cota válido solo si las líneas visibles del dibujo lo hacen esquina o extremo (excluye vértices ocultos tras el corte); MES-001 planta reacotada; BAS-001 rótulo de la zona de apoyo
    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
2026-11-07 cad: textos movibles no pueden entrar en la banda de notas; corte de la oreja con Ø70 H9 abreviado (tolerancia en la planta)
    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
2026-11-07 Entregables Rev. C cuarta pasada: 8 casos regenerados; cotas solo entre aristas reales, control de cadenas (0 defectuosas), rótulos sin nombres de parámetros, MES-002/BAS-001 reacotados
    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
    [TT300-C.step, TT300-C_despiece.xlsx, TT300C-ACC-001-C.dxf, TT300C-ACC-002-C.dxf, TT300C-ACC-003-C.dxf, TT300C-ACC-004-C.dxf, TT300C-ACC-005-C.dxf, TT300C-BAS-001-C.dxf]
2026-11-07 cad: sin nombres internos de parámetros en notas, fichas, tablas y llamadas (valores con unidad y descripción); control de tokens de P en el generador
    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
2026-11-07 cad: título del detalle de la pletina sin nombre de parámetro
    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
2026-11-07 cad: CON-001 sin «m.total» en los datos generales
    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
2026-11-07 cad: barras de tope y fijación pegada sin nombres de parámetros en ficha y lista de corte
    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
2026-11-07 cad: llamada del radio interior del sector hacia adentro de la vista
    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
2026-11-07 Entregables Rev. C quinta pasada: 8 casos regenerados sin nombres internos de parámetros (0 tokens), control en el generador
    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
    [TT300-C.step, TT300-C_despiece.csv, TT300-C_despiece.xlsx, TT300C-ACC-001-C.dxf, TT300C-ACC-002-C.dxf, TT300C-ACC-003-C.dxf, TT300C-ACC-004-C.dxf, TT300C-ACC-005-C.dxf]
2026-11-07 Memoria Rev. C regenerada con el juego final de planos y la uña a Fy = 800 MPa
    - 9.8: advertencia de la uña (FU 0,907) registrada como aceptada por el mandante el 07-11-2026.
    - Control del capítulo 10.12: la fila de la uña cuenta como tercera advertencia informativa fuera de alcance.
    - Capítulo 14 con el juego de planos de la quinta pasada.
    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
